AdriaanSadie/MVT_ADC_TECH/report/xm105.jpg

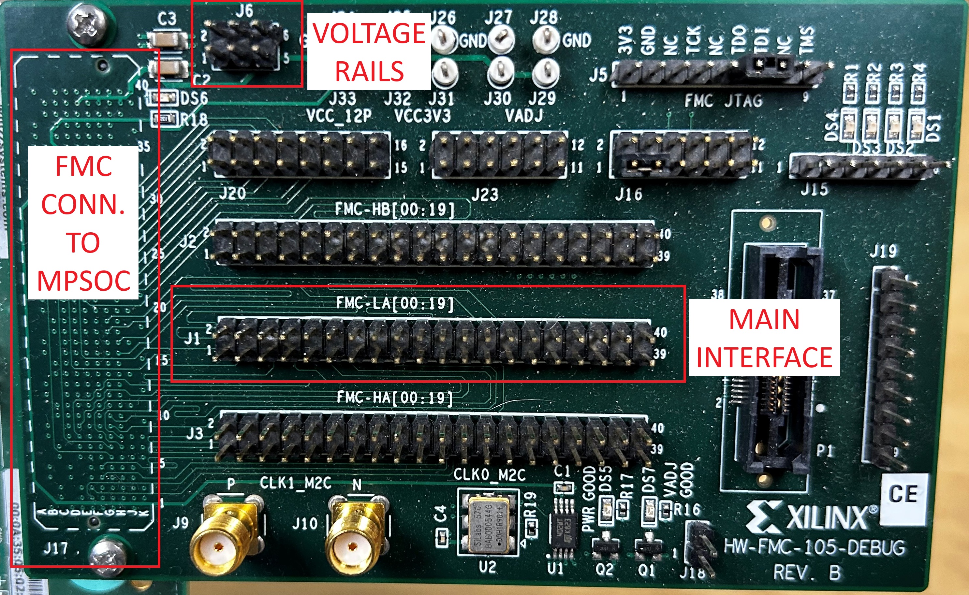
report/xm105.jpg
