AdriaanSadie/MVT_ADC_TECH/report/setup.jpg

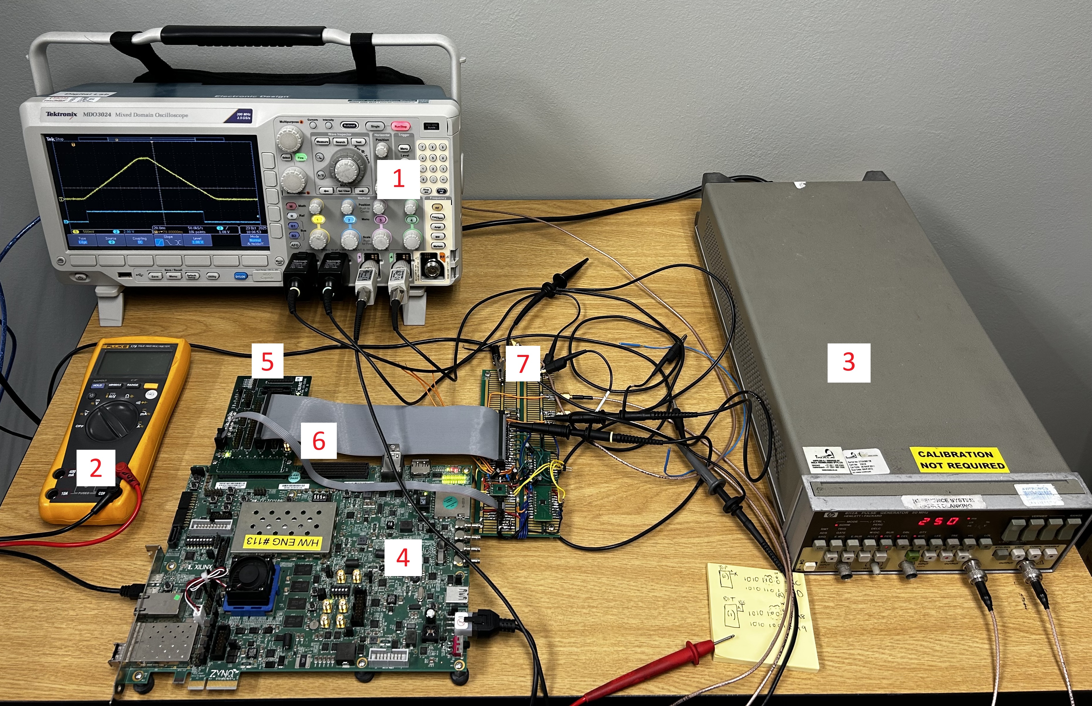
report/setup.jpg
