AdriaanSadie/MVT_ADC_TECH/README.md

# MVT_ADC_TECH
Multi-voltage thresholding ADC technology project 

> The project resides in **adc_tech** with its constraints defined in **constraints** folder.

> The project runs in Vivado 2020.2.
