AdriaanSadie/MVT_ADC_TECH/adc_tech/adc_tech.runs/impl_1/.init_design.begin.rst

<?xml version="1.0"?>
<ProcessHandle Version="1" Minor="0">
    <Process Command=".planAhead." Owner="u056903" Host="ZA-WASADIE1" Pid="96068">
    </Process>
</ProcessHandle>
