AdriaanSadie/MVT_ADC_TECH/adc_tech/adc_tech.runs/adc_tech_blk_mem_gen_0_2_synth_1/.vivado.begin.rst

<?xml version="1.0"?>
<ProcessHandle Version="1" Minor="0">
    <Process Command="vivado.bat" Owner="u056903" Host="ZA-WASADIE1" Pid="141132" HostCore="20" HostMemory="033775415296">
    </Process>
</ProcessHandle>
