AdriaanSadie/MVT_ADC_TECH/admin/Multi-voltage Thresholding on FPGA (ADC) Technology Project Update - 19 March 2025.pptx

- Sadie, Adriaan

- 2025 – MVT Signal Acquisition with FPGA

## Technology Project - 2025 Multi-voltage thresholding (mVT) Signal acquisition with FPGA

  1. Tasks completed
  2. Tasks left
  3. Budget
  4. Timeline
4. Motivation


## Technology Project: MVT with FPGA Tasks completed

Initial tasks complete Part of task 2.3 also completed

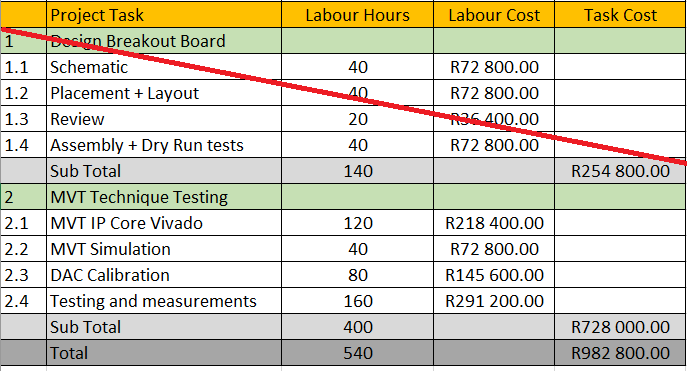
[picture p37: figure]

## Technology Project: MVT with FPGA Tasks completed

Tasks completed for phase 2: Hours used for phase 2: 69 Hours in initial budget for phase 2: 400 (~R728000) Hours initially approved for phase 2: ~194 (R350000) Total usage for phase 2 of initial budget: ~36%

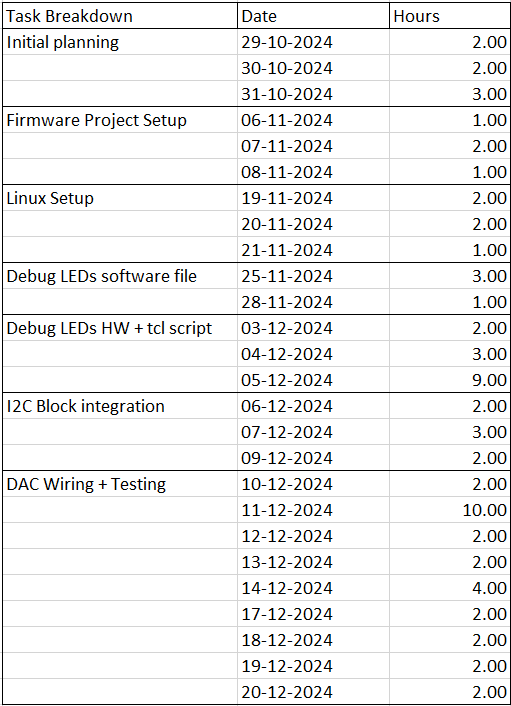
[picture p38: figure]

## Technology Project: MVT with FPGA Tasks left

| DACs need to be calibrated according to the LVDS inputs to the FPGA (will take longest time). MVT IP core needs to be connected to rest of firmware. Sample signals must be measured with MVT technique and confirmed to be correct.

## Technology Project: MVT with FPGA Budget

- Remaining hours from initial budget for phase 2:
- 400 – 69 = 331 hours for remaining tasks
- ~R629000 @ R1900/hour

## Technology Project: MVT with FPGA Timeline / Schedule

Timeline

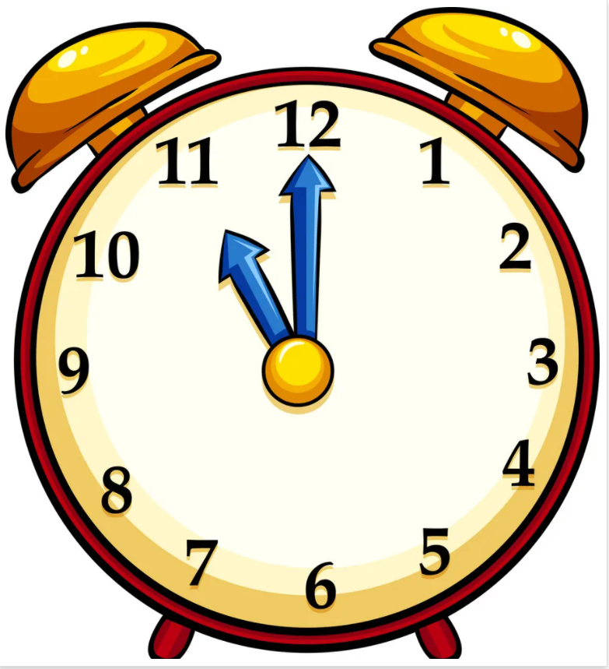
[picture p39: figure]

- Technology projects consistently hold a lower priority compared to customer assignments.
- Consequently, our intention is to utilize this as an interim task between ongoing work, with the goal of completion by 2025.
- ~50% time allocation for 2024/2025
- Resources only from HE Group

## Technology Plan: MVT with FPGA motivation

Pros:
1. Cheaper alternative for ADCs
2. Simpler interface
3. Avoid obsolescence issues with highly specialised ADCs
4. Can be implemented on cheaper MPSoC FPGA devices
  - Compared to expensive RFSoC with internal ADCs
5. Only external component is slow, cheap, and common DAC
6. Once-off calibration
7. Can be used for next iteration of MAW-400, if proven
Cons:
1. Each bit requires a differential input, therefore, 12-bit ADC uses 12 differential pairs.

## Technology Plan: MVT with FPGA References

1. Eliseev, D., et al. "An open-sorce IP-Core for Multi-Voltage Thresholding signal acquisition with FPGAs." Journal of Instrumentation 19.02 (2024): C02035.

## Slide 10


http://www.saabgroup.com
Thank You
