AdriaanSadie/MVT_ADC_TECH/report/input_signal.png

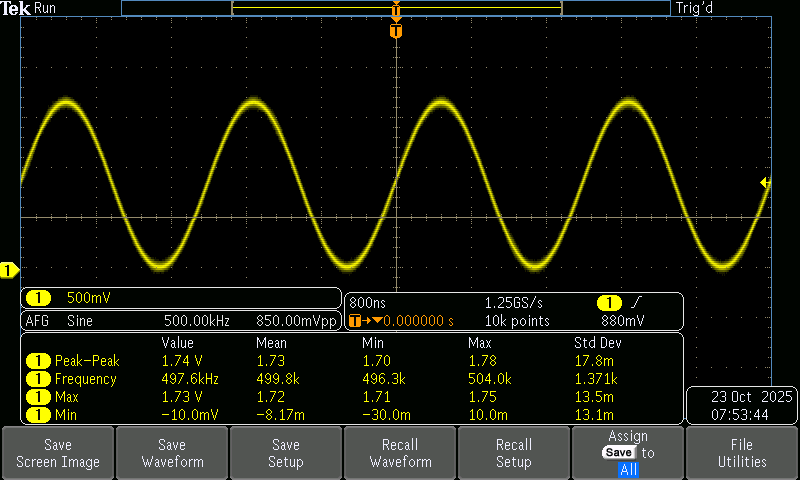
report/input_signal.png
