AdriaanSadie/MVT_ADC_TECH/ScopeScreenshots/threshold_0V5.bmp

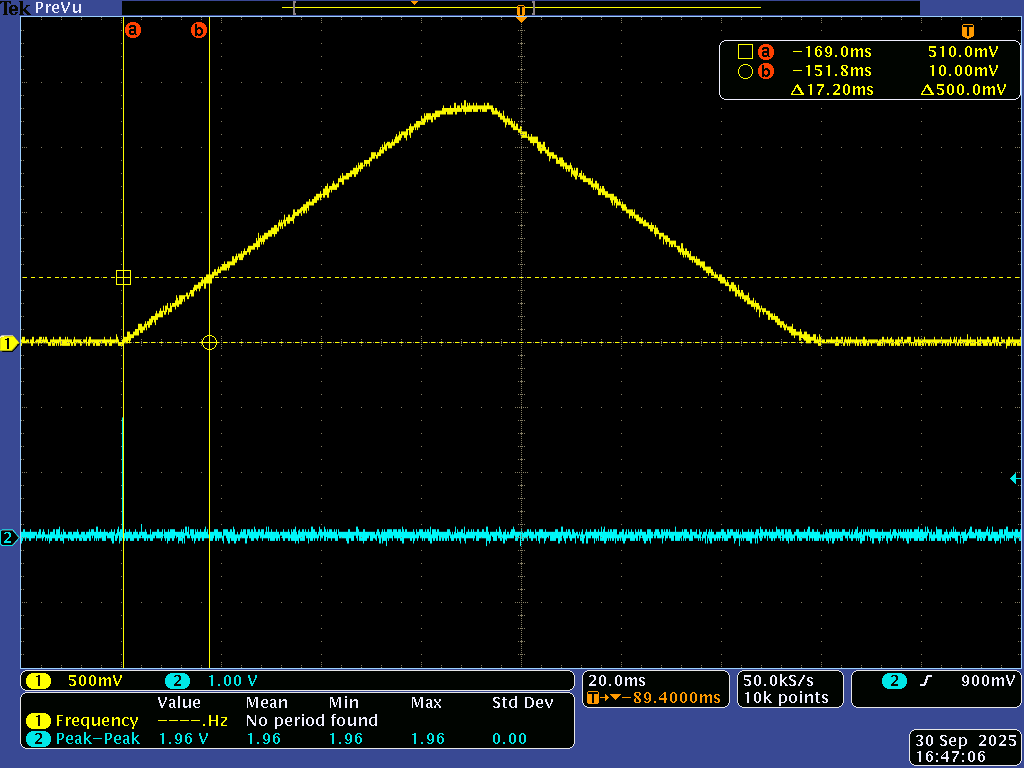
ScopeScreenshots/threshold_0V5.bmp
