AdriaanSadie/MVT_ADC_TECH/measurements/Pin_planning.xlsx

ZCU106 Development Kit |  |  | XM105 Expander Card
XCZU7EVF MPSOC | Net | FMC HPC J5 | FMC HPC J17 | Net | 40-pin header J1 | Firmware Function
F17 | FMC_HPC0_LA00_CC_P | G6 | G6 | FMC_LA00_CC_P | 1 | debug0
F16 | FMC_HPC0_LA00_CC_N | G7 | G7 | FMC_LA00_CC_N | 3 | debug1
H18 | FMC_HPC0_LA01_CC_P | D8 | D8 | FMC_LA01_CC_P | 5 | debug2
H17 | FMC_HPC0_LA01_CC_N | D9 | D9 | FMC_LA01_CC_N | 7 | counting_flag
L20 | FMC_HPC0_LA02_P | H7 | H7 | FMC_LA02_P | 9 | in_2p
K20 | FMC_HPC0_LA02_N | H8 | H8 | FMC_LA02_N | 11 | in_2n
K19 | FMC_HPC0_LA03_P | G9 | G9 | FMC_LA03_P | 13 | in_3p
K18 | FMC_HPC0_LA03_N | G10 | G10 | FMC_LA03_N | 15 | in_3n
L17 | FMC_HPC0_LA04_P | H10 | H10 | FMC_LA04_P | 17 | in_4p
L16 | FMC_HPC0_LA04_N | H11 | H11 | FMC_LA04_N | 19 | in_4n
K17 | FMC_HPC0_LA05_P | D11 | D11 | FMC_LA05_P | 21 | in_5p
J17 | FMC_HPC0_LA05_N | D12 | D12 | FMC_LA05_N | 23 | in_5n
H19 | FMC_HPC0_LA06_P | C10 | C10 | FMC_LA06_P | 25 | in_6p
G19 | FMC_HPC0_LA06_N | C11 | C11 | FMC_LA06_N | 27 | in_6n
J16 | FMC_HPC0_LA07_P | H13 | H13 | FMC_LA07_P | 29 | in_7p
J15 | FMC_HPC0_LA07_N | H14 | H14 | FMC_LA07_N | 31 | in_7n
E18 | FMC_HPC0_LA08_P | G12 | G12 | FMC_LA08_P | 33 | in_8p
E17 | FMC_HPC0_LA08_N | G13 | G13 | FMC_LA08_N | 35 | in_8n
H16 | FMC_HPC0_LA09_P | D14 | D14 | FMC_LA09_P | 37 | in_9p
G16 | FMC_HPC0_LA09_N | D15 | D15 | FMC_LA09_N | 39 | in_9n
L15 | FMC_HPC0_LA10_P | C14 | C14 | FMC_LA10_P | 2 | my_i2c_scl
K15 | FMC_HPC0_LA10_N | C15 | C15 | FMC_LA10_N | 4 | my_i2c_sda
A13 | FMC_HPC0_LA11_P | H16 | H16 | FMC_LA11_P | 6 | pl_led0
A12 | FMC_HPC0_LA11_N | H17 | H17 | FMC_LA11_N | 8 | sync_pin
G18 | FMC_HPC0_LA12_P | G15 | G15 | FMC_LA12_P | 10 | in_0p
F18 | FMC_HPC0_LA12_N | G16 | G16 | FMC_LA12_N | 12 | in_0n
G15 | FMC_HPC0_LA13_P | D17 | D17 | FMC_LA13_P | 14 | in_1p
F15 | FMC_HPC0_LA13_N | D18 | D18 | FMC_LA13_N | 16 | in_1n
C13 | FMC_HPC0_LA14_P | C18 | C18 | FMC_LA14_P | 18 | in_10p
C12 | FMC_HPC0_LA14_N | C19 | C19 | FMC_LA14_N | 20 | in_10n
D16 | FMC_HPC0_LA15_P | H19 | H19 | FMC_LA15_P | 22 | in_11p
C16 | FMC_HPC0_LA15_N | H20 | H20 | FMC_LA15_N | 24 | in_11n
D17 | FMC_HPC0_LA16_P | G18 | G18 | FMC_LA16_P | 26 | in_12p
C17 | FMC_HPC0_LA16_N | G19 | G19 | FMC_LA16_N | 28 | in_12n
F11 | FMC_HPC0_LA17_CC_P | D20 | D20 | FMC_LA17_CC_P | 30 | in_13p
E10 | FMC_HPC0_LA17_CC_N | D21 | D21 | FMC_LA17_CC_N | 32 | in_13n
D11 | FMC_HPC0_LA18_CC_P | C22 | C22 | FMC_LA18_CC_P | 34 | in_14p
D10 | FMC_HPC0_LA18_CC_N | C23 | C23 | FMC_LA18_CC_N | 36 | in_14n
D12 | FMC_HPC0_LA19_P | H22 | H22 | FMC_LA19_P | 38 | in_15p
C11 | FMC_HPC0_LA19_N | H23 | H23 | FMC_LA19_N | 40 | in_15n
C8 | FMC_HPC0_LA33_N | G37 | G37 | FMC_LA33_N | LED0 (DS1)
C9 | FMC_HPC0_LA33_P | G36 | G36 | FMC_LA33_P | LED1 (DS2)
E8 | FMC_HPC0_LA32_N | H38 | H38 | FMC_LA32_N | LED2 (DS3)
F8 | FMC_HPC0_LA32_P | H37 | H37 | FMC_LA32_P | LED3 (DS4)
