AdriaanSadie/MVT_ADC_TECH/adc_tech/adc_tech.sim/sim_1/behav/xsim/xsim.dir/i2c_tb_behav/webtalk/usage_statistics_ext_xsim.html

### XSIM Usage Report

software_version_and_target_device
beta | FALSE | build_version | 3064766
date_generated | Thu Oct 16 10:58:32 2025 | os_platform | WIN64
product_version | XSIM v2020.2 (64-bit) | project_id | a579572a191344d6b971e0746032eb8e
project_iteration | 36 | random_id | 788184fe-d1b3-4df4-bc78-6dcba078ee8f
registration_id | 788184fe-d1b3-4df4-bc78-6dcba078ee8f | route_design | FALSE
target_device | not_applicable | target_family | not_applicable
target_package | not_applicable | target_speed | not_applicable
tool_flow | xsim_vivado

user_environment
cpu_name | Intel(R) Core(TM) Ultra 7 265 | cpu_speed | 2381 MHz
os_name | Windows Server 2016 or Windows 10 | os_release | major release (build 9200)
system_ram | 33.000 GB | total_processors | 1

vivado_usage

xsim

command_line_options
command=xelab | debug=typical | dpi_used=false | file_counter=7
gendll=false | hwcosim=false | sdfmodeling=false | vhdl2008=false

usage
compiler_memory=67496_KB | compiler_time=0.48_sec | simulation_image_code=80 KB | simulation_image_data=4 KB
total_instances=6 | total_nets=0 | total_processes=21 | xilinx_hdl_libraries_used=secureip unimacro_ver unisims_ver
