AdriaanSadie/MVT_ADC_TECH/measurements/dac_calibration_measurements.xlsx

Sheet: RAW Data- RE
Bit 0 |  |  |  |  |  |  |  |  |  |  |  |  |  |  |  |  | Bit 1 |  |  | Bit 2 |  |  | Bit 3
0.1V | 0.2V | 0.3V | 0.4V | 0.5V | 0.6V | 0.7V | 0.8V | 0.9V | 1V | 1.1V | 1.2V | 1.3V | 1.4V | 1.5V | 1.6V | 1.7V | 0.5V | 1V | 1.5V | 0.5V | 1V | 1.5V | 0.5V | 1V | 1.5V
000732ce | 001259c7 | 001ce612 | 0027ed9f | 0033b138 | 003c7166 | 0049b66a | 00551528 | 005faf82 | 006915b1 | 00752688 | 008034e3 | 008a77e2 | 00931162 | 009e3a1d | 00a8d7f2 | 00b5574d
00092fc0 | 0013507e | 001e0f27 | 0028ce3b | 0033881a | 003ef4cd | 00492f97 | 005224b5 | 005d94e6 | 006a6598 | 00749be0 | 007e3b17 | 008970d4 | 0095030e | 009ff5fe | 00aa31c8 | 00b2d4d6
000866c4 | 0011f848 | 001dd510 | 0028b247 | 0032eb4f | 003d6c83 | 00487453 | 0052fd5e | 005e199a | 006907a9 | 00726061 | 007e6cd9 | 0088cae3 | 0093225e | 009df159 | 00a87a43 | 00b5d2bf
0006e10c | 00131437 | 001c6f4c | 0027fa4c | 0033ca4a | 003d7277 | 00496a4a | 0054c872 | 005e9d15 | 006a84bd | 00759021 | 007f75e8 | 0089ca5c | 0094a8b6 | 009dea0d | 00aa95f7 | 00b3fc68
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
