AdriaanSadie/MVT_ADC_TECH/measurements/dac_calibration_official.xlsx

Sheet: RAW DATA-RE
LVDS Port |  |  | LVDS Port |  |  | LVDS Port |  |  | LVDS Port | LVDS Port | LVDS Port
Bit 0 |  |  | Bit 5 |  |  | Bit 10 |  |  | Bit 0 Compensated | Bit 5 Compensated | Bit 10 Compensated
0.4V | 0.9V | 1.4V | 0.4V | 0.9V | 1.4V | 0.4V | 0.9V | 1.4V | 0.9V | 0.9V | 0.9V
002979bc | 005fd6c0 | 00957f3a | 002c4a97 | 006108a6 | 0096828c | 002c5391 | 0060977f | 0095c09b | 0062fe84 | 0062f67a | 0062d905
00296750 | 005fc3d1 | 0095444a | 002c3d9d | 0060cbfa | 00968772 | 002c622e | 0060c17a | 0095aeed | 0062de70 | 0063107d | 0062f53c
002984e2 | 005fca4d | 00955be3 | 002c4c3f | 0060efcd | 00967010 | 002c766d | 00608d95 | 00958be7 | 0062e3e8 | 0062fa47 | 0062c19a
0029820d | 005fec93 | 009544e1 | 002c435f | 0060ff05 | 00968b10 | 002c867a | 0060b05e | 0095bcc4 | 0062eaaf | 0063088b | 0062d5e6
00298782 | 005fd043 | 00957561 | 002c5963 | 006106da | 0096560a | 002c6406 | 0060af28 | 0095be96 | 00630e24 | 0062cfcf | 0062e625
00298f20 | 005fd36e | 00956869 | 002c5582 | 0060f673 | 00966e61 | 002c7002 | 006083e7 | 0095bd1e | 0062d66b | 0062f1ec | 0062d321
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
