AdriaanSadie/MVT_ADC_TECH/measurements/ADC Measurements/tek0002.csv

Model | MDO3024
Firmware Version | 1.20
Waveform Type | ANALOG
Point Format | Y
Horizontal Units | s
Horizontal Scale | 2e-07
Horizontal Delay | 0.0527
Sample Interval | 4e-10
Record Length | 10000
Gating | 0.0% to 100.0%
Probe Attenuation | 10
Vertical Units | V
Vertical Offset | 0
Vertical Scale | 0.5
Vertical Position | -1.04
Label
TIME | CH1
5.269800e-02 | 0.62
5.269800e-02 | 0.6
5.269800e-02 | 0.62
5.269800e-02 | 0.62
5.269800e-02 | 0.6
5.269800e-02 | 0.62
5.269800e-02 | 0.6
5.269800e-02 | 0.6
5.269800e-02 | 0.62
5.269800e-02 | 0.58
5.269800e-02 | 0.58
5.269800e-02 | 0.58
5.269800e-02 | 0.58
5.269801e-02 | 0.58
5.269801e-02 | 0.56
5.269801e-02 | 0.56
5.269801e-02 | 0.56
5.269801e-02 | 0.56
5.269801e-02 | 0.54
5.269801e-02 | 0.56
5.269801e-02 | 0.56
5.269801e-02 | 0.56
5.269801e-02 | 0.58
5.269801e-02 | 0.58
5.269801e-02 | 0.56
5.269801e-02 | 0.56
5.269801e-02 | 0.56
5.269801e-02 | 0.56
5.269801e-02 | 0.54
5.269801e-02 | 0.56
5.269801e-02 | 0.54
5.269801e-02 | 0.56
5.269801e-02 | 0.56
5.269801e-02 | 0.52
5.269801e-02 | 0.52
5.269801e-02 | 0.54
5.269801e-02 | 0.5
5.269801e-02 | 0.52
5.269802e-02 | 0.52
5.269802e-02 | 0.52
5.269802e-02 | 0.5
5.269802e-02 | 0.52
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
