AdriaanSadie/MVT_ADC_TECH/measurements/ADC Measurements/tek0001.csv

Model | MDO3024
Firmware Version | 1.20
Waveform Type | ANALOG
Point Format | Y
Horizontal Units | s
Horizontal Scale | 8e-07
Horizontal Delay | 0
Sample Interval | 8e-10
Record Length | 10000
Gating | 0.0% to 100.0%
Probe Attenuation | 10
Vertical Units | V
Vertical Offset | 0
Vertical Scale | 0.5
Vertical Position | -1.06
Label
TIME | CH1
-4.000000e-06 | 0.95
-3.999200e-06 | 0.91
-3.998400e-06 | 0.95
-3.997600e-06 | 0.95
-3.996800e-06 | 0.93
-3.996000e-06 | 0.95
-3.995200e-06 | 0.95
-3.994400e-06 | 0.97
-3.993600e-06 | 0.95
-3.992800e-06 | 0.95
-3.992000e-06 | 0.97
-3.991200e-06 | 0.97
-3.990400e-06 | 0.99
-3.989600e-06 | 0.99
-3.988800e-06 | 0.95
-3.988000e-06 | 0.97
-3.987200e-06 | 0.99
-3.986400e-06 | 0.97
-3.985600e-06 | 0.95
-3.984800e-06 | 0.95
-3.984000e-06 | 0.99
-3.983200e-06 | 0.97
-3.982400e-06 | 0.97
-3.981600e-06 | 0.97
-3.980800e-06 | 0.99
-3.980000e-06 | 1.01
-3.979200e-06 | 0.99
-3.978400e-06 | 0.99
-3.977600e-06 | 0.99
-3.976800e-06 | 0.99
-3.976000e-06 | 0.99
-3.975200e-06 | 0.99
-3.974400e-06 | 1.01
-3.973600e-06 | 1.03
-3.972800e-06 | 1.01
-3.972000e-06 | 1.01
-3.971200e-06 | 1.01
-3.970400e-06 | 1.03
-3.969600e-06 | 1.01
-3.968800e-06 | 1.01
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
