AdriaanSadie/MVT_ADC_TECH/measurements/ADC Measurements/waveform0.png

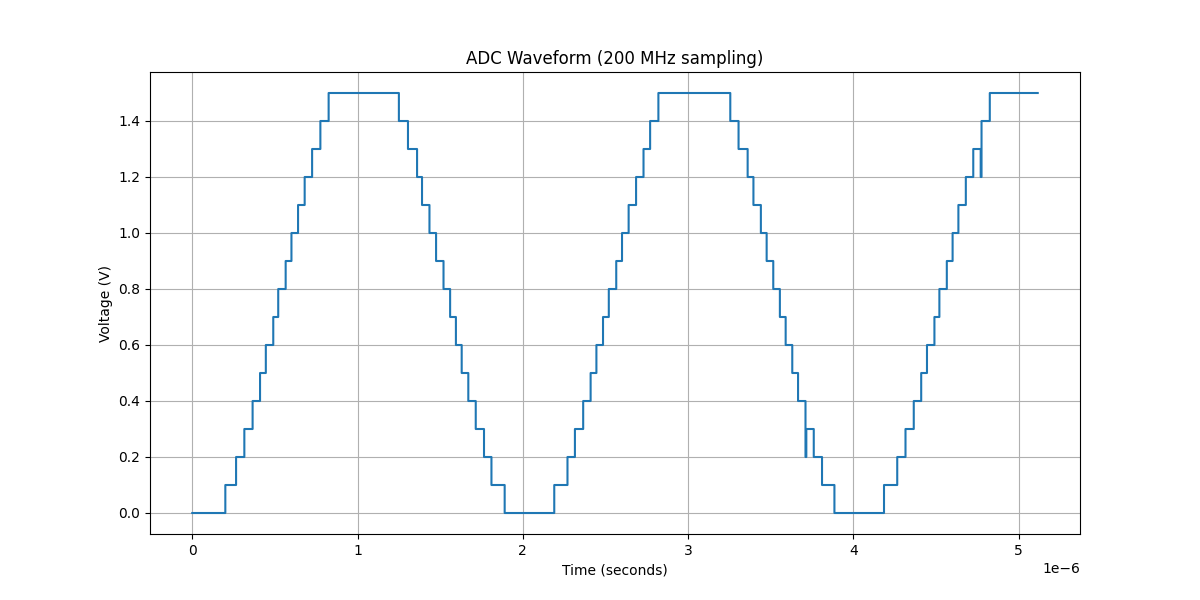
measurements/ADC Measurements/waveform0.png
