AdriaanSadie/MVT_ADC_TECH/measurements/ADC Measurements/waveform1.png

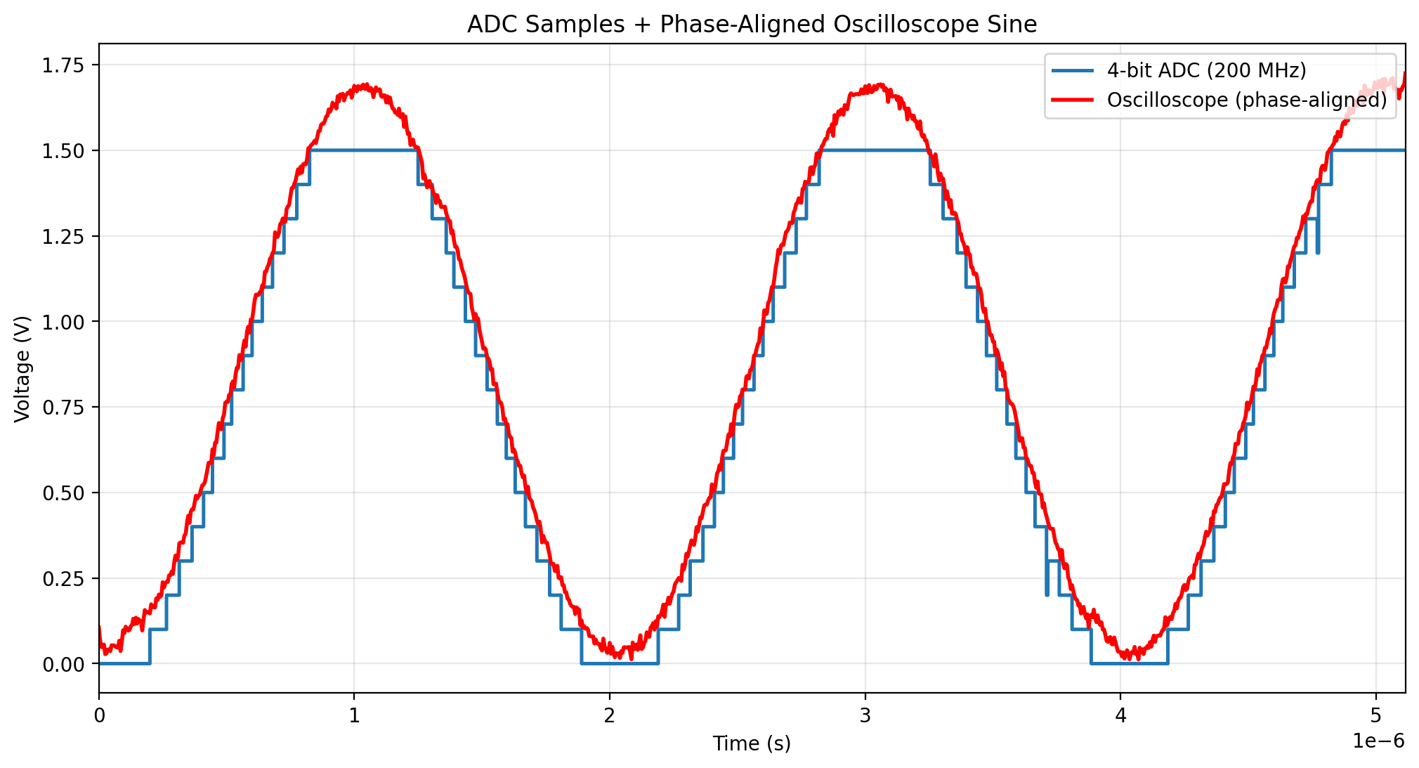
measurements/ADC Measurements/waveform1.png
