AdriaanSadie/MVT_ADC_TECH/measurements/ADC Measurements/waveform_adc.png

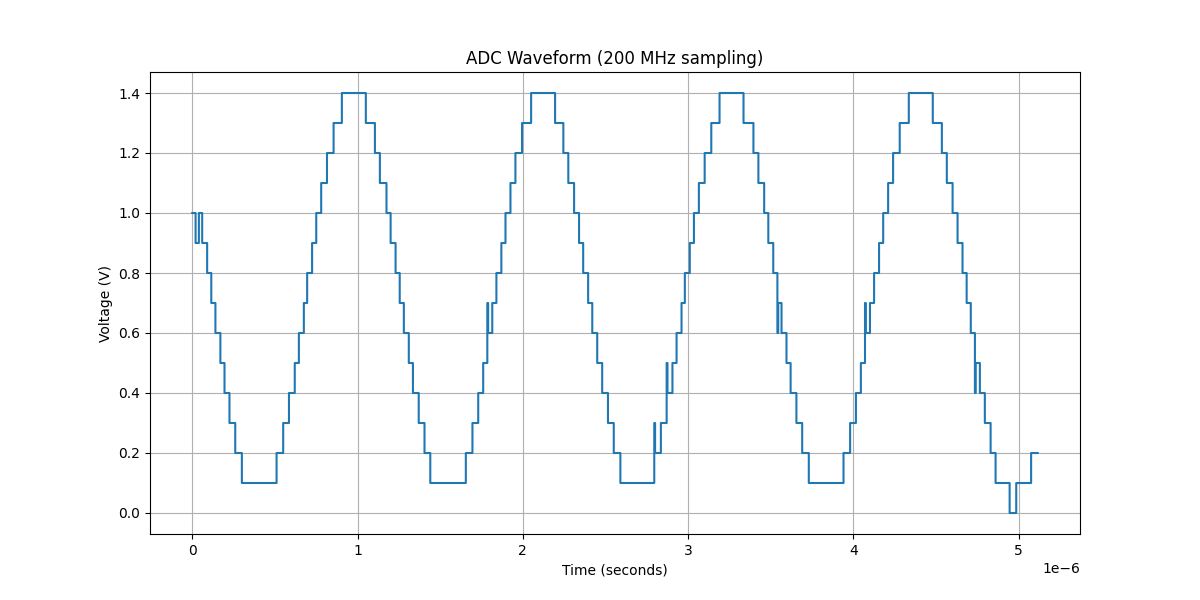
measurements/ADC Measurements/waveform_adc.png
