AdriaanSadie/MVT_ADC_TECH/ScopeScreenshots/python_script_test/Figure_1.png

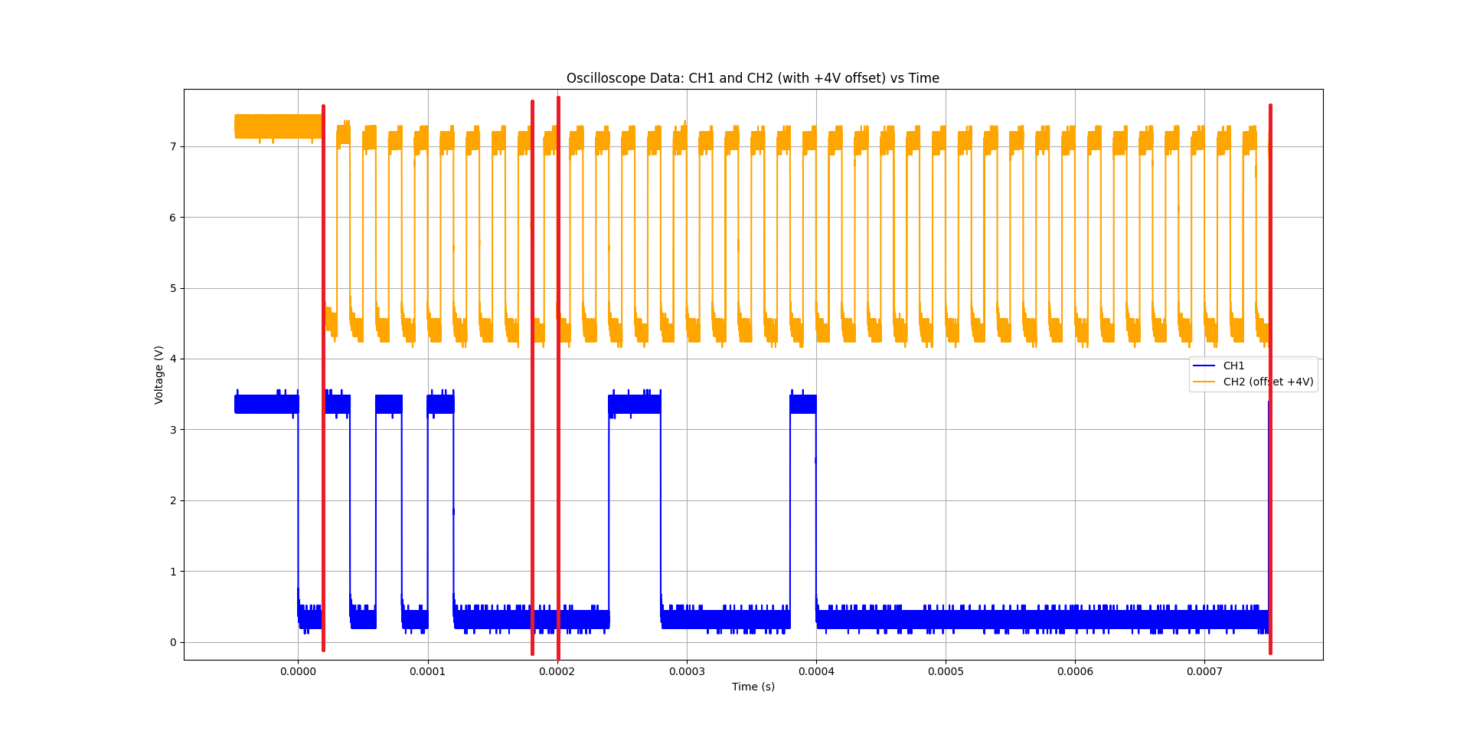
ScopeScreenshots/python_script_test/Figure_1.png
