AdriaanSadie/MVT_ADC_TECH/adc_tech/adc_tech.runs/synth_1/.Xil/adc_tech_wrapper_propImpl.xdc

set_property SRC_FILE_INFO {cfile:C:/work/Technology/Vivado/MVT_ADC_TECH/constraints/io_pins.xdc rfile:../../../../constraints/io_pins.xdc id:1} [current_design]
set_property src_info {type:XDC file:1 line:14 export:INPUT save:INPUT read:READ} [current_design]
set_property IOSTANDARD LVCMOS18 [get_ports pl_led1]
set_property src_info {type:XDC file:1 line:15 export:INPUT save:INPUT read:READ} [current_design]
set_property IOSTANDARD LVCMOS18 [get_ports pl_led2]
set_property src_info {type:XDC file:1 line:16 export:INPUT save:INPUT read:READ} [current_design]
set_property IOSTANDARD LVCMOS18 [get_ports pl_led3]
set_property src_info {type:XDC file:1 line:18 export:INPUT save:INPUT read:READ} [current_design]
set_property PACKAGE_PIN A13 [get_ports {pl_led0[0]}]
set_property src_info {type:XDC file:1 line:20 export:INPUT save:INPUT read:READ} [current_design]
set_property PACKAGE_PIN H9 [get_ports pl_clk_p]
set_property src_info {type:XDC file:1 line:24 export:INPUT save:INPUT read:READ} [current_design]
set_property PACKAGE_PIN A13 [get_ports i2c_scl]
set_property src_info {type:XDC file:1 line:25 export:INPUT save:INPUT read:READ} [current_design]
set_property PACKAGE_PIN A12 [get_ports i2c_sda]
set_property src_info {type:XDC file:1 line:26 export:INPUT save:INPUT read:READ} [current_design]
set_property IOSTANDARD LVCMOS18 [get_ports i2c_scl]
set_property src_info {type:XDC file:1 line:27 export:INPUT save:INPUT read:READ} [current_design]
set_property IOSTANDARD LVCMOS18 [get_ports i2c_sda]
set_property src_info {type:XDC file:1 line:37 export:INPUT save:INPUT read:READ} [current_design]
set_property PACKAGE_PIN K18 [get_ports pulse_in]
set_property src_info {type:XDC file:1 line:38 export:INPUT save:INPUT read:READ} [current_design]
set_property IOSTANDARD LVCMOS18 [get_ports pulse_in]
set_property src_info {type:XDC file:1 line:41 export:INPUT save:INPUT read:READ} [current_design]
set_property PACKAGE_PIN K19 [get_ports pulse_in_p]
set_property src_info {type:XDC file:1 line:42 export:INPUT save:INPUT read:READ} [current_design]
set_property IOSTANDARD LVDS [get_ports pulse_in_p]
set_property src_info {type:XDC file:1 line:43 export:INPUT save:INPUT read:READ} [current_design]
set_property IOSTANDARD LVDS [get_ports pulse_in_n]
set_property src_info {type:XDC file:1 line:44 export:INPUT save:INPUT read:READ} [current_design]
set_property DIFF_TERM_ADV TERM_NONE [get_ports pulse_in_p]
set_property src_info {type:XDC file:1 line:45 export:INPUT save:INPUT read:READ} [current_design]
set_property DIFF_TERM_ADV TERM_NONE [get_ports pulse_in_n]
set_property src_info {type:XDC file:1 line:46 export:INPUT save:INPUT read:READ} [current_design]
set_property PACKAGE_PIN A12 [get_ports sync_in]
set_property src_info {type:XDC file:1 line:52 export:INPUT save:INPUT read:READ} [current_design]
connect_debug_port u_ila_0/probe0 [get_nets [list {adc_tech_i/axi_bram_ctrl_0_BRAM_PORTA_DOUT[0]} {adc_tech_i/axi_bram_ctrl_0_BRAM_PORTA_DOUT[1]} {adc_tech_i/axi_bram_ctrl_0_BRAM_PORTA_DOUT[2]} {adc_tech_i/axi_bram_ctrl_0_BRAM_PORTA_DOUT[3]} {adc_tech_i/axi_bram_ctrl_0_BRAM_PORTA_DOUT[4]} {adc_tech_i/axi_bram_ctrl_0_BRAM_PORTA_DOUT[5]} {adc_tech_i/axi_bram_ctrl_0_BRAM_PORTA_DOUT[6]} {adc_tech_i/axi_bram_ctrl_0_BRAM_PORTA_DOUT[7]} {adc_tech_i/axi_bram_ctrl_0_BRAM_PORTA_DOUT[8]} {adc_tech_i/axi_bram_ctrl_0_BRAM_PORTA_DOUT[9]} {adc_tech_i/axi_bram_ctrl_0_BRAM_PORTA_DOUT[10]} {adc_tech_i/axi_bram_ctrl_0_BRAM_PORTA_DOUT[11]} {adc_tech_i/axi_bram_ctrl_0_BRAM_PORTA_DOUT[12]} {adc_tech_i/axi_bram_ctrl_0_BRAM_PORTA_DOUT[13]} {adc_tech_i/axi_bram_ctrl_0_BRAM_PORTA_DOUT[14]} {adc_tech_i/axi_bram_ctrl_0_BRAM_PORTA_DOUT[15]} {adc_tech_i/axi_bram_ctrl_0_BRAM_PORTA_DOUT[16]} {adc_tech_i/axi_bram_ctrl_0_BRAM_PORTA_DOUT[17]} {adc_tech_i/axi_bram_ctrl_0_BRAM_PORTA_DOUT[18]} {adc_tech_i/axi_bram_ctrl_0_BRAM_PORTA_DOUT[19]} {adc_tech_i/axi_bram_ctrl_0_BRAM_PORTA_DOUT[20]} {adc_tech_i/axi_bram_ctrl_0_BRAM_PORTA_DOUT[21]} {adc_tech_i/axi_bram_ctrl_0_BRAM_PORTA_DOUT[22]} {adc_tech_i/axi_bram_ctrl_0_BRAM_PORTA_DOUT[23]} {adc_tech_i/axi_bram_ctrl_0_BRAM_PORTA_DOUT[24]} {adc_tech_i/axi_bram_ctrl_0_BRAM_PORTA_DOUT[25]} {adc_tech_i/axi_bram_ctrl_0_BRAM_PORTA_DOUT[26]} {adc_tech_i/axi_bram_ctrl_0_BRAM_PORTA_DOUT[27]} {adc_tech_i/axi_bram_ctrl_0_BRAM_PORTA_DOUT[28]} {adc_tech_i/axi_bram_ctrl_0_BRAM_PORTA_DOUT[29]} {adc_tech_i/axi_bram_ctrl_0_BRAM_PORTA_DOUT[30]} {adc_tech_i/axi_bram_ctrl_0_BRAM_PORTA_DOUT[31]}]]
set_property src_info {type:XDC file:1 line:53 export:INPUT save:INPUT read:READ} [current_design]
connect_debug_port u_ila_0/probe1 [get_nets [list {adc_tech_i/bram_writer_0_addra[0]} {adc_tech_i/bram_writer_0_addra[1]} {adc_tech_i/bram_writer_0_addra[2]} {adc_tech_i/bram_writer_0_addra[3]} {adc_tech_i/bram_writer_0_addra[4]} {adc_tech_i/bram_writer_0_addra[5]} {adc_tech_i/bram_writer_0_addra[6]} {adc_tech_i/bram_writer_0_addra[7]} {adc_tech_i/bram_writer_0_addra[8]} {adc_tech_i/bram_writer_0_addra[9]} {adc_tech_i/bram_writer_0_addra[10]} {adc_tech_i/bram_writer_0_addra[11]} {adc_tech_i/bram_writer_0_addra[12]}]]
set_property src_info {type:XDC file:1 line:54 export:INPUT save:INPUT read:READ} [current_design]
connect_debug_port u_ila_0/probe2 [get_nets [list {adc_tech_i/axi_bram_ctrl_0_BRAM_PORTA_ADDR[0]} {adc_tech_i/axi_bram_ctrl_0_BRAM_PORTA_ADDR[1]} {adc_tech_i/axi_bram_ctrl_0_BRAM_PORTA_ADDR[2]} {adc_tech_i/axi_bram_ctrl_0_BRAM_PORTA_ADDR[3]} {adc_tech_i/axi_bram_ctrl_0_BRAM_PORTA_ADDR[4]} {adc_tech_i/axi_bram_ctrl_0_BRAM_PORTA_ADDR[5]} {adc_tech_i/axi_bram_ctrl_0_BRAM_PORTA_ADDR[6]} {adc_tech_i/axi_bram_ctrl_0_BRAM_PORTA_ADDR[7]} {adc_tech_i/axi_bram_ctrl_0_BRAM_PORTA_ADDR[8]} {adc_tech_i/axi_bram_ctrl_0_BRAM_PORTA_ADDR[9]} {adc_tech_i/axi_bram_ctrl_0_BRAM_PORTA_ADDR[10]} {adc_tech_i/axi_bram_ctrl_0_BRAM_PORTA_ADDR[11]} {adc_tech_i/axi_bram_ctrl_0_BRAM_PORTA_ADDR[12]}]]
set_property src_info {type:XDC file:1 line:55 export:INPUT save:INPUT read:READ} [current_design]
connect_debug_port u_ila_0/probe3 [get_nets [list {adc_tech_i/bram_writer_0_dia[0]} {adc_tech_i/bram_writer_0_dia[1]} {adc_tech_i/bram_writer_0_dia[2]} {adc_tech_i/bram_writer_0_dia[3]} {adc_tech_i/bram_writer_0_dia[4]} {adc_tech_i/bram_writer_0_dia[5]} {adc_tech_i/bram_writer_0_dia[6]} {adc_tech_i/bram_writer_0_dia[7]} {adc_tech_i/bram_writer_0_dia[8]} {adc_tech_i/bram_writer_0_dia[9]} {adc_tech_i/bram_writer_0_dia[10]} {adc_tech_i/bram_writer_0_dia[11]} {adc_tech_i/bram_writer_0_dia[12]} {adc_tech_i/bram_writer_0_dia[13]} {adc_tech_i/bram_writer_0_dia[14]} {adc_tech_i/bram_writer_0_dia[15]} {adc_tech_i/bram_writer_0_dia[16]} {adc_tech_i/bram_writer_0_dia[17]} {adc_tech_i/bram_writer_0_dia[18]} {adc_tech_i/bram_writer_0_dia[19]} {adc_tech_i/bram_writer_0_dia[20]} {adc_tech_i/bram_writer_0_dia[21]} {adc_tech_i/bram_writer_0_dia[22]} {adc_tech_i/bram_writer_0_dia[23]} {adc_tech_i/bram_writer_0_dia[24]} {adc_tech_i/bram_writer_0_dia[25]} {adc_tech_i/bram_writer_0_dia[26]} {adc_tech_i/bram_writer_0_dia[27]} {adc_tech_i/bram_writer_0_dia[28]} {adc_tech_i/bram_writer_0_dia[29]} {adc_tech_i/bram_writer_0_dia[30]} {adc_tech_i/bram_writer_0_dia[31]}]]
set_property src_info {type:XDC file:1 line:56 export:INPUT save:INPUT read:READ} [current_design]
connect_debug_port u_ila_0/probe4 [get_nets [list adc_tech_i/axi_bram_ctrl_0_BRAM_PORTA_CLK]]
set_property src_info {type:XDC file:1 line:57 export:INPUT save:INPUT read:READ} [current_design]
connect_debug_port u_ila_0/probe5 [get_nets [list adc_tech_i/bram_writer_0_wea]]
set_property src_info {type:XDC file:1 line:58 export:INPUT save:INPUT read:READ} [current_design]
connect_debug_port u_ila_0/probe6 [get_nets [list adc_tech_i/xlslice_4_Dout]]
set_property src_info {type:XDC file:1 line:64 export:INPUT save:INPUT read:READ} [current_design]
set_property PACKAGE_PIN L20 [get_ports pulse_in_p2]
set_property src_info {type:XDC file:1 line:67 export:INPUT save:INPUT read:READ} [current_design]
set_property PACKAGE_PIN K19 [get_ports pulse_in_p3]
set_property src_info {type:XDC file:1 line:72 export:INPUT save:INPUT read:READ} [current_design]
set_property PACKAGE_PIN L15 [get_ports my_i2c_scl]
set_property src_info {type:XDC file:1 line:73 export:INPUT save:INPUT read:READ} [current_design]
set_property PACKAGE_PIN K15 [get_ports my_i2c_sda]
set_property src_info {type:XDC file:1 line:74 export:INPUT save:INPUT read:READ} [current_design]
set_property PACKAGE_PIN F17 [get_ports {debug0[0]}]
set_property src_info {type:XDC file:1 line:75 export:INPUT save:INPUT read:READ} [current_design]
set_property PACKAGE_PIN F16 [get_ports {debug1[0]}]
set_property src_info {type:XDC file:1 line:76 export:INPUT save:INPUT read:READ} [current_design]
set_property PACKAGE_PIN H18 [get_ports {debug2[0]}]
set_property src_info {type:XDC file:1 line:77 export:INPUT save:INPUT read:READ} [current_design]
set_property PACKAGE_PIN L17 [get_ports pulse_in_p4]
set_property src_info {type:XDC file:1 line:78 export:INPUT save:INPUT read:READ} [current_design]
set_property PACKAGE_PIN K17 [get_ports pulse_in_p5]
set_property src_info {type:XDC file:1 line:79 export:INPUT save:INPUT read:READ} [current_design]
set_property PACKAGE_PIN H19 [get_ports pulse_in_p6]
set_property src_info {type:XDC file:1 line:84 export:INPUT save:INPUT read:READ} [current_design]
set_property PACKAGE_PIN J16 [get_ports pulse_in_p7]
set_property src_info {type:XDC file:1 line:89 export:INPUT save:INPUT read:READ} [current_design]
set_property PACKAGE_PIN E18 [get_ports pulse_in_p8]
set_property src_info {type:XDC file:1 line:92 export:INPUT save:INPUT read:READ} [current_design]
set_property PACKAGE_PIN H16 [get_ports pulse_in_p9]
set_property src_info {type:XDC file:1 line:95 export:INPUT save:INPUT read:READ} [current_design]
set_property PACKAGE_PIN C13 [get_ports pulse_in_p10]
set_property src_info {type:XDC file:1 line:98 export:INPUT save:INPUT read:READ} [current_design]
set_property PACKAGE_PIN D16 [get_ports pulse_in_p11]
set_property src_info {type:XDC file:1 line:101 export:INPUT save:INPUT read:READ} [current_design]
set_property PACKAGE_PIN D17 [get_ports pulse_in_p12]
set_property src_info {type:XDC file:1 line:104 export:INPUT save:INPUT read:READ} [current_design]
set_property PACKAGE_PIN F11 [get_ports pulse_in_p13]
set_property src_info {type:XDC file:1 line:107 export:INPUT save:INPUT read:READ} [current_design]
set_property PACKAGE_PIN D11 [get_ports pulse_in_p14]
set_property src_info {type:XDC file:1 line:110 export:INPUT save:INPUT read:READ} [current_design]
set_property PACKAGE_PIN D12 [get_ports pulse_in_p15]
set_property src_info {type:XDC file:1 line:113 export:INPUT save:INPUT read:READ} [current_design]
set_property PACKAGE_PIN H17 [get_ports counting_flag]
set_property src_info {type:XDC file:1 line:114 export:INPUT save:INPUT read:READ} [current_design]
set_property PACKAGE_PIN G15 [get_ports pulse_in_p1]
set_property src_info {type:XDC file:1 line:115 export:INPUT save:INPUT read:READ} [current_design]
set_property PACKAGE_PIN G18 [get_ports pulse_in_p0]
set_property src_info {type:XDC file:1 line:118 export:INPUT save:INPUT read:READ} [current_design]
connect_debug_port u_ila_0/probe0 [get_nets [list {adc_tech_i/internal_axi_gpio2[0]} {adc_tech_i/internal_axi_gpio2[1]} {adc_tech_i/internal_axi_gpio2[2]} {adc_tech_i/internal_axi_gpio2[3]} {adc_tech_i/internal_axi_gpio2[4]} {adc_tech_i/internal_axi_gpio2[5]} {adc_tech_i/internal_axi_gpio2[6]} {adc_tech_i/internal_axi_gpio2[7]} {adc_tech_i/internal_axi_gpio2[8]} {adc_tech_i/internal_axi_gpio2[9]} {adc_tech_i/internal_axi_gpio2[10]} {adc_tech_i/internal_axi_gpio2[11]} {adc_tech_i/internal_axi_gpio2[12]} {adc_tech_i/internal_axi_gpio2[13]} {adc_tech_i/internal_axi_gpio2[14]} {adc_tech_i/internal_axi_gpio2[15]} {adc_tech_i/internal_axi_gpio2[16]} {adc_tech_i/internal_axi_gpio2[17]} {adc_tech_i/internal_axi_gpio2[18]} {adc_tech_i/internal_axi_gpio2[19]} {adc_tech_i/internal_axi_gpio2[20]} {adc_tech_i/internal_axi_gpio2[21]} {adc_tech_i/internal_axi_gpio2[22]} {adc_tech_i/internal_axi_gpio2[23]} {adc_tech_i/internal_axi_gpio2[24]} {adc_tech_i/internal_axi_gpio2[25]} {adc_tech_i/internal_axi_gpio2[26]} {adc_tech_i/internal_axi_gpio2[27]} {adc_tech_i/internal_axi_gpio2[28]} {adc_tech_i/internal_axi_gpio2[29]} {adc_tech_i/internal_axi_gpio2[30]} {adc_tech_i/internal_axi_gpio2[31]}]]
set_property src_info {type:XDC file:1 line:119 export:INPUT save:INPUT read:READ} [current_design]
connect_debug_port u_ila_0/probe1 [get_nets [list {adc_tech_i/internal_axi_gpio1[0]} {adc_tech_i/internal_axi_gpio1[1]} {adc_tech_i/internal_axi_gpio1[2]} {adc_tech_i/internal_axi_gpio1[3]} {adc_tech_i/internal_axi_gpio1[4]} {adc_tech_i/internal_axi_gpio1[5]} {adc_tech_i/internal_axi_gpio1[6]} {adc_tech_i/internal_axi_gpio1[7]} {adc_tech_i/internal_axi_gpio1[8]} {adc_tech_i/internal_axi_gpio1[9]} {adc_tech_i/internal_axi_gpio1[10]} {adc_tech_i/internal_axi_gpio1[11]} {adc_tech_i/internal_axi_gpio1[12]} {adc_tech_i/internal_axi_gpio1[13]} {adc_tech_i/internal_axi_gpio1[14]} {adc_tech_i/internal_axi_gpio1[15]} {adc_tech_i/internal_axi_gpio1[16]} {adc_tech_i/internal_axi_gpio1[17]} {adc_tech_i/internal_axi_gpio1[18]} {adc_tech_i/internal_axi_gpio1[19]} {adc_tech_i/internal_axi_gpio1[20]} {adc_tech_i/internal_axi_gpio1[21]} {adc_tech_i/internal_axi_gpio1[22]} {adc_tech_i/internal_axi_gpio1[23]} {adc_tech_i/internal_axi_gpio1[24]} {adc_tech_i/internal_axi_gpio1[25]} {adc_tech_i/internal_axi_gpio1[26]} {adc_tech_i/internal_axi_gpio1[27]} {adc_tech_i/internal_axi_gpio1[28]} {adc_tech_i/internal_axi_gpio1[29]} {adc_tech_i/internal_axi_gpio1[30]} {adc_tech_i/internal_axi_gpio1[31]}]]
set_property src_info {type:XDC file:1 line:121 export:INPUT save:INPUT read:READ} [current_design]
set_property C_CLK_INPUT_FREQ_HZ 300000000 [get_debug_cores dbg_hub]
set_property src_info {type:XDC file:1 line:122 export:INPUT save:INPUT read:READ} [current_design]
set_property C_ENABLE_CLK_DIVIDER false [get_debug_cores dbg_hub]
set_property src_info {type:XDC file:1 line:123 export:INPUT save:INPUT read:READ} [current_design]
set_property C_USER_SCAN_CHAIN 1 [get_debug_cores dbg_hub]
set_property src_info {type:XDC file:1 line:124 export:INPUT save:INPUT read:READ} [current_design]
connect_debug_port dbg_hub/clk [get_nets clk]
