AdriaanSadie/MVT_ADC_TECH/adc_tech/adc_tech.cache/ip/2020.2/218f51cbd73a38f3/adc_tech_axi_bram_ctrl_0_2_stub.v

// Copyright 1986-2020 Xilinx, Inc. All Rights Reserved.
// --------------------------------------------------------------------------------
// Tool Version: Vivado v.2020.2 (win64) Build 3064766 Wed Nov 18 09:12:45 MST 2020
// Date        : Mon Oct 27 06:54:17 2025
// Host        : ZA-WASADIE1 running 64-bit major release  (build 9200)
// Command     : write_verilog -force -mode synth_stub -rename_top decalper_eb_ot_sdeen_pot_pi_dehcac_xnilix -prefix
//               decalper_eb_ot_sdeen_pot_pi_dehcac_xnilix_ adc_tech_axi_bram_ctrl_0_2_stub.v
// Design      : adc_tech_axi_bram_ctrl_0_2
// Purpose     : Stub declaration of top-level module interface
// Device      : xczu7ev-ffvc1156-2-e
// --------------------------------------------------------------------------------

// This empty module with port declaration file causes synthesis tools to infer a black box for IP.
// The synthesis directives are for Synopsys Synplify support to prevent IO buffer insertion.
// Please paste the declaration into a Verilog source file or add the file as an additional source.
(* x_core_info = "axi_bram_ctrl,Vivado 2020.2" *)
module decalper_eb_ot_sdeen_pot_pi_dehcac_xnilix(s_axi_aclk, s_axi_aresetn, s_axi_awaddr, 
  s_axi_awlen, s_axi_awsize, s_axi_awburst, s_axi_awlock, s_axi_awcache, s_axi_awprot, 
  s_axi_awvalid, s_axi_awready, s_axi_wdata, s_axi_wstrb, s_axi_wlast, s_axi_wvalid, 
  s_axi_wready, s_axi_bresp, s_axi_bvalid, s_axi_bready, s_axi_araddr, s_axi_arlen, 
  s_axi_arsize, s_axi_arburst, s_axi_arlock, s_axi_arcache, s_axi_arprot, s_axi_arvalid, 
  s_axi_arready, s_axi_rdata, s_axi_rresp, s_axi_rlast, s_axi_rvalid, s_axi_rready, bram_rst_a, 
  bram_clk_a, bram_en_a, bram_we_a, bram_addr_a, bram_wrdata_a, bram_rddata_a)
/* synthesis syn_black_box black_box_pad_pin="s_axi_aclk,s_axi_aresetn,s_axi_awaddr[17:0],s_axi_awlen[7:0],s_axi_awsize[2:0],s_axi_awburst[1:0],s_axi_awlock,s_axi_awcache[3:0],s_axi_awprot[2:0],s_axi_awvalid,s_axi_awready,s_axi_wdata[31:0],s_axi_wstrb[3:0],s_axi_wlast,s_axi_wvalid,s_axi_wready,s_axi_bresp[1:0],s_axi_bvalid,s_axi_bready,s_axi_araddr[17:0],s_axi_arlen[7:0],s_axi_arsize[2:0],s_axi_arburst[1:0],s_axi_arlock,s_axi_arcache[3:0],s_axi_arprot[2:0],s_axi_arvalid,s_axi_arready,s_axi_rdata[31:0],s_axi_rresp[1:0],s_axi_rlast,s_axi_rvalid,s_axi_rready,bram_rst_a,bram_clk_a,bram_en_a,bram_we_a[3:0],bram_addr_a[17:0],bram_wrdata_a[31:0],bram_rddata_a[31:0]" */;
  input s_axi_aclk;
  input s_axi_aresetn;
  input [17:0]s_axi_awaddr;
  input [7:0]s_axi_awlen;
  input [2:0]s_axi_awsize;
  input [1:0]s_axi_awburst;
  input s_axi_awlock;
  input [3:0]s_axi_awcache;
  input [2:0]s_axi_awprot;
  input s_axi_awvalid;
  output s_axi_awready;
  input [31:0]s_axi_wdata;
  input [3:0]s_axi_wstrb;
  input s_axi_wlast;
  input s_axi_wvalid;
  output s_axi_wready;
  output [1:0]s_axi_bresp;
  output s_axi_bvalid;
  input s_axi_bready;
  input [17:0]s_axi_araddr;
  input [7:0]s_axi_arlen;
  input [2:0]s_axi_arsize;
  input [1:0]s_axi_arburst;
  input s_axi_arlock;
  input [3:0]s_axi_arcache;
  input [2:0]s_axi_arprot;
  input s_axi_arvalid;
  output s_axi_arready;
  output [31:0]s_axi_rdata;
  output [1:0]s_axi_rresp;
  output s_axi_rlast;
  output s_axi_rvalid;
  input s_axi_rready;
  output bram_rst_a;
  output bram_clk_a;
  output bram_en_a;
  output [3:0]bram_we_a;
  output [17:0]bram_addr_a;
  output [31:0]bram_wrdata_a;
  input [31:0]bram_rddata_a;
endmodule
