AdriaanSadie/MVT_ADC_TECH/adc_tech/adc_tech.runs/adc_tech_jtag_axi_0_0_synth_1/.Xil/adc_tech_jtag_axi_0_0_propImpl.xdc

set_property SRC_FILE_INFO {cfile:C:/Xilinx/Vivado/2020.2/data/ip/xpm/xpm_cdc/tcl/xpm_cdc_gray.tcl rfile:../../../../../../../../Xilinx/Vivado/2020.2/data/ip/xpm/xpm_cdc/tcl/xpm_cdc_gray.tcl id:1 order:LATE scoped_inst:U0/jtag_axi_engine_u/rx_fifo_i/inst_fifo_gen/gconvfifo.rf/grf.rf/gntv_or_sync_fifo.gcx.clkx/rd_pntr_cdc_inst unmanaged:yes} [current_design]
set_property SRC_FILE_INFO {cfile:C:/Xilinx/Vivado/2020.2/data/ip/xpm/xpm_cdc/tcl/xpm_cdc_gray.tcl rfile:../../../../../../../../Xilinx/Vivado/2020.2/data/ip/xpm/xpm_cdc/tcl/xpm_cdc_gray.tcl id:2 order:LATE scoped_inst:U0/jtag_axi_engine_u/rx_fifo_i/inst_fifo_gen/gconvfifo.rf/grf.rf/gntv_or_sync_fifo.gcx.clkx/wr_pntr_cdc_inst unmanaged:yes} [current_design]
set_property SRC_FILE_INFO {cfile:C:/Xilinx/Vivado/2020.2/data/ip/xpm/xpm_cdc/tcl/xpm_cdc_gray.tcl rfile:../../../../../../../../Xilinx/Vivado/2020.2/data/ip/xpm/xpm_cdc/tcl/xpm_cdc_gray.tcl id:3 order:LATE scoped_inst:U0/jtag_axi_engine_u/tx_fifo_i/inst_fifo_gen/gconvfifo.rf/grf.rf/gntv_or_sync_fifo.gcx.clkx/rd_pntr_cdc_inst unmanaged:yes} [current_design]
set_property SRC_FILE_INFO {cfile:C:/Xilinx/Vivado/2020.2/data/ip/xpm/xpm_cdc/tcl/xpm_cdc_gray.tcl rfile:../../../../../../../../Xilinx/Vivado/2020.2/data/ip/xpm/xpm_cdc/tcl/xpm_cdc_gray.tcl id:4 order:LATE scoped_inst:U0/jtag_axi_engine_u/tx_fifo_i/inst_fifo_gen/gconvfifo.rf/grf.rf/gntv_or_sync_fifo.gcx.clkx/wr_pntr_cdc_inst unmanaged:yes} [current_design]
set_property SRC_FILE_INFO {cfile:C:/Xilinx/Vivado/2020.2/data/ip/xpm/xpm_cdc/tcl/xpm_cdc_gray.tcl rfile:../../../../../../../../Xilinx/Vivado/2020.2/data/ip/xpm/xpm_cdc/tcl/xpm_cdc_gray.tcl id:5 order:LATE scoped_inst:U0/jtag_axi_engine_u/rd_cmd_fifo_i/inst_fifo_gen/gconvfifo.rf/grf.rf/gntv_or_sync_fifo.gcx.clkx/rd_pntr_cdc_inst unmanaged:yes} [current_design]
set_property SRC_FILE_INFO {cfile:C:/Xilinx/Vivado/2020.2/data/ip/xpm/xpm_cdc/tcl/xpm_cdc_gray.tcl rfile:../../../../../../../../Xilinx/Vivado/2020.2/data/ip/xpm/xpm_cdc/tcl/xpm_cdc_gray.tcl id:6 order:LATE scoped_inst:U0/jtag_axi_engine_u/rd_cmd_fifo_i/inst_fifo_gen/gconvfifo.rf/grf.rf/gntv_or_sync_fifo.gcx.clkx/wr_pntr_cdc_inst unmanaged:yes} [current_design]
set_property SRC_FILE_INFO {cfile:C:/Xilinx/Vivado/2020.2/data/ip/xpm/xpm_cdc/tcl/xpm_cdc_gray.tcl rfile:../../../../../../../../Xilinx/Vivado/2020.2/data/ip/xpm/xpm_cdc/tcl/xpm_cdc_gray.tcl id:7 order:LATE scoped_inst:U0/jtag_axi_engine_u/wr_cmd_fifo_i/inst_fifo_gen/gconvfifo.rf/grf.rf/gntv_or_sync_fifo.gcx.clkx/rd_pntr_cdc_inst unmanaged:yes} [current_design]
set_property SRC_FILE_INFO {cfile:C:/Xilinx/Vivado/2020.2/data/ip/xpm/xpm_cdc/tcl/xpm_cdc_gray.tcl rfile:../../../../../../../../Xilinx/Vivado/2020.2/data/ip/xpm/xpm_cdc/tcl/xpm_cdc_gray.tcl id:8 order:LATE scoped_inst:U0/jtag_axi_engine_u/wr_cmd_fifo_i/inst_fifo_gen/gconvfifo.rf/grf.rf/gntv_or_sync_fifo.gcx.clkx/wr_pntr_cdc_inst unmanaged:yes} [current_design]
current_instance U0/jtag_axi_engine_u/rx_fifo_i/inst_fifo_gen/gconvfifo.rf/grf.rf/gntv_or_sync_fifo.gcx.clkx/rd_pntr_cdc_inst
set_property src_info {type:SCOPED_XDC file:1 line:23 export:INPUT save:NONE read:READ} [current_design]
create_waiver -internal -scoped -type CDC -id {CDC-6} -user "xpm_cdc" -tags "1009444" -desc "The CDC-6 warning is waived as it is safe in the context of XPM_CDC_GRAY." -from [get_pins -quiet {src_gray_ff_reg*/C}] -to [get_pins -quiet {dest_graysync_ff_reg*/D}]
current_instance
current_instance U0/jtag_axi_engine_u/rx_fifo_i/inst_fifo_gen/gconvfifo.rf/grf.rf/gntv_or_sync_fifo.gcx.clkx/wr_pntr_cdc_inst
set_property src_info {type:SCOPED_XDC file:2 line:23 export:INPUT save:NONE read:READ} [current_design]
create_waiver -internal -scoped -type CDC -id {CDC-6} -user "xpm_cdc" -tags "1009444" -desc "The CDC-6 warning is waived as it is safe in the context of XPM_CDC_GRAY." -from [get_pins -quiet {src_gray_ff_reg*/C}] -to [get_pins -quiet {dest_graysync_ff_reg*/D}]
current_instance
current_instance U0/jtag_axi_engine_u/tx_fifo_i/inst_fifo_gen/gconvfifo.rf/grf.rf/gntv_or_sync_fifo.gcx.clkx/rd_pntr_cdc_inst
set_property src_info {type:SCOPED_XDC file:3 line:23 export:INPUT save:NONE read:READ} [current_design]
create_waiver -internal -scoped -type CDC -id {CDC-6} -user "xpm_cdc" -tags "1009444" -desc "The CDC-6 warning is waived as it is safe in the context of XPM_CDC_GRAY." -from [get_pins -quiet {src_gray_ff_reg*/C}] -to [get_pins -quiet {dest_graysync_ff_reg*/D}]
current_instance
current_instance U0/jtag_axi_engine_u/tx_fifo_i/inst_fifo_gen/gconvfifo.rf/grf.rf/gntv_or_sync_fifo.gcx.clkx/wr_pntr_cdc_inst
set_property src_info {type:SCOPED_XDC file:4 line:23 export:INPUT save:NONE read:READ} [current_design]
create_waiver -internal -scoped -type CDC -id {CDC-6} -user "xpm_cdc" -tags "1009444" -desc "The CDC-6 warning is waived as it is safe in the context of XPM_CDC_GRAY." -from [get_pins -quiet {src_gray_ff_reg*/C}] -to [get_pins -quiet {dest_graysync_ff_reg*/D}]
current_instance
current_instance U0/jtag_axi_engine_u/rd_cmd_fifo_i/inst_fifo_gen/gconvfifo.rf/grf.rf/gntv_or_sync_fifo.gcx.clkx/rd_pntr_cdc_inst
set_property src_info {type:SCOPED_XDC file:5 line:23 export:INPUT save:NONE read:READ} [current_design]
create_waiver -internal -scoped -type CDC -id {CDC-6} -user "xpm_cdc" -tags "1009444" -desc "The CDC-6 warning is waived as it is safe in the context of XPM_CDC_GRAY." -from [get_pins -quiet {src_gray_ff_reg*/C}] -to [get_pins -quiet {dest_graysync_ff_reg*/D}]
current_instance
current_instance U0/jtag_axi_engine_u/rd_cmd_fifo_i/inst_fifo_gen/gconvfifo.rf/grf.rf/gntv_or_sync_fifo.gcx.clkx/wr_pntr_cdc_inst
set_property src_info {type:SCOPED_XDC file:6 line:23 export:INPUT save:NONE read:READ} [current_design]
create_waiver -internal -scoped -type CDC -id {CDC-6} -user "xpm_cdc" -tags "1009444" -desc "The CDC-6 warning is waived as it is safe in the context of XPM_CDC_GRAY." -from [get_pins -quiet {src_gray_ff_reg*/C}] -to [get_pins -quiet {dest_graysync_ff_reg*/D}]
current_instance
current_instance U0/jtag_axi_engine_u/wr_cmd_fifo_i/inst_fifo_gen/gconvfifo.rf/grf.rf/gntv_or_sync_fifo.gcx.clkx/rd_pntr_cdc_inst
set_property src_info {type:SCOPED_XDC file:7 line:23 export:INPUT save:NONE read:READ} [current_design]
create_waiver -internal -scoped -type CDC -id {CDC-6} -user "xpm_cdc" -tags "1009444" -desc "The CDC-6 warning is waived as it is safe in the context of XPM_CDC_GRAY." -from [get_pins -quiet {src_gray_ff_reg*/C}] -to [get_pins -quiet {dest_graysync_ff_reg*/D}]
current_instance
current_instance U0/jtag_axi_engine_u/wr_cmd_fifo_i/inst_fifo_gen/gconvfifo.rf/grf.rf/gntv_or_sync_fifo.gcx.clkx/wr_pntr_cdc_inst
set_property src_info {type:SCOPED_XDC file:8 line:23 export:INPUT save:NONE read:READ} [current_design]
create_waiver -internal -scoped -type CDC -id {CDC-6} -user "xpm_cdc" -tags "1009444" -desc "The CDC-6 warning is waived as it is safe in the context of XPM_CDC_GRAY." -from [get_pins -quiet {src_gray_ff_reg*/C}] -to [get_pins -quiet {dest_graysync_ff_reg*/D}]
