AdriaanSadie/MVT_ADC_TECH/adc_tech/adc_tech.cache/ip/2020.2/15ecd0954ee1790e/adc_tech_s01_mmu_0_stub.vhdl

-- Copyright 1986-2020 Xilinx, Inc. All Rights Reserved.
-- --------------------------------------------------------------------------------
-- Tool Version: Vivado v.2020.2 (win64) Build 3064766 Wed Nov 18 09:12:45 MST 2020
-- Date        : Mon Oct 27 06:22:57 2025
-- Host        : ZA-WASADIE1 running 64-bit major release  (build 9200)
-- Command     : write_vhdl -force -mode synth_stub -rename_top decalper_eb_ot_sdeen_pot_pi_dehcac_xnilix -prefix
--               decalper_eb_ot_sdeen_pot_pi_dehcac_xnilix_ adc_tech_s01_mmu_0_stub.vhdl
-- Design      : adc_tech_s01_mmu_0
-- Purpose     : Stub declaration of top-level module interface
-- Device      : xczu7ev-ffvc1156-2-e
-- --------------------------------------------------------------------------------
library IEEE;
use IEEE.STD_LOGIC_1164.ALL;

entity decalper_eb_ot_sdeen_pot_pi_dehcac_xnilix is
  Port ( 
    aclk : in STD_LOGIC;
    aresetn : in STD_LOGIC;
    s_axi_awid : in STD_LOGIC_VECTOR ( 0 to 0 );
    s_axi_awaddr : in STD_LOGIC_VECTOR ( 31 downto 0 );
    s_axi_awlen : in STD_LOGIC_VECTOR ( 7 downto 0 );
    s_axi_awsize : in STD_LOGIC_VECTOR ( 2 downto 0 );
    s_axi_awburst : in STD_LOGIC_VECTOR ( 1 downto 0 );
    s_axi_awlock : in STD_LOGIC_VECTOR ( 0 to 0 );
    s_axi_awcache : in STD_LOGIC_VECTOR ( 3 downto 0 );
    s_axi_awprot : in STD_LOGIC_VECTOR ( 2 downto 0 );
    s_axi_awqos : in STD_LOGIC_VECTOR ( 3 downto 0 );
    s_axi_awvalid : in STD_LOGIC;
    s_axi_awready : out STD_LOGIC;
    s_axi_wdata : in STD_LOGIC_VECTOR ( 31 downto 0 );
    s_axi_wstrb : in STD_LOGIC_VECTOR ( 3 downto 0 );
    s_axi_wlast : in STD_LOGIC;
    s_axi_wvalid : in STD_LOGIC;
    s_axi_wready : out STD_LOGIC;
    s_axi_bid : out STD_LOGIC_VECTOR ( 0 to 0 );
    s_axi_bresp : out STD_LOGIC_VECTOR ( 1 downto 0 );
    s_axi_bvalid : out STD_LOGIC;
    s_axi_bready : in STD_LOGIC;
    s_axi_arid : in STD_LOGIC_VECTOR ( 0 to 0 );
    s_axi_araddr : in STD_LOGIC_VECTOR ( 31 downto 0 );
    s_axi_arlen : in STD_LOGIC_VECTOR ( 7 downto 0 );
    s_axi_arsize : in STD_LOGIC_VECTOR ( 2 downto 0 );
    s_axi_arburst : in STD_LOGIC_VECTOR ( 1 downto 0 );
    s_axi_arlock : in STD_LOGIC_VECTOR ( 0 to 0 );
    s_axi_arcache : in STD_LOGIC_VECTOR ( 3 downto 0 );
    s_axi_arprot : in STD_LOGIC_VECTOR ( 2 downto 0 );
    s_axi_arqos : in STD_LOGIC_VECTOR ( 3 downto 0 );
    s_axi_arvalid : in STD_LOGIC;
    s_axi_arready : out STD_LOGIC;
    s_axi_rid : out STD_LOGIC_VECTOR ( 0 to 0 );
    s_axi_rdata : out STD_LOGIC_VECTOR ( 31 downto 0 );
    s_axi_rresp : out STD_LOGIC_VECTOR ( 1 downto 0 );
    s_axi_rlast : out STD_LOGIC;
    s_axi_rvalid : out STD_LOGIC;
    s_axi_rready : in STD_LOGIC;
    m_axi_awid : out STD_LOGIC_VECTOR ( 0 to 0 );
    m_axi_awaddr : out STD_LOGIC_VECTOR ( 31 downto 0 );
    m_axi_awlen : out STD_LOGIC_VECTOR ( 7 downto 0 );
    m_axi_awsize : out STD_LOGIC_VECTOR ( 2 downto 0 );
    m_axi_awburst : out STD_LOGIC_VECTOR ( 1 downto 0 );
    m_axi_awlock : out STD_LOGIC_VECTOR ( 0 to 0 );
    m_axi_awcache : out STD_LOGIC_VECTOR ( 3 downto 0 );
    m_axi_awprot : out STD_LOGIC_VECTOR ( 2 downto 0 );
    m_axi_awqos : out STD_LOGIC_VECTOR ( 3 downto 0 );
    m_axi_awvalid : out STD_LOGIC;
    m_axi_awready : in STD_LOGIC;
    m_axi_wdata : out STD_LOGIC_VECTOR ( 31 downto 0 );
    m_axi_wstrb : out STD_LOGIC_VECTOR ( 3 downto 0 );
    m_axi_wlast : out STD_LOGIC;
    m_axi_wvalid : out STD_LOGIC;
    m_axi_wready : in STD_LOGIC;
    m_axi_bid : in STD_LOGIC_VECTOR ( 0 to 0 );
    m_axi_bresp : in STD_LOGIC_VECTOR ( 1 downto 0 );
    m_axi_bvalid : in STD_LOGIC;
    m_axi_bready : out STD_LOGIC;
    m_axi_arid : out STD_LOGIC_VECTOR ( 0 to 0 );
    m_axi_araddr : out STD_LOGIC_VECTOR ( 31 downto 0 );
    m_axi_arlen : out STD_LOGIC_VECTOR ( 7 downto 0 );
    m_axi_arsize : out STD_LOGIC_VECTOR ( 2 downto 0 );
    m_axi_arburst : out STD_LOGIC_VECTOR ( 1 downto 0 );
    m_axi_arlock : out STD_LOGIC_VECTOR ( 0 to 0 );
    m_axi_arcache : out STD_LOGIC_VECTOR ( 3 downto 0 );
    m_axi_arprot : out STD_LOGIC_VECTOR ( 2 downto 0 );
    m_axi_arqos : out STD_LOGIC_VECTOR ( 3 downto 0 );
    m_axi_arvalid : out STD_LOGIC;
    m_axi_arready : in STD_LOGIC;
    m_axi_rid : in STD_LOGIC_VECTOR ( 0 to 0 );
    m_axi_rdata : in STD_LOGIC_VECTOR ( 31 downto 0 );
    m_axi_rresp : in STD_LOGIC_VECTOR ( 1 downto 0 );
    m_axi_rlast : in STD_LOGIC;
    m_axi_rvalid : in STD_LOGIC;
    m_axi_rready : out STD_LOGIC
  );

end decalper_eb_ot_sdeen_pot_pi_dehcac_xnilix;

architecture stub of decalper_eb_ot_sdeen_pot_pi_dehcac_xnilix is
attribute syn_black_box : boolean;
attribute black_box_pad_pin : string;
attribute syn_black_box of stub : architecture is true;
attribute black_box_pad_pin of stub : architecture is "aclk,aresetn,s_axi_awid[0:0],s_axi_awaddr[31:0],s_axi_awlen[7:0],s_axi_awsize[2:0],s_axi_awburst[1:0],s_axi_awlock[0:0],s_axi_awcache[3:0],s_axi_awprot[2:0],s_axi_awqos[3:0],s_axi_awvalid,s_axi_awready,s_axi_wdata[31:0],s_axi_wstrb[3:0],s_axi_wlast,s_axi_wvalid,s_axi_wready,s_axi_bid[0:0],s_axi_bresp[1:0],s_axi_bvalid,s_axi_bready,s_axi_arid[0:0],s_axi_araddr[31:0],s_axi_arlen[7:0],s_axi_arsize[2:0],s_axi_arburst[1:0],s_axi_arlock[0:0],s_axi_arcache[3:0],s_axi_arprot[2:0],s_axi_arqos[3:0],s_axi_arvalid,s_axi_arready,s_axi_rid[0:0],s_axi_rdata[31:0],s_axi_rresp[1:0],s_axi_rlast,s_axi_rvalid,s_axi_rready,m_axi_awid[0:0],m_axi_awaddr[31:0],m_axi_awlen[7:0],m_axi_awsize[2:0],m_axi_awburst[1:0],m_axi_awlock[0:0],m_axi_awcache[3:0],m_axi_awprot[2:0],m_axi_awqos[3:0],m_axi_awvalid,m_axi_awready,m_axi_wdata[31:0],m_axi_wstrb[3:0],m_axi_wlast,m_axi_wvalid,m_axi_wready,m_axi_bid[0:0],m_axi_bresp[1:0],m_axi_bvalid,m_axi_bready,m_axi_arid[0:0],m_axi_araddr[31:0],m_axi_arlen[7:0],m_axi_arsize[2:0],m_axi_arburst[1:0],m_axi_arlock[0:0],m_axi_arcache[3:0],m_axi_arprot[2:0],m_axi_arqos[3:0],m_axi_arvalid,m_axi_arready,m_axi_rid[0:0],m_axi_rdata[31:0],m_axi_rresp[1:0],m_axi_rlast,m_axi_rvalid,m_axi_rready";
attribute X_CORE_INFO : string;
attribute X_CORE_INFO of stub : architecture is "axi_mmu_v2_1_20_top,Vivado 2020.2";
begin
end;
