AdriaanSadie/MVT_ADC_TECH/adc_tech/adc_tech.cache/ip/2020.2/9d403659cdec811b/adc_tech_s00_mmu_0_stub.v

// Copyright 1986-2020 Xilinx, Inc. All Rights Reserved.
// --------------------------------------------------------------------------------
// Tool Version: Vivado v.2020.2 (win64) Build 3064766 Wed Nov 18 09:12:45 MST 2020
// Date        : Mon Oct 27 06:22:52 2025
// Host        : ZA-WASADIE1 running 64-bit major release  (build 9200)
// Command     : write_verilog -force -mode synth_stub -rename_top decalper_eb_ot_sdeen_pot_pi_dehcac_xnilix -prefix
//               decalper_eb_ot_sdeen_pot_pi_dehcac_xnilix_ adc_tech_s00_mmu_0_stub.v
// Design      : adc_tech_s00_mmu_0
// Purpose     : Stub declaration of top-level module interface
// Device      : xczu7ev-ffvc1156-2-e
// --------------------------------------------------------------------------------

// This empty module with port declaration file causes synthesis tools to infer a black box for IP.
// The synthesis directives are for Synopsys Synplify support to prevent IO buffer insertion.
// Please paste the declaration into a Verilog source file or add the file as an additional source.
(* X_CORE_INFO = "axi_mmu_v2_1_20_top,Vivado 2020.2" *)
module decalper_eb_ot_sdeen_pot_pi_dehcac_xnilix(aclk, aresetn, s_axi_awid, s_axi_awaddr, 
  s_axi_awlen, s_axi_awsize, s_axi_awburst, s_axi_awlock, s_axi_awcache, s_axi_awprot, 
  s_axi_awqos, s_axi_awuser, s_axi_awvalid, s_axi_awready, s_axi_wdata, s_axi_wstrb, 
  s_axi_wlast, s_axi_wvalid, s_axi_wready, s_axi_bid, s_axi_bresp, s_axi_bvalid, s_axi_bready, 
  s_axi_arid, s_axi_araddr, s_axi_arlen, s_axi_arsize, s_axi_arburst, s_axi_arlock, 
  s_axi_arcache, s_axi_arprot, s_axi_arqos, s_axi_aruser, s_axi_arvalid, s_axi_arready, 
  s_axi_rid, s_axi_rdata, s_axi_rresp, s_axi_rlast, s_axi_rvalid, s_axi_rready, m_axi_awid, 
  m_axi_awaddr, m_axi_awlen, m_axi_awsize, m_axi_awburst, m_axi_awlock, m_axi_awcache, 
  m_axi_awprot, m_axi_awqos, m_axi_awuser, m_axi_awvalid, m_axi_awready, m_axi_wdata, 
  m_axi_wstrb, m_axi_wlast, m_axi_wvalid, m_axi_wready, m_axi_bid, m_axi_bresp, m_axi_bvalid, 
  m_axi_bready, m_axi_arid, m_axi_araddr, m_axi_arlen, m_axi_arsize, m_axi_arburst, 
  m_axi_arlock, m_axi_arcache, m_axi_arprot, m_axi_arqos, m_axi_aruser, m_axi_arvalid, 
  m_axi_arready, m_axi_rid, m_axi_rdata, m_axi_rresp, m_axi_rlast, m_axi_rvalid, m_axi_rready)
/* synthesis syn_black_box black_box_pad_pin="aclk,aresetn,s_axi_awid[15:0],s_axi_awaddr[39:0],s_axi_awlen[7:0],s_axi_awsize[2:0],s_axi_awburst[1:0],s_axi_awlock[0:0],s_axi_awcache[3:0],s_axi_awprot[2:0],s_axi_awqos[3:0],s_axi_awuser[15:0],s_axi_awvalid,s_axi_awready,s_axi_wdata[31:0],s_axi_wstrb[3:0],s_axi_wlast,s_axi_wvalid,s_axi_wready,s_axi_bid[15:0],s_axi_bresp[1:0],s_axi_bvalid,s_axi_bready,s_axi_arid[15:0],s_axi_araddr[39:0],s_axi_arlen[7:0],s_axi_arsize[2:0],s_axi_arburst[1:0],s_axi_arlock[0:0],s_axi_arcache[3:0],s_axi_arprot[2:0],s_axi_arqos[3:0],s_axi_aruser[15:0],s_axi_arvalid,s_axi_arready,s_axi_rid[15:0],s_axi_rdata[31:0],s_axi_rresp[1:0],s_axi_rlast,s_axi_rvalid,s_axi_rready,m_axi_awid[15:0],m_axi_awaddr[39:0],m_axi_awlen[7:0],m_axi_awsize[2:0],m_axi_awburst[1:0],m_axi_awlock[0:0],m_axi_awcache[3:0],m_axi_awprot[2:0],m_axi_awqos[3:0],m_axi_awuser[15:0],m_axi_awvalid,m_axi_awready,m_axi_wdata[31:0],m_axi_wstrb[3:0],m_axi_wlast,m_axi_wvalid,m_axi_wready,m_axi_bid[15:0],m_axi_bresp[1:0],m_axi_bvalid,m_axi_bready,m_axi_arid[15:0],m_axi_araddr[39:0],m_axi_arlen[7:0],m_axi_arsize[2:0],m_axi_arburst[1:0],m_axi_arlock[0:0],m_axi_arcache[3:0],m_axi_arprot[2:0],m_axi_arqos[3:0],m_axi_aruser[15:0],m_axi_arvalid,m_axi_arready,m_axi_rid[15:0],m_axi_rdata[31:0],m_axi_rresp[1:0],m_axi_rlast,m_axi_rvalid,m_axi_rready" */;
  input aclk;
  input aresetn;
  input [15:0]s_axi_awid;
  input [39:0]s_axi_awaddr;
  input [7:0]s_axi_awlen;
  input [2:0]s_axi_awsize;
  input [1:0]s_axi_awburst;
  input [0:0]s_axi_awlock;
  input [3:0]s_axi_awcache;
  input [2:0]s_axi_awprot;
  input [3:0]s_axi_awqos;
  input [15:0]s_axi_awuser;
  input s_axi_awvalid;
  output s_axi_awready;
  input [31:0]s_axi_wdata;
  input [3:0]s_axi_wstrb;
  input s_axi_wlast;
  input s_axi_wvalid;
  output s_axi_wready;
  output [15:0]s_axi_bid;
  output [1:0]s_axi_bresp;
  output s_axi_bvalid;
  input s_axi_bready;
  input [15:0]s_axi_arid;
  input [39:0]s_axi_araddr;
  input [7:0]s_axi_arlen;
  input [2:0]s_axi_arsize;
  input [1:0]s_axi_arburst;
  input [0:0]s_axi_arlock;
  input [3:0]s_axi_arcache;
  input [2:0]s_axi_arprot;
  input [3:0]s_axi_arqos;
  input [15:0]s_axi_aruser;
  input s_axi_arvalid;
  output s_axi_arready;
  output [15:0]s_axi_rid;
  output [31:0]s_axi_rdata;
  output [1:0]s_axi_rresp;
  output s_axi_rlast;
  output s_axi_rvalid;
  input s_axi_rready;
  output [15:0]m_axi_awid;
  output [39:0]m_axi_awaddr;
  output [7:0]m_axi_awlen;
  output [2:0]m_axi_awsize;
  output [1:0]m_axi_awburst;
  output [0:0]m_axi_awlock;
  output [3:0]m_axi_awcache;
  output [2:0]m_axi_awprot;
  output [3:0]m_axi_awqos;
  output [15:0]m_axi_awuser;
  output m_axi_awvalid;
  input m_axi_awready;
  output [31:0]m_axi_wdata;
  output [3:0]m_axi_wstrb;
  output m_axi_wlast;
  output m_axi_wvalid;
  input m_axi_wready;
  input [15:0]m_axi_bid;
  input [1:0]m_axi_bresp;
  input m_axi_bvalid;
  output m_axi_bready;
  output [15:0]m_axi_arid;
  output [39:0]m_axi_araddr;
  output [7:0]m_axi_arlen;
  output [2:0]m_axi_arsize;
  output [1:0]m_axi_arburst;
  output [0:0]m_axi_arlock;
  output [3:0]m_axi_arcache;
  output [2:0]m_axi_arprot;
  output [3:0]m_axi_arqos;
  output [15:0]m_axi_aruser;
  output m_axi_arvalid;
  input m_axi_arready;
  input [15:0]m_axi_rid;
  input [31:0]m_axi_rdata;
  input [1:0]m_axi_rresp;
  input m_axi_rlast;
  input m_axi_rvalid;
  output m_axi_rready;
endmodule
