AdriaanSadie/MVT_ADC_TECH/adc_tech/adc_tech.cache/ip/2020.2/1b7976b1675749fc/adc_tech_blk_mem_gen_0_0_stub.vhdl

-- Copyright 1986-2020 Xilinx, Inc. All Rights Reserved.
-- --------------------------------------------------------------------------------
-- Tool Version: Vivado v.2020.2 (win64) Build 3064766 Wed Nov 18 09:12:45 MST 2020
-- Date        : Mon Sep 29 14:50:42 2025
-- Host        : ZA-WASADIE1 running 64-bit major release  (build 9200)
-- Command     : write_vhdl -force -mode synth_stub -rename_top decalper_eb_ot_sdeen_pot_pi_dehcac_xnilix -prefix
--               decalper_eb_ot_sdeen_pot_pi_dehcac_xnilix_ adc_tech_blk_mem_gen_0_0_stub.vhdl
-- Design      : adc_tech_blk_mem_gen_0_0
-- Purpose     : Stub declaration of top-level module interface
-- Device      : xczu7ev-ffvc1156-2-e
-- --------------------------------------------------------------------------------
library IEEE;
use IEEE.STD_LOGIC_1164.ALL;

entity decalper_eb_ot_sdeen_pot_pi_dehcac_xnilix is
  Port ( 
    clka : in STD_LOGIC;
    rsta : in STD_LOGIC;
    ena : in STD_LOGIC;
    wea : in STD_LOGIC_VECTOR ( 3 downto 0 );
    addra : in STD_LOGIC_VECTOR ( 31 downto 0 );
    dina : in STD_LOGIC_VECTOR ( 31 downto 0 );
    douta : out STD_LOGIC_VECTOR ( 31 downto 0 );
    clkb : in STD_LOGIC;
    rstb : in STD_LOGIC;
    enb : in STD_LOGIC;
    web : in STD_LOGIC_VECTOR ( 3 downto 0 );
    addrb : in STD_LOGIC_VECTOR ( 31 downto 0 );
    dinb : in STD_LOGIC_VECTOR ( 31 downto 0 );
    doutb : out STD_LOGIC_VECTOR ( 31 downto 0 );
    rsta_busy : out STD_LOGIC;
    rstb_busy : out STD_LOGIC
  );

end decalper_eb_ot_sdeen_pot_pi_dehcac_xnilix;

architecture stub of decalper_eb_ot_sdeen_pot_pi_dehcac_xnilix is
attribute syn_black_box : boolean;
attribute black_box_pad_pin : string;
attribute syn_black_box of stub : architecture is true;
attribute black_box_pad_pin of stub : architecture is "clka,rsta,ena,wea[3:0],addra[31:0],dina[31:0],douta[31:0],clkb,rstb,enb,web[3:0],addrb[31:0],dinb[31:0],doutb[31:0],rsta_busy,rstb_busy";
attribute x_core_info : string;
attribute x_core_info of stub : architecture is "blk_mem_gen_v8_4_4,Vivado 2020.2";
begin
end;
