AdriaanSadie/MVT_ADC_TECH/adc_tech/adc_tech.cache/ip/2020.2/218f51cbd73a38f3/adc_tech_axi_bram_ctrl_0_2_sim_netlist.v

// Copyright 1986-2020 Xilinx, Inc. All Rights Reserved.
// --------------------------------------------------------------------------------
// Tool Version: Vivado v.2020.2 (win64) Build 3064766 Wed Nov 18 09:12:45 MST 2020
// Date        : Mon Oct 27 06:54:17 2025
// Host        : ZA-WASADIE1 running 64-bit major release  (build 9200)
// Command     : write_verilog -force -mode funcsim -rename_top decalper_eb_ot_sdeen_pot_pi_dehcac_xnilix -prefix
//               decalper_eb_ot_sdeen_pot_pi_dehcac_xnilix_ adc_tech_axi_bram_ctrl_0_2_sim_netlist.v
// Design      : adc_tech_axi_bram_ctrl_0_2
// Purpose     : This verilog netlist is a functional simulation representation of the design and should not be modified
//               or synthesized. This netlist cannot be used for SDF annotated simulation.
// Device      : xczu7ev-ffvc1156-2-e
// --------------------------------------------------------------------------------
`timescale 1 ps / 1 ps

(* CHECK_LICENSE_TYPE = "adc_tech_axi_bram_ctrl_0_2,axi_bram_ctrl,{}" *) (* downgradeipidentifiedwarnings = "yes" *) (* x_core_info = "axi_bram_ctrl,Vivado 2020.2" *) 
(* NotValidForBitStream *)
module decalper_eb_ot_sdeen_pot_pi_dehcac_xnilix
   (s_axi_aclk,
    s_axi_aresetn,
    s_axi_awaddr,
    s_axi_awlen,
    s_axi_awsize,
    s_axi_awburst,
    s_axi_awlock,
    s_axi_awcache,
    s_axi_awprot,
    s_axi_awvalid,
    s_axi_awready,
    s_axi_wdata,
    s_axi_wstrb,
    s_axi_wlast,
    s_axi_wvalid,
    s_axi_wready,
    s_axi_bresp,
    s_axi_bvalid,
    s_axi_bready,
    s_axi_araddr,
    s_axi_arlen,
    s_axi_arsize,
    s_axi_arburst,
    s_axi_arlock,
    s_axi_arcache,
    s_axi_arprot,
    s_axi_arvalid,
    s_axi_arready,
    s_axi_rdata,
    s_axi_rresp,
    s_axi_rlast,
    s_axi_rvalid,
    s_axi_rready,
    bram_rst_a,
    bram_clk_a,
    bram_en_a,
    bram_we_a,
    bram_addr_a,
    bram_wrdata_a,
    bram_rddata_a);
  (* x_interface_info = "xilinx.com:signal:clock:1.0 CLKIF CLK" *) (* x_interface_parameter = "XIL_INTERFACENAME CLKIF, ASSOCIATED_BUSIF S_AXI:S_AXI_CTRL, ASSOCIATED_RESET s_axi_aresetn, FREQ_HZ 400000000, FREQ_TOLERANCE_HZ 0, PHASE 0.0, CLK_DOMAIN adc_tech_clk_wiz_0_0_clk_out1, INSERT_VIP 0" *) input s_axi_aclk;
  (* x_interface_info = "xilinx.com:signal:reset:1.0 RSTIF RST" *) (* x_interface_parameter = "XIL_INTERFACENAME RSTIF, POLARITY ACTIVE_LOW, INSERT_VIP 0" *) input s_axi_aresetn;
  (* x_interface_info = "xilinx.com:interface:aximm:1.0 S_AXI AWADDR" *) (* x_interface_parameter = "XIL_INTERFACENAME S_AXI, DATA_WIDTH 32, PROTOCOL AXI4, FREQ_HZ 400000000, ID_WIDTH 0, ADDR_WIDTH 18, AWUSER_WIDTH 0, ARUSER_WIDTH 0, WUSER_WIDTH 0, RUSER_WIDTH 0, BUSER_WIDTH 0, READ_WRITE_MODE READ_WRITE, HAS_BURST 1, HAS_LOCK 1, HAS_PROT 1, HAS_CACHE 1, HAS_QOS 0, HAS_REGION 0, HAS_WSTRB 1, HAS_BRESP 1, HAS_RRESP 1, SUPPORTS_NARROW_BURST 1, NUM_READ_OUTSTANDING 8, NUM_WRITE_OUTSTANDING 8, MAX_BURST_LENGTH 256, PHASE 0.0, CLK_DOMAIN adc_tech_clk_wiz_0_0_clk_out1, NUM_READ_THREADS 1, NUM_WRITE_THREADS 1, RUSER_BITS_PER_BYTE 0, WUSER_BITS_PER_BYTE 0, INSERT_VIP 0" *) input [17:0]s_axi_awaddr;
  (* x_interface_info = "xilinx.com:interface:aximm:1.0 S_AXI AWLEN" *) input [7:0]s_axi_awlen;
  (* x_interface_info = "xilinx.com:interface:aximm:1.0 S_AXI AWSIZE" *) input [2:0]s_axi_awsize;
  (* x_interface_info = "xilinx.com:interface:aximm:1.0 S_AXI AWBURST" *) input [1:0]s_axi_awburst;
  (* x_interface_info = "xilinx.com:interface:aximm:1.0 S_AXI AWLOCK" *) input s_axi_awlock;
  (* x_interface_info = "xilinx.com:interface:aximm:1.0 S_AXI AWCACHE" *) input [3:0]s_axi_awcache;
  (* x_interface_info = "xilinx.com:interface:aximm:1.0 S_AXI AWPROT" *) input [2:0]s_axi_awprot;
  (* x_interface_info = "xilinx.com:interface:aximm:1.0 S_AXI AWVALID" *) input s_axi_awvalid;
  (* x_interface_info = "xilinx.com:interface:aximm:1.0 S_AXI AWREADY" *) output s_axi_awready;
  (* x_interface_info = "xilinx.com:interface:aximm:1.0 S_AXI WDATA" *) input [31:0]s_axi_wdata;
  (* x_interface_info = "xilinx.com:interface:aximm:1.0 S_AXI WSTRB" *) input [3:0]s_axi_wstrb;
  (* x_interface_info = "xilinx.com:interface:aximm:1.0 S_AXI WLAST" *) input s_axi_wlast;
  (* x_interface_info = "xilinx.com:interface:aximm:1.0 S_AXI WVALID" *) input s_axi_wvalid;
  (* x_interface_info = "xilinx.com:interface:aximm:1.0 S_AXI WREADY" *) output s_axi_wready;
  (* x_interface_info = "xilinx.com:interface:aximm:1.0 S_AXI BRESP" *) output [1:0]s_axi_bresp;
  (* x_interface_info = "xilinx.com:interface:aximm:1.0 S_AXI BVALID" *) output s_axi_bvalid;
  (* x_interface_info = "xilinx.com:interface:aximm:1.0 S_AXI BREADY" *) input s_axi_bready;
  (* x_interface_info = "xilinx.com:interface:aximm:1.0 S_AXI ARADDR" *) input [17:0]s_axi_araddr;
  (* x_interface_info = "xilinx.com:interface:aximm:1.0 S_AXI ARLEN" *) input [7:0]s_axi_arlen;
  (* x_interface_info = "xilinx.com:interface:aximm:1.0 S_AXI ARSIZE" *) input [2:0]s_axi_arsize;
  (* x_interface_info = "xilinx.com:interface:aximm:1.0 S_AXI ARBURST" *) input [1:0]s_axi_arburst;
  (* x_interface_info = "xilinx.com:interface:aximm:1.0 S_AXI ARLOCK" *) input s_axi_arlock;
  (* x_interface_info = "xilinx.com:interface:aximm:1.0 S_AXI ARCACHE" *) input [3:0]s_axi_arcache;
  (* x_interface_info = "xilinx.com:interface:aximm:1.0 S_AXI ARPROT" *) input [2:0]s_axi_arprot;
  (* x_interface_info = "xilinx.com:interface:aximm:1.0 S_AXI ARVALID" *) input s_axi_arvalid;
  (* x_interface_info = "xilinx.com:interface:aximm:1.0 S_AXI ARREADY" *) output s_axi_arready;
  (* x_interface_info = "xilinx.com:interface:aximm:1.0 S_AXI RDATA" *) output [31:0]s_axi_rdata;
  (* x_interface_info = "xilinx.com:interface:aximm:1.0 S_AXI RRESP" *) output [1:0]s_axi_rresp;
  (* x_interface_info = "xilinx.com:interface:aximm:1.0 S_AXI RLAST" *) output s_axi_rlast;
  (* x_interface_info = "xilinx.com:interface:aximm:1.0 S_AXI RVALID" *) output s_axi_rvalid;
  (* x_interface_info = "xilinx.com:interface:aximm:1.0 S_AXI RREADY" *) input s_axi_rready;
  (* x_interface_info = "xilinx.com:interface:bram:1.0 BRAM_PORTA RST" *) (* x_interface_parameter = "XIL_INTERFACENAME BRAM_PORTA, MASTER_TYPE BRAM_CTRL, MEM_SIZE 262144, MEM_WIDTH 32, MEM_ECC NONE, READ_WRITE_MODE READ_WRITE, READ_LATENCY 1" *) output bram_rst_a;
  (* x_interface_info = "xilinx.com:interface:bram:1.0 BRAM_PORTA CLK" *) output bram_clk_a;
  (* x_interface_info = "xilinx.com:interface:bram:1.0 BRAM_PORTA EN" *) output bram_en_a;
  (* x_interface_info = "xilinx.com:interface:bram:1.0 BRAM_PORTA WE" *) output [3:0]bram_we_a;
  (* x_interface_info = "xilinx.com:interface:bram:1.0 BRAM_PORTA ADDR" *) output [17:0]bram_addr_a;
  (* x_interface_info = "xilinx.com:interface:bram:1.0 BRAM_PORTA DIN" *) output [31:0]bram_wrdata_a;
  (* x_interface_info = "xilinx.com:interface:bram:1.0 BRAM_PORTA DOUT" *) input [31:0]bram_rddata_a;

  wire \<const0> ;
  wire [17:2]\^bram_addr_a ;
  wire bram_clk_a;
  wire bram_en_a;
  wire [31:0]bram_rddata_a;
  wire bram_rst_a;
  wire [3:0]bram_we_a;
  wire [31:0]bram_wrdata_a;
  wire s_axi_aclk;
  wire [17:0]s_axi_araddr;
  wire [1:0]s_axi_arburst;
  wire s_axi_aresetn;
  wire [7:0]s_axi_arlen;
  wire s_axi_arready;
  wire [2:0]s_axi_arsize;
  wire s_axi_arvalid;
  wire [17:0]s_axi_awaddr;
  wire [1:0]s_axi_awburst;
  wire [7:0]s_axi_awlen;
  wire s_axi_awready;
  wire [2:0]s_axi_awsize;
  wire s_axi_awvalid;
  wire s_axi_bready;
  wire s_axi_bvalid;
  wire [31:0]s_axi_rdata;
  wire s_axi_rlast;
  wire s_axi_rready;
  wire s_axi_rvalid;
  wire [31:0]s_axi_wdata;
  wire s_axi_wlast;
  wire s_axi_wready;
  wire [3:0]s_axi_wstrb;
  wire s_axi_wvalid;
  wire NLW_U0_bram_clk_b_UNCONNECTED;
  wire NLW_U0_bram_en_b_UNCONNECTED;
  wire NLW_U0_bram_rst_b_UNCONNECTED;
  wire NLW_U0_ecc_interrupt_UNCONNECTED;
  wire NLW_U0_ecc_ue_UNCONNECTED;
  wire NLW_U0_s_axi_ctrl_arready_UNCONNECTED;
  wire NLW_U0_s_axi_ctrl_awready_UNCONNECTED;
  wire NLW_U0_s_axi_ctrl_bvalid_UNCONNECTED;
  wire NLW_U0_s_axi_ctrl_rvalid_UNCONNECTED;
  wire NLW_U0_s_axi_ctrl_wready_UNCONNECTED;
  wire [1:0]NLW_U0_bram_addr_a_UNCONNECTED;
  wire [17:0]NLW_U0_bram_addr_b_UNCONNECTED;
  wire [3:0]NLW_U0_bram_we_b_UNCONNECTED;
  wire [31:0]NLW_U0_bram_wrdata_b_UNCONNECTED;
  wire [0:0]NLW_U0_s_axi_bid_UNCONNECTED;
  wire [1:0]NLW_U0_s_axi_bresp_UNCONNECTED;
  wire [1:0]NLW_U0_s_axi_ctrl_bresp_UNCONNECTED;
  wire [31:0]NLW_U0_s_axi_ctrl_rdata_UNCONNECTED;
  wire [1:0]NLW_U0_s_axi_ctrl_rresp_UNCONNECTED;
  wire [0:0]NLW_U0_s_axi_rid_UNCONNECTED;
  wire [1:0]NLW_U0_s_axi_rresp_UNCONNECTED;

  assign bram_addr_a[17:2] = \^bram_addr_a [17:2];
  assign bram_addr_a[1] = \<const0> ;
  assign bram_addr_a[0] = \<const0> ;
  assign s_axi_bresp[1] = \<const0> ;
  assign s_axi_bresp[0] = \<const0> ;
  assign s_axi_rresp[1] = \<const0> ;
  assign s_axi_rresp[0] = \<const0> ;
  GND GND
       (.G(\<const0> ));
  (* C_BRAM_ADDR_WIDTH = "16" *) 
  (* C_BRAM_INST_MODE = "EXTERNAL" *) 
  (* C_ECC = "0" *) 
  (* C_ECC_ONOFF_RESET_VALUE = "0" *) 
  (* C_ECC_TYPE = "0" *) 
  (* C_FAMILY = "zynquplus" *) 
  (* C_FAULT_INJECT = "0" *) 
  (* C_MEMORY_DEPTH = "65536" *) 
  (* C_RD_CMD_OPTIMIZATION = "0" *) 
  (* C_READ_LATENCY = "1" *) 
  (* C_SINGLE_PORT_BRAM = "1" *) 
  (* C_S_AXI_ADDR_WIDTH = "18" *) 
  (* C_S_AXI_CTRL_ADDR_WIDTH = "32" *) 
  (* C_S_AXI_CTRL_DATA_WIDTH = "32" *) 
  (* C_S_AXI_DATA_WIDTH = "32" *) 
  (* C_S_AXI_ID_WIDTH = "1" *) 
  (* C_S_AXI_PROTOCOL = "AXI4" *) 
  (* C_S_AXI_SUPPORTS_NARROW_BURST = "1" *) 
  (* downgradeipidentifiedwarnings = "yes" *) 
  decalper_eb_ot_sdeen_pot_pi_dehcac_xnilix_axi_bram_ctrl U0
       (.bram_addr_a({\^bram_addr_a ,NLW_U0_bram_addr_a_UNCONNECTED[1:0]}),
        .bram_addr_b(NLW_U0_bram_addr_b_UNCONNECTED[17:0]),
        .bram_clk_a(bram_clk_a),
        .bram_clk_b(NLW_U0_bram_clk_b_UNCONNECTED),
        .bram_en_a(bram_en_a),
        .bram_en_b(NLW_U0_bram_en_b_UNCONNECTED),
        .bram_rddata_a(bram_rddata_a),
        .bram_rddata_b({1'b0,1'b0,1'b0,1'b0,1'b0,1'b0,1'b0,1'b0,1'b0,1'b0,1'b0,1'b0,1'b0,1'b0,1'b0,1'b0,1'b0,1'b0,1'b0,1'b0,1'b0,1'b0,1'b0,1'b0,1'b0,1'b0,1'b0,1'b0,1'b0,1'b0,1'b0,1'b0}),
        .bram_rst_a(bram_rst_a),
        .bram_rst_b(NLW_U0_bram_rst_b_UNCONNECTED),
        .bram_we_a(bram_we_a),
        .bram_we_b(NLW_U0_bram_we_b_UNCONNECTED[3:0]),
        .bram_wrdata_a(bram_wrdata_a),
        .bram_wrdata_b(NLW_U0_bram_wrdata_b_UNCONNECTED[31:0]),
        .ecc_interrupt(NLW_U0_ecc_interrupt_UNCONNECTED),
        .ecc_ue(NLW_U0_ecc_ue_UNCONNECTED),
        .s_axi_aclk(s_axi_aclk),
        .s_axi_araddr(s_axi_araddr),
        .s_axi_arburst(s_axi_arburst),
        .s_axi_arcache({1'b0,1'b0,1'b0,1'b0}),
        .s_axi_aresetn(s_axi_aresetn),
        .s_axi_arid(1'b0),
        .s_axi_arlen(s_axi_arlen),
        .s_axi_arlock(1'b0),
        .s_axi_arprot({1'b0,1'b0,1'b0}),
        .s_axi_arready(s_axi_arready),
        .s_axi_arsize(s_axi_arsize),
        .s_axi_arvalid(s_axi_arvalid),
        .s_axi_awaddr(s_axi_awaddr),
        .s_axi_awburst(s_axi_awburst),
        .s_axi_awcache({1'b0,1'b0,1'b0,1'b0}),
        .s_axi_awid(1'b0),
        .s_axi_awlen(s_axi_awlen),
        .s_axi_awlock(1'b0),
        .s_axi_awprot({1'b0,1'b0,1'b0}),
        .s_axi_awready(s_axi_awready),
        .s_axi_awsize(s_axi_awsize),
        .s_axi_awvalid(s_axi_awvalid),
        .s_axi_bid(NLW_U0_s_axi_bid_UNCONNECTED[0]),
        .s_axi_bready(s_axi_bready),
        .s_axi_bresp(NLW_U0_s_axi_bresp_UNCONNECTED[1:0]),
        .s_axi_bvalid(s_axi_bvalid),
        .s_axi_ctrl_araddr({1'b0,1'b0,1'b0,1'b0,1'b0,1'b0,1'b0,1'b0,1'b0,1'b0,1'b0,1'b0,1'b0,1'b0,1'b0,1'b0,1'b0,1'b0,1'b0,1'b0,1'b0,1'b0,1'b0,1'b0,1'b0,1'b0,1'b0,1'b0,1'b0,1'b0,1'b0,1'b0}),
        .s_axi_ctrl_arready(NLW_U0_s_axi_ctrl_arready_UNCONNECTED),
        .s_axi_ctrl_arvalid(1'b0),
        .s_axi_ctrl_awaddr({1'b0,1'b0,1'b0,1'b0,1'b0,1'b0,1'b0,1'b0,1'b0,1'b0,1'b0,1'b0,1'b0,1'b0,1'b0,1'b0,1'b0,1'b0,1'b0,1'b0,1'b0,1'b0,1'b0,1'b0,1'b0,1'b0,1'b0,1'b0,1'b0,1'b0,1'b0,1'b0}),
        .s_axi_ctrl_awready(NLW_U0_s_axi_ctrl_awready_UNCONNECTED),
        .s_axi_ctrl_awvalid(1'b0),
        .s_axi_ctrl_bready(1'b0),
        .s_axi_ctrl_bresp(NLW_U0_s_axi_ctrl_bresp_UNCONNECTED[1:0]),
        .s_axi_ctrl_bvalid(NLW_U0_s_axi_ctrl_bvalid_UNCONNECTED),
        .s_axi_ctrl_rdata(NLW_U0_s_axi_ctrl_rdata_UNCONNECTED[31:0]),
        .s_axi_ctrl_rready(1'b0),
        .s_axi_ctrl_rresp(NLW_U0_s_axi_ctrl_rresp_UNCONNECTED[1:0]),
        .s_axi_ctrl_rvalid(NLW_U0_s_axi_ctrl_rvalid_UNCONNECTED),
        .s_axi_ctrl_wdata({1'b0,1'b0,1'b0,1'b0,1'b0,1'b0,1'b0,1'b0,1'b0,1'b0,1'b0,1'b0,1'b0,1'b0,1'b0,1'b0,1'b0,1'b0,1'b0,1'b0,1'b0,1'b0,1'b0,1'b0,1'b0,1'b0,1'b0,1'b0,1'b0,1'b0,1'b0,1'b0}),
        .s_axi_ctrl_wready(NLW_U0_s_axi_ctrl_wready_UNCONNECTED),
        .s_axi_ctrl_wvalid(1'b0),
        .s_axi_rdata(s_axi_rdata),
        .s_axi_rid(NLW_U0_s_axi_rid_UNCONNECTED[0]),
        .s_axi_rlast(s_axi_rlast),
        .s_axi_rready(s_axi_rready),
        .s_axi_rresp(NLW_U0_s_axi_rresp_UNCONNECTED[1:0]),
        .s_axi_rvalid(s_axi_rvalid),
        .s_axi_wdata(s_axi_wdata),
        .s_axi_wlast(s_axi_wlast),
        .s_axi_wready(s_axi_wready),
        .s_axi_wstrb(s_axi_wstrb),
        .s_axi_wvalid(s_axi_wvalid));
endmodule

(* C_BRAM_ADDR_WIDTH = "16" *) (* C_BRAM_INST_MODE = "EXTERNAL" *) (* C_ECC = "0" *) 
(* C_ECC_ONOFF_RESET_VALUE = "0" *) (* C_ECC_TYPE = "0" *) (* C_FAMILY = "zynquplus" *) 
(* C_FAULT_INJECT = "0" *) (* C_MEMORY_DEPTH = "65536" *) (* C_RD_CMD_OPTIMIZATION = "0" *) 
(* C_READ_LATENCY = "1" *) (* C_SINGLE_PORT_BRAM = "1" *) (* C_S_AXI_ADDR_WIDTH = "18" *) 
(* C_S_AXI_CTRL_ADDR_WIDTH = "32" *) (* C_S_AXI_CTRL_DATA_WIDTH = "32" *) (* C_S_AXI_DATA_WIDTH = "32" *) 
(* C_S_AXI_ID_WIDTH = "1" *) (* C_S_AXI_PROTOCOL = "AXI4" *) (* C_S_AXI_SUPPORTS_NARROW_BURST = "1" *) 
(* downgradeipidentifiedwarnings = "yes" *) 
module decalper_eb_ot_sdeen_pot_pi_dehcac_xnilix_axi_bram_ctrl
   (s_axi_aclk,
    s_axi_aresetn,
    ecc_interrupt,
    ecc_ue,
    s_axi_awid,
    s_axi_awaddr,
    s_axi_awlen,
    s_axi_awsize,
    s_axi_awburst,
    s_axi_awlock,
    s_axi_awcache,
    s_axi_awprot,
    s_axi_awvalid,
    s_axi_awready,
    s_axi_wdata,
    s_axi_wstrb,
    s_axi_wlast,
    s_axi_wvalid,
    s_axi_wready,
    s_axi_bid,
    s_axi_bresp,
    s_axi_bvalid,
    s_axi_bready,
    s_axi_arid,
    s_axi_araddr,
    s_axi_arlen,
    s_axi_arsize,
    s_axi_arburst,
    s_axi_arlock,
    s_axi_arcache,
    s_axi_arprot,
    s_axi_arvalid,
    s_axi_arready,
    s_axi_rid,
    s_axi_rdata,
    s_axi_rresp,
    s_axi_rlast,
    s_axi_rvalid,
    s_axi_rready,
    s_axi_ctrl_awvalid,
    s_axi_ctrl_awready,
    s_axi_ctrl_awaddr,
    s_axi_ctrl_wdata,
    s_axi_ctrl_wvalid,
    s_axi_ctrl_wready,
    s_axi_ctrl_bresp,
    s_axi_ctrl_bvalid,
    s_axi_ctrl_bready,
    s_axi_ctrl_araddr,
    s_axi_ctrl_arvalid,
    s_axi_ctrl_arready,
    s_axi_ctrl_rdata,
    s_axi_ctrl_rresp,
    s_axi_ctrl_rvalid,
    s_axi_ctrl_rready,
    bram_rst_a,
    bram_clk_a,
    bram_en_a,
    bram_we_a,
    bram_addr_a,
    bram_wrdata_a,
    bram_rddata_a,
    bram_rst_b,
    bram_clk_b,
    bram_en_b,
    bram_we_b,
    bram_addr_b,
    bram_wrdata_b,
    bram_rddata_b);
  input s_axi_aclk;
  input s_axi_aresetn;
  output ecc_interrupt;
  output ecc_ue;
  input [0:0]s_axi_awid;
  input [17:0]s_axi_awaddr;
  input [7:0]s_axi_awlen;
  input [2:0]s_axi_awsize;
  input [1:0]s_axi_awburst;
  input s_axi_awlock;
  input [3:0]s_axi_awcache;
  input [2:0]s_axi_awprot;
  input s_axi_awvalid;
  output s_axi_awready;
  input [31:0]s_axi_wdata;
  input [3:0]s_axi_wstrb;
  input s_axi_wlast;
  input s_axi_wvalid;
  output s_axi_wready;
  output [0:0]s_axi_bid;
  output [1:0]s_axi_bresp;
  output s_axi_bvalid;
  input s_axi_bready;
  input [0:0]s_axi_arid;
  input [17:0]s_axi_araddr;
  input [7:0]s_axi_arlen;
  input [2:0]s_axi_arsize;
  input [1:0]s_axi_arburst;
  input s_axi_arlock;
  input [3:0]s_axi_arcache;
  input [2:0]s_axi_arprot;
  input s_axi_arvalid;
  output s_axi_arready;
  output [0:0]s_axi_rid;
  output [31:0]s_axi_rdata;
  output [1:0]s_axi_rresp;
  output s_axi_rlast;
  output s_axi_rvalid;
  input s_axi_rready;
  input s_axi_ctrl_awvalid;
  output s_axi_ctrl_awready;
  input [31:0]s_axi_ctrl_awaddr;
  input [31:0]s_axi_ctrl_wdata;
  input s_axi_ctrl_wvalid;
  output s_axi_ctrl_wready;
  output [1:0]s_axi_ctrl_bresp;
  output s_axi_ctrl_bvalid;
  input s_axi_ctrl_bready;
  input [31:0]s_axi_ctrl_araddr;
  input s_axi_ctrl_arvalid;
  output s_axi_ctrl_arready;
  output [31:0]s_axi_ctrl_rdata;
  output [1:0]s_axi_ctrl_rresp;
  output s_axi_ctrl_rvalid;
  input s_axi_ctrl_rready;
  output bram_rst_a;
  output bram_clk_a;
  output bram_en_a;
  output [3:0]bram_we_a;
  output [17:0]bram_addr_a;
  output [31:0]bram_wrdata_a;
  input [31:0]bram_rddata_a;
  output bram_rst_b;
  output bram_clk_b;
  output bram_en_b;
  output [3:0]bram_we_b;
  output [17:0]bram_addr_b;
  output [31:0]bram_wrdata_b;
  input [31:0]bram_rddata_b;

  wire \<const0> ;
  wire [17:2]\^bram_addr_a ;
  wire bram_en_a;
  wire [31:0]bram_rddata_a;
  wire bram_rst_a;
  wire [3:0]bram_we_a;
  wire [31:0]bram_wrdata_a;
  wire s_axi_aclk;
  wire [17:0]s_axi_araddr;
  wire [1:0]s_axi_arburst;
  wire s_axi_aresetn;
  wire [7:0]s_axi_arlen;
  wire s_axi_arready;
  wire [2:0]s_axi_arsize;
  wire s_axi_arvalid;
  wire [17:0]s_axi_awaddr;
  wire [1:0]s_axi_awburst;
  wire [7:0]s_axi_awlen;
  wire s_axi_awready;
  wire [2:0]s_axi_awsize;
  wire s_axi_awvalid;
  wire s_axi_bready;
  wire s_axi_bvalid;
  wire [31:0]s_axi_rdata;
  wire s_axi_rlast;
  wire s_axi_rready;
  wire s_axi_rvalid;
  wire [31:0]s_axi_wdata;
  wire s_axi_wlast;
  wire s_axi_wready;
  wire [3:0]s_axi_wstrb;
  wire s_axi_wvalid;

  assign bram_addr_a[17:2] = \^bram_addr_a [17:2];
  assign bram_addr_a[1] = \<const0> ;
  assign bram_addr_a[0] = \<const0> ;
  assign bram_addr_b[17] = \<const0> ;
  assign bram_addr_b[16] = \<const0> ;
  assign bram_addr_b[15] = \<const0> ;
  assign bram_addr_b[14] = \<const0> ;
  assign bram_addr_b[13] = \<const0> ;
  assign bram_addr_b[12] = \<const0> ;
  assign bram_addr_b[11] = \<const0> ;
  assign bram_addr_b[10] = \<const0> ;
  assign bram_addr_b[9] = \<const0> ;
  assign bram_addr_b[8] = \<const0> ;
  assign bram_addr_b[7] = \<const0> ;
  assign bram_addr_b[6] = \<const0> ;
  assign bram_addr_b[5] = \<const0> ;
  assign bram_addr_b[4] = \<const0> ;
  assign bram_addr_b[3] = \<const0> ;
  assign bram_addr_b[2] = \<const0> ;
  assign bram_addr_b[1] = \<const0> ;
  assign bram_addr_b[0] = \<const0> ;
  assign bram_clk_a = s_axi_aclk;
  assign bram_clk_b = \<const0> ;
  assign bram_en_b = \<const0> ;
  assign bram_rst_b = \<const0> ;
  assign bram_we_b[3] = \<const0> ;
  assign bram_we_b[2] = \<const0> ;
  assign bram_we_b[1] = \<const0> ;
  assign bram_we_b[0] = \<const0> ;
  assign bram_wrdata_b[31] = \<const0> ;
  assign bram_wrdata_b[30] = \<const0> ;
  assign bram_wrdata_b[29] = \<const0> ;
  assign bram_wrdata_b[28] = \<const0> ;
  assign bram_wrdata_b[27] = \<const0> ;
  assign bram_wrdata_b[26] = \<const0> ;
  assign bram_wrdata_b[25] = \<const0> ;
  assign bram_wrdata_b[24] = \<const0> ;
  assign bram_wrdata_b[23] = \<const0> ;
  assign bram_wrdata_b[22] = \<const0> ;
  assign bram_wrdata_b[21] = \<const0> ;
  assign bram_wrdata_b[20] = \<const0> ;
  assign bram_wrdata_b[19] = \<const0> ;
  assign bram_wrdata_b[18] = \<const0> ;
  assign bram_wrdata_b[17] = \<const0> ;
  assign bram_wrdata_b[16] = \<const0> ;
  assign bram_wrdata_b[15] = \<const0> ;
  assign bram_wrdata_b[14] = \<const0> ;
  assign bram_wrdata_b[13] = \<const0> ;
  assign bram_wrdata_b[12] = \<const0> ;
  assign bram_wrdata_b[11] = \<const0> ;
  assign bram_wrdata_b[10] = \<const0> ;
  assign bram_wrdata_b[9] = \<const0> ;
  assign bram_wrdata_b[8] = \<const0> ;
  assign bram_wrdata_b[7] = \<const0> ;
  assign bram_wrdata_b[6] = \<const0> ;
  assign bram_wrdata_b[5] = \<const0> ;
  assign bram_wrdata_b[4] = \<const0> ;
  assign bram_wrdata_b[3] = \<const0> ;
  assign bram_wrdata_b[2] = \<const0> ;
  assign bram_wrdata_b[1] = \<const0> ;
  assign bram_wrdata_b[0] = \<const0> ;
  assign ecc_interrupt = \<const0> ;
  assign ecc_ue = \<const0> ;
  assign s_axi_bid[0] = \<const0> ;
  assign s_axi_bresp[1] = \<const0> ;
  assign s_axi_bresp[0] = \<const0> ;
  assign s_axi_ctrl_arready = \<const0> ;
  assign s_axi_ctrl_awready = \<const0> ;
  assign s_axi_ctrl_bresp[1] = \<const0> ;
  assign s_axi_ctrl_bresp[0] = \<const0> ;
  assign s_axi_ctrl_bvalid = \<const0> ;
  assign s_axi_ctrl_rdata[31] = \<const0> ;
  assign s_axi_ctrl_rdata[30] = \<const0> ;
  assign s_axi_ctrl_rdata[29] = \<const0> ;
  assign s_axi_ctrl_rdata[28] = \<const0> ;
  assign s_axi_ctrl_rdata[27] = \<const0> ;
  assign s_axi_ctrl_rdata[26] = \<const0> ;
  assign s_axi_ctrl_rdata[25] = \<const0> ;
  assign s_axi_ctrl_rdata[24] = \<const0> ;
  assign s_axi_ctrl_rdata[23] = \<const0> ;
  assign s_axi_ctrl_rdata[22] = \<const0> ;
  assign s_axi_ctrl_rdata[21] = \<const0> ;
  assign s_axi_ctrl_rdata[20] = \<const0> ;
  assign s_axi_ctrl_rdata[19] = \<const0> ;
  assign s_axi_ctrl_rdata[18] = \<const0> ;
  assign s_axi_ctrl_rdata[17] = \<const0> ;
  assign s_axi_ctrl_rdata[16] = \<const0> ;
  assign s_axi_ctrl_rdata[15] = \<const0> ;
  assign s_axi_ctrl_rdata[14] = \<const0> ;
  assign s_axi_ctrl_rdata[13] = \<const0> ;
  assign s_axi_ctrl_rdata[12] = \<const0> ;
  assign s_axi_ctrl_rdata[11] = \<const0> ;
  assign s_axi_ctrl_rdata[10] = \<const0> ;
  assign s_axi_ctrl_rdata[9] = \<const0> ;
  assign s_axi_ctrl_rdata[8] = \<const0> ;
  assign s_axi_ctrl_rdata[7] = \<const0> ;
  assign s_axi_ctrl_rdata[6] = \<const0> ;
  assign s_axi_ctrl_rdata[5] = \<const0> ;
  assign s_axi_ctrl_rdata[4] = \<const0> ;
  assign s_axi_ctrl_rdata[3] = \<const0> ;
  assign s_axi_ctrl_rdata[2] = \<const0> ;
  assign s_axi_ctrl_rdata[1] = \<const0> ;
  assign s_axi_ctrl_rdata[0] = \<const0> ;
  assign s_axi_ctrl_rresp[1] = \<const0> ;
  assign s_axi_ctrl_rresp[0] = \<const0> ;
  assign s_axi_ctrl_rvalid = \<const0> ;
  assign s_axi_ctrl_wready = \<const0> ;
  assign s_axi_rid[0] = \<const0> ;
  assign s_axi_rresp[1] = \<const0> ;
  assign s_axi_rresp[0] = \<const0> ;
  GND GND
       (.G(\<const0> ));
  decalper_eb_ot_sdeen_pot_pi_dehcac_xnilix_axi_bram_ctrl_top \gext_inst.abcv4_0_ext_inst 
       (.\GEN_NO_RD_CMD_OPT.axi_rlast_int_reg (s_axi_rlast),
        .\GEN_NO_RD_CMD_OPT.axi_rvalid_int_reg (s_axi_rvalid),
        .Q(\^bram_addr_a ),
        .axi_bvalid_int_reg(s_axi_bvalid),
        .bram_en_a(bram_en_a),
        .bram_rddata_a(bram_rddata_a),
        .bram_rst_a(bram_rst_a),
        .bram_we_a(bram_we_a),
        .bram_wrdata_a(bram_wrdata_a),
        .s_axi_aclk(s_axi_aclk),
        .s_axi_araddr(s_axi_araddr),
        .s_axi_arburst(s_axi_arburst),
        .s_axi_aresetn(s_axi_aresetn),
        .s_axi_arlen(s_axi_arlen),
        .s_axi_arready(s_axi_arready),
        .s_axi_arsize(s_axi_arsize),
        .s_axi_arvalid(s_axi_arvalid),
        .s_axi_awaddr(s_axi_awaddr),
        .s_axi_awburst(s_axi_awburst),
        .s_axi_awlen(s_axi_awlen),
        .s_axi_awready(s_axi_awready),
        .s_axi_awsize(s_axi_awsize),
        .s_axi_awvalid(s_axi_awvalid),
        .s_axi_bready(s_axi_bready),
        .s_axi_rdata(s_axi_rdata),
        .s_axi_rready(s_axi_rready),
        .s_axi_wdata(s_axi_wdata),
        .s_axi_wlast(s_axi_wlast),
        .s_axi_wready(s_axi_wready),
        .s_axi_wstrb(s_axi_wstrb),
        .s_axi_wvalid(s_axi_wvalid));
endmodule

module decalper_eb_ot_sdeen_pot_pi_dehcac_xnilix_axi_bram_ctrl_top
   (\GEN_NO_RD_CMD_OPT.axi_rlast_int_reg ,
    Q,
    bram_rst_a,
    s_axi_awready,
    s_axi_arready,
    bram_wrdata_a,
    s_axi_rdata,
    axi_bvalid_int_reg,
    s_axi_wready,
    \GEN_NO_RD_CMD_OPT.axi_rvalid_int_reg ,
    bram_we_a,
    bram_en_a,
    s_axi_wvalid,
    s_axi_aresetn,
    s_axi_awsize,
    s_axi_awaddr,
    s_axi_awlen,
    s_axi_awvalid,
    s_axi_arsize,
    s_axi_rready,
    s_axi_aclk,
    s_axi_arvalid,
    s_axi_wstrb,
    s_axi_wdata,
    bram_rddata_a,
    s_axi_arburst,
    s_axi_wlast,
    s_axi_bready,
    s_axi_araddr,
    s_axi_awburst,
    s_axi_arlen);
  output \GEN_NO_RD_CMD_OPT.axi_rlast_int_reg ;
  output [15:0]Q;
  output bram_rst_a;
  output s_axi_awready;
  output s_axi_arready;
  output [31:0]bram_wrdata_a;
  output [31:0]s_axi_rdata;
  output axi_bvalid_int_reg;
  output s_axi_wready;
  output \GEN_NO_RD_CMD_OPT.axi_rvalid_int_reg ;
  output [3:0]bram_we_a;
  output bram_en_a;
  input s_axi_wvalid;
  input s_axi_aresetn;
  input [2:0]s_axi_awsize;
  input [17:0]s_axi_awaddr;
  input [7:0]s_axi_awlen;
  input s_axi_awvalid;
  input [2:0]s_axi_arsize;
  input s_axi_rready;
  input s_axi_aclk;
  input s_axi_arvalid;
  input [3:0]s_axi_wstrb;
  input [31:0]s_axi_wdata;
  input [31:0]bram_rddata_a;
  input [1:0]s_axi_arburst;
  input s_axi_wlast;
  input s_axi_bready;
  input [17:0]s_axi_araddr;
  input [1:0]s_axi_awburst;
  input [7:0]s_axi_arlen;

  wire \GEN_NO_RD_CMD_OPT.axi_rlast_int_reg ;
  wire \GEN_NO_RD_CMD_OPT.axi_rvalid_int_reg ;
  wire [15:0]Q;
  wire axi_bvalid_int_reg;
  wire bram_en_a;
  wire [31:0]bram_rddata_a;
  wire bram_rst_a;
  wire [3:0]bram_we_a;
  wire [31:0]bram_wrdata_a;
  wire s_axi_aclk;
  wire [17:0]s_axi_araddr;
  wire [1:0]s_axi_arburst;
  wire s_axi_aresetn;
  wire [7:0]s_axi_arlen;
  wire s_axi_arready;
  wire [2:0]s_axi_arsize;
  wire s_axi_arvalid;
  wire [17:0]s_axi_awaddr;
  wire [1:0]s_axi_awburst;
  wire [7:0]s_axi_awlen;
  wire s_axi_awready;
  wire [2:0]s_axi_awsize;
  wire s_axi_awvalid;
  wire s_axi_bready;
  wire [31:0]s_axi_rdata;
  wire s_axi_rready;
  wire [31:0]s_axi_wdata;
  wire s_axi_wlast;
  wire s_axi_wready;
  wire [3:0]s_axi_wstrb;
  wire s_axi_wvalid;

  decalper_eb_ot_sdeen_pot_pi_dehcac_xnilix_full_axi \GEN_AXI4.I_FULL_AXI 
       (.BRAM_Addr_A(Q),
        .\GEN_NO_RD_CMD_OPT.axi_rlast_int_reg (\GEN_NO_RD_CMD_OPT.axi_rlast_int_reg ),
        .\GEN_NO_RD_CMD_OPT.axi_rvalid_int_reg (\GEN_NO_RD_CMD_OPT.axi_rvalid_int_reg ),
        .SR(bram_rst_a),
        .axi_bvalid_int_reg(axi_bvalid_int_reg),
        .bram_en_a(bram_en_a),
        .bram_rddata_a(bram_rddata_a),
        .bram_we_a(bram_we_a),
        .bram_wrdata_a(bram_wrdata_a),
        .s_axi_aclk(s_axi_aclk),
        .s_axi_araddr(s_axi_araddr),
        .s_axi_arburst(s_axi_arburst),
        .s_axi_aresetn(s_axi_aresetn),
        .s_axi_arlen(s_axi_arlen),
        .s_axi_arready(s_axi_arready),
        .s_axi_arsize(s_axi_arsize),
        .s_axi_arvalid(s_axi_arvalid),
        .s_axi_awaddr(s_axi_awaddr),
        .s_axi_awburst(s_axi_awburst),
        .s_axi_awlen(s_axi_awlen),
        .s_axi_awready(s_axi_awready),
        .s_axi_awsize(s_axi_awsize),
        .s_axi_awvalid(s_axi_awvalid),
        .s_axi_bready(s_axi_bready),
        .s_axi_rdata(s_axi_rdata),
        .s_axi_rready(s_axi_rready),
        .s_axi_wdata(s_axi_wdata),
        .s_axi_wlast(s_axi_wlast),
        .s_axi_wready(s_axi_wready),
        .s_axi_wstrb(s_axi_wstrb),
        .s_axi_wvalid(s_axi_wvalid));
endmodule

module decalper_eb_ot_sdeen_pot_pi_dehcac_xnilix_full_axi
   (\GEN_NO_RD_CMD_OPT.axi_rlast_int_reg ,
    BRAM_Addr_A,
    SR,
    s_axi_awready,
    s_axi_arready,
    bram_wrdata_a,
    s_axi_rdata,
    axi_bvalid_int_reg,
    s_axi_wready,
    \GEN_NO_RD_CMD_OPT.axi_rvalid_int_reg ,
    bram_we_a,
    bram_en_a,
    s_axi_wvalid,
    s_axi_aresetn,
    s_axi_awsize,
    s_axi_awaddr,
    s_axi_awlen,
    s_axi_awvalid,
    s_axi_arsize,
    s_axi_rready,
    s_axi_aclk,
    s_axi_arvalid,
    s_axi_wstrb,
    s_axi_wdata,
    bram_rddata_a,
    s_axi_arburst,
    s_axi_wlast,
    s_axi_bready,
    s_axi_araddr,
    s_axi_awburst,
    s_axi_arlen);
  output \GEN_NO_RD_CMD_OPT.axi_rlast_int_reg ;
  output [15:0]BRAM_Addr_A;
  output [0:0]SR;
  output s_axi_awready;
  output s_axi_arready;
  output [31:0]bram_wrdata_a;
  output [31:0]s_axi_rdata;
  output axi_bvalid_int_reg;
  output s_axi_wready;
  output \GEN_NO_RD_CMD_OPT.axi_rvalid_int_reg ;
  output [3:0]bram_we_a;
  output bram_en_a;
  input s_axi_wvalid;
  input s_axi_aresetn;
  input [2:0]s_axi_awsize;
  input [17:0]s_axi_awaddr;
  input [7:0]s_axi_awlen;
  input s_axi_awvalid;
  input [2:0]s_axi_arsize;
  input s_axi_rready;
  input s_axi_aclk;
  input s_axi_arvalid;
  input [3:0]s_axi_wstrb;
  input [31:0]s_axi_wdata;
  input [31:0]bram_rddata_a;
  input [1:0]s_axi_arburst;
  input s_axi_wlast;
  input s_axi_bready;
  input [17:0]s_axi_araddr;
  input [1:0]s_axi_awburst;
  input [7:0]s_axi_arlen;

  wire \ADDR_SNG_PORT.bram_addr_int[10]_i_2_n_0 ;
  wire \ADDR_SNG_PORT.bram_addr_int[11]_i_5_n_0 ;
  wire \ADDR_SNG_PORT.bram_addr_int[4]_i_2_n_0 ;
  wire \ADDR_SNG_PORT.bram_addr_int[5]_i_2_n_0 ;
  wire \ADDR_SNG_PORT.bram_addr_int[7]_i_2_n_0 ;
  wire \ADDR_SNG_PORT.bram_addr_int[8]_i_2_n_0 ;
  wire \ADDR_SNG_PORT.bram_addr_int[9]_i_2_n_0 ;
  wire AW2Arb_Active_Clr;
  wire Arb2AR_Active;
  wire Arb2AW_Active;
  wire [15:0]BRAM_Addr_A;
  wire BRAM_En_B_i;
  wire [3:0]BRAM_WE_A_i;
  wire \GEN_ARB.I_SNG_PORT_n_11 ;
  wire \GEN_ARB.I_SNG_PORT_n_12 ;
  wire \GEN_ARB.I_SNG_PORT_n_13 ;
  wire \GEN_ARB.I_SNG_PORT_n_14 ;
  wire \GEN_ARB.I_SNG_PORT_n_17 ;
  wire \GEN_ARB.I_SNG_PORT_n_9 ;
  wire \GEN_NO_RD_CMD_OPT.axi_rlast_int_reg ;
  wire \GEN_NO_RD_CMD_OPT.axi_rvalid_int_reg ;
  wire I_RD_CHNL_n_37;
  wire I_RD_CHNL_n_38;
  wire I_RD_CHNL_n_40;
  wire I_RD_CHNL_n_51;
  wire I_RD_CHNL_n_58;
  wire I_RD_CHNL_n_59;
  wire I_RD_CHNL_n_60;
  wire I_RD_CHNL_n_61;
  wire I_WR_CHNL_n_1;
  wire I_WR_CHNL_n_36;
  wire I_WR_CHNL_n_38;
  wire I_WR_CHNL_n_45;
  wire I_WR_CHNL_n_46;
  wire I_WR_CHNL_n_47;
  wire I_WR_CHNL_n_48;
  wire I_WR_CHNL_n_55;
  wire I_WR_CHNL_n_56;
  wire I_WR_CHNL_n_57;
  wire I_WR_CHNL_n_58;
  wire [17:12]RdChnl_BRAM_Addr_Ld;
  wire [0:0]SR;
  wire [11:6]WrChnl_BRAM_Addr_Ld;
  wire ar_active_d1;
  wire ar_active_i_1_n_0;
  wire ar_active_re;
  wire [1:0]arb_sm_cs;
  wire aw_active_d1;
  wire aw_active_i_1_n_0;
  wire aw_active_re;
  wire axi_arready_cmb;
  wire axi_awready_cmb;
  wire axi_bvalid_int_reg;
  wire bram_en_a;
  wire [31:0]bram_rddata_a;
  wire [3:0]bram_we_a;
  wire [31:0]bram_wrdata_a;
  wire curr_narrow_burst_en;
  wire last_arb_won;
  wire last_arb_won_cmb;
  wire last_arb_won_i_1_n_0;
  wire [15:0]p_1_in;
  wire s_axi_aclk;
  wire [17:0]s_axi_araddr;
  wire [1:0]s_axi_arburst;
  wire s_axi_aresetn;
  wire [7:0]s_axi_arlen;
  wire s_axi_arready;
  wire [2:0]s_axi_arsize;
  wire s_axi_arvalid;
  wire [17:0]s_axi_awaddr;
  wire [1:0]s_axi_awburst;
  wire [7:0]s_axi_awlen;
  wire s_axi_awready;
  wire [2:0]s_axi_awsize;
  wire s_axi_awvalid;
  wire s_axi_bready;
  wire [31:0]s_axi_rdata;
  wire s_axi_rready;
  wire [31:0]s_axi_wdata;
  wire s_axi_wlast;
  wire s_axi_wready;
  wire [3:0]s_axi_wstrb;
  wire s_axi_wvalid;
  wire sng_bram_addr_ld_en;

  (* SOFT_HLUTNM = "soft_lutpair47" *) 
  LUT5 #(
    .INIT(32'h08000000)) 
    \ADDR_SNG_PORT.bram_addr_int[10]_i_2 
       (.I0(BRAM_Addr_A[7]),
        .I1(BRAM_Addr_A[5]),
        .I2(I_RD_CHNL_n_51),
        .I3(BRAM_Addr_A[4]),
        .I4(BRAM_Addr_A[6]),
        .O(\ADDR_SNG_PORT.bram_addr_int[10]_i_2_n_0 ));
  LUT6 #(
    .INIT(64'h0080000000000000)) 
    \ADDR_SNG_PORT.bram_addr_int[11]_i_5 
       (.I0(BRAM_Addr_A[8]),
        .I1(BRAM_Addr_A[6]),
        .I2(BRAM_Addr_A[4]),
        .I3(I_RD_CHNL_n_51),
        .I4(BRAM_Addr_A[5]),
        .I5(BRAM_Addr_A[7]),
        .O(\ADDR_SNG_PORT.bram_addr_int[11]_i_5_n_0 ));
  LUT2 #(
    .INIT(4'h8)) 
    \ADDR_SNG_PORT.bram_addr_int[4]_i_2 
       (.I0(BRAM_Addr_A[0]),
        .I1(BRAM_Addr_A[1]),
        .O(\ADDR_SNG_PORT.bram_addr_int[4]_i_2_n_0 ));
  (* SOFT_HLUTNM = "soft_lutpair48" *) 
  LUT3 #(
    .INIT(8'h7F)) 
    \ADDR_SNG_PORT.bram_addr_int[5]_i_2 
       (.I0(BRAM_Addr_A[2]),
        .I1(BRAM_Addr_A[1]),
        .I2(BRAM_Addr_A[0]),
        .O(\ADDR_SNG_PORT.bram_addr_int[5]_i_2_n_0 ));
  (* SOFT_HLUTNM = "soft_lutpair48" *) 
  LUT5 #(
    .INIT(32'h80000000)) 
    \ADDR_SNG_PORT.bram_addr_int[7]_i_2 
       (.I0(BRAM_Addr_A[4]),
        .I1(BRAM_Addr_A[3]),
        .I2(BRAM_Addr_A[2]),
        .I3(BRAM_Addr_A[1]),
        .I4(BRAM_Addr_A[0]),
        .O(\ADDR_SNG_PORT.bram_addr_int[7]_i_2_n_0 ));
  LUT6 #(
    .INIT(64'h8000000000000000)) 
    \ADDR_SNG_PORT.bram_addr_int[8]_i_2 
       (.I0(BRAM_Addr_A[5]),
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
        .\GEN_NARROW_EN.curr_narrow_burst_reg_0 (I_WR_CHNL_n_56),
        .\GEN_NO_RD_CMD_OPT.GEN_AR_SNG.ar_active_d1_reg (\GEN_NO_RD_CMD_OPT.axi_rlast_int_reg ),
        .\GEN_NO_RD_CMD_OPT.GEN_NARROW_CNT.narrow_addr_int[1]_i_4_0 (I_RD_CHNL_n_37),
        .\GEN_NO_RD_CMD_OPT.GEN_NARROW_CNT.narrow_addr_int_reg[1] (I_RD_CHNL_n_38),
        .\GEN_NO_RD_CMD_OPT.GEN_NARROW_CNT.narrow_addr_int_reg[1]_0 (I_RD_CHNL_n_60),
        .\GEN_NO_RD_CMD_OPT.GEN_NARROW_CNT.narrow_addr_int_reg[1]_1 (I_RD_CHNL_n_61),
        .\GEN_NO_RD_CMD_OPT.act_rd_burst_two_reg (I_RD_CHNL_n_58),
        .\GEN_NO_RD_CMD_OPT.axi_rlast_int_reg (\GEN_ARB.I_SNG_PORT_n_13 ),
        .Q(arb_sm_cs),
        .SR(SR),
        .ar_active_d1(ar_active_d1),
        .ar_active_re(ar_active_re),
        .ar_active_reg_0(\GEN_ARB.I_SNG_PORT_n_12 ),
        .ar_active_reg_1(ar_active_i_1_n_0),
        .aw_active_d1(aw_active_d1),
        .aw_active_reg_0(aw_active_i_1_n_0),
        .axi_arready_cmb(axi_arready_cmb),
        .axi_awready_cmb(axi_awready_cmb),
        .axi_awready_int_reg_0(I_RD_CHNL_n_59),
        .axi_awready_int_reg_1(I_WR_CHNL_n_58),
        .bram_we_a(bram_we_a),
        .\bram_we_a[3] (BRAM_WE_A_i),
        .curr_narrow_burst_en(curr_narrow_burst_en),
        .last_arb_won(last_arb_won),
        .last_arb_won_reg_0(\GEN_ARB.I_SNG_PORT_n_17 ),
        .last_arb_won_reg_1(last_arb_won_i_1_n_0),
        .s_axi_aclk(s_axi_aclk),
        .s_axi_araddr(s_axi_araddr[1:0]),
        .s_axi_arburst(s_axi_arburst),
        .s_axi_arburst_0_sp_1(\GEN_ARB.I_SNG_PORT_n_9 ),
        .s_axi_aresetn(s_axi_aresetn),
        .s_axi_arlen(s_axi_arlen[7:4]),
        .\s_axi_arlen[6] (\GEN_ARB.I_SNG_PORT_n_11 ),
        .s_axi_arready(s_axi_arready),
        .s_axi_arvalid(s_axi_arvalid),
        .s_axi_awburst(s_axi_awburst),
        .s_axi_awready(s_axi_awready),
        .s_axi_awvalid(s_axi_awvalid),
        .s_axi_rready(s_axi_rready));
  decalper_eb_ot_sdeen_pot_pi_dehcac_xnilix_rd_chnl I_RD_CHNL
       (.\ADDR_SNG_PORT.bram_addr_int_reg[10] (\ADDR_SNG_PORT.bram_addr_int[10]_i_2_n_0 ),
        .\ADDR_SNG_PORT.bram_addr_int_reg[11] (WrChnl_BRAM_Addr_Ld),
        .\ADDR_SNG_PORT.bram_addr_int_reg[11]_0 (\ADDR_SNG_PORT.bram_addr_int[11]_i_5_n_0 ),
        .\ADDR_SNG_PORT.bram_addr_int_reg[11]_1 (I_WR_CHNL_n_38),
        .\ADDR_SNG_PORT.bram_addr_int_reg[2] (I_RD_CHNL_n_51),
        .\ADDR_SNG_PORT.bram_addr_int_reg[2]_0 (I_WR_CHNL_n_36),
        .\ADDR_SNG_PORT.bram_addr_int_reg[2]_1 (I_WR_CHNL_n_45),
        .\ADDR_SNG_PORT.bram_addr_int_reg[3] (I_WR_CHNL_n_46),
        .\ADDR_SNG_PORT.bram_addr_int_reg[4] (\ADDR_SNG_PORT.bram_addr_int[4]_i_2_n_0 ),
        .\ADDR_SNG_PORT.bram_addr_int_reg[4]_0 (I_WR_CHNL_n_47),
        .\ADDR_SNG_PORT.bram_addr_int_reg[5] (\ADDR_SNG_PORT.bram_addr_int[5]_i_2_n_0 ),
        .\ADDR_SNG_PORT.bram_addr_int_reg[5]_0 (I_WR_CHNL_n_48),
        .\ADDR_SNG_PORT.bram_addr_int_reg[7] (\ADDR_SNG_PORT.bram_addr_int[7]_i_2_n_0 ),
        .\ADDR_SNG_PORT.bram_addr_int_reg[8] (\ADDR_SNG_PORT.bram_addr_int[8]_i_2_n_0 ),
        .\ADDR_SNG_PORT.bram_addr_int_reg[9] (\ADDR_SNG_PORT.bram_addr_int[9]_i_2_n_0 ),
        .Arb2AR_Active(Arb2AR_Active),
        .BRAM_En_B_i(BRAM_En_B_i),
        .D(p_1_in[9:0]),
        .E({sng_bram_addr_ld_en,I_RD_CHNL_n_40}),
        .\GEN_NO_RD_CMD_OPT.GEN_AR_SNG.ar_active_d1_reg_0 (\GEN_ARB.I_SNG_PORT_n_12 ),
        .\GEN_NO_RD_CMD_OPT.GEN_NARROW_CNT.narrow_addr_int_reg[1]_0 (\GEN_ARB.I_SNG_PORT_n_9 ),
        .\GEN_NO_RD_CMD_OPT.act_rd_burst_two_reg_0 (\GEN_ARB.I_SNG_PORT_n_11 ),
        .\GEN_NO_RD_CMD_OPT.axi_rlast_int_reg_0 (\GEN_NO_RD_CMD_OPT.axi_rlast_int_reg ),
        .\GEN_NO_RD_CMD_OPT.axi_rvalid_int_reg_0 (\GEN_NO_RD_CMD_OPT.axi_rvalid_int_reg ),
        .Q(BRAM_Addr_A[9:0]),
        .SR(SR),
        .ar_active_d1(ar_active_d1),
        .ar_active_re(ar_active_re),
        .bram_rddata_a(bram_rddata_a),
        .s_axi_aclk(s_axi_aclk),
        .s_axi_araddr(s_axi_araddr),
        .s_axi_arburst(s_axi_arburst),
        .s_axi_aresetn(s_axi_aresetn),
        .s_axi_arlen(s_axi_arlen),
        .s_axi_arlen_2_sp_1(I_RD_CHNL_n_58),
        .s_axi_arsize(s_axi_arsize),
        .\s_axi_arsize[1]_0 (I_RD_CHNL_n_61),
        .\s_axi_arsize[2]_0 (I_RD_CHNL_n_60),
        .s_axi_arsize_1_sp_1(I_RD_CHNL_n_38),
        .s_axi_arsize_2_sp_1(I_RD_CHNL_n_37),
        .s_axi_awaddr(s_axi_awaddr[2]),
        .s_axi_rdata(s_axi_rdata),
        .s_axi_rready(s_axi_rready),
        .s_axi_rready_0(I_RD_CHNL_n_59),
        .\save_init_bram_addr_ld_reg[17] (RdChnl_BRAM_Addr_Ld));
  decalper_eb_ot_sdeen_pot_pi_dehcac_xnilix_wr_chnl I_WR_CHNL
       (.\ADDR_SNG_PORT.bram_addr_int_reg[17] (RdChnl_BRAM_Addr_Ld),
        .Arb2AR_Active(Arb2AR_Active),
        .Arb2AW_Active(Arb2AW_Active),
        .BRAM_En_B_i(BRAM_En_B_i),
        .D(WrChnl_BRAM_Addr_Ld),
        .E(aw_active_re),
        .\FSM_onehot_GEN_WDATA_SM_NO_ECC_SNG_REG_WREADY.wr_data_sng_sm_cs_reg[2]_0 (I_WR_CHNL_n_1),
        .\GEN_NARROW_CNT.narrow_bram_addr_inc_d1_reg_0 (I_WR_CHNL_n_38),
        .\GEN_WR_NO_ECC.bram_we_int_reg[3]_0 (BRAM_WE_A_i),
        .Q(AW2Arb_Active_Clr),
        .SR(SR),
        .ar_active_reg(p_1_in[15:10]),
        .aw_active_d1(aw_active_d1),
        .aw_active_d1_reg_0(I_WR_CHNL_n_45),
        .axi_bvalid_int_reg_0(axi_bvalid_int_reg),
        .bram_en_a(bram_en_a),
        .bram_wrdata_a(bram_wrdata_a),
        .\bvalid_cnt_reg[1]_0 (I_WR_CHNL_n_57),
        .curr_narrow_burst_en(curr_narrow_burst_en),
        .last_arb_won_reg(arb_sm_cs),
        .s_axi_aclk(s_axi_aclk),
        .s_axi_aresetn(s_axi_aresetn),
        .s_axi_awaddr({s_axi_awaddr[17:3],s_axi_awaddr[1:0]}),
        .s_axi_awaddr_3_sp_1(I_WR_CHNL_n_46),
        .s_axi_awaddr_4_sp_1(I_WR_CHNL_n_47),
        .s_axi_awaddr_5_sp_1(I_WR_CHNL_n_48),
        .s_axi_awburst(s_axi_awburst),
        .s_axi_awlen(s_axi_awlen),
        .s_axi_awlen_0_sp_1(I_WR_CHNL_n_56),
        .s_axi_awlen_3_sp_1(I_WR_CHNL_n_55),
        .s_axi_awsize(s_axi_awsize),
        .s_axi_awvalid(s_axi_awvalid),
        .s_axi_awvalid_0(I_WR_CHNL_n_58),
        .s_axi_bready(s_axi_bready),
        .s_axi_wdata(s_axi_wdata),
        .s_axi_wlast(s_axi_wlast),
        .s_axi_wready(s_axi_wready),
        .s_axi_wstrb(s_axi_wstrb),
        .s_axi_wvalid(s_axi_wvalid),
        .s_axi_wvalid_0(I_WR_CHNL_n_36),
        .\save_init_bram_addr_ld[17]_i_3 (BRAM_Addr_A[2:0]),
        .\save_init_bram_addr_ld_reg[6] (I_RD_CHNL_n_51));
  LUT5 #(
    .INIT(32'hABBBA888)) 
    ar_active_i_1
       (.I0(last_arb_won_cmb),
        .I1(\GEN_ARB.I_SNG_PORT_n_17 ),
        .I2(\GEN_ARB.I_SNG_PORT_n_14 ),
        .I3(s_axi_arvalid),
        .I4(Arb2AR_Active),
        .O(ar_active_i_1_n_0));
  LUT6 #(
    .INIT(64'h0A0ACFFF0A0A0000)) 
    aw_active_i_1
       (.I0(I_WR_CHNL_n_58),
        .I1(arb_sm_cs[1]),
        .I2(arb_sm_cs[0]),
        .I3(AW2Arb_Active_Clr),
        .I4(axi_awready_cmb),
        .I5(Arb2AW_Active),
        .O(aw_active_i_1_n_0));
  LUT6 #(
    .INIT(64'hAAAAABBBAAAAA888)) 
    last_arb_won_i_1
       (.I0(last_arb_won_cmb),
        .I1(axi_arready_cmb),
        .I2(I_WR_CHNL_n_58),
        .I3(\GEN_ARB.I_SNG_PORT_n_13 ),
        .I4(I_WR_CHNL_n_57),
        .I5(last_arb_won),
        .O(last_arb_won_i_1_n_0));
endmodule

module decalper_eb_ot_sdeen_pot_pi_dehcac_xnilix_rd_chnl
   (SR,
    s_axi_rdata,
    ar_active_d1,
    \GEN_NO_RD_CMD_OPT.axi_rvalid_int_reg_0 ,
    \GEN_NO_RD_CMD_OPT.axi_rlast_int_reg_0 ,
    BRAM_En_B_i,
    s_axi_arsize_2_sp_1,
    s_axi_arsize_1_sp_1,
    E,
    D,
    \ADDR_SNG_PORT.bram_addr_int_reg[2] ,
    \save_init_bram_addr_ld_reg[17] ,
    s_axi_arlen_2_sp_1,
    s_axi_rready_0,
    \s_axi_arsize[2]_0 ,
    \s_axi_arsize[1]_0 ,
    s_axi_aclk,
    ar_active_re,
    \GEN_NO_RD_CMD_OPT.GEN_AR_SNG.ar_active_d1_reg_0 ,
    Arb2AR_Active,
    s_axi_aresetn,
    s_axi_arsize,
    s_axi_rready,
    \ADDR_SNG_PORT.bram_addr_int_reg[2]_0 ,
    Q,
    s_axi_arburst,
    \GEN_NO_RD_CMD_OPT.act_rd_burst_two_reg_0 ,
    \ADDR_SNG_PORT.bram_addr_int_reg[11] ,
    \ADDR_SNG_PORT.bram_addr_int_reg[7] ,
    \ADDR_SNG_PORT.bram_addr_int_reg[8] ,
    \ADDR_SNG_PORT.bram_addr_int_reg[9] ,
    \ADDR_SNG_PORT.bram_addr_int_reg[10] ,
    \ADDR_SNG_PORT.bram_addr_int_reg[3] ,
    \ADDR_SNG_PORT.bram_addr_int_reg[4] ,
    \ADDR_SNG_PORT.bram_addr_int_reg[4]_0 ,
    \ADDR_SNG_PORT.bram_addr_int_reg[5] ,
    \ADDR_SNG_PORT.bram_addr_int_reg[5]_0 ,
    \ADDR_SNG_PORT.bram_addr_int_reg[11]_0 ,
    \ADDR_SNG_PORT.bram_addr_int_reg[11]_1 ,
    s_axi_araddr,
    s_axi_awaddr,
    \ADDR_SNG_PORT.bram_addr_int_reg[2]_1 ,
    \GEN_NO_RD_CMD_OPT.GEN_NARROW_CNT.narrow_addr_int_reg[1]_0 ,
    s_axi_arlen,
    bram_rddata_a);
  output [0:0]SR;
  output [31:0]s_axi_rdata;
  output ar_active_d1;
  output \GEN_NO_RD_CMD_OPT.axi_rvalid_int_reg_0 ;
  output \GEN_NO_RD_CMD_OPT.axi_rlast_int_reg_0 ;
  output BRAM_En_B_i;
  output s_axi_arsize_2_sp_1;
  output s_axi_arsize_1_sp_1;
  output [1:0]E;
  output [9:0]D;
  output \ADDR_SNG_PORT.bram_addr_int_reg[2] ;
  output [5:0]\save_init_bram_addr_ld_reg[17] ;
  output s_axi_arlen_2_sp_1;
  output s_axi_rready_0;
  output \s_axi_arsize[2]_0 ;
  output \s_axi_arsize[1]_0 ;
  input s_axi_aclk;
  input ar_active_re;
  input \GEN_NO_RD_CMD_OPT.GEN_AR_SNG.ar_active_d1_reg_0 ;
  input Arb2AR_Active;
  input s_axi_aresetn;
  input [2:0]s_axi_arsize;
  input s_axi_rready;
  input \ADDR_SNG_PORT.bram_addr_int_reg[2]_0 ;
  input [9:0]Q;
  input [1:0]s_axi_arburst;
  input \GEN_NO_RD_CMD_OPT.act_rd_burst_two_reg_0 ;
  input [5:0]\ADDR_SNG_PORT.bram_addr_int_reg[11] ;
  input \ADDR_SNG_PORT.bram_addr_int_reg[7] ;
  input \ADDR_SNG_PORT.bram_addr_int_reg[8] ;
  input \ADDR_SNG_PORT.bram_addr_int_reg[9] ;
  input \ADDR_SNG_PORT.bram_addr_int_reg[10] ;
  input \ADDR_SNG_PORT.bram_addr_int_reg[3] ;
  input \ADDR_SNG_PORT.bram_addr_int_reg[4] ;
  input \ADDR_SNG_PORT.bram_addr_int_reg[4]_0 ;
  input \ADDR_SNG_PORT.bram_addr_int_reg[5] ;
  input \ADDR_SNG_PORT.bram_addr_int_reg[5]_0 ;
  input \ADDR_SNG_PORT.bram_addr_int_reg[11]_0 ;
  input \ADDR_SNG_PORT.bram_addr_int_reg[11]_1 ;
  input [17:0]s_axi_araddr;
  input [0:0]s_axi_awaddr;
  input \ADDR_SNG_PORT.bram_addr_int_reg[2]_1 ;
  input \GEN_NO_RD_CMD_OPT.GEN_NARROW_CNT.narrow_addr_int_reg[1]_0 ;
  input [7:0]s_axi_arlen;
  input [31:0]bram_rddata_a;

  wire \ADDR_SNG_PORT.bram_addr_int[11]_i_4_n_0 ;
  wire \ADDR_SNG_PORT.bram_addr_int_reg[10] ;
  wire [5:0]\ADDR_SNG_PORT.bram_addr_int_reg[11] ;
  wire \ADDR_SNG_PORT.bram_addr_int_reg[11]_0 ;
  wire \ADDR_SNG_PORT.bram_addr_int_reg[11]_1 ;
  wire \ADDR_SNG_PORT.bram_addr_int_reg[2] ;
  wire \ADDR_SNG_PORT.bram_addr_int_reg[2]_0 ;
  wire \ADDR_SNG_PORT.bram_addr_int_reg[2]_1 ;
  wire \ADDR_SNG_PORT.bram_addr_int_reg[3] ;
  wire \ADDR_SNG_PORT.bram_addr_int_reg[4] ;
  wire \ADDR_SNG_PORT.bram_addr_int_reg[4]_0 ;
  wire \ADDR_SNG_PORT.bram_addr_int_reg[5] ;
  wire \ADDR_SNG_PORT.bram_addr_int_reg[5]_0 ;
  wire \ADDR_SNG_PORT.bram_addr_int_reg[7] ;
  wire \ADDR_SNG_PORT.bram_addr_int_reg[8] ;
  wire \ADDR_SNG_PORT.bram_addr_int_reg[9] ;
  wire Arb2AR_Active;
  wire BRAM_En_B_i;
  wire [9:0]D;
  wire [1:0]E;
  wire \FSM_sequential_GEN_NO_RD_CMD_OPT.rd_data_sm_cs[0]_i_2_n_0 ;
  wire \FSM_sequential_GEN_NO_RD_CMD_OPT.rd_data_sm_cs[0]_i_3_n_0 ;
  wire \FSM_sequential_GEN_NO_RD_CMD_OPT.rd_data_sm_cs[0]_i_4_n_0 ;
  wire \FSM_sequential_GEN_NO_RD_CMD_OPT.rd_data_sm_cs[1]_i_1_n_0 ;
  wire \FSM_sequential_GEN_NO_RD_CMD_OPT.rd_data_sm_cs[1]_i_2_n_0 ;
  wire \FSM_sequential_GEN_NO_RD_CMD_OPT.rd_data_sm_cs[2]_i_1_n_0 ;
  wire \FSM_sequential_GEN_NO_RD_CMD_OPT.rd_data_sm_cs[2]_i_2_n_0 ;
  wire \FSM_sequential_GEN_NO_RD_CMD_OPT.rd_data_sm_cs[3]_i_1_n_0 ;
  wire \FSM_sequential_GEN_NO_RD_CMD_OPT.rd_data_sm_cs[3]_i_3_n_0 ;
  wire \FSM_sequential_GEN_NO_RD_CMD_OPT.rd_data_sm_cs[3]_i_4_n_0 ;
  wire \FSM_sequential_GEN_NO_RD_CMD_OPT.rd_data_sm_cs[3]_i_5_n_0 ;
  wire \FSM_sequential_GEN_NO_RD_CMD_OPT.rlast_sm_cs[1]_i_2_n_0 ;
  wire \FSM_sequential_GEN_NO_RD_CMD_OPT.rlast_sm_cs[2]_i_1_n_0 ;
  wire \GEN_NO_RD_CMD_OPT.GEN_AR_SNG.ar_active_d1_reg_0 ;
  wire \GEN_NO_RD_CMD_OPT.GEN_BRST_MAX_W_NARROW.brst_cnt_max_i_1_n_0 ;
  wire \GEN_NO_RD_CMD_OPT.GEN_BRST_MAX_W_NARROW.brst_cnt_max_i_2_n_0 ;
  wire \GEN_NO_RD_CMD_OPT.GEN_BRST_MAX_W_NARROW.brst_cnt_max_reg_n_0 ;
  wire \GEN_NO_RD_CMD_OPT.GEN_NARROW_CNT.narrow_addr_int[1]_i_11_n_0 ;
  wire \GEN_NO_RD_CMD_OPT.GEN_NARROW_CNT.narrow_addr_int[1]_i_12_n_0 ;
  wire \GEN_NO_RD_CMD_OPT.GEN_NARROW_CNT.narrow_addr_int[1]_i_13_n_0 ;
  wire \GEN_NO_RD_CMD_OPT.GEN_NARROW_CNT.narrow_addr_int[1]_i_14_n_0 ;
  wire \GEN_NO_RD_CMD_OPT.GEN_NARROW_CNT.narrow_addr_int[1]_i_15_n_0 ;
  wire \GEN_NO_RD_CMD_OPT.GEN_NARROW_CNT.narrow_addr_int[1]_i_16_n_0 ;
  wire \GEN_NO_RD_CMD_OPT.GEN_NARROW_CNT.narrow_addr_int[1]_i_17_n_0 ;
  wire \GEN_NO_RD_CMD_OPT.GEN_NARROW_CNT.narrow_addr_int[1]_i_18_n_0 ;
  wire \GEN_NO_RD_CMD_OPT.GEN_NARROW_CNT.narrow_addr_int[1]_i_1_n_0 ;
  wire \GEN_NO_RD_CMD_OPT.GEN_NARROW_CNT.narrow_addr_int[1]_i_3_n_0 ;
  wire \GEN_NO_RD_CMD_OPT.GEN_NARROW_CNT.narrow_addr_int[1]_i_6_n_0 ;
  wire \GEN_NO_RD_CMD_OPT.GEN_NARROW_CNT.narrow_addr_int_reg[1]_0 ;
  wire \GEN_NO_RD_CMD_OPT.GEN_NARROW_CNT_LD.narrow_burst_cnt_ld_reg_reg_n_0_[0] ;
  wire \GEN_NO_RD_CMD_OPT.GEN_NARROW_CNT_LD.narrow_burst_cnt_ld_reg_reg_n_0_[1] ;
  wire \GEN_NO_RD_CMD_OPT.GEN_NARROW_EN.curr_narrow_burst_i_1_n_0 ;
  wire \GEN_NO_RD_CMD_OPT.GEN_NARROW_EN.curr_narrow_burst_i_2_n_0 ;
  wire \GEN_NO_RD_CMD_OPT.GEN_RDATA_NO_ECC.GEN_RDATA_NO_RL_NO_ECC.GEN_RDATA[0].axi_rdata_int[0]_i_1_n_0 ;
  wire \GEN_NO_RD_CMD_OPT.GEN_RDATA_NO_ECC.GEN_RDATA_NO_RL_NO_ECC.GEN_RDATA[10].axi_rdata_int[10]_i_1_n_0 ;
  wire \GEN_NO_RD_CMD_OPT.GEN_RDATA_NO_ECC.GEN_RDATA_NO_RL_NO_ECC.GEN_RDATA[11].axi_rdata_int[11]_i_1_n_0 ;
  wire \GEN_NO_RD_CMD_OPT.GEN_RDATA_NO_ECC.GEN_RDATA_NO_RL_NO_ECC.GEN_RDATA[12].axi_rdata_int[12]_i_1_n_0 ;
  wire \GEN_NO_RD_CMD_OPT.GEN_RDATA_NO_ECC.GEN_RDATA_NO_RL_NO_ECC.GEN_RDATA[13].axi_rdata_int[13]_i_1_n_0 ;
  wire \GEN_NO_RD_CMD_OPT.GEN_RDATA_NO_ECC.GEN_RDATA_NO_RL_NO_ECC.GEN_RDATA[14].axi_rdata_int[14]_i_1_n_0 ;
  wire \GEN_NO_RD_CMD_OPT.GEN_RDATA_NO_ECC.GEN_RDATA_NO_RL_NO_ECC.GEN_RDATA[15].axi_rdata_int[15]_i_1_n_0 ;
  wire \GEN_NO_RD_CMD_OPT.GEN_RDATA_NO_ECC.GEN_RDATA_NO_RL_NO_ECC.GEN_RDATA[16].axi_rdata_int[16]_i_1_n_0 ;
  wire \GEN_NO_RD_CMD_OPT.GEN_RDATA_NO_ECC.GEN_RDATA_NO_RL_NO_ECC.GEN_RDATA[17].axi_rdata_int[17]_i_1_n_0 ;
  wire \GEN_NO_RD_CMD_OPT.GEN_RDATA_NO_ECC.GEN_RDATA_NO_RL_NO_ECC.GEN_RDATA[18].axi_rdata_int[18]_i_1_n_0 ;
  wire \GEN_NO_RD_CMD_OPT.GEN_RDATA_NO_ECC.GEN_RDATA_NO_RL_NO_ECC.GEN_RDATA[19].axi_rdata_int[19]_i_1_n_0 ;
  wire \GEN_NO_RD_CMD_OPT.GEN_RDATA_NO_ECC.GEN_RDATA_NO_RL_NO_ECC.GEN_RDATA[20].axi_rdata_int[20]_i_1_n_0 ;
  wire \GEN_NO_RD_CMD_OPT.GEN_RDATA_NO_ECC.GEN_RDATA_NO_RL_NO_ECC.GEN_RDATA[21].axi_rdata_int[21]_i_1_n_0 ;
  wire \GEN_NO_RD_CMD_OPT.GEN_RDATA_NO_ECC.GEN_RDATA_NO_RL_NO_ECC.GEN_RDATA[22].axi_rdata_int[22]_i_1_n_0 ;
  wire \GEN_NO_RD_CMD_OPT.GEN_RDATA_NO_ECC.GEN_RDATA_NO_RL_NO_ECC.GEN_RDATA[23].axi_rdata_int[23]_i_1_n_0 ;
  wire \GEN_NO_RD_CMD_OPT.GEN_RDATA_NO_ECC.GEN_RDATA_NO_RL_NO_ECC.GEN_RDATA[24].axi_rdata_int[24]_i_1_n_0 ;
  wire \GEN_NO_RD_CMD_OPT.GEN_RDATA_NO_ECC.GEN_RDATA_NO_RL_NO_ECC.GEN_RDATA[25].axi_rdata_int[25]_i_1_n_0 ;
  wire \GEN_NO_RD_CMD_OPT.GEN_RDATA_NO_ECC.GEN_RDATA_NO_RL_NO_ECC.GEN_RDATA[26].axi_rdata_int[26]_i_1_n_0 ;
  wire \GEN_NO_RD_CMD_OPT.GEN_RDATA_NO_ECC.GEN_RDATA_NO_RL_NO_ECC.GEN_RDATA[27].axi_rdata_int[27]_i_1_n_0 ;
  wire \GEN_NO_RD_CMD_OPT.GEN_RDATA_NO_ECC.GEN_RDATA_NO_RL_NO_ECC.GEN_RDATA[28].axi_rdata_int[28]_i_1_n_0 ;
  wire \GEN_NO_RD_CMD_OPT.GEN_RDATA_NO_ECC.GEN_RDATA_NO_RL_NO_ECC.GEN_RDATA[29].axi_rdata_int[29]_i_1_n_0 ;
  wire \GEN_NO_RD_CMD_OPT.GEN_RDATA_NO_ECC.GEN_RDATA_NO_RL_NO_ECC.GEN_RDATA[2].axi_rdata_int[2]_i_1_n_0 ;
  wire \GEN_NO_RD_CMD_OPT.GEN_RDATA_NO_ECC.GEN_RDATA_NO_RL_NO_ECC.GEN_RDATA[30].axi_rdata_int[30]_i_1_n_0 ;
  wire \GEN_NO_RD_CMD_OPT.GEN_RDATA_NO_ECC.GEN_RDATA_NO_RL_NO_ECC.GEN_RDATA[31].axi_rdata_int[31]_i_1_n_0 ;
  wire \GEN_NO_RD_CMD_OPT.GEN_RDATA_NO_ECC.GEN_RDATA_NO_RL_NO_ECC.GEN_RDATA[31].axi_rdata_int[31]_i_3_n_0 ;
  wire \GEN_NO_RD_CMD_OPT.GEN_RDATA_NO_ECC.GEN_RDATA_NO_RL_NO_ECC.GEN_RDATA[31].axi_rdata_int[31]_i_4_n_0 ;
  wire \GEN_NO_RD_CMD_OPT.GEN_RDATA_NO_ECC.GEN_RDATA_NO_RL_NO_ECC.GEN_RDATA[31].axi_rdata_int[31]_i_5_n_0 ;
  wire \GEN_NO_RD_CMD_OPT.GEN_RDATA_NO_ECC.GEN_RDATA_NO_RL_NO_ECC.GEN_RDATA[3].axi_rdata_int[3]_i_1_n_0 ;
  wire \GEN_NO_RD_CMD_OPT.GEN_RDATA_NO_ECC.GEN_RDATA_NO_RL_NO_ECC.GEN_RDATA[4].axi_rdata_int[4]_i_1_n_0 ;
  wire \GEN_NO_RD_CMD_OPT.GEN_RDATA_NO_ECC.GEN_RDATA_NO_RL_NO_ECC.GEN_RDATA[5].axi_rdata_int[5]_i_1_n_0 ;
  wire \GEN_NO_RD_CMD_OPT.GEN_RDATA_NO_ECC.GEN_RDATA_NO_RL_NO_ECC.GEN_RDATA[6].axi_rdata_int[6]_i_1_n_0 ;
  wire \GEN_NO_RD_CMD_OPT.GEN_RDATA_NO_ECC.GEN_RDATA_NO_RL_NO_ECC.GEN_RDATA[7].axi_rdata_int[7]_i_1_n_0 ;
  wire \GEN_NO_RD_CMD_OPT.GEN_RDATA_NO_ECC.GEN_RDATA_NO_RL_NO_ECC.GEN_RDATA[8].axi_rdata_int[8]_i_1_n_0 ;
  wire \GEN_NO_RD_CMD_OPT.GEN_RDATA_NO_ECC.GEN_RDATA_NO_RL_NO_ECC.GEN_RDATA[9].axi_rdata_int[9]_i_1_n_0 ;
  wire \GEN_NO_RD_CMD_OPT.GEN_RD_BURST_NORL.axi_rd_burst_i_1_n_0 ;
  wire \GEN_NO_RD_CMD_OPT.GEN_RD_BURST_NORL.axi_rd_burst_i_3_n_0 ;
  wire \GEN_NO_RD_CMD_OPT.GEN_RD_BURST_NORL.axi_rd_burst_two_i_2_n_0 ;
  wire \GEN_NO_RD_CMD_OPT.GEN_RD_BURST_NORL.axi_rd_burst_two_reg_n_0 ;
  wire \GEN_NO_RD_CMD_OPT.GEN_UA_NARROW.I_UA_NARROW_n_0 ;
  wire \GEN_NO_RD_CMD_OPT.GEN_UA_NARROW.I_UA_NARROW_n_1 ;
  wire \GEN_NO_RD_CMD_OPT.I_WRAP_BRST_n_20 ;
  wire \GEN_NO_RD_CMD_OPT.I_WRAP_BRST_n_21 ;
  wire \GEN_NO_RD_CMD_OPT.act_rd_burst_i_1_n_0 ;
  wire \GEN_NO_RD_CMD_OPT.act_rd_burst_i_3_n_0 ;
  wire \GEN_NO_RD_CMD_OPT.act_rd_burst_i_4_n_0 ;
  wire \GEN_NO_RD_CMD_OPT.act_rd_burst_two_i_1_n_0 ;
  wire \GEN_NO_RD_CMD_OPT.act_rd_burst_two_reg_0 ;
  wire \GEN_NO_RD_CMD_OPT.axi_rlast_int_i_1_n_0 ;
  wire \GEN_NO_RD_CMD_OPT.axi_rlast_int_i_2_n_0 ;
  wire \GEN_NO_RD_CMD_OPT.axi_rlast_int_i_3_n_0 ;
  wire \GEN_NO_RD_CMD_OPT.axi_rlast_int_reg_0 ;
  wire \GEN_NO_RD_CMD_OPT.axi_rvalid_clr_ok_i_1_n_0 ;
  wire \GEN_NO_RD_CMD_OPT.axi_rvalid_clr_ok_i_2_n_0 ;
  wire \GEN_NO_RD_CMD_OPT.axi_rvalid_int_i_1_n_0 ;
  wire \GEN_NO_RD_CMD_OPT.axi_rvalid_int_reg_0 ;
  wire \GEN_NO_RD_CMD_OPT.bram_en_int_i_1_n_0 ;
  wire \GEN_NO_RD_CMD_OPT.bram_en_int_i_2_n_0 ;
  wire \GEN_NO_RD_CMD_OPT.bram_en_int_i_3_n_0 ;
  wire \GEN_NO_RD_CMD_OPT.bram_en_int_i_4_n_0 ;
  wire \GEN_NO_RD_CMD_OPT.bram_en_int_i_5_n_0 ;
  wire \GEN_NO_RD_CMD_OPT.bram_en_int_i_6_n_0 ;
  wire \GEN_NO_RD_CMD_OPT.bram_en_int_i_7_n_0 ;
  wire \GEN_NO_RD_CMD_OPT.brst_cnt[5]_i_2_n_0 ;
  wire \GEN_NO_RD_CMD_OPT.brst_cnt[6]_i_2_n_0 ;
  wire \GEN_NO_RD_CMD_OPT.brst_cnt[6]_i_3_n_0 ;
  wire \GEN_NO_RD_CMD_OPT.brst_cnt[7]_i_1_n_0 ;
  wire \GEN_NO_RD_CMD_OPT.brst_cnt[7]_i_3_n_0 ;
  wire [7:0]\GEN_NO_RD_CMD_OPT.brst_cnt_reg ;
  wire \GEN_NO_RD_CMD_OPT.brst_one_i_1_n_0 ;
  wire \GEN_NO_RD_CMD_OPT.brst_one_i_2_n_0 ;
  wire \GEN_NO_RD_CMD_OPT.brst_zero_i_1_n_0 ;
  wire \GEN_NO_RD_CMD_OPT.disable_b2b_brst_i_2_n_0 ;
  wire \GEN_NO_RD_CMD_OPT.disable_b2b_brst_i_3_n_0 ;
  wire \GEN_NO_RD_CMD_OPT.end_brst_rd_clr_i_1_n_0 ;
  wire \GEN_NO_RD_CMD_OPT.end_brst_rd_i_1_n_0 ;
  wire \GEN_NO_RD_CMD_OPT.last_bram_addr_i_2_n_0 ;
  wire \GEN_NO_RD_CMD_OPT.last_bram_addr_i_3_n_0 ;
  wire \GEN_NO_RD_CMD_OPT.last_bram_addr_i_4_n_0 ;
  wire \GEN_NO_RD_CMD_OPT.last_bram_addr_i_5_n_0 ;
  wire \GEN_NO_RD_CMD_OPT.pend_rd_op_i_1_n_0 ;
  wire \GEN_NO_RD_CMD_OPT.pend_rd_op_i_2_n_0 ;
  wire \GEN_NO_RD_CMD_OPT.pend_rd_op_i_4_n_0 ;
  wire \GEN_NO_RD_CMD_OPT.pend_rd_op_i_5_n_0 ;
  wire \GEN_NO_RD_CMD_OPT.pend_rd_op_i_6_n_0 ;
  wire \GEN_NO_RD_CMD_OPT.pend_rd_op_reg_i_3_n_0 ;
  wire \GEN_NO_RD_CMD_OPT.rddata_mux_sel_i_1_n_0 ;
  wire \GEN_NO_RD_CMD_OPT.rddata_mux_sel_i_2_n_0 ;
  wire \GEN_NO_RD_CMD_OPT.rddata_mux_sel_i_3_n_0 ;
  wire [9:0]Q;
  wire [0:0]SR;
  wire act_rd_burst;
  wire act_rd_burst_set;
  wire act_rd_burst_two;
  wire ar_active_d1;
  wire ar_active_re;
  wire axi_rd_burst;
  wire axi_rd_burst0;
  wire axi_rd_burst_two;
  wire axi_rdata_en;
  wire axi_rvalid_clr_ok;
  wire axi_rvalid_set;
  wire axi_rvalid_set_cmb;
  wire [31:0]bram_rddata_a;
  wire brst_cnt_max_d1;
  wire brst_one;
  wire brst_zero;
  wire curr_fixed_burst;
  wire curr_fixed_burst_reg;
  wire curr_narrow_burst;
  wire curr_wrap_burst;
  wire curr_wrap_burst_reg;
  wire disable_b2b_brst;
  wire disable_b2b_brst_cmb;
  wire end_brst_rd;
  wire end_brst_rd_clr;
  wire last_bram_addr;
  wire last_bram_addr0;
  wire [1:0]narrow_addr_int;
  wire narrow_bram_addr_inc;
  wire narrow_bram_addr_inc_d1;
  wire [1:0]narrow_burst_cnt_ld_reg;
  wire [7:0]p_0_in;
  wire p_0_in__0;
  wire pend_rd_op;
  wire [3:0]rd_data_sm_cs;
  wire [3:0]rd_data_sm_ns;
  wire [31:0]rd_skid_buf;
  wire rd_skid_buf_ld;
  wire rd_skid_buf_ld_cmb;
  wire rd_skid_buf_ld_reg;
  wire rddata_mux_sel;
  wire [2:0]rlast_sm_cs;
  wire [2:0]rlast_sm_ns;
  wire s_axi_aclk;
  wire [17:0]s_axi_araddr;
  wire [1:0]s_axi_arburst;
  wire s_axi_aresetn;
  wire [7:0]s_axi_arlen;
  wire s_axi_arlen_2_sn_1;
  wire [2:0]s_axi_arsize;
  wire \s_axi_arsize[1]_0 ;
  wire \s_axi_arsize[2]_0 ;
  wire s_axi_arsize_1_sn_1;
  wire s_axi_arsize_2_sn_1;
  wire [0:0]s_axi_awaddr;
  wire [31:0]s_axi_rdata;
  wire s_axi_rready;
  wire s_axi_rready_0;
  wire [5:0]\save_init_bram_addr_ld_reg[17] ;

  assign s_axi_arlen_2_sp_1 = s_axi_arlen_2_sn_1;
  assign s_axi_arsize_1_sp_1 = s_axi_arsize_1_sn_1;
  assign s_axi_arsize_2_sp_1 = s_axi_arsize_2_sn_1;
  (* SOFT_HLUTNM = "soft_lutpair6" *) 
  LUT5 #(
    .INIT(32'h000100FF)) 
    \ADDR_SNG_PORT.bram_addr_int[11]_i_4 
       (.I0(narrow_addr_int[1]),
        .I1(narrow_addr_int[0]),
        .I2(narrow_bram_addr_inc_d1),
        .I3(\GEN_NO_RD_CMD_OPT.I_WRAP_BRST_n_20 ),
        .I4(curr_narrow_burst),
        .O(\ADDR_SNG_PORT.bram_addr_int[11]_i_4_n_0 ));
  LUT6 #(
    .INIT(64'h0000000E0F5F0F5F)) 
    \FSM_sequential_GEN_NO_RD_CMD_OPT.rd_data_sm_cs[0]_i_1 
       (.I0(rd_data_sm_cs[2]),
        .I1(\FSM_sequential_GEN_NO_RD_CMD_OPT.rd_data_sm_cs[0]_i_2_n_0 ),
        .I2(rd_data_sm_cs[3]),
        .I3(rd_data_sm_cs[1]),
        .I4(\FSM_sequential_GEN_NO_RD_CMD_OPT.rd_data_sm_cs[0]_i_3_n_0 ),
        .I5(\FSM_sequential_GEN_NO_RD_CMD_OPT.rd_data_sm_cs[0]_i_4_n_0 ),
        .O(rd_data_sm_ns[0]));
  LUT2 #(
    .INIT(4'h1)) 
    \FSM_sequential_GEN_NO_RD_CMD_OPT.rd_data_sm_cs[0]_i_2 
       (.I0(axi_rd_burst),
        .I1(\GEN_NO_RD_CMD_OPT.GEN_RD_BURST_NORL.axi_rd_burst_two_reg_n_0 ),
        .O(\FSM_sequential_GEN_NO_RD_CMD_OPT.rd_data_sm_cs[0]_i_2_n_0 ));
  LUT6 #(
    .INIT(64'hF700F700F7000000)) 
    \FSM_sequential_GEN_NO_RD_CMD_OPT.rd_data_sm_cs[0]_i_3 
       (.I0(\GEN_NO_RD_CMD_OPT.axi_rvalid_int_reg_0 ),
        .I1(s_axi_rready),
        .I2(ar_active_re),
        .I3(rd_data_sm_cs[2]),
        .I4(act_rd_burst_two),
        .I5(act_rd_burst),
        .O(\FSM_sequential_GEN_NO_RD_CMD_OPT.rd_data_sm_cs[0]_i_3_n_0 ));
  LUT6 #(
    .INIT(64'hBBBFBBBB00000000)) 
    \FSM_sequential_GEN_NO_RD_CMD_OPT.rd_data_sm_cs[0]_i_4 
       (.I0(\GEN_NO_RD_CMD_OPT.GEN_RDATA_NO_ECC.GEN_RDATA_NO_RL_NO_ECC.GEN_RDATA[31].axi_rdata_int[31]_i_5_n_0 ),
        .I1(rd_data_sm_cs[1]),
        .I2(pend_rd_op),
        .I3(ar_active_re),
        .I4(rd_data_sm_cs[2]),
        .I5(rd_data_sm_cs[0]),
        .O(\FSM_sequential_GEN_NO_RD_CMD_OPT.rd_data_sm_cs[0]_i_4_n_0 ));
  LUT6 #(
    .INIT(64'h4445444444444444)) 
    \FSM_sequential_GEN_NO_RD_CMD_OPT.rd_data_sm_cs[1]_i_1 
       (.I0(rd_data_sm_cs[3]),
        .I1(\FSM_sequential_GEN_NO_RD_CMD_OPT.rd_data_sm_cs[1]_i_2_n_0 ),
        .I2(\FSM_sequential_GEN_NO_RD_CMD_OPT.rd_data_sm_cs[3]_i_4_n_0 ),
        .I3(rd_data_sm_cs[1]),
        .I4(rd_data_sm_cs[0]),
        .I5(rd_data_sm_cs[2]),
        .O(\FSM_sequential_GEN_NO_RD_CMD_OPT.rd_data_sm_cs[1]_i_1_n_0 ));
  LUT6 #(
    .INIT(64'h30300C3C33330838)) 
    \FSM_sequential_GEN_NO_RD_CMD_OPT.rd_data_sm_cs[1]_i_2 
       (.I0(axi_rd_burst),
        .I1(rd_data_sm_cs[0]),
        .I2(rd_data_sm_cs[2]),
        .I3(\FSM_sequential_GEN_NO_RD_CMD_OPT.rd_data_sm_cs[3]_i_5_n_0 ),
        .I4(rd_data_sm_cs[1]),
        .I5(\GEN_NO_RD_CMD_OPT.GEN_RD_BURST_NORL.axi_rd_burst_two_reg_n_0 ),
        .O(\FSM_sequential_GEN_NO_RD_CMD_OPT.rd_data_sm_cs[1]_i_2_n_0 ));
  LUT6 #(
    .INIT(64'h4445444444444444)) 
    \FSM_sequential_GEN_NO_RD_CMD_OPT.rd_data_sm_cs[2]_i_1 
       (.I0(rd_data_sm_cs[3]),
        .I1(\FSM_sequential_GEN_NO_RD_CMD_OPT.rd_data_sm_cs[2]_i_2_n_0 ),
        .I2(\FSM_sequential_GEN_NO_RD_CMD_OPT.rd_data_sm_cs[3]_i_4_n_0 ),
        .I3(rd_data_sm_cs[1]),
        .I4(rd_data_sm_cs[0]),
        .I5(rd_data_sm_cs[2]),
        .O(\FSM_sequential_GEN_NO_RD_CMD_OPT.rd_data_sm_cs[2]_i_1_n_0 ));
  LUT6 #(
    .INIT(64'h3F303C343F003C04)) 
    \FSM_sequential_GEN_NO_RD_CMD_OPT.rd_data_sm_cs[2]_i_2 
       (.I0(axi_rd_burst),
        .I1(rd_data_sm_cs[0]),
        .I2(rd_data_sm_cs[2]),
        .I3(rd_data_sm_cs[1]),
        .I4(\GEN_NO_RD_CMD_OPT.GEN_RD_BURST_NORL.axi_rd_burst_two_reg_n_0 ),
        .I5(\FSM_sequential_GEN_NO_RD_CMD_OPT.rd_data_sm_cs[3]_i_5_n_0 ),
        .O(\FSM_sequential_GEN_NO_RD_CMD_OPT.rd_data_sm_cs[2]_i_2_n_0 ));
  LUT6 #(
    .INIT(64'h0000000355FF5555)) 
    \FSM_sequential_GEN_NO_RD_CMD_OPT.rd_data_sm_cs[3]_i_1 
       (.I0(\FSM_sequential_GEN_NO_RD_CMD_OPT.rd_data_sm_cs[3]_i_3_n_0 ),
        .I1(rd_data_sm_cs[1]),
        .I2(rd_data_sm_cs[0]),
        .I3(\GEN_NO_RD_CMD_OPT.GEN_RDATA_NO_ECC.GEN_RDATA_NO_RL_NO_ECC.GEN_RDATA[31].axi_rdata_int[31]_i_5_n_0 ),
        .I4(rd_data_sm_cs[2]),
        .I5(rd_data_sm_cs[3]),
        .O(\FSM_sequential_GEN_NO_RD_CMD_OPT.rd_data_sm_cs[3]_i_1_n_0 ));
  LUT6 #(
    .INIT(64'h0C08000000080000)) 
    \FSM_sequential_GEN_NO_RD_CMD_OPT.rd_data_sm_cs[3]_i_2 
       (.I0(\FSM_sequential_GEN_NO_RD_CMD_OPT.rd_data_sm_cs[3]_i_4_n_0 ),
        .I1(rd_data_sm_cs[2]),
        .I2(rd_data_sm_cs[3]),
        .I3(rd_data_sm_cs[1]),
        .I4(rd_data_sm_cs[0]),
        .I5(\GEN_NO_RD_CMD_OPT.GEN_RDATA_NO_ECC.GEN_RDATA_NO_RL_NO_ECC.GEN_RDATA[31].axi_rdata_int[31]_i_5_n_0 ),
        .O(rd_data_sm_ns[3]));
  LUT6 #(
    .INIT(64'h0FFF110000FF000F)) 
    \FSM_sequential_GEN_NO_RD_CMD_OPT.rd_data_sm_cs[3]_i_3 
       (.I0(\FSM_sequential_GEN_NO_RD_CMD_OPT.rd_data_sm_cs[3]_i_5_n_0 ),
        .I1(\GEN_NO_RD_CMD_OPT.GEN_RDATA_NO_ECC.GEN_RDATA_NO_RL_NO_ECC.GEN_RDATA[31].axi_rdata_int[31]_i_5_n_0 ),
        .I2(ar_active_re),
        .I3(rd_data_sm_cs[0]),
        .I4(rd_data_sm_cs[2]),
        .I5(rd_data_sm_cs[1]),
        .O(\FSM_sequential_GEN_NO_RD_CMD_OPT.rd_data_sm_cs[3]_i_3_n_0 ));
  LUT6 #(
    .INIT(64'h4440000000000000)) 
    \FSM_sequential_GEN_NO_RD_CMD_OPT.rd_data_sm_cs[3]_i_4 
       (.I0(ar_active_d1),
        .I1(Arb2AR_Active),
        .I2(act_rd_burst_two),
        .I3(act_rd_burst),
        .I4(\GEN_NO_RD_CMD_OPT.axi_rvalid_int_reg_0 ),
        .I5(s_axi_rready),
        .O(\FSM_sequential_GEN_NO_RD_CMD_OPT.rd_data_sm_cs[3]_i_4_n_0 ));
  LUT2 #(
    .INIT(4'hE)) 
    \FSM_sequential_GEN_NO_RD_CMD_OPT.rd_data_sm_cs[3]_i_5 
       (.I0(brst_zero),
        .I1(end_brst_rd),
        .O(\FSM_sequential_GEN_NO_RD_CMD_OPT.rd_data_sm_cs[3]_i_5_n_0 ));
  (* FSM_ENCODED_STATES = "sec_addr:0010,sng_addr:0001,last_data_ar_pend:1000,idle:0000,last_addr:0101,last_data:0111,full_throttle:0100,last_throttle:0110,full_pipe:0011" *) 
  FDRE \FSM_sequential_GEN_NO_RD_CMD_OPT.rd_data_sm_cs_reg[0] 
       (.C(s_axi_aclk),
        .CE(\FSM_sequential_GEN_NO_RD_CMD_OPT.rd_data_sm_cs[3]_i_1_n_0 ),
        .D(rd_data_sm_ns[0]),
        .Q(rd_data_sm_cs[0]),
        .R(SR));
  (* FSM_ENCODED_STATES = "sec_addr:0010,sng_addr:0001,last_data_ar_pend:1000,idle:0000,last_addr:0101,last_data:0111,full_throttle:0100,last_throttle:0110,full_pipe:0011" *) 
  FDRE \FSM_sequential_GEN_NO_RD_CMD_OPT.rd_data_sm_cs_reg[1] 
       (.C(s_axi_aclk),
        .CE(\FSM_sequential_GEN_NO_RD_CMD_OPT.rd_data_sm_cs[3]_i_1_n_0 ),
        .D(\FSM_sequential_GEN_NO_RD_CMD_OPT.rd_data_sm_cs[1]_i_1_n_0 ),
        .Q(rd_data_sm_cs[1]),
        .R(SR));
  (* FSM_ENCODED_STATES = "sec_addr:0010,sng_addr:0001,last_data_ar_pend:1000,idle:0000,last_addr:0101,last_data:0111,full_throttle:0100,last_throttle:0110,full_pipe:0011" *) 
  FDRE \FSM_sequential_GEN_NO_RD_CMD_OPT.rd_data_sm_cs_reg[2] 
       (.C(s_axi_aclk),
        .CE(\FSM_sequential_GEN_NO_RD_CMD_OPT.rd_data_sm_cs[3]_i_1_n_0 ),
        .D(\FSM_sequential_GEN_NO_RD_CMD_OPT.rd_data_sm_cs[2]_i_1_n_0 ),
        .Q(rd_data_sm_cs[2]),
        .R(SR));
  (* FSM_ENCODED_STATES = "sec_addr:0010,sng_addr:0001,last_data_ar_pend:1000,idle:0000,last_addr:0101,last_data:0111,full_throttle:0100,last_throttle:0110,full_pipe:0011" *) 
  FDRE \FSM_sequential_GEN_NO_RD_CMD_OPT.rd_data_sm_cs_reg[3] 
       (.C(s_axi_aclk),
        .CE(\FSM_sequential_GEN_NO_RD_CMD_OPT.rd_data_sm_cs[3]_i_1_n_0 ),
        .D(rd_data_sm_ns[3]),
        .Q(rd_data_sm_cs[3]),
        .R(SR));
  LUT6 #(
    .INIT(64'hAAAAAAAAAA80AA88)) 
    \FSM_sequential_GEN_NO_RD_CMD_OPT.rlast_sm_cs[0]_i_1 
       (.I0(\FSM_sequential_GEN_NO_RD_CMD_OPT.rlast_sm_cs[1]_i_2_n_0 ),
        .I1(axi_rd_burst),
        .I2(act_rd_burst_two),
        .I3(\GEN_NO_RD_CMD_OPT.GEN_RD_BURST_NORL.axi_rd_burst_two_reg_n_0 ),
        .I4(\GEN_NO_RD_CMD_OPT.GEN_RDATA_NO_ECC.GEN_RDATA_NO_RL_NO_ECC.GEN_RDATA[31].axi_rdata_int[31]_i_5_n_0 ),
        .I5(rlast_sm_cs[1]),
        .O(rlast_sm_ns[0]));
  LUT6 #(
    .INIT(64'hAAAAAAAA0008AA88)) 
    \FSM_sequential_GEN_NO_RD_CMD_OPT.rlast_sm_cs[1]_i_1 
       (.I0(\FSM_sequential_GEN_NO_RD_CMD_OPT.rlast_sm_cs[1]_i_2_n_0 ),
        .I1(axi_rd_burst),
        .I2(act_rd_burst_two),
        .I3(\GEN_NO_RD_CMD_OPT.GEN_RD_BURST_NORL.axi_rd_burst_two_reg_n_0 ),
        .I4(\GEN_NO_RD_CMD_OPT.GEN_RDATA_NO_ECC.GEN_RDATA_NO_RL_NO_ECC.GEN_RDATA[31].axi_rdata_int[31]_i_5_n_0 ),
        .I5(rlast_sm_cs[1]),
        .O(rlast_sm_ns[1]));
  (* SOFT_HLUTNM = "soft_lutpair9" *) 
  LUT2 #(
    .INIT(4'h1)) 
    \FSM_sequential_GEN_NO_RD_CMD_OPT.rlast_sm_cs[1]_i_2 
       (.I0(rlast_sm_cs[2]),
        .I1(rlast_sm_cs[0]),
        .O(\FSM_sequential_GEN_NO_RD_CMD_OPT.rlast_sm_cs[1]_i_2_n_0 ));
  LUT6 #(
    .INIT(64'h0F3E000200020002)) 
    \FSM_sequential_GEN_NO_RD_CMD_OPT.rlast_sm_cs[2]_i_1 
       (.I0(last_bram_addr),
        .I1(rlast_sm_cs[0]),
        .I2(rlast_sm_cs[2]),
        .I3(rlast_sm_cs[1]),
        .I4(s_axi_rready),
        .I5(\GEN_NO_RD_CMD_OPT.axi_rvalid_int_reg_0 ),
        .O(\FSM_sequential_GEN_NO_RD_CMD_OPT.rlast_sm_cs[2]_i_1_n_0 ));
  (* SOFT_HLUTNM = "soft_lutpair9" *) 
  LUT5 #(
    .INIT(32'h0F000001)) 
    \FSM_sequential_GEN_NO_RD_CMD_OPT.rlast_sm_cs[2]_i_2 
       (.I0(axi_rd_burst),
        .I1(\GEN_NO_RD_CMD_OPT.GEN_RD_BURST_NORL.axi_rd_burst_two_reg_n_0 ),
        .I2(rlast_sm_cs[2]),
        .I3(rlast_sm_cs[0]),
        .I4(rlast_sm_cs[1]),
        .O(rlast_sm_ns[2]));
  (* FSM_ENCODED_STATES = "idle:000,w8_last_data:100,w8_2nd_last_data:011,w8_throttle:010,w8_throttle_b2:001" *) 
  FDRE \FSM_sequential_GEN_NO_RD_CMD_OPT.rlast_sm_cs_reg[0] 
       (.C(s_axi_aclk),
        .CE(\FSM_sequential_GEN_NO_RD_CMD_OPT.rlast_sm_cs[2]_i_1_n_0 ),
        .D(rlast_sm_ns[0]),
        .Q(rlast_sm_cs[0]),
        .R(SR));
  (* FSM_ENCODED_STATES = "idle:000,w8_last_data:100,w8_2nd_last_data:011,w8_throttle:010,w8_throttle_b2:001" *) 
  FDRE \FSM_sequential_GEN_NO_RD_CMD_OPT.rlast_sm_cs_reg[1] 
       (.C(s_axi_aclk),
        .CE(\FSM_sequential_GEN_NO_RD_CMD_OPT.rlast_sm_cs[2]_i_1_n_0 ),
        .D(rlast_sm_ns[1]),
        .Q(rlast_sm_cs[1]),
        .R(SR));
  (* FSM_ENCODED_STATES = "idle:000,w8_last_data:100,w8_2nd_last_data:011,w8_throttle:010,w8_throttle_b2:001" *) 
  FDRE \FSM_sequential_GEN_NO_RD_CMD_OPT.rlast_sm_cs_reg[2] 
       (.C(s_axi_aclk),
        .CE(\FSM_sequential_GEN_NO_RD_CMD_OPT.rlast_sm_cs[2]_i_1_n_0 ),
        .D(rlast_sm_ns[2]),
        .Q(rlast_sm_cs[2]),
        .R(SR));
  FDRE #(
    .INIT(1'b0)) 
    \GEN_NO_RD_CMD_OPT.GEN_AR_SNG.ar_active_d1_reg 
       (.C(s_axi_aclk),
        .CE(1'b1),
        .D(\GEN_NO_RD_CMD_OPT.GEN_AR_SNG.ar_active_d1_reg_0 ),
        .Q(ar_active_d1),
        .R(1'b0));
  LUT5 #(
    .INIT(32'h00B00000)) 
    \GEN_NO_RD_CMD_OPT.GEN_BRST_MAX_W_NARROW.brst_cnt_max_i_1 
       (.I0(ar_active_d1),
        .I1(Arb2AR_Active),
        .I2(s_axi_aresetn),
        .I3(end_brst_rd_clr),
        .I4(\GEN_NO_RD_CMD_OPT.GEN_BRST_MAX_W_NARROW.brst_cnt_max_i_2_n_0 ),
        .O(\GEN_NO_RD_CMD_OPT.GEN_BRST_MAX_W_NARROW.brst_cnt_max_i_1_n_0 ));
  LUT6 #(
    .INIT(64'hFFFFFFFF00404040)) 
    \GEN_NO_RD_CMD_OPT.GEN_BRST_MAX_W_NARROW.brst_cnt_max_i_2 
       (.I0(pend_rd_op),
        .I1(brst_zero),
        .I2(Arb2AR_Active),
        .I3(curr_narrow_burst),
        .I4(\GEN_NO_RD_CMD_OPT.GEN_NARROW_CNT.narrow_addr_int[1]_i_6_n_0 ),
        .I5(\GEN_NO_RD_CMD_OPT.GEN_BRST_MAX_W_NARROW.brst_cnt_max_reg_n_0 ),
        .O(\GEN_NO_RD_CMD_OPT.GEN_BRST_MAX_W_NARROW.brst_cnt_max_i_2_n_0 ));
  FDRE #(
    .INIT(1'b0)) 
    \GEN_NO_RD_CMD_OPT.GEN_BRST_MAX_W_NARROW.brst_cnt_max_reg 
       (.C(s_axi_aclk),
        .CE(1'b1),
        .D(\GEN_NO_RD_CMD_OPT.GEN_BRST_MAX_W_NARROW.brst_cnt_max_i_1_n_0 ),
        .Q(\GEN_NO_RD_CMD_OPT.GEN_BRST_MAX_W_NARROW.brst_cnt_max_reg_n_0 ),
        .R(1'b0));
  LUT5 #(
    .INIT(32'h0F002F22)) 
    \GEN_NO_RD_CMD_OPT.GEN_NARROW_CNT.narrow_addr_int[1]_i_1 
       (.I0(Arb2AR_Active),
        .I1(ar_active_d1),
        .I2(\GEN_NO_RD_CMD_OPT.I_WRAP_BRST_n_20 ),
        .I3(curr_narrow_burst),
        .I4(s_axi_arsize_2_sn_1),
        .O(\GEN_NO_RD_CMD_OPT.GEN_NARROW_CNT.narrow_addr_int[1]_i_1_n_0 ));
  LUT6 #(
    .INIT(64'hFAFAFCFCCACAFC0C)) 
    \GEN_NO_RD_CMD_OPT.GEN_NARROW_CNT.narrow_addr_int[1]_i_11 
       (.I0(s_axi_arlen[2]),
        .I1(s_axi_arlen[1]),
        .I2(s_axi_arsize[0]),
        .I3(s_axi_arlen[0]),
        .I4(s_axi_arsize[1]),
        .I5(s_axi_arlen[3]),
        .O(\GEN_NO_RD_CMD_OPT.GEN_NARROW_CNT.narrow_addr_int[1]_i_11_n_0 ));
  LUT6 #(
    .INIT(64'hFACF0ACFFAC00AC0)) 
    \GEN_NO_RD_CMD_OPT.GEN_NARROW_CNT.narrow_addr_int[1]_i_12 
       (.I0(s_axi_arlen[7]),
        .I1(s_axi_arlen[6]),
        .I2(s_axi_arsize[1]),
        .I3(s_axi_arsize[0]),
        .I4(s_axi_arlen[5]),
        .I5(s_axi_arlen[4]),
        .O(\GEN_NO_RD_CMD_OPT.GEN_NARROW_CNT.narrow_addr_int[1]_i_12_n_0 ));
  LUT6 #(
    .INIT(64'hFACF0ACFFAC00AC0)) 
    \GEN_NO_RD_CMD_OPT.GEN_NARROW_CNT.narrow_addr_int[1]_i_13 
       (.I0(s_axi_arlen[3]),
        .I1(s_axi_arlen[2]),
        .I2(s_axi_arsize[1]),
        .I3(s_axi_arsize[0]),
        .I4(s_axi_arlen[1]),
        .I5(s_axi_arlen[0]),
        .O(\GEN_NO_RD_CMD_OPT.GEN_NARROW_CNT.narrow_addr_int[1]_i_13_n_0 ));
  LUT6 #(
    .INIT(64'hFCFFFCAACCAACCAA)) 
    \GEN_NO_RD_CMD_OPT.GEN_NARROW_CNT.narrow_addr_int[1]_i_14 
       (.I0(s_axi_arlen[3]),
        .I1(s_axi_arlen[2]),
        .I2(s_axi_arlen[0]),
        .I3(s_axi_arsize[0]),
        .I4(s_axi_arlen[1]),
        .I5(s_axi_arsize[1]),
        .O(\GEN_NO_RD_CMD_OPT.GEN_NARROW_CNT.narrow_addr_int[1]_i_14_n_0 ));
  LUT5 #(
    .INIT(32'h00E2E2E2)) 
    \GEN_NO_RD_CMD_OPT.GEN_NARROW_CNT.narrow_addr_int[1]_i_15 
       (.I0(s_axi_arlen[5]),
        .I1(s_axi_arsize[0]),
        .I2(s_axi_arlen[4]),
        .I3(s_axi_arsize[1]),
        .I4(s_axi_arsize[2]),
        .O(\GEN_NO_RD_CMD_OPT.GEN_NARROW_CNT.narrow_addr_int[1]_i_15_n_0 ));
  LUT6 #(
    .INIT(64'h00000005303F00F5)) 
    \GEN_NO_RD_CMD_OPT.GEN_NARROW_CNT.narrow_addr_int[1]_i_16 
       (.I0(s_axi_arlen[4]),
        .I1(s_axi_arlen[5]),
        .I2(s_axi_arsize[1]),
        .I3(s_axi_arlen[7]),
        .I4(s_axi_arsize[0]),
        .I5(s_axi_arlen[6]),
        .O(\GEN_NO_RD_CMD_OPT.GEN_NARROW_CNT.narrow_addr_int[1]_i_16_n_0 ));
  (* SOFT_HLUTNM = "soft_lutpair10" *) 
  LUT5 #(
    .INIT(32'hFFFACCFA)) 
    \GEN_NO_RD_CMD_OPT.GEN_NARROW_CNT.narrow_addr_int[1]_i_17 
       (.I0(s_axi_arlen[6]),
        .I1(s_axi_arlen[7]),
        .I2(s_axi_arlen[2]),
        .I3(s_axi_arsize[0]),
        .I4(s_axi_arlen[3]),
        .O(\GEN_NO_RD_CMD_OPT.GEN_NARROW_CNT.narrow_addr_int[1]_i_17_n_0 ));
  LUT6 #(
    .INIT(64'h5A5A4A4A5A504A40)) 
    \GEN_NO_RD_CMD_OPT.GEN_NARROW_CNT.narrow_addr_int[1]_i_18 
       (.I0(s_axi_arsize[1]),
        .I1(s_axi_arlen[1]),
        .I2(s_axi_arsize[0]),
        .I3(s_axi_arlen[0]),
        .I4(s_axi_arlen[5]),
        .I5(s_axi_arlen[4]),
        .O(\GEN_NO_RD_CMD_OPT.GEN_NARROW_CNT.narrow_addr_int[1]_i_18_n_0 ));
  LUT6 #(
    .INIT(64'h5575557555750000)) 
    \GEN_NO_RD_CMD_OPT.GEN_NARROW_CNT.narrow_addr_int[1]_i_3 
       (.I0(ar_active_re),
        .I1(s_axi_arsize[2]),
        .I2(s_axi_arsize[1]),
        .I3(s_axi_arsize[0]),
        .I4(\GEN_NO_RD_CMD_OPT.GEN_NARROW_CNT.narrow_addr_int[1]_i_6_n_0 ),
        .I5(narrow_bram_addr_inc_d1),
        .O(\GEN_NO_RD_CMD_OPT.GEN_NARROW_CNT.narrow_addr_int[1]_i_3_n_0 ));
  (* SOFT_HLUTNM = "soft_lutpair6" *) 
  LUT4 #(
    .INIT(16'hFFFD)) 
    \GEN_NO_RD_CMD_OPT.GEN_NARROW_CNT.narrow_addr_int[1]_i_6 
       (.I0(curr_narrow_burst),
        .I1(\GEN_NO_RD_CMD_OPT.I_WRAP_BRST_n_20 ),
        .I2(narrow_addr_int[1]),
        .I3(narrow_addr_int[0]),
        .O(\GEN_NO_RD_CMD_OPT.GEN_NARROW_CNT.narrow_addr_int[1]_i_6_n_0 ));
  LUT5 #(
    .INIT(32'h5455FFFF)) 
    \GEN_NO_RD_CMD_OPT.GEN_NARROW_CNT.narrow_addr_int[1]_i_7 
       (.I0(\GEN_NO_RD_CMD_OPT.GEN_NARROW_CNT.narrow_addr_int[1]_i_11_n_0 ),
        .I1(s_axi_arsize[1]),
        .I2(s_axi_arsize[0]),
        .I3(\GEN_NO_RD_CMD_OPT.GEN_NARROW_CNT.narrow_addr_int[1]_i_12_n_0 ),
        .I4(s_axi_arsize[2]),
        .O(s_axi_arsize_1_sn_1));
  LUT6 #(
    .INIT(64'hFFFFFFFFFFFF5600)) 
    \GEN_NO_RD_CMD_OPT.GEN_NARROW_CNT.narrow_addr_int[1]_i_8 
       (.I0(s_axi_arsize[2]),
        .I1(s_axi_arsize[0]),
        .I2(s_axi_arsize[1]),
        .I3(\GEN_NO_RD_CMD_OPT.GEN_NARROW_CNT.narrow_addr_int[1]_i_13_n_0 ),
        .I4(\GEN_NO_RD_CMD_OPT.GEN_NARROW_CNT.narrow_addr_int[1]_i_14_n_0 ),
        .I5(\GEN_NO_RD_CMD_OPT.GEN_NARROW_CNT.narrow_addr_int[1]_i_15_n_0 ),
        .O(\s_axi_arsize[2]_0 ));
  LUT6 #(
    .INIT(64'hFFFFFFFF00D50C5D)) 
    \GEN_NO_RD_CMD_OPT.GEN_NARROW_CNT.narrow_addr_int[1]_i_9 
       (.I0(\GEN_NO_RD_CMD_OPT.GEN_NARROW_CNT.narrow_addr_int[1]_i_16_n_0 ),
        .I1(\GEN_NO_RD_CMD_OPT.GEN_NARROW_CNT.narrow_addr_int[1]_i_17_n_0 ),
        .I2(s_axi_arsize[1]),
        .I3(s_axi_arsize[2]),
        .I4(s_axi_arsize[0]),
        .I5(\GEN_NO_RD_CMD_OPT.GEN_NARROW_CNT.narrow_addr_int[1]_i_18_n_0 ),
        .O(\s_axi_arsize[1]_0 ));
  FDRE #(
    .INIT(1'b0)) 
    \GEN_NO_RD_CMD_OPT.GEN_NARROW_CNT.narrow_addr_int_reg[0] 
       (.C(s_axi_aclk),
        .CE(\GEN_NO_RD_CMD_OPT.GEN_NARROW_CNT.narrow_addr_int[1]_i_1_n_0 ),
        .D(\GEN_NO_RD_CMD_OPT.GEN_UA_NARROW.I_UA_NARROW_n_1 ),
        .Q(narrow_addr_int[0]),
        .R(SR));
  FDRE #(
    .INIT(1'b0)) 
    \GEN_NO_RD_CMD_OPT.GEN_NARROW_CNT.narrow_addr_int_reg[1] 
       (.C(s_axi_aclk),
        .CE(\GEN_NO_RD_CMD_OPT.GEN_NARROW_CNT.narrow_addr_int[1]_i_1_n_0 ),
        .D(\GEN_NO_RD_CMD_OPT.GEN_UA_NARROW.I_UA_NARROW_n_0 ),
        .Q(narrow_addr_int[1]),
        .R(SR));
  LUT4 #(
    .INIT(16'h0002)) 
    \GEN_NO_RD_CMD_OPT.GEN_NARROW_CNT.narrow_bram_addr_inc_d1_i_1 
       (.I0(curr_narrow_burst),
        .I1(\GEN_NO_RD_CMD_OPT.I_WRAP_BRST_n_20 ),
        .I2(narrow_addr_int[1]),
        .I3(narrow_addr_int[0]),
        .O(narrow_bram_addr_inc));
  FDRE #(
    .INIT(1'b0)) 
    \GEN_NO_RD_CMD_OPT.GEN_NARROW_CNT.narrow_bram_addr_inc_d1_reg 
       (.C(s_axi_aclk),
        .CE(1'b1),
        .D(narrow_bram_addr_inc),
        .Q(narrow_bram_addr_inc_d1),
        .R(SR));
  LUT5 #(
    .INIT(32'hFF1F0010)) 
    \GEN_NO_RD_CMD_OPT.GEN_NARROW_CNT_LD.narrow_burst_cnt_ld_reg[0]_i_1 
       (.I0(s_axi_arsize[1]),
        .I1(s_axi_arsize[2]),
        .I2(Arb2AR_Active),
        .I3(ar_active_d1),
        .I4(\GEN_NO_RD_CMD_OPT.GEN_NARROW_CNT_LD.narrow_burst_cnt_ld_reg_reg_n_0_[0] ),
        .O(narrow_burst_cnt_ld_reg[0]));
  LUT6 #(
    .INIT(64'hFFFF01FF00000100)) 
    \GEN_NO_RD_CMD_OPT.GEN_NARROW_CNT_LD.narrow_burst_cnt_ld_reg[1]_i_1 
       (.I0(s_axi_arsize[0]),
        .I1(s_axi_arsize[1]),
        .I2(s_axi_arsize[2]),
        .I3(Arb2AR_Active),
        .I4(ar_active_d1),
        .I5(\GEN_NO_RD_CMD_OPT.GEN_NARROW_CNT_LD.narrow_burst_cnt_ld_reg_reg_n_0_[1] ),
        .O(narrow_burst_cnt_ld_reg[1]));
  FDRE #(
    .INIT(1'b0)) 
    \GEN_NO_RD_CMD_OPT.GEN_NARROW_CNT_LD.narrow_burst_cnt_ld_reg_reg[0] 
       (.C(s_axi_aclk),
        .CE(1'b1),
        .D(narrow_burst_cnt_ld_reg[0]),
        .Q(\GEN_NO_RD_CMD_OPT.GEN_NARROW_CNT_LD.narrow_burst_cnt_ld_reg_reg_n_0_[0] ),
        .R(SR));
  FDRE #(
    .INIT(1'b0)) 
    \GEN_NO_RD_CMD_OPT.GEN_NARROW_CNT_LD.narrow_burst_cnt_ld_reg_reg[1] 
       (.C(s_axi_aclk),
        .CE(1'b1),
        .D(narrow_burst_cnt_ld_reg[1]),
        .Q(\GEN_NO_RD_CMD_OPT.GEN_NARROW_CNT_LD.narrow_burst_cnt_ld_reg_reg_n_0_[1] ),
        .R(SR));
  LUT5 #(
    .INIT(32'h0000FFBA)) 
    \GEN_NO_RD_CMD_OPT.GEN_NARROW_EN.curr_narrow_burst_i_1 
       (.I0(pend_rd_op),
        .I1(ar_active_d1),
        .I2(Arb2AR_Active),
        .I3(\GEN_NO_RD_CMD_OPT.axi_rlast_int_i_3_n_0 ),
        .I4(\GEN_NO_RD_CMD_OPT.GEN_NARROW_EN.curr_narrow_burst_i_2_n_0 ),
        .O(\GEN_NO_RD_CMD_OPT.GEN_NARROW_EN.curr_narrow_burst_i_1_n_0 ));
  LUT6 #(
    .INIT(64'hFFF7777755577777)) 
    \GEN_NO_RD_CMD_OPT.GEN_NARROW_EN.curr_narrow_burst_i_2 
       (.I0(s_axi_aresetn),
        .I1(curr_narrow_burst),
        .I2(s_axi_arburst[0]),
        .I3(s_axi_arburst[1]),
        .I4(\GEN_NO_RD_CMD_OPT.act_rd_burst_two_reg_0 ),
        .I5(s_axi_arsize_2_sn_1),
        .O(\GEN_NO_RD_CMD_OPT.GEN_NARROW_EN.curr_narrow_burst_i_2_n_0 ));
  FDRE #(
    .INIT(1'b0)) 
    \GEN_NO_RD_CMD_OPT.GEN_NARROW_EN.curr_narrow_burst_reg 
       (.C(s_axi_aclk),
        .CE(1'b1),
        .D(\GEN_NO_RD_CMD_OPT.GEN_NARROW_EN.curr_narrow_burst_i_1_n_0 ),
        .Q(curr_narrow_burst),
        .R(1'b0));
  (* SOFT_HLUTNM = "soft_lutpair16" *) 
  LUT3 #(
    .INIT(8'hAC)) 
    \GEN_NO_RD_CMD_OPT.GEN_RDATA_NO_ECC.GEN_RDATA_NO_RL_NO_ECC.GEN_RDATA[0].axi_rdata_int[0]_i_1 
       (.I0(rd_skid_buf[0]),
        .I1(bram_rddata_a[0]),
        .I2(rddata_mux_sel),
        .O(\GEN_NO_RD_CMD_OPT.GEN_RDATA_NO_ECC.GEN_RDATA_NO_RL_NO_ECC.GEN_RDATA[0].axi_rdata_int[0]_i_1_n_0 ));
  FDRE #(
    .INIT(1'b0)) 
    \GEN_NO_RD_CMD_OPT.GEN_RDATA_NO_ECC.GEN_RDATA_NO_RL_NO_ECC.GEN_RDATA[0].axi_rdata_int_reg[0] 
       (.C(s_axi_aclk),
        .CE(axi_rdata_en),
        .D(\GEN_NO_RD_CMD_OPT.GEN_RDATA_NO_ECC.GEN_RDATA_NO_RL_NO_ECC.GEN_RDATA[0].axi_rdata_int[0]_i_1_n_0 ),
        .Q(s_axi_rdata[0]),
        .R(\GEN_NO_RD_CMD_OPT.GEN_RDATA_NO_ECC.GEN_RDATA_NO_RL_NO_ECC.GEN_RDATA[31].axi_rdata_int[31]_i_1_n_0 ));
  (* SOFT_HLUTNM = "soft_lutpair21" *) 
  LUT3 #(
    .INIT(8'hAC)) 
    \GEN_NO_RD_CMD_OPT.GEN_RDATA_NO_ECC.GEN_RDATA_NO_RL_NO_ECC.GEN_RDATA[10].axi_rdata_int[10]_i_1 
       (.I0(rd_skid_buf[10]),
        .I1(bram_rddata_a[10]),
        .I2(rddata_mux_sel),
        .O(\GEN_NO_RD_CMD_OPT.GEN_RDATA_NO_ECC.GEN_RDATA_NO_RL_NO_ECC.GEN_RDATA[10].axi_rdata_int[10]_i_1_n_0 ));
  FDRE #(
    .INIT(1'b0)) 
    \GEN_NO_RD_CMD_OPT.GEN_RDATA_NO_ECC.GEN_RDATA_NO_RL_NO_ECC.GEN_RDATA[10].axi_rdata_int_reg[10] 
       (.C(s_axi_aclk),
        .CE(axi_rdata_en),
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
        .Q(s_axi_rdata[29]),
        .R(\GEN_NO_RD_CMD_OPT.GEN_RDATA_NO_ECC.GEN_RDATA_NO_RL_NO_ECC.GEN_RDATA[31].axi_rdata_int[31]_i_1_n_0 ));
  (* SOFT_HLUTNM = "soft_lutpair17" *) 
  LUT3 #(
    .INIT(8'hAC)) 
    \GEN_NO_RD_CMD_OPT.GEN_RDATA_NO_ECC.GEN_RDATA_NO_RL_NO_ECC.GEN_RDATA[2].axi_rdata_int[2]_i_1 
       (.I0(rd_skid_buf[2]),
        .I1(bram_rddata_a[2]),
        .I2(rddata_mux_sel),
        .O(\GEN_NO_RD_CMD_OPT.GEN_RDATA_NO_ECC.GEN_RDATA_NO_RL_NO_ECC.GEN_RDATA[2].axi_rdata_int[2]_i_1_n_0 ));
  FDRE #(
    .INIT(1'b0)) 
    \GEN_NO_RD_CMD_OPT.GEN_RDATA_NO_ECC.GEN_RDATA_NO_RL_NO_ECC.GEN_RDATA[2].axi_rdata_int_reg[2] 
       (.C(s_axi_aclk),
        .CE(axi_rdata_en),
        .D(\GEN_NO_RD_CMD_OPT.GEN_RDATA_NO_ECC.GEN_RDATA_NO_RL_NO_ECC.GEN_RDATA[2].axi_rdata_int[2]_i_1_n_0 ),
        .Q(s_axi_rdata[2]),
        .R(\GEN_NO_RD_CMD_OPT.GEN_RDATA_NO_ECC.GEN_RDATA_NO_RL_NO_ECC.GEN_RDATA[31].axi_rdata_int[31]_i_1_n_0 ));
  (* SOFT_HLUTNM = "soft_lutpair31" *) 
  LUT3 #(
    .INIT(8'hAC)) 
    \GEN_NO_RD_CMD_OPT.GEN_RDATA_NO_ECC.GEN_RDATA_NO_RL_NO_ECC.GEN_RDATA[30].axi_rdata_int[30]_i_1 
       (.I0(rd_skid_buf[30]),
        .I1(bram_rddata_a[30]),
        .I2(rddata_mux_sel),
        .O(\GEN_NO_RD_CMD_OPT.GEN_RDATA_NO_ECC.GEN_RDATA_NO_RL_NO_ECC.GEN_RDATA[30].axi_rdata_int[30]_i_1_n_0 ));
  FDRE #(
    .INIT(1'b0)) 
    \GEN_NO_RD_CMD_OPT.GEN_RDATA_NO_ECC.GEN_RDATA_NO_RL_NO_ECC.GEN_RDATA[30].axi_rdata_int_reg[30] 
       (.C(s_axi_aclk),
        .CE(axi_rdata_en),
        .D(\GEN_NO_RD_CMD_OPT.GEN_RDATA_NO_ECC.GEN_RDATA_NO_RL_NO_ECC.GEN_RDATA[30].axi_rdata_int[30]_i_1_n_0 ),
        .Q(s_axi_rdata[30]),
        .R(\GEN_NO_RD_CMD_OPT.GEN_RDATA_NO_ECC.GEN_RDATA_NO_RL_NO_ECC.GEN_RDATA[31].axi_rdata_int[31]_i_1_n_0 ));
  LUT3 #(
    .INIT(8'h8F)) 
    \GEN_NO_RD_CMD_OPT.GEN_RDATA_NO_ECC.GEN_RDATA_NO_RL_NO_ECC.GEN_RDATA[31].axi_rdata_int[31]_i_1 
       (.I0(\GEN_NO_RD_CMD_OPT.axi_rlast_int_reg_0 ),
        .I1(s_axi_rready),
        .I2(s_axi_aresetn),
        .O(\GEN_NO_RD_CMD_OPT.GEN_RDATA_NO_ECC.GEN_RDATA_NO_RL_NO_ECC.GEN_RDATA[31].axi_rdata_int[31]_i_1_n_0 ));
  LUT6 #(
    .INIT(64'h00030B00030F0300)) 
    \GEN_NO_RD_CMD_OPT.GEN_RDATA_NO_ECC.GEN_RDATA_NO_RL_NO_ECC.GEN_RDATA[31].axi_rdata_int[31]_i_2 
       (.I0(\GEN_NO_RD_CMD_OPT.GEN_RDATA_NO_ECC.GEN_RDATA_NO_RL_NO_ECC.GEN_RDATA[31].axi_rdata_int[31]_i_4_n_0 ),
        .I1(\GEN_NO_RD_CMD_OPT.GEN_RDATA_NO_ECC.GEN_RDATA_NO_RL_NO_ECC.GEN_RDATA[31].axi_rdata_int[31]_i_5_n_0 ),
        .I2(rd_data_sm_cs[3]),
        .I3(rd_data_sm_cs[2]),
        .I4(rd_data_sm_cs[1]),
        .I5(rd_data_sm_cs[0]),
        .O(axi_rdata_en));
  (* SOFT_HLUTNM = "soft_lutpair31" *) 
  LUT3 #(
    .INIT(8'hAC)) 
    \GEN_NO_RD_CMD_OPT.GEN_RDATA_NO_ECC.GEN_RDATA_NO_RL_NO_ECC.GEN_RDATA[31].axi_rdata_int[31]_i_3 
       (.I0(rd_skid_buf[31]),
        .I1(bram_rddata_a[31]),
        .I2(rddata_mux_sel),
        .O(\GEN_NO_RD_CMD_OPT.GEN_RDATA_NO_ECC.GEN_RDATA_NO_RL_NO_ECC.GEN_RDATA[31].axi_rdata_int[31]_i_3_n_0 ));
  (* SOFT_HLUTNM = "soft_lutpair11" *) 
  LUT2 #(
    .INIT(4'h1)) 
    \GEN_NO_RD_CMD_OPT.GEN_RDATA_NO_ECC.GEN_RDATA_NO_RL_NO_ECC.GEN_RDATA[31].axi_rdata_int[31]_i_4 
       (.I0(act_rd_burst_two),
        .I1(act_rd_burst),
        .O(\GEN_NO_RD_CMD_OPT.GEN_RDATA_NO_ECC.GEN_RDATA_NO_RL_NO_ECC.GEN_RDATA[31].axi_rdata_int[31]_i_4_n_0 ));
  LUT2 #(
    .INIT(4'h7)) 
    \GEN_NO_RD_CMD_OPT.GEN_RDATA_NO_ECC.GEN_RDATA_NO_RL_NO_ECC.GEN_RDATA[31].axi_rdata_int[31]_i_5 
       (.I0(\GEN_NO_RD_CMD_OPT.axi_rvalid_int_reg_0 ),
        .I1(s_axi_rready),
        .O(\GEN_NO_RD_CMD_OPT.GEN_RDATA_NO_ECC.GEN_RDATA_NO_RL_NO_ECC.GEN_RDATA[31].axi_rdata_int[31]_i_5_n_0 ));
  FDRE #(
    .INIT(1'b0)) 
    \GEN_NO_RD_CMD_OPT.GEN_RDATA_NO_ECC.GEN_RDATA_NO_RL_NO_ECC.GEN_RDATA[31].axi_rdata_int_reg[31] 
       (.C(s_axi_aclk),
        .CE(axi_rdata_en),
        .D(\GEN_NO_RD_CMD_OPT.GEN_RDATA_NO_ECC.GEN_RDATA_NO_RL_NO_ECC.GEN_RDATA[31].axi_rdata_int[31]_i_3_n_0 ),
        .Q(s_axi_rdata[31]),
        .R(\GEN_NO_RD_CMD_OPT.GEN_RDATA_NO_ECC.GEN_RDATA_NO_RL_NO_ECC.GEN_RDATA[31].axi_rdata_int[31]_i_1_n_0 ));
  (* SOFT_HLUTNM = "soft_lutpair17" *) 
  LUT3 #(
    .INIT(8'hAC)) 
    \GEN_NO_RD_CMD_OPT.GEN_RDATA_NO_ECC.GEN_RDATA_NO_RL_NO_ECC.GEN_RDATA[3].axi_rdata_int[3]_i_1 
       (.I0(rd_skid_buf[3]),
        .I1(bram_rddata_a[3]),
        .I2(rddata_mux_sel),
        .O(\GEN_NO_RD_CMD_OPT.GEN_RDATA_NO_ECC.GEN_RDATA_NO_RL_NO_ECC.GEN_RDATA[3].axi_rdata_int[3]_i_1_n_0 ));
  FDRE #(
    .INIT(1'b0)) 
    \GEN_NO_RD_CMD_OPT.GEN_RDATA_NO_ECC.GEN_RDATA_NO_RL_NO_ECC.GEN_RDATA[3].axi_rdata_int_reg[3] 
       (.C(s_axi_aclk),
        .CE(axi_rdata_en),
        .D(\GEN_NO_RD_CMD_OPT.GEN_RDATA_NO_ECC.GEN_RDATA_NO_RL_NO_ECC.GEN_RDATA[3].axi_rdata_int[3]_i_1_n_0 ),
        .Q(s_axi_rdata[3]),
        .R(\GEN_NO_RD_CMD_OPT.GEN_RDATA_NO_ECC.GEN_RDATA_NO_RL_NO_ECC.GEN_RDATA[31].axi_rdata_int[31]_i_1_n_0 ));
  (* SOFT_HLUTNM = "soft_lutpair18" *) 
  LUT3 #(
    .INIT(8'hAC)) 
    \GEN_NO_RD_CMD_OPT.GEN_RDATA_NO_ECC.GEN_RDATA_NO_RL_NO_ECC.GEN_RDATA[4].axi_rdata_int[4]_i_1 
       (.I0(rd_skid_buf[4]),
        .I1(bram_rddata_a[4]),
        .I2(rddata_mux_sel),
        .O(\GEN_NO_RD_CMD_OPT.GEN_RDATA_NO_ECC.GEN_RDATA_NO_RL_NO_ECC.GEN_RDATA[4].axi_rdata_int[4]_i_1_n_0 ));
  FDRE #(
    .INIT(1'b0)) 
    \GEN_NO_RD_CMD_OPT.GEN_RDATA_NO_ECC.GEN_RDATA_NO_RL_NO_ECC.GEN_RDATA[4].axi_rdata_int_reg[4] 
       (.C(s_axi_aclk),
        .CE(axi_rdata_en),
        .D(\GEN_NO_RD_CMD_OPT.GEN_RDATA_NO_ECC.GEN_RDATA_NO_RL_NO_ECC.GEN_RDATA[4].axi_rdata_int[4]_i_1_n_0 ),
        .Q(s_axi_rdata[4]),
        .R(\GEN_NO_RD_CMD_OPT.GEN_RDATA_NO_ECC.GEN_RDATA_NO_RL_NO_ECC.GEN_RDATA[31].axi_rdata_int[31]_i_1_n_0 ));
  (* SOFT_HLUTNM = "soft_lutpair18" *) 
  LUT3 #(
    .INIT(8'hAC)) 
    \GEN_NO_RD_CMD_OPT.GEN_RDATA_NO_ECC.GEN_RDATA_NO_RL_NO_ECC.GEN_RDATA[5].axi_rdata_int[5]_i_1 
       (.I0(rd_skid_buf[5]),
        .I1(bram_rddata_a[5]),
        .I2(rddata_mux_sel),
        .O(\GEN_NO_RD_CMD_OPT.GEN_RDATA_NO_ECC.GEN_RDATA_NO_RL_NO_ECC.GEN_RDATA[5].axi_rdata_int[5]_i_1_n_0 ));
  FDRE #(
    .INIT(1'b0)) 
    \GEN_NO_RD_CMD_OPT.GEN_RDATA_NO_ECC.GEN_RDATA_NO_RL_NO_ECC.GEN_RDATA[5].axi_rdata_int_reg[5] 
       (.C(s_axi_aclk),
        .CE(axi_rdata_en),
        .D(\GEN_NO_RD_CMD_OPT.GEN_RDATA_NO_ECC.GEN_RDATA_NO_RL_NO_ECC.GEN_RDATA[5].axi_rdata_int[5]_i_1_n_0 ),
        .Q(s_axi_rdata[5]),
        .R(\GEN_NO_RD_CMD_OPT.GEN_RDATA_NO_ECC.GEN_RDATA_NO_RL_NO_ECC.GEN_RDATA[31].axi_rdata_int[31]_i_1_n_0 ));
  (* SOFT_HLUTNM = "soft_lutpair19" *) 
  LUT3 #(
    .INIT(8'hAC)) 
    \GEN_NO_RD_CMD_OPT.GEN_RDATA_NO_ECC.GEN_RDATA_NO_RL_NO_ECC.GEN_RDATA[6].axi_rdata_int[6]_i_1 
       (.I0(rd_skid_buf[6]),
        .I1(bram_rddata_a[6]),
        .I2(rddata_mux_sel),
        .O(\GEN_NO_RD_CMD_OPT.GEN_RDATA_NO_ECC.GEN_RDATA_NO_RL_NO_ECC.GEN_RDATA[6].axi_rdata_int[6]_i_1_n_0 ));
  FDRE #(
    .INIT(1'b0)) 
    \GEN_NO_RD_CMD_OPT.GEN_RDATA_NO_ECC.GEN_RDATA_NO_RL_NO_ECC.GEN_RDATA[6].axi_rdata_int_reg[6] 
       (.C(s_axi_aclk),
        .CE(axi_rdata_en),
        .D(\GEN_NO_RD_CMD_OPT.GEN_RDATA_NO_ECC.GEN_RDATA_NO_RL_NO_ECC.GEN_RDATA[6].axi_rdata_int[6]_i_1_n_0 ),
        .Q(s_axi_rdata[6]),
        .R(\GEN_NO_RD_CMD_OPT.GEN_RDATA_NO_ECC.GEN_RDATA_NO_RL_NO_ECC.GEN_RDATA[31].axi_rdata_int[31]_i_1_n_0 ));
  (* SOFT_HLUTNM = "soft_lutpair19" *) 
  LUT3 #(
    .INIT(8'hAC)) 
    \GEN_NO_RD_CMD_OPT.GEN_RDATA_NO_ECC.GEN_RDATA_NO_RL_NO_ECC.GEN_RDATA[7].axi_rdata_int[7]_i_1 
       (.I0(rd_skid_buf[7]),
        .I1(bram_rddata_a[7]),
        .I2(rddata_mux_sel),
        .O(\GEN_NO_RD_CMD_OPT.GEN_RDATA_NO_ECC.GEN_RDATA_NO_RL_NO_ECC.GEN_RDATA[7].axi_rdata_int[7]_i_1_n_0 ));
  FDRE #(
    .INIT(1'b0)) 
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
       (.I0(s_axi_arlen[3]),
        .I1(s_axi_arlen[2]),
        .O(\GEN_NO_RD_CMD_OPT.GEN_RD_BURST_NORL.axi_rd_burst_i_3_n_0 ));
  FDRE #(
    .INIT(1'b0)) 
    \GEN_NO_RD_CMD_OPT.GEN_RD_BURST_NORL.axi_rd_burst_reg 
       (.C(s_axi_aclk),
        .CE(ar_active_re),
        .D(axi_rd_burst0),
        .Q(axi_rd_burst),
        .R(\GEN_NO_RD_CMD_OPT.GEN_RD_BURST_NORL.axi_rd_burst_i_1_n_0 ));
  (* SOFT_HLUTNM = "soft_lutpair15" *) 
  LUT4 #(
    .INIT(16'h0010)) 
    \GEN_NO_RD_CMD_OPT.GEN_RD_BURST_NORL.axi_rd_burst_two_i_1 
       (.I0(s_axi_arlen[3]),
        .I1(s_axi_arlen[2]),
        .I2(s_axi_arlen[0]),
        .I3(\GEN_NO_RD_CMD_OPT.GEN_RD_BURST_NORL.axi_rd_burst_two_i_2_n_0 ),
        .O(axi_rd_burst_two));
  LUT5 #(
    .INIT(32'hFFFFFFFE)) 
    \GEN_NO_RD_CMD_OPT.GEN_RD_BURST_NORL.axi_rd_burst_two_i_2 
       (.I0(s_axi_arlen[6]),
        .I1(s_axi_arlen[4]),
        .I2(s_axi_arlen[1]),
        .I3(s_axi_arlen[5]),
        .I4(s_axi_arlen[7]),
        .O(\GEN_NO_RD_CMD_OPT.GEN_RD_BURST_NORL.axi_rd_burst_two_i_2_n_0 ));
  FDRE #(
    .INIT(1'b0)) 
    \GEN_NO_RD_CMD_OPT.GEN_RD_BURST_NORL.axi_rd_burst_two_reg 
       (.C(s_axi_aclk),
        .CE(ar_active_re),
        .D(axi_rd_burst_two),
        .Q(\GEN_NO_RD_CMD_OPT.GEN_RD_BURST_NORL.axi_rd_burst_two_reg_n_0 ),
        .R(\GEN_NO_RD_CMD_OPT.GEN_RD_BURST_NORL.axi_rd_burst_i_1_n_0 ));
  decalper_eb_ot_sdeen_pot_pi_dehcac_xnilix_ua_narrow_0 \GEN_NO_RD_CMD_OPT.GEN_UA_NARROW.I_UA_NARROW 
       (.D({\GEN_NO_RD_CMD_OPT.GEN_UA_NARROW.I_UA_NARROW_n_0 ,\GEN_NO_RD_CMD_OPT.GEN_UA_NARROW.I_UA_NARROW_n_1 }),
        .\GEN_NO_RD_CMD_OPT.GEN_NARROW_CNT.narrow_addr_int_reg[0] (\GEN_NO_RD_CMD_OPT.GEN_NARROW_CNT.narrow_addr_int[1]_i_3_n_0 ),
        .\GEN_NO_RD_CMD_OPT.GEN_NARROW_CNT.narrow_addr_int_reg[1] (narrow_burst_cnt_ld_reg),
        .\GEN_NO_RD_CMD_OPT.GEN_NARROW_CNT.narrow_addr_int_reg[1]_0 (\GEN_NO_RD_CMD_OPT.GEN_NARROW_CNT.narrow_addr_int_reg[1]_0 ),
        .Q(narrow_addr_int),
        .s_axi_araddr(s_axi_araddr[1:0]),
        .s_axi_arsize(s_axi_arsize));
  decalper_eb_ot_sdeen_pot_pi_dehcac_xnilix_wrap_brst_1 \GEN_NO_RD_CMD_OPT.I_WRAP_BRST 
       (.\ADDR_SNG_PORT.bram_addr_int_reg[10] (\ADDR_SNG_PORT.bram_addr_int_reg[10] ),
        .\ADDR_SNG_PORT.bram_addr_int_reg[11] (Q),
        .\ADDR_SNG_PORT.bram_addr_int_reg[11]_0 (\ADDR_SNG_PORT.bram_addr_int_reg[11] ),
        .\ADDR_SNG_PORT.bram_addr_int_reg[11]_1 (\ADDR_SNG_PORT.bram_addr_int_reg[11]_0 ),
        .\ADDR_SNG_PORT.bram_addr_int_reg[11]_2 (\ADDR_SNG_PORT.bram_addr_int[11]_i_4_n_0 ),
        .\ADDR_SNG_PORT.bram_addr_int_reg[11]_3 (\ADDR_SNG_PORT.bram_addr_int_reg[11]_1 ),
        .\ADDR_SNG_PORT.bram_addr_int_reg[2] (\ADDR_SNG_PORT.bram_addr_int_reg[2] ),
        .\ADDR_SNG_PORT.bram_addr_int_reg[2]_0 (\ADDR_SNG_PORT.bram_addr_int_reg[2]_0 ),
        .\ADDR_SNG_PORT.bram_addr_int_reg[2]_1 (ar_active_d1),
        .\ADDR_SNG_PORT.bram_addr_int_reg[2]_2 (\ADDR_SNG_PORT.bram_addr_int_reg[2]_1 ),
        .\ADDR_SNG_PORT.bram_addr_int_reg[2]_3 (narrow_addr_int),
        .\ADDR_SNG_PORT.bram_addr_int_reg[3] (\ADDR_SNG_PORT.bram_addr_int_reg[3] ),
        .\ADDR_SNG_PORT.bram_addr_int_reg[4] (\ADDR_SNG_PORT.bram_addr_int_reg[4] ),
        .\ADDR_SNG_PORT.bram_addr_int_reg[4]_0 (\ADDR_SNG_PORT.bram_addr_int_reg[4]_0 ),
        .\ADDR_SNG_PORT.bram_addr_int_reg[5] (\ADDR_SNG_PORT.bram_addr_int_reg[5] ),
        .\ADDR_SNG_PORT.bram_addr_int_reg[5]_0 (\ADDR_SNG_PORT.bram_addr_int_reg[5]_0 ),
        .\ADDR_SNG_PORT.bram_addr_int_reg[7] (\ADDR_SNG_PORT.bram_addr_int_reg[7] ),
        .\ADDR_SNG_PORT.bram_addr_int_reg[8] (\ADDR_SNG_PORT.bram_addr_int_reg[8] ),
        .\ADDR_SNG_PORT.bram_addr_int_reg[9] (\ADDR_SNG_PORT.bram_addr_int_reg[9] ),
        .Arb2AR_Active(Arb2AR_Active),
        .D(D),
        .E(E),
        .\FSM_sequential_GEN_NO_RD_CMD_OPT.rd_data_sm_cs_reg[1] (\GEN_NO_RD_CMD_OPT.I_WRAP_BRST_n_20 ),
        .\GEN_NO_RD_CMD_OPT.GEN_NARROW_CNT.narrow_bram_addr_inc_d1_i_2_0 (\GEN_NO_RD_CMD_OPT.GEN_RD_BURST_NORL.axi_rd_burst_two_reg_n_0 ),
        .\GEN_NO_RD_CMD_OPT.bram_en_int_i_2 (\GEN_NO_RD_CMD_OPT.axi_rvalid_int_reg_0 ),
        .Q(rd_data_sm_cs),
        .SR(SR),
        .ar_active_re(ar_active_re),
        .axi_rd_burst(axi_rd_burst),
        .brst_zero(brst_zero),
        .curr_fixed_burst_reg(curr_fixed_burst_reg),
        .curr_narrow_burst(curr_narrow_burst),
        .curr_wrap_burst_reg(curr_wrap_burst_reg),
        .end_brst_rd(end_brst_rd),
        .narrow_bram_addr_inc_d1(narrow_bram_addr_inc_d1),
        .s_axi_aclk(s_axi_aclk),
        .s_axi_araddr(s_axi_araddr[17:2]),
        .s_axi_aresetn(s_axi_aresetn),
        .s_axi_arlen(s_axi_arlen[3:0]),
        .s_axi_arsize(s_axi_arsize),
        .s_axi_arsize_2_sp_1(s_axi_arsize_2_sn_1),
        .s_axi_awaddr(s_axi_awaddr),
        .s_axi_rready(s_axi_rready),
        .s_axi_rready_0(\GEN_NO_RD_CMD_OPT.I_WRAP_BRST_n_21 ),
        .\save_init_bram_addr_ld_reg[17]_0 (\save_init_bram_addr_ld_reg[17] ));
  LUT6 #(
    .INIT(64'h02000004FFFFFFFF)) 
    \GEN_NO_RD_CMD_OPT.act_rd_burst_i_1 
       (.I0(rd_data_sm_cs[2]),
        .I1(rd_data_sm_cs[3]),
        .I2(\GEN_NO_RD_CMD_OPT.act_rd_burst_i_4_n_0 ),
        .I3(rd_data_sm_cs[0]),
        .I4(rd_data_sm_cs[1]),
        .I5(s_axi_aresetn),
        .O(\GEN_NO_RD_CMD_OPT.act_rd_burst_i_1_n_0 ));
  LUT6 #(
    .INIT(64'h0000010001010100)) 
    \GEN_NO_RD_CMD_OPT.act_rd_burst_i_2 
       (.I0(rd_data_sm_cs[2]),
        .I1(rd_data_sm_cs[3]),
        .I2(rd_data_sm_cs[1]),
        .I3(\GEN_NO_RD_CMD_OPT.act_rd_burst_two_reg_0 ),
        .I4(rd_data_sm_cs[0]),
        .I5(\FSM_sequential_GEN_NO_RD_CMD_OPT.rd_data_sm_cs[0]_i_2_n_0 ),
        .O(act_rd_burst_set));
  (* SOFT_HLUTNM = "soft_lutpair14" *) 
  LUT4 #(
    .INIT(16'hAA3A)) 
    \GEN_NO_RD_CMD_OPT.act_rd_burst_i_3 
       (.I0(axi_rd_burst),
        .I1(axi_rd_burst_two),
        .I2(Arb2AR_Active),
        .I3(ar_active_d1),
        .O(\GEN_NO_RD_CMD_OPT.act_rd_burst_i_3_n_0 ));
  (* SOFT_HLUTNM = "soft_lutpair11" *) 
  LUT4 #(
    .INIT(16'h777F)) 
    \GEN_NO_RD_CMD_OPT.act_rd_burst_i_4 
       (.I0(s_axi_rready),
        .I1(\GEN_NO_RD_CMD_OPT.axi_rvalid_int_reg_0 ),
        .I2(act_rd_burst),
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
