AdriaanSadie/MVT_ADC_TECH/adc_tech/adc_tech.cache/ip/2020.2/218f51cbd73a38f3/adc_tech_axi_bram_ctrl_0_2_sim_netlist.vhdl

-- Copyright 1986-2020 Xilinx, Inc. All Rights Reserved.
-- --------------------------------------------------------------------------------
-- Tool Version: Vivado v.2020.2 (win64) Build 3064766 Wed Nov 18 09:12:45 MST 2020
-- Date        : Mon Oct 27 06:54:17 2025
-- Host        : ZA-WASADIE1 running 64-bit major release  (build 9200)
-- Command     : write_vhdl -force -mode funcsim -rename_top decalper_eb_ot_sdeen_pot_pi_dehcac_xnilix -prefix
--               decalper_eb_ot_sdeen_pot_pi_dehcac_xnilix_ adc_tech_axi_bram_ctrl_0_2_sim_netlist.vhdl
-- Design      : adc_tech_axi_bram_ctrl_0_2
-- Purpose     : This VHDL netlist is a functional simulation representation of the design and should not be modified or
--               synthesized. This netlist cannot be used for SDF annotated simulation.
-- Device      : xczu7ev-ffvc1156-2-e
-- --------------------------------------------------------------------------------
library IEEE;
use IEEE.STD_LOGIC_1164.ALL;
library UNISIM;
use UNISIM.VCOMPONENTS.ALL;
entity decalper_eb_ot_sdeen_pot_pi_dehcac_xnilix_sng_port_arb is
  port (
    s_axi_awready : out STD_LOGIC;
    axi_awready_cmb : out STD_LOGIC;
    s_axi_arready : out STD_LOGIC;
    axi_arready_cmb : out STD_LOGIC;
    last_arb_won : out STD_LOGIC;
    Arb2AW_Active : out STD_LOGIC;
    Arb2AR_Active : out STD_LOGIC;
    curr_narrow_burst_en : out STD_LOGIC;
    E : out STD_LOGIC_VECTOR ( 0 to 0 );
    s_axi_arburst_0_sp_1 : out STD_LOGIC;
    ar_active_re : out STD_LOGIC;
    \s_axi_arlen[6]\ : out STD_LOGIC;
    ar_active_reg_0 : out STD_LOGIC;
    \GEN_NO_RD_CMD_OPT.axi_rlast_int_reg\ : out STD_LOGIC;
    \FSM_onehot_GEN_WDATA_SM_NO_ECC_SNG_REG_WREADY.wr_data_sng_sm_cs_reg[2]\ : out STD_LOGIC;
    Q : out STD_LOGIC_VECTOR ( 1 downto 0 );
    last_arb_won_reg_0 : out STD_LOGIC;
    D : out STD_LOGIC_VECTOR ( 0 to 0 );
    bram_we_a : out STD_LOGIC_VECTOR ( 3 downto 0 );
    SR : in STD_LOGIC_VECTOR ( 0 to 0 );
    s_axi_aclk : in STD_LOGIC;
    last_arb_won_reg_1 : in STD_LOGIC;
    aw_active_reg_0 : in STD_LOGIC;
    ar_active_reg_1 : in STD_LOGIC;
    \GEN_NARROW_EN.curr_narrow_burst_reg\ : in STD_LOGIC;
    \GEN_NARROW_EN.curr_narrow_burst_reg_0\ : in STD_LOGIC;
    aw_active_d1 : in STD_LOGIC;
    s_axi_awburst : in STD_LOGIC_VECTOR ( 1 downto 0 );
    \GEN_NO_RD_CMD_OPT.GEN_NARROW_CNT.narrow_addr_int_reg[1]\ : in STD_LOGIC;
    \GEN_NO_RD_CMD_OPT.GEN_NARROW_CNT.narrow_addr_int_reg[1]_0\ : in STD_LOGIC;
    \GEN_NO_RD_CMD_OPT.GEN_NARROW_CNT.narrow_addr_int_reg[1]_1\ : in STD_LOGIC;
    s_axi_arburst : in STD_LOGIC_VECTOR ( 1 downto 0 );
    \GEN_NO_RD_CMD_OPT.GEN_NARROW_CNT.narrow_addr_int[1]_i_4_0\ : in STD_LOGIC;
    s_axi_araddr : in STD_LOGIC_VECTOR ( 1 downto 0 );
    \GEN_NO_RD_CMD_OPT.act_rd_burst_two_reg\ : in STD_LOGIC;
    s_axi_arlen : in STD_LOGIC_VECTOR ( 3 downto 0 );
    ar_active_d1 : in STD_LOGIC;
    s_axi_aresetn : in STD_LOGIC;
    s_axi_rready : in STD_LOGIC;
    \GEN_NO_RD_CMD_OPT.GEN_AR_SNG.ar_active_d1_reg\ : in STD_LOGIC;
    s_axi_awvalid : in STD_LOGIC;
    s_axi_arvalid : in STD_LOGIC;
    axi_awready_int_reg_0 : in STD_LOGIC;
    axi_awready_int_reg_1 : in STD_LOGIC;
    \FSM_sequential_arb_sm_cs_reg[0]_0\ : in STD_LOGIC_VECTOR ( 0 to 0 );
    \bram_we_a[3]\ : in STD_LOGIC_VECTOR ( 3 downto 0 )
  );
end decalper_eb_ot_sdeen_pot_pi_dehcac_xnilix_sng_port_arb;

architecture STRUCTURE of decalper_eb_ot_sdeen_pot_pi_dehcac_xnilix_sng_port_arb is
  signal \^arb2ar_active\ : STD_LOGIC;
  signal \^arb2aw_active\ : STD_LOGIC;
  signal \^d\ : STD_LOGIC_VECTOR ( 0 to 0 );
  signal \^fsm_onehot_gen_wdata_sm_no_ecc_sng_reg_wready.wr_data_sng_sm_cs_reg[2]\ : STD_LOGIC;
  signal \FSM_sequential_arb_sm_cs[1]_i_1_n_0\ : STD_LOGIC;
  signal \GEN_NO_RD_CMD_OPT.GEN_NARROW_CNT.narrow_addr_int[1]_i_10_n_0\ : STD_LOGIC;
  signal \^gen_no_rd_cmd_opt.axi_rlast_int_reg\ : STD_LOGIC;
  signal \^q\ : STD_LOGIC_VECTOR ( 1 downto 0 );
  signal \^ar_active_re\ : STD_LOGIC;
  signal arb_sm_ns : STD_LOGIC_VECTOR ( 0 to 0 );
  signal \^axi_arready_cmb\ : STD_LOGIC;
  signal axi_arready_int_i_4_n_0 : STD_LOGIC;
  signal \^axi_awready_cmb\ : STD_LOGIC;
  signal \^last_arb_won\ : STD_LOGIC;
  signal s_axi_arburst_0_sn_1 : STD_LOGIC;
  attribute SOFT_HLUTNM : string;
  attribute SOFT_HLUTNM of \FSM_sequential_arb_sm_cs[1]_i_2\ : label is "soft_lutpair0";
  attribute FSM_ENCODED_STATES : string;
  attribute FSM_ENCODED_STATES of \FSM_sequential_arb_sm_cs_reg[0]\ : label is "wr_data:01,idle:00,rd_data:10";
  attribute FSM_ENCODED_STATES of \FSM_sequential_arb_sm_cs_reg[1]\ : label is "wr_data:01,idle:00,rd_data:10";
  attribute SOFT_HLUTNM of axi_arready_int_i_2 : label is "soft_lutpair1";
  attribute SOFT_HLUTNM of axi_arready_int_i_3 : label is "soft_lutpair1";
  attribute SOFT_HLUTNM of axi_arready_int_i_4 : label is "soft_lutpair0";
  attribute SOFT_HLUTNM of \bram_we_a[1]_INST_0\ : label is "soft_lutpair3";
  attribute SOFT_HLUTNM of \bram_we_a[2]_INST_0\ : label is "soft_lutpair3";
  attribute SOFT_HLUTNM of \bram_we_a[3]_INST_0\ : label is "soft_lutpair2";
  attribute SOFT_HLUTNM of \save_init_bram_addr_ld[17]_i_1\ : label is "soft_lutpair2";
begin
  Arb2AR_Active <= \^arb2ar_active\;
  Arb2AW_Active <= \^arb2aw_active\;
  D(0) <= \^d\(0);
  \FSM_onehot_GEN_WDATA_SM_NO_ECC_SNG_REG_WREADY.wr_data_sng_sm_cs_reg[2]\ <= \^fsm_onehot_gen_wdata_sm_no_ecc_sng_reg_wready.wr_data_sng_sm_cs_reg[2]\;
  \GEN_NO_RD_CMD_OPT.axi_rlast_int_reg\ <= \^gen_no_rd_cmd_opt.axi_rlast_int_reg\;
  Q(1 downto 0) <= \^q\(1 downto 0);
  ar_active_re <= \^ar_active_re\;
  axi_arready_cmb <= \^axi_arready_cmb\;
  axi_awready_cmb <= \^axi_awready_cmb\;
  last_arb_won <= \^last_arb_won\;
  s_axi_arburst_0_sp_1 <= s_axi_arburst_0_sn_1;
\FSM_sequential_arb_sm_cs[0]_i_1\: unisim.vcomponents.LUT6
    generic map(
      INIT => X"00000000AAAAC0FF"
    )
        port map (
      I0 => axi_awready_int_reg_1,
      I1 => \^last_arb_won\,
      I2 => s_axi_awvalid,
      I3 => s_axi_arvalid,
      I4 => \^q\(1),
      I5 => \^q\(0),
      O => arb_sm_ns(0)
    );
\FSM_sequential_arb_sm_cs[1]_i_1\: unisim.vcomponents.LUT6
    generic map(
      INIT => X"CFFECCFECFCECCCE"
    )
        port map (
      I0 => axi_awready_int_reg_1,
      I1 => axi_arready_int_i_4_n_0,
      I2 => \^q\(0),
      I3 => \^q\(1),
      I4 => axi_awready_int_reg_0,
      I5 => \FSM_sequential_arb_sm_cs_reg[0]_0\(0),
      O => \FSM_sequential_arb_sm_cs[1]_i_1_n_0\
    );
\FSM_sequential_arb_sm_cs[1]_i_2\: unisim.vcomponents.LUT5
    generic map(
      INIT => X"00C40CCC"
    )
        port map (
      I0 => \^last_arb_won\,
      I1 => s_axi_arvalid,
      I2 => \^q\(0),
      I3 => \^q\(1),
      I4 => s_axi_awvalid,
      O => \^d\(0)
    );
\FSM_sequential_arb_sm_cs_reg[0]\: unisim.vcomponents.FDRE
     port map (
      C => s_axi_aclk,
      CE => \FSM_sequential_arb_sm_cs[1]_i_1_n_0\,
      D => arb_sm_ns(0),
      Q => \^q\(0),
      R => SR(0)
    );
\FSM_sequential_arb_sm_cs_reg[1]\: unisim.vcomponents.FDRE
     port map (
      C => s_axi_aclk,
      CE => \FSM_sequential_arb_sm_cs[1]_i_1_n_0\,
      D => \^d\(0),
      Q => \^q\(1),
      R => SR(0)
    );
\GEN_NARROW_EN.curr_narrow_burst_i_2\: unisim.vcomponents.LUT6
    generic map(
      INIT => X"00E000E000E00000"
    )
        port map (
      I0 => \GEN_NARROW_EN.curr_narrow_burst_reg\,
      I1 => \GEN_NARROW_EN.curr_narrow_burst_reg_0\,
      I2 => \^arb2aw_active\,
      I3 => aw_active_d1,
      I4 => s_axi_awburst(0),
      I5 => s_axi_awburst(1),
      O => curr_narrow_burst_en
    );
\GEN_NO_RD_CMD_OPT.GEN_AR_SNG.ar_active_d1_i_1\: unisim.vcomponents.LUT4
    generic map(
      INIT => X"0888"
    )
        port map (
      I0 => \^arb2ar_active\,
      I1 => s_axi_aresetn,
      I2 => s_axi_rready,
      I3 => \GEN_NO_RD_CMD_OPT.GEN_AR_SNG.ar_active_d1_reg\,
      O => ar_active_reg_0
    );
\GEN_NO_RD_CMD_OPT.GEN_NARROW_CNT.narrow_addr_int[1]_i_10\: unisim.vcomponents.LUT6
    generic map(
      INIT => X"DDDFDDDFDDDFFFFF"
    )
        port map (
      I0 => \^ar_active_re\,
      I1 => \GEN_NO_RD_CMD_OPT.GEN_NARROW_CNT.narrow_addr_int[1]_i_4_0\,
      I2 => s_axi_araddr(1),
      I3 => s_axi_araddr(0),
      I4 => s_axi_arburst(0),
      I5 => s_axi_arburst(1),
      O => \GEN_NO_RD_CMD_OPT.GEN_NARROW_CNT.narrow_addr_int[1]_i_10_n_0\
    );
\GEN_NO_RD_CMD_OPT.GEN_NARROW_CNT.narrow_addr_int[1]_i_4\: unisim.vcomponents.LUT6
    generic map(
      INIT => X"FFFFFFFFFF020000"
    )
        port map (
      I0 => \GEN_NO_RD_CMD_OPT.GEN_NARROW_CNT.narrow_addr_int_reg[1]\,
      I1 => \GEN_NO_RD_CMD_OPT.GEN_NARROW_CNT.narrow_addr_int_reg[1]_0\,
      I2 => \GEN_NO_RD_CMD_OPT.GEN_NARROW_CNT.narrow_addr_int_reg[1]_1\,
      I3 => s_axi_arburst(0),
      I4 => s_axi_arburst(1),
      I5 => \GEN_NO_RD_CMD_OPT.GEN_NARROW_CNT.narrow_addr_int[1]_i_10_n_0\,
      O => s_axi_arburst_0_sn_1
    );
\GEN_NO_RD_CMD_OPT.act_rd_burst_i_5\: unisim.vcomponents.LUT6
    generic map(
      INIT => X"AAAAAAAAAAAAAAA8"
    )
        port map (
      I0 => \^ar_active_re\,
      I1 => \GEN_NO_RD_CMD_OPT.act_rd_burst_two_reg\,
      I2 => s_axi_arlen(2),
      I3 => s_axi_arlen(0),
      I4 => s_axi_arlen(1),
      I5 => s_axi_arlen(3),
      O => \s_axi_arlen[6]\
    );
ar_active_i_2: unisim.vcomponents.LUT6
    generic map(
      INIT => X"00FF007000000070"
    )
        port map (
      I0 => \^last_arb_won\,
      I1 => s_axi_awvalid,
      I2 => s_axi_arvalid,
      I3 => \^q\(0),
      I4 => \^q\(1),
      I5 => axi_awready_int_reg_0,
      O => last_arb_won_reg_0
    );
ar_active_reg: unisim.vcomponents.FDRE
    generic map(
      INIT => '0'
    )
        port map (
      C => s_axi_aclk,
      CE => '1',
      D => ar_active_reg_1,
      Q => \^arb2ar_active\,
      R => SR(0)
    );
aw_active_reg: unisim.vcomponents.FDRE
    generic map(
      INIT => '0'
    )
        port map (
      C => s_axi_aclk,
      CE => '1',
      D => aw_active_reg_0,
      Q => \^arb2aw_active\,
      R => SR(0)
    );
axi_arready_int_i_1: unisim.vcomponents.LUT5
    generic map(
      INIT => X"FFFFF020"
    )
        port map (
      I0 => \^gen_no_rd_cmd_opt.axi_rlast_int_reg\,
      I1 => s_axi_awvalid,
      I2 => s_axi_arvalid,
      I3 => \^fsm_onehot_gen_wdata_sm_no_ecc_sng_reg_wready.wr_data_sng_sm_cs_reg[2]\,
      I4 => axi_arready_int_i_4_n_0,
      O => \^axi_arready_cmb\
    );
axi_arready_int_i_2: unisim.vcomponents.LUT4
    generic map(
      INIT => X"0080"
    )
        port map (
      I0 => \GEN_NO_RD_CMD_OPT.GEN_AR_SNG.ar_active_d1_reg\,
      I1 => s_axi_rready,
      I2 => \^q\(1),
      I3 => \^q\(0),
      O => \^gen_no_rd_cmd_opt.axi_rlast_int_reg\
    );
axi_arready_int_i_3: unisim.vcomponents.LUT3
    generic map(
      INIT => X"08"
    )
        port map (
      I0 => \FSM_sequential_arb_sm_cs_reg[0]_0\(0),
      I1 => \^q\(0),
      I2 => \^q\(1),
      O => \^fsm_onehot_gen_wdata_sm_no_ecc_sng_reg_wready.wr_data_sng_sm_cs_reg[2]\
    );
axi_arready_int_i_4: unisim.vcomponents.LUT5
    generic map(
      INIT => X"00101010"
    )
        port map (
      I0 => \^q\(0),
      I1 => \^q\(1),
      I2 => s_axi_arvalid,
      I3 => s_axi_awvalid,
      I4 => \^last_arb_won\,
      O => axi_arready_int_i_4_n_0
    );
axi_arready_int_reg: unisim.vcomponents.FDRE
    generic map(
      INIT => '0'
    )
        port map (
      C => s_axi_aclk,
      CE => '1',
      D => \^axi_arready_cmb\,
      Q => s_axi_arready,
      R => SR(0)
    );
axi_awready_int_i_1: unisim.vcomponents.LUT6
    generic map(
      INIT => X"0000AA000000F300"
    )
        port map (
      I0 => axi_awready_int_reg_0,
      I1 => s_axi_arvalid,
      I2 => \^last_arb_won\,
      I3 => axi_awready_int_reg_1,
      I4 => \^q\(0),
      I5 => \^q\(1),
      O => \^axi_awready_cmb\
    );
axi_awready_int_reg: unisim.vcomponents.FDRE
    generic map(
      INIT => '0'
    )
        port map (
      C => s_axi_aclk,
      CE => '1',
      D => \^axi_awready_cmb\,
      Q => s_axi_awready,
      R => SR(0)
    );
\bram_we_a[0]_INST_0\: unisim.vcomponents.LUT2
    generic map(
      INIT => X"8"
    )
        port map (
      I0 => \^arb2aw_active\,
      I1 => \bram_we_a[3]\(0),
      O => bram_we_a(0)
    );
\bram_we_a[1]_INST_0\: unisim.vcomponents.LUT2
    generic map(
      INIT => X"8"
    )
        port map (
      I0 => \^arb2aw_active\,
      I1 => \bram_we_a[3]\(1),
      O => bram_we_a(1)
    );
\bram_we_a[2]_INST_0\: unisim.vcomponents.LUT2
    generic map(
      INIT => X"8"
    )
        port map (
      I0 => \^arb2aw_active\,
      I1 => \bram_we_a[3]\(2),
      O => bram_we_a(2)
    );
\bram_we_a[3]_INST_0\: unisim.vcomponents.LUT2
    generic map(
      INIT => X"8"
    )
        port map (
      I0 => \^arb2aw_active\,
      I1 => \bram_we_a[3]\(3),
      O => bram_we_a(3)
    );
last_arb_won_reg: unisim.vcomponents.FDRE
    generic map(
      INIT => '0'
    )
        port map (
      C => s_axi_aclk,
      CE => '1',
      D => last_arb_won_reg_1,
      Q => \^last_arb_won\,
      R => SR(0)
    );
\save_init_bram_addr_ld[17]_i_1\: unisim.vcomponents.LUT2
    generic map(
      INIT => X"2"
    )
        port map (
      I0 => \^arb2aw_active\,
      I1 => aw_active_d1,
      O => E(0)
    );
\save_init_bram_addr_ld[17]_i_1__0\: unisim.vcomponents.LUT2
    generic map(
      INIT => X"2"
    )
        port map (
      I0 => \^arb2ar_active\,
      I1 => ar_active_d1,
      O => \^ar_active_re\
    );
end STRUCTURE;
library IEEE;
use IEEE.STD_LOGIC_1164.ALL;
library UNISIM;
use UNISIM.VCOMPONENTS.ALL;
entity decalper_eb_ot_sdeen_pot_pi_dehcac_xnilix_ua_narrow is
  port (
    D : out STD_LOGIC_VECTOR ( 1 downto 0 );
    s_axi_awsize : in STD_LOGIC_VECTOR ( 2 downto 0 );
    s_axi_awaddr : in STD_LOGIC_VECTOR ( 1 downto 0 );
    Q : in STD_LOGIC_VECTOR ( 1 downto 0 );
    \GEN_NARROW_CNT.narrow_addr_int_reg[0]\ : in STD_LOGIC;
    \GEN_NARROW_CNT.narrow_addr_int_reg[1]\ : in STD_LOGIC_VECTOR ( 1 downto 0 );
    \GEN_NARROW_CNT.narrow_addr_int_reg[0]_0\ : in STD_LOGIC;
    \GEN_NARROW_CNT.narrow_addr_int_reg[0]_1\ : in STD_LOGIC
  );
end decalper_eb_ot_sdeen_pot_pi_dehcac_xnilix_ua_narrow;

architecture STRUCTURE of decalper_eb_ot_sdeen_pot_pi_dehcac_xnilix_ua_narrow is
  signal \GEN_NARROW_CNT.narrow_addr_int[1]_i_5_n_0\ : STD_LOGIC;
  signal \ua_narrow_load1_carry_i_1__0_n_0\ : STD_LOGIC;
  signal ua_narrow_load1_carry_i_2_n_0 : STD_LOGIC;
  signal ua_narrow_load1_carry_i_3_n_0 : STD_LOGIC;
  signal ua_narrow_load1_carry_i_4_n_0 : STD_LOGIC;
  signal ua_narrow_load1_carry_n_6 : STD_LOGIC;
  signal ua_narrow_load1_carry_n_7 : STD_LOGIC;
  signal NLW_ua_narrow_load1_carry_CO_UNCONNECTED : STD_LOGIC_VECTOR ( 7 downto 2 );
  signal NLW_ua_narrow_load1_carry_O_UNCONNECTED : STD_LOGIC_VECTOR ( 7 downto 0 );
begin
\GEN_NARROW_CNT.narrow_addr_int[0]_i_1\: unisim.vcomponents.LUT6
    generic map(
      INIT => X"7444744474777444"
    )
        port map (
      I0 => Q(0),
      I1 => \GEN_NARROW_CNT.narrow_addr_int_reg[0]\,
      I2 => \GEN_NARROW_CNT.narrow_addr_int_reg[1]\(0),
      I3 => \GEN_NARROW_CNT.narrow_addr_int_reg[0]_0\,
      I4 => ua_narrow_load1_carry_n_6,
      I5 => \GEN_NARROW_CNT.narrow_addr_int_reg[0]_1\,
      O => D(0)
    );
\GEN_NARROW_CNT.narrow_addr_int[1]_i_2\: unisim.vcomponents.LUT6
    generic map(
      INIT => X"9F909F9F9F909090"
    )
        port map (
      I0 => Q(0),
      I1 => Q(1),
      I2 => \GEN_NARROW_CNT.narrow_addr_int_reg[0]\,
      I3 => \GEN_NARROW_CNT.narrow_addr_int_reg[1]\(1),
      I4 => \GEN_NARROW_CNT.narrow_addr_int_reg[0]_0\,
      I5 => \GEN_NARROW_CNT.narrow_addr_int[1]_i_5_n_0\,
      O => D(1)
    );
\GEN_NARROW_CNT.narrow_addr_int[1]_i_5\: unisim.vcomponents.LUT5
    generic map(
      INIT => X"AAAAA002"
    )
        port map (
      I0 => ua_narrow_load1_carry_n_6,
      I1 => s_axi_awaddr(1),
      I2 => s_axi_awsize(0),
      I3 => s_axi_awsize(1),
      I4 => s_axi_awsize(2),
      O => \GEN_NARROW_CNT.narrow_addr_int[1]_i_5_n_0\
    );
ua_narrow_load1_carry: unisim.vcomponents.CARRY8
     port map (
      CI => '1',
      CI_TOP => '0',
      CO(7 downto 2) => NLW_ua_narrow_load1_carry_CO_UNCONNECTED(7 downto 2),
      CO(1) => ua_narrow_load1_carry_n_6,
      CO(0) => ua_narrow_load1_carry_n_7,
      DI(7 downto 2) => B"000000",
      DI(1) => \ua_narrow_load1_carry_i_1__0_n_0\,
      DI(0) => ua_narrow_load1_carry_i_2_n_0,
      O(7 downto 0) => NLW_ua_narrow_load1_carry_O_UNCONNECTED(7 downto 0),
      S(7 downto 2) => B"000000",
      S(1) => ua_narrow_load1_carry_i_3_n_0,
      S(0) => ua_narrow_load1_carry_i_4_n_0
    );
\ua_narrow_load1_carry_i_1__0\: unisim.vcomponents.LUT5
    generic map(
      INIT => X"00010101"
    )
        port map (
      I0 => s_axi_awsize(1),
      I1 => s_axi_awsize(2),
      I2 => s_axi_awsize(0),
      I3 => s_axi_awaddr(0),
      I4 => s_axi_awaddr(1),
      O => \ua_narrow_load1_carry_i_1__0_n_0\
    );
ua_narrow_load1_carry_i_2: unisim.vcomponents.LUT4
    generic map(
      INIT => X"0002"
    )
        port map (
      I0 => s_axi_awsize(0),
      I1 => s_axi_awsize(1),
      I2 => s_axi_awsize(2),
      I3 => s_axi_awaddr(1),
      O => ua_narrow_load1_carry_i_2_n_0
    );
ua_narrow_load1_carry_i_3: unisim.vcomponents.LUT5
    generic map(
      INIT => X"FFFFFFF8"
    )
        port map (
      I0 => s_axi_awaddr(1),
      I1 => s_axi_awaddr(0),
      I2 => s_axi_awsize(0),
      I3 => s_axi_awsize(2),
      I4 => s_axi_awsize(1),
      O => ua_narrow_load1_carry_i_3_n_0
    );
ua_narrow_load1_carry_i_4: unisim.vcomponents.LUT5
    generic map(
      INIT => X"00000FC8"
    )
        port map (
      I0 => s_axi_awaddr(0),
      I1 => s_axi_awaddr(1),
      I2 => s_axi_awsize(0),
      I3 => s_axi_awsize(1),
      I4 => s_axi_awsize(2),
      O => ua_narrow_load1_carry_i_4_n_0
    );
end STRUCTURE;
library IEEE;
use IEEE.STD_LOGIC_1164.ALL;
library UNISIM;
use UNISIM.VCOMPONENTS.ALL;
entity decalper_eb_ot_sdeen_pot_pi_dehcac_xnilix_ua_narrow_0 is
  port (
    D : out STD_LOGIC_VECTOR ( 1 downto 0 );
    Q : in STD_LOGIC_VECTOR ( 1 downto 0 );
    \GEN_NO_RD_CMD_OPT.GEN_NARROW_CNT.narrow_addr_int_reg[0]\ : in STD_LOGIC;
    \GEN_NO_RD_CMD_OPT.GEN_NARROW_CNT.narrow_addr_int_reg[1]\ : in STD_LOGIC_VECTOR ( 1 downto 0 );
    \GEN_NO_RD_CMD_OPT.GEN_NARROW_CNT.narrow_addr_int_reg[1]_0\ : in STD_LOGIC;
    s_axi_arsize : in STD_LOGIC_VECTOR ( 2 downto 0 );
    s_axi_araddr : in STD_LOGIC_VECTOR ( 1 downto 0 )
  );
  attribute ORIG_REF_NAME : string;
  attribute ORIG_REF_NAME of decalper_eb_ot_sdeen_pot_pi_dehcac_xnilix_ua_narrow_0 : entity is "ua_narrow";
end decalper_eb_ot_sdeen_pot_pi_dehcac_xnilix_ua_narrow_0;

architecture STRUCTURE of decalper_eb_ot_sdeen_pot_pi_dehcac_xnilix_ua_narrow_0 is
  signal \GEN_NO_RD_CMD_OPT.GEN_NARROW_CNT.narrow_addr_int[0]_i_2_n_0\ : STD_LOGIC;
  signal \GEN_NO_RD_CMD_OPT.GEN_NARROW_CNT.narrow_addr_int[1]_i_5_n_0\ : STD_LOGIC;
  signal ua_narrow_load1_carry_i_1_n_0 : STD_LOGIC;
  signal \ua_narrow_load1_carry_i_2__0_n_0\ : STD_LOGIC;
  signal \ua_narrow_load1_carry_i_3__0_n_0\ : STD_LOGIC;
  signal \ua_narrow_load1_carry_i_4__0_n_0\ : STD_LOGIC;
  signal ua_narrow_load1_carry_n_6 : STD_LOGIC;
  signal ua_narrow_load1_carry_n_7 : STD_LOGIC;
  signal NLW_ua_narrow_load1_carry_CO_UNCONNECTED : STD_LOGIC_VECTOR ( 7 downto 2 );
  signal NLW_ua_narrow_load1_carry_O_UNCONNECTED : STD_LOGIC_VECTOR ( 7 downto 0 );
begin
\GEN_NO_RD_CMD_OPT.GEN_NARROW_CNT.narrow_addr_int[0]_i_1\: unisim.vcomponents.LUT5
    generic map(
      INIT => X"74777444"
    )
        port map (
      I0 => Q(0),
      I1 => \GEN_NO_RD_CMD_OPT.GEN_NARROW_CNT.narrow_addr_int_reg[0]\,
      I2 => \GEN_NO_RD_CMD_OPT.GEN_NARROW_CNT.narrow_addr_int_reg[1]\(0),
      I3 => \GEN_NO_RD_CMD_OPT.GEN_NARROW_CNT.narrow_addr_int_reg[1]_0\,
      I4 => \GEN_NO_RD_CMD_OPT.GEN_NARROW_CNT.narrow_addr_int[0]_i_2_n_0\,
      O => D(0)
    );
\GEN_NO_RD_CMD_OPT.GEN_NARROW_CNT.narrow_addr_int[0]_i_2\: unisim.vcomponents.LUT6
    generic map(
      INIT => X"AA88AA08AA88AA2A"
    )
        port map (
      I0 => ua_narrow_load1_carry_n_6,
      I1 => s_axi_arsize(0),
      I2 => s_axi_araddr(1),
      I3 => s_axi_arsize(2),
      I4 => s_axi_arsize(1),
      I5 => s_axi_araddr(0),
      O => \GEN_NO_RD_CMD_OPT.GEN_NARROW_CNT.narrow_addr_int[0]_i_2_n_0\
    );
\GEN_NO_RD_CMD_OPT.GEN_NARROW_CNT.narrow_addr_int[1]_i_2\: unisim.vcomponents.LUT6
    generic map(
      INIT => X"9F909F9F9F909090"
    )
        port map (
      I0 => Q(0),
      I1 => Q(1),
      I2 => \GEN_NO_RD_CMD_OPT.GEN_NARROW_CNT.narrow_addr_int_reg[0]\,
      I3 => \GEN_NO_RD_CMD_OPT.GEN_NARROW_CNT.narrow_addr_int_reg[1]\(1),
      I4 => \GEN_NO_RD_CMD_OPT.GEN_NARROW_CNT.narrow_addr_int_reg[1]_0\,
      I5 => \GEN_NO_RD_CMD_OPT.GEN_NARROW_CNT.narrow_addr_int[1]_i_5_n_0\,
      O => D(1)
    );
\GEN_NO_RD_CMD_OPT.GEN_NARROW_CNT.narrow_addr_int[1]_i_5\: unisim.vcomponents.LUT5
    generic map(
      INIT => X"AAAA8802"
    )
        port map (
      I0 => ua_narrow_load1_carry_n_6,
      I1 => s_axi_arsize(0),
      I2 => s_axi_araddr(1),
      I3 => s_axi_arsize(1),
      I4 => s_axi_arsize(2),
      O => \GEN_NO_RD_CMD_OPT.GEN_NARROW_CNT.narrow_addr_int[1]_i_5_n_0\
    );
ua_narrow_load1_carry: unisim.vcomponents.CARRY8
     port map (
      CI => '1',
      CI_TOP => '0',
      CO(7 downto 2) => NLW_ua_narrow_load1_carry_CO_UNCONNECTED(7 downto 2),
      CO(1) => ua_narrow_load1_carry_n_6,
      CO(0) => ua_narrow_load1_carry_n_7,
      DI(7 downto 2) => B"000000",
      DI(1) => ua_narrow_load1_carry_i_1_n_0,
      DI(0) => \ua_narrow_load1_carry_i_2__0_n_0\,
      O(7 downto 0) => NLW_ua_narrow_load1_carry_O_UNCONNECTED(7 downto 0),
      S(7 downto 2) => B"000000",
      S(1) => \ua_narrow_load1_carry_i_3__0_n_0\,
      S(0) => \ua_narrow_load1_carry_i_4__0_n_0\
    );
ua_narrow_load1_carry_i_1: unisim.vcomponents.LUT5
    generic map(
      INIT => X"00010011"
    )
        port map (
      I0 => s_axi_arsize(2),
      I1 => s_axi_arsize(1),
      I2 => s_axi_araddr(0),
      I3 => s_axi_arsize(0),
      I4 => s_axi_araddr(1),
      O => ua_narrow_load1_carry_i_1_n_0
    );
\ua_narrow_load1_carry_i_2__0\: unisim.vcomponents.LUT4
    generic map(
      INIT => X"0100"
    )
        port map (
      I0 => s_axi_arsize(2),
      I1 => s_axi_arsize(1),
      I2 => s_axi_araddr(1),
      I3 => s_axi_arsize(0),
      O => \ua_narrow_load1_carry_i_2__0_n_0\
    );
\ua_narrow_load1_carry_i_3__0\: unisim.vcomponents.LUT5
    generic map(
      INIT => X"FFFFFFEC"
    )
        port map (
      I0 => s_axi_araddr(1),
      I1 => s_axi_arsize(0),
      I2 => s_axi_araddr(0),
      I3 => s_axi_arsize(1),
      I4 => s_axi_arsize(2),
      O => \ua_narrow_load1_carry_i_3__0_n_0\
    );
\ua_narrow_load1_carry_i_4__0\: unisim.vcomponents.LUT5
    generic map(
      INIT => X"11540044"
    )
        port map (
      I0 => s_axi_arsize(2),
      I1 => s_axi_arsize(1),
      I2 => s_axi_araddr(0),
      I3 => s_axi_arsize(0),
      I4 => s_axi_araddr(1),
      O => \ua_narrow_load1_carry_i_4__0_n_0\
    );
end STRUCTURE;
library IEEE;
use IEEE.STD_LOGIC_1164.ALL;
library UNISIM;
use UNISIM.VCOMPONENTS.ALL;
entity decalper_eb_ot_sdeen_pot_pi_dehcac_xnilix_wrap_brst is
  port (
    \FSM_onehot_GEN_WDATA_SM_NO_ECC_SNG_REG_WREADY.wr_data_sng_sm_cs_reg[2]\ : out STD_LOGIC_VECTOR ( 0 to 0 );
    s_axi_wvalid_0 : out STD_LOGIC;
    D : out STD_LOGIC_VECTOR ( 5 downto 0 );
    aw_active_d1_reg : out STD_LOGIC;
    s_axi_awaddr_3_sp_1 : out STD_LOGIC;
    s_axi_awaddr_4_sp_1 : out STD_LOGIC;
    s_axi_awaddr_5_sp_1 : out STD_LOGIC;
    ar_active_reg : out STD_LOGIC_VECTOR ( 5 downto 0 );
    s_axi_awsize_2_sp_1 : out STD_LOGIC;
    Q : in STD_LOGIC_VECTOR ( 1 downto 0 );
    curr_fixed_burst_reg_reg : in STD_LOGIC;
    s_axi_aresetn : in STD_LOGIC;
    s_axi_wvalid : in STD_LOGIC;
    \save_init_bram_addr_ld_reg[6]_0\ : in STD_LOGIC;
    Arb2AW_Active : in STD_LOGIC;
    s_axi_awlen : in STD_LOGIC_VECTOR ( 3 downto 0 );
    s_axi_awvalid : in STD_LOGIC;
    s_axi_awaddr : in STD_LOGIC_VECTOR ( 14 downto 0 );
    \ADDR_SNG_PORT.bram_addr_int_reg[17]\ : in STD_LOGIC_VECTOR ( 5 downto 0 );
    Arb2AR_Active : in STD_LOGIC;
    \save_init_bram_addr_ld_reg[6]_1\ : in STD_LOGIC;
    curr_wrap_burst_reg : in STD_LOGIC;
    curr_narrow_burst : in STD_LOGIC;
    \save_init_bram_addr_ld[17]_i_3_0\ : in STD_LOGIC_VECTOR ( 1 downto 0 );
    narrow_bram_addr_inc_d1 : in STD_LOGIC;
    s_axi_awsize : in STD_LOGIC_VECTOR ( 2 downto 0 );
    \save_init_bram_addr_ld[17]_i_3_1\ : in STD_LOGIC_VECTOR ( 2 downto 0 );
    SR : in STD_LOGIC_VECTOR ( 0 to 0 );
    E : in STD_LOGIC_VECTOR ( 0 to 0 );
    s_axi_aclk : in STD_LOGIC
  );
end decalper_eb_ot_sdeen_pot_pi_dehcac_xnilix_wrap_brst;

architecture STRUCTURE of decalper_eb_ot_sdeen_pot_pi_dehcac_xnilix_wrap_brst is
  signal \^d\ : STD_LOGIC_VECTOR ( 5 downto 0 );
  signal WrChnl_BRAM_Addr_Ld : STD_LOGIC_VECTOR ( 17 downto 3 );
  signal \^aw_active_d1_reg\ : STD_LOGIC;
  signal data0 : STD_LOGIC_VECTOR ( 15 downto 1 );
  signal s_axi_awaddr_3_sn_1 : STD_LOGIC;
  signal s_axi_awaddr_4_sn_1 : STD_LOGIC;
  signal s_axi_awaddr_5_sn_1 : STD_LOGIC;
  signal s_axi_awsize_2_sn_1 : STD_LOGIC;
  signal \^s_axi_wvalid_0\ : STD_LOGIC;
  signal \save_init_bram_addr_ld[17]_i_3_n_0\ : STD_LOGIC;
  signal \save_init_bram_addr_ld[17]_i_4_n_0\ : STD_LOGIC;
  signal \save_init_bram_addr_ld[17]_i_5_n_0\ : STD_LOGIC;
  signal \save_init_bram_addr_ld[17]_i_6_n_0\ : STD_LOGIC;
  signal wrap_burst_total : STD_LOGIC_VECTOR ( 2 downto 0 );
  signal \wrap_burst_total[0]_i_1_n_0\ : STD_LOGIC;
  signal \wrap_burst_total[0]_i_2_n_0\ : STD_LOGIC;
  signal \wrap_burst_total[1]_i_1_n_0\ : STD_LOGIC;
  signal \wrap_burst_total[1]_i_2_n_0\ : STD_LOGIC;
  signal \wrap_burst_total[1]_i_3_n_0\ : STD_LOGIC;
  signal \wrap_burst_total[1]_i_4_n_0\ : STD_LOGIC;
  signal \wrap_burst_total[2]_i_1_n_0\ : STD_LOGIC;
  attribute SOFT_HLUTNM : string;
  attribute SOFT_HLUTNM of \ADDR_SNG_PORT.bram_addr_int[17]_i_7\ : label is "soft_lutpair33";
  attribute SOFT_HLUTNM of \save_init_bram_addr_ld[11]_i_1__0\ : label is "soft_lutpair33";
  attribute SOFT_HLUTNM of \wrap_burst_total[0]_i_2\ : label is "soft_lutpair34";
  attribute SOFT_HLUTNM of \wrap_burst_total[1]_i_3\ : label is "soft_lutpair35";
  attribute SOFT_HLUTNM of \wrap_burst_total[1]_i_4\ : label is "soft_lutpair35";
  attribute SOFT_HLUTNM of \wrap_burst_total[2]_i_2\ : label is "soft_lutpair34";
begin
  D(5 downto 0) <= \^d\(5 downto 0);
  aw_active_d1_reg <= \^aw_active_d1_reg\;
  s_axi_awaddr_3_sp_1 <= s_axi_awaddr_3_sn_1;
  s_axi_awaddr_4_sp_1 <= s_axi_awaddr_4_sn_1;
  s_axi_awaddr_5_sp_1 <= s_axi_awaddr_5_sn_1;
  s_axi_awsize_2_sp_1 <= s_axi_awsize_2_sn_1;
  s_axi_wvalid_0 <= \^s_axi_wvalid_0\;
\ADDR_SNG_PORT.bram_addr_int[12]_i_1\: unisim.vcomponents.LUT5
    generic map(
      INIT => X"B8BBB888"
    )
        port map (
      I0 => \ADDR_SNG_PORT.bram_addr_int_reg[17]\(0),
      I1 => Arb2AR_Active,
      I2 => s_axi_awaddr(9),
      I3 => \^aw_active_d1_reg\,
      I4 => data0(10),
      O => ar_active_reg(0)
    );
\ADDR_SNG_PORT.bram_addr_int[13]_i_1\: unisim.vcomponents.LUT5
    generic map(
      INIT => X"B8BBB888"
    )
        port map (
      I0 => \ADDR_SNG_PORT.bram_addr_int_reg[17]\(1),
      I1 => Arb2AR_Active,
      I2 => s_axi_awaddr(10),
      I3 => \^aw_active_d1_reg\,
      I4 => data0(11),
      O => ar_active_reg(1)
    );
\ADDR_SNG_PORT.bram_addr_int[14]_i_1\: unisim.vcomponents.LUT5
    generic map(
      INIT => X"B8BBB888"
    )
        port map (
      I0 => \ADDR_SNG_PORT.bram_addr_int_reg[17]\(2),
      I1 => Arb2AR_Active,
      I2 => s_axi_awaddr(11),
      I3 => \^aw_active_d1_reg\,
      I4 => data0(12),
      O => ar_active_reg(2)
    );
\ADDR_SNG_PORT.bram_addr_int[15]_i_1\: unisim.vcomponents.LUT5
    generic map(
      INIT => X"B8BBB888"
    )
        port map (
      I0 => \ADDR_SNG_PORT.bram_addr_int_reg[17]\(3),
      I1 => Arb2AR_Active,
      I2 => s_axi_awaddr(12),
      I3 => \^aw_active_d1_reg\,
      I4 => data0(13),
      O => ar_active_reg(3)
    );
\ADDR_SNG_PORT.bram_addr_int[16]_i_1\: unisim.vcomponents.LUT5
    generic map(
      INIT => X"B8BBB888"
    )
        port map (
      I0 => \ADDR_SNG_PORT.bram_addr_int_reg[17]\(4),
      I1 => Arb2AR_Active,
      I2 => s_axi_awaddr(13),
      I3 => \^aw_active_d1_reg\,
      I4 => data0(14),
      O => ar_active_reg(4)
    );
\ADDR_SNG_PORT.bram_addr_int[17]_i_1\: unisim.vcomponents.LUT4
    generic map(
      INIT => X"04FF"
    )
        port map (
      I0 => \^s_axi_wvalid_0\,
      I1 => Q(1),
      I2 => curr_fixed_burst_reg_reg,
      I3 => s_axi_aresetn,
      O => \FSM_onehot_GEN_WDATA_SM_NO_ECC_SNG_REG_WREADY.wr_data_sng_sm_cs_reg[2]\(0)
    );
\ADDR_SNG_PORT.bram_addr_int[17]_i_3\: unisim.vcomponents.LUT5
    generic map(
      INIT => X"B8BBB888"
    )
        port map (
      I0 => \ADDR_SNG_PORT.bram_addr_int_reg[17]\(5),
      I1 => Arb2AR_Active,
      I2 => s_axi_awaddr(14),
      I3 => \^aw_active_d1_reg\,
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
    generic map(
      INIT => X"FF0BF400"
    )
        port map (
      I0 => \save_init_bram_addr_ld_reg[6]_0\,
      I1 => Arb2AW_Active,
      I2 => \save_init_bram_addr_ld[17]_i_3_n_0\,
      I3 => s_axi_awaddr(14),
      I4 => data0(15),
      O => WrChnl_BRAM_Addr_Ld(17)
    );
\save_init_bram_addr_ld[17]_i_3\: unisim.vcomponents.LUT5
    generic map(
      INIT => X"FFFF54FF"
    )
        port map (
      I0 => \save_init_bram_addr_ld[17]_i_4_n_0\,
      I1 => \save_init_bram_addr_ld_reg[6]_1\,
      I2 => \save_init_bram_addr_ld[17]_i_5_n_0\,
      I3 => curr_wrap_burst_reg,
      I4 => \save_init_bram_addr_ld[17]_i_6_n_0\,
      O => \save_init_bram_addr_ld[17]_i_3_n_0\
    );
\save_init_bram_addr_ld[17]_i_4\: unisim.vcomponents.LUT6
    generic map(
      INIT => X"000000008F00C000"
    )
        port map (
      I0 => \save_init_bram_addr_ld[17]_i_3_1\(2),
      I1 => \save_init_bram_addr_ld[17]_i_3_1\(1),
      I2 => wrap_burst_total(1),
      I3 => \save_init_bram_addr_ld[17]_i_3_1\(0),
      I4 => wrap_burst_total(0),
      I5 => wrap_burst_total(2),
      O => \save_init_bram_addr_ld[17]_i_4_n_0\
    );
\save_init_bram_addr_ld[17]_i_5\: unisim.vcomponents.LUT3
    generic map(
      INIT => X"FB"
    )
        port map (
      I0 => wrap_burst_total(0),
      I1 => wrap_burst_total(2),
      I2 => wrap_burst_total(1),
      O => \save_init_bram_addr_ld[17]_i_5_n_0\
    );
\save_init_bram_addr_ld[17]_i_6\: unisim.vcomponents.LUT6
    generic map(
      INIT => X"AAAAAAAAAAAAAA2A"
    )
        port map (
      I0 => curr_narrow_burst,
      I1 => s_axi_wvalid,
      I2 => Q(0),
      I3 => \save_init_bram_addr_ld[17]_i_3_0\(1),
      I4 => \save_init_bram_addr_ld[17]_i_3_0\(0),
      I5 => narrow_bram_addr_inc_d1,
      O => \save_init_bram_addr_ld[17]_i_6_n_0\
    );
\save_init_bram_addr_ld[3]_i_1\: unisim.vcomponents.LUT6
    generic map(
      INIT => X"FFFFB0900000B090"
    )
        port map (
      I0 => wrap_burst_total(2),
      I1 => wrap_burst_total(1),
      I2 => data0(1),
      I3 => wrap_burst_total(0),
      I4 => \^aw_active_d1_reg\,
      I5 => s_axi_awaddr(0),
      O => WrChnl_BRAM_Addr_Ld(3)
    );
\save_init_bram_addr_ld[4]_i_1\: unisim.vcomponents.LUT6
    generic map(
      INIT => X"FFFFDB000000DB00"
    )
        port map (
      I0 => wrap_burst_total(1),
      I1 => wrap_burst_total(2),
      I2 => wrap_burst_total(0),
      I3 => data0(2),
      I4 => \^aw_active_d1_reg\,
      I5 => s_axi_awaddr(1),
      O => WrChnl_BRAM_Addr_Ld(4)
    );
\save_init_bram_addr_ld[5]_i_1\: unisim.vcomponents.LUT6
    generic map(
      INIT => X"FFFFFB000000FB00"
    )
        port map (
      I0 => wrap_burst_total(0),
      I1 => wrap_burst_total(2),
      I2 => wrap_burst_total(1),
      I3 => data0(3),
      I4 => \^aw_active_d1_reg\,
      I5 => s_axi_awaddr(2),
      O => WrChnl_BRAM_Addr_Ld(5)
    );
\save_init_bram_addr_ld[6]_i_1__0\: unisim.vcomponents.LUT5
    generic map(
      INIT => X"FF0BF400"
    )
        port map (
      I0 => \save_init_bram_addr_ld_reg[6]_0\,
      I1 => Arb2AW_Active,
      I2 => \save_init_bram_addr_ld[17]_i_3_n_0\,
      I3 => s_axi_awaddr(3),
      I4 => data0(4),
      O => \^d\(0)
    );
\save_init_bram_addr_ld[7]_i_1__0\: unisim.vcomponents.LUT5
    generic map(
      INIT => X"FF0BF400"
    )
        port map (
      I0 => \save_init_bram_addr_ld_reg[6]_0\,
      I1 => Arb2AW_Active,
      I2 => \save_init_bram_addr_ld[17]_i_3_n_0\,
      I3 => s_axi_awaddr(4),
      I4 => data0(5),
      O => \^d\(1)
    );
\save_init_bram_addr_ld[8]_i_1__0\: unisim.vcomponents.LUT5
    generic map(
      INIT => X"FF0BF400"
    )
        port map (
      I0 => \save_init_bram_addr_ld_reg[6]_0\,
      I1 => Arb2AW_Active,
      I2 => \save_init_bram_addr_ld[17]_i_3_n_0\,
      I3 => s_axi_awaddr(5),
      I4 => data0(6),
      O => \^d\(2)
    );
\save_init_bram_addr_ld[9]_i_1__0\: unisim.vcomponents.LUT5
    generic map(
      INIT => X"FF0BF400"
    )
        port map (
      I0 => \save_init_bram_addr_ld_reg[6]_0\,
      I1 => Arb2AW_Active,
      I2 => \save_init_bram_addr_ld[17]_i_3_n_0\,
      I3 => s_axi_awaddr(6),
      I4 => data0(7),
      O => \^d\(3)
    );
\save_init_bram_addr_ld_reg[10]\: unisim.vcomponents.FDRE
    generic map(
      INIT => '0'
    )
        port map (
      C => s_axi_aclk,
      CE => E(0),
      D => \^d\(4),
      Q => data0(8),
      R => SR(0)
    );
\save_init_bram_addr_ld_reg[11]\: unisim.vcomponents.FDRE
    generic map(
      INIT => '0'
    )
        port map (
      C => s_axi_aclk,
      CE => E(0),
      D => \^d\(5),
      Q => data0(9),
      R => SR(0)
    );
\save_init_bram_addr_ld_reg[12]\: unisim.vcomponents.FDRE
    generic map(
      INIT => '0'
    )
        port map (
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
    );
\wrap_burst_total[1]_i_3\: unisim.vcomponents.LUT4
    generic map(
      INIT => X"BFFF"
    )
        port map (
      I0 => s_axi_awlen(3),
      I1 => s_axi_awlen(1),
      I2 => s_axi_awvalid,
      I3 => s_axi_awlen(0),
      O => \wrap_burst_total[1]_i_3_n_0\
    );
\wrap_burst_total[1]_i_4\: unisim.vcomponents.LUT4
    generic map(
      INIT => X"7FFF"
    )
        port map (
      I0 => s_axi_awlen(1),
      I1 => s_axi_awvalid,
      I2 => s_axi_awlen(0),
      I3 => s_axi_awlen(2),
      O => \wrap_burst_total[1]_i_4_n_0\
    );
\wrap_burst_total[2]_i_1\: unisim.vcomponents.LUT6
    generic map(
      INIT => X"8000000000000000"
    )
        port map (
      I0 => s_axi_awsize_2_sn_1,
      I1 => s_axi_awvalid,
      I2 => s_axi_awlen(3),
      I3 => s_axi_awlen(1),
      I4 => s_axi_awlen(0),
      I5 => s_axi_awlen(2),
      O => \wrap_burst_total[2]_i_1_n_0\
    );
\wrap_burst_total[2]_i_2\: unisim.vcomponents.LUT3
    generic map(
      INIT => X"04"
    )
        port map (
      I0 => s_axi_awsize(2),
      I1 => s_axi_awsize(1),
      I2 => s_axi_awsize(0),
      O => s_axi_awsize_2_sn_1
    );
\wrap_burst_total_reg[0]\: unisim.vcomponents.FDRE
    generic map(
      INIT => '0'
    )
        port map (
      C => s_axi_aclk,
      CE => E(0),
      D => \wrap_burst_total[0]_i_1_n_0\,
      Q => wrap_burst_total(0),
      R => SR(0)
    );
\wrap_burst_total_reg[1]\: unisim.vcomponents.FDRE
    generic map(
      INIT => '0'
    )
        port map (
      C => s_axi_aclk,
      CE => E(0),
      D => \wrap_burst_total[1]_i_1_n_0\,
      Q => wrap_burst_total(1),
      R => SR(0)
    );
\wrap_burst_total_reg[2]\: unisim.vcomponents.FDRE
    generic map(
      INIT => '0'
    )
        port map (
      C => s_axi_aclk,
      CE => E(0),
      D => \wrap_burst_total[2]_i_1_n_0\,
      Q => wrap_burst_total(2),
      R => SR(0)
    );
end STRUCTURE;
library IEEE;
use IEEE.STD_LOGIC_1164.ALL;
library UNISIM;
use UNISIM.VCOMPONENTS.ALL;
entity decalper_eb_ot_sdeen_pot_pi_dehcac_xnilix_wrap_brst_1 is
  port (
    s_axi_arsize_2_sp_1 : out STD_LOGIC;
    E : out STD_LOGIC_VECTOR ( 1 downto 0 );
    D : out STD_LOGIC_VECTOR ( 9 downto 0 );
    \ADDR_SNG_PORT.bram_addr_int_reg[2]\ : out STD_LOGIC;
    \save_init_bram_addr_ld_reg[17]_0\ : out STD_LOGIC_VECTOR ( 5 downto 0 );
    \FSM_sequential_GEN_NO_RD_CMD_OPT.rd_data_sm_cs_reg[1]\ : out STD_LOGIC;
    s_axi_rready_0 : out STD_LOGIC;
    SR : out STD_LOGIC_VECTOR ( 0 to 0 );
    axi_rd_burst : in STD_LOGIC;
    \GEN_NO_RD_CMD_OPT.GEN_NARROW_CNT.narrow_bram_addr_inc_d1_i_2_0\ : in STD_LOGIC;
    Q : in STD_LOGIC_VECTOR ( 3 downto 0 );
    s_axi_arsize : in STD_LOGIC_VECTOR ( 2 downto 0 );
    \ADDR_SNG_PORT.bram_addr_int_reg[2]_0\ : in STD_LOGIC;
    Arb2AR_Active : in STD_LOGIC;
    \ADDR_SNG_PORT.bram_addr_int_reg[2]_1\ : in STD_LOGIC;
    \ADDR_SNG_PORT.bram_addr_int_reg[11]\ : in STD_LOGIC_VECTOR ( 9 downto 0 );
    \ADDR_SNG_PORT.bram_addr_int_reg[11]_0\ : in STD_LOGIC_VECTOR ( 5 downto 0 );
    \ADDR_SNG_PORT.bram_addr_int_reg[7]\ : in STD_LOGIC;
    \ADDR_SNG_PORT.bram_addr_int_reg[8]\ : in STD_LOGIC;
    \ADDR_SNG_PORT.bram_addr_int_reg[9]\ : in STD_LOGIC;
    \ADDR_SNG_PORT.bram_addr_int_reg[10]\ : in STD_LOGIC;
    \ADDR_SNG_PORT.bram_addr_int_reg[3]\ : in STD_LOGIC;
    \ADDR_SNG_PORT.bram_addr_int_reg[4]\ : in STD_LOGIC;
    \ADDR_SNG_PORT.bram_addr_int_reg[4]_0\ : in STD_LOGIC;
    \ADDR_SNG_PORT.bram_addr_int_reg[5]\ : in STD_LOGIC;
    \ADDR_SNG_PORT.bram_addr_int_reg[5]_0\ : in STD_LOGIC;
    \ADDR_SNG_PORT.bram_addr_int_reg[11]_1\ : in STD_LOGIC;
    \ADDR_SNG_PORT.bram_addr_int_reg[11]_2\ : in STD_LOGIC;
    curr_fixed_burst_reg : in STD_LOGIC;
    \ADDR_SNG_PORT.bram_addr_int_reg[11]_3\ : in STD_LOGIC;
    s_axi_araddr : in STD_LOGIC_VECTOR ( 15 downto 0 );
    s_axi_awaddr : in STD_LOGIC_VECTOR ( 0 to 0 );
    \ADDR_SNG_PORT.bram_addr_int_reg[2]_2\ : in STD_LOGIC;
    curr_narrow_burst : in STD_LOGIC;
    narrow_bram_addr_inc_d1 : in STD_LOGIC;
    \ADDR_SNG_PORT.bram_addr_int_reg[2]_3\ : in STD_LOGIC_VECTOR ( 1 downto 0 );
    s_axi_rready : in STD_LOGIC;
    \GEN_NO_RD_CMD_OPT.bram_en_int_i_2\ : in STD_LOGIC;
    end_brst_rd : in STD_LOGIC;
    brst_zero : in STD_LOGIC;
    s_axi_aresetn : in STD_LOGIC;
    s_axi_arlen : in STD_LOGIC_VECTOR ( 3 downto 0 );
    curr_wrap_burst_reg : in STD_LOGIC;
    ar_active_re : in STD_LOGIC;
    s_axi_aclk : in STD_LOGIC
  );
  attribute ORIG_REF_NAME : string;
  attribute ORIG_REF_NAME of decalper_eb_ot_sdeen_pot_pi_dehcac_xnilix_wrap_brst_1 : entity is "wrap_brst";
end decalper_eb_ot_sdeen_pot_pi_dehcac_xnilix_wrap_brst_1;

architecture STRUCTURE of decalper_eb_ot_sdeen_pot_pi_dehcac_xnilix_wrap_brst_1 is
  signal \ADDR_SNG_PORT.bram_addr_int[11]_i_3_n_0\ : STD_LOGIC;
  signal \ADDR_SNG_PORT.bram_addr_int[17]_i_10_n_0\ : STD_LOGIC;
  signal \ADDR_SNG_PORT.bram_addr_int[17]_i_6_n_0\ : STD_LOGIC;
  signal \ADDR_SNG_PORT.bram_addr_int[17]_i_9_n_0\ : STD_LOGIC;
  signal \ADDR_SNG_PORT.bram_addr_int[2]_i_2_n_0\ : STD_LOGIC;
  signal \^addr_sng_port.bram_addr_int_reg[2]\ : STD_LOGIC;
  signal \^fsm_sequential_gen_no_rd_cmd_opt.rd_data_sm_cs_reg[1]\ : STD_LOGIC;
  signal \GEN_NO_RD_CMD_OPT.GEN_NARROW_CNT.narrow_bram_addr_inc_d1_i_3_n_0\ : STD_LOGIC;
  signal \GEN_NO_RD_CMD_OPT.GEN_NARROW_CNT.narrow_bram_addr_inc_d1_i_4_n_0\ : STD_LOGIC;
  signal \GEN_NO_RD_CMD_OPT.GEN_NARROW_CNT.narrow_bram_addr_inc_d1_i_6_n_0\ : STD_LOGIC;
  signal RdChnl_BRAM_Addr_Ld : STD_LOGIC_VECTOR ( 11 downto 3 );
  signal \^sr\ : STD_LOGIC_VECTOR ( 0 to 0 );
  signal data0 : STD_LOGIC_VECTOR ( 15 downto 1 );
  signal s_axi_arsize_2_sn_1 : STD_LOGIC;
  signal \^s_axi_rready_0\ : STD_LOGIC;
  signal \^save_init_bram_addr_ld_reg[17]_0\ : STD_LOGIC_VECTOR ( 5 downto 0 );
  signal wrap_burst_total : STD_LOGIC_VECTOR ( 2 downto 0 );
  signal \wrap_burst_total[0]_i_1__0_n_0\ : STD_LOGIC;
  signal \wrap_burst_total[0]_i_2__0_n_0\ : STD_LOGIC;
  signal \wrap_burst_total[1]_i_1__0_n_0\ : STD_LOGIC;
  signal \wrap_burst_total[1]_i_2__0_n_0\ : STD_LOGIC;
  signal \wrap_burst_total[2]_i_1__0_n_0\ : STD_LOGIC;
  attribute SOFT_HLUTNM : string;
  attribute SOFT_HLUTNM of \wrap_burst_total[0]_i_2__0\ : label is "soft_lutpair5";
  attribute SOFT_HLUTNM of \wrap_burst_total[1]_i_2__0\ : label is "soft_lutpair4";
  attribute SOFT_HLUTNM of \wrap_burst_total[2]_i_1__0\ : label is "soft_lutpair4";
  attribute SOFT_HLUTNM of \wrap_burst_total[2]_i_2__0\ : label is "soft_lutpair5";
begin
  \ADDR_SNG_PORT.bram_addr_int_reg[2]\ <= \^addr_sng_port.bram_addr_int_reg[2]\;
  \FSM_sequential_GEN_NO_RD_CMD_OPT.rd_data_sm_cs_reg[1]\ <= \^fsm_sequential_gen_no_rd_cmd_opt.rd_data_sm_cs_reg[1]\;
  SR(0) <= \^sr\(0);
  s_axi_arsize_2_sp_1 <= s_axi_arsize_2_sn_1;
  s_axi_rready_0 <= \^s_axi_rready_0\;
  \save_init_bram_addr_ld_reg[17]_0\(5 downto 0) <= \^save_init_bram_addr_ld_reg[17]_0\(5 downto 0);
\ADDR_SNG_PORT.bram_addr_int[10]_i_1\: unisim.vcomponents.LUT6
    generic map(
      INIT => X"6F606F6F6F606060"
    )
        port map (
      I0 => \ADDR_SNG_PORT.bram_addr_int_reg[11]\(8),
      I1 => \ADDR_SNG_PORT.bram_addr_int_reg[10]\,
      I2 => \ADDR_SNG_PORT.bram_addr_int[11]_i_3_n_0\,
      I3 => RdChnl_BRAM_Addr_Ld(10),
      I4 => Arb2AR_Active,
      I5 => \ADDR_SNG_PORT.bram_addr_int_reg[11]_0\(4),
      O => D(8)
    );
\ADDR_SNG_PORT.bram_addr_int[11]_i_1\: unisim.vcomponents.LUT5
    generic map(
      INIT => X"5FDF55D5"
    )
        port map (
      I0 => \ADDR_SNG_PORT.bram_addr_int[11]_i_3_n_0\,
      I1 => \ADDR_SNG_PORT.bram_addr_int_reg[11]_2\,
      I2 => Arb2AR_Active,
      I3 => curr_fixed_burst_reg,
      I4 => \ADDR_SNG_PORT.bram_addr_int_reg[11]_3\,
      O => E(0)
    );
\ADDR_SNG_PORT.bram_addr_int[11]_i_2\: unisim.vcomponents.LUT6
    generic map(
      INIT => X"6F606F6F6F606060"
    )
        port map (
      I0 => \ADDR_SNG_PORT.bram_addr_int_reg[11]\(9),
      I1 => \ADDR_SNG_PORT.bram_addr_int_reg[11]_1\,
      I2 => \ADDR_SNG_PORT.bram_addr_int[11]_i_3_n_0\,
      I3 => RdChnl_BRAM_Addr_Ld(11),
      I4 => Arb2AR_Active,
      I5 => \ADDR_SNG_PORT.bram_addr_int_reg[11]_0\(5),
      O => D(9)
    );
\ADDR_SNG_PORT.bram_addr_int[11]_i_3\: unisim.vcomponents.LUT4
    generic map(
      INIT => X"1101"
    )
        port map (
      I0 => \ADDR_SNG_PORT.bram_addr_int[17]_i_6_n_0\,
      I1 => \ADDR_SNG_PORT.bram_addr_int_reg[2]_0\,
      I2 => Arb2AR_Active,
      I3 => \ADDR_SNG_PORT.bram_addr_int_reg[2]_1\,
      O => \ADDR_SNG_PORT.bram_addr_int[11]_i_3_n_0\
    );
\ADDR_SNG_PORT.bram_addr_int[17]_i_10\: unisim.vcomponents.LUT6
    generic map(
      INIT => X"080F00000A000000"
    )
        port map (
      I0 => \ADDR_SNG_PORT.bram_addr_int_reg[11]\(1),
      I1 => \ADDR_SNG_PORT.bram_addr_int_reg[11]\(2),
      I2 => wrap_burst_total(2),
      I3 => wrap_burst_total(1),
      I4 => \ADDR_SNG_PORT.bram_addr_int_reg[11]\(0),
      I5 => wrap_burst_total(0),
      O => \ADDR_SNG_PORT.bram_addr_int[17]_i_10_n_0\
    );
\ADDR_SNG_PORT.bram_addr_int[17]_i_2\: unisim.vcomponents.LUT4
    generic map(
      INIT => X"EEFE"
    )
        port map (
      I0 => \ADDR_SNG_PORT.bram_addr_int[17]_i_6_n_0\,
      I1 => \ADDR_SNG_PORT.bram_addr_int_reg[2]_0\,
      I2 => Arb2AR_Active,
      I3 => \ADDR_SNG_PORT.bram_addr_int_reg[2]_1\,
      O => E(1)
    );
\ADDR_SNG_PORT.bram_addr_int[17]_i_6\: unisim.vcomponents.LUT6
    generic map(
      INIT => X"0000000011111113"
    )
        port map (
      I0 => curr_narrow_burst,
      I1 => \^fsm_sequential_gen_no_rd_cmd_opt.rd_data_sm_cs_reg[1]\,
      I2 => narrow_bram_addr_inc_d1,
      I3 => \ADDR_SNG_PORT.bram_addr_int_reg[2]_3\(0),
      I4 => \ADDR_SNG_PORT.bram_addr_int_reg[2]_3\(1),
      I5 => \ADDR_SNG_PORT.bram_addr_int[17]_i_9_n_0\,
      O => \ADDR_SNG_PORT.bram_addr_int[17]_i_6_n_0\
    );
\ADDR_SNG_PORT.bram_addr_int[17]_i_9\: unisim.vcomponents.LUT6
    generic map(
      INIT => X"55555555FFFFFDFF"
    )
        port map (
      I0 => curr_wrap_burst_reg,
      I1 => \^addr_sng_port.bram_addr_int_reg[2]\,
      I2 => wrap_burst_total(1),
      I3 => wrap_burst_total(2),
      I4 => wrap_burst_total(0),
      I5 => \ADDR_SNG_PORT.bram_addr_int[17]_i_10_n_0\,
      O => \ADDR_SNG_PORT.bram_addr_int[17]_i_9_n_0\
    );
\ADDR_SNG_PORT.bram_addr_int[2]_i_1\: unisim.vcomponents.LUT6
    generic map(
      INIT => X"EEFE0000FFFF1101"
    )
        port map (
      I0 => \ADDR_SNG_PORT.bram_addr_int[17]_i_6_n_0\,
      I1 => \ADDR_SNG_PORT.bram_addr_int_reg[2]_0\,
      I2 => Arb2AR_Active,
      I3 => \ADDR_SNG_PORT.bram_addr_int_reg[2]_1\,
      I4 => \ADDR_SNG_PORT.bram_addr_int[2]_i_2_n_0\,
      I5 => \ADDR_SNG_PORT.bram_addr_int_reg[11]\(0),
      O => D(0)
    );
\ADDR_SNG_PORT.bram_addr_int[2]_i_2\: unisim.vcomponents.LUT5
    generic map(
      INIT => X"2F202020"
    )
        port map (
      I0 => s_axi_araddr(0),
      I1 => \ADDR_SNG_PORT.bram_addr_int[17]_i_6_n_0\,
      I2 => Arb2AR_Active,
      I3 => s_axi_awaddr(0),
      I4 => \ADDR_SNG_PORT.bram_addr_int_reg[2]_2\,
      O => \ADDR_SNG_PORT.bram_addr_int[2]_i_2_n_0\
    );
\ADDR_SNG_PORT.bram_addr_int[3]_i_1\: unisim.vcomponents.LUT6
    generic map(
      INIT => X"6F6F606F6060606F"
    )
        port map (
      I0 => \ADDR_SNG_PORT.bram_addr_int_reg[11]\(0),
      I1 => \ADDR_SNG_PORT.bram_addr_int_reg[11]\(1),
      I2 => \ADDR_SNG_PORT.bram_addr_int[11]_i_3_n_0\,
      I3 => \ADDR_SNG_PORT.bram_addr_int_reg[3]\,
      I4 => Arb2AR_Active,
      I5 => RdChnl_BRAM_Addr_Ld(3),
      O => D(1)
    );
\ADDR_SNG_PORT.bram_addr_int[4]_i_1\: unisim.vcomponents.LUT6
    generic map(
      INIT => X"6F6F606F6060606F"
    )
        port map (
      I0 => \ADDR_SNG_PORT.bram_addr_int_reg[11]\(2),
      I1 => \ADDR_SNG_PORT.bram_addr_int_reg[4]\,
      I2 => \ADDR_SNG_PORT.bram_addr_int[11]_i_3_n_0\,
      I3 => \ADDR_SNG_PORT.bram_addr_int_reg[4]_0\,
      I4 => Arb2AR_Active,
      I5 => RdChnl_BRAM_Addr_Ld(4),
      O => D(2)
    );
\ADDR_SNG_PORT.bram_addr_int[5]_i_1\: unisim.vcomponents.LUT6
    generic map(
      INIT => X"9F9F909F9090909F"
    )
        port map (
      I0 => \ADDR_SNG_PORT.bram_addr_int_reg[11]\(3),
      I1 => \ADDR_SNG_PORT.bram_addr_int_reg[5]\,
      I2 => \ADDR_SNG_PORT.bram_addr_int[11]_i_3_n_0\,
      I3 => \ADDR_SNG_PORT.bram_addr_int_reg[5]_0\,
      I4 => Arb2AR_Active,
      I5 => RdChnl_BRAM_Addr_Ld(5),
      O => D(3)
    );
\ADDR_SNG_PORT.bram_addr_int[6]_i_1\: unisim.vcomponents.LUT6
    generic map(
      INIT => X"9F909F9F9F909090"
    )
        port map (
      I0 => \^addr_sng_port.bram_addr_int_reg[2]\,
      I1 => \ADDR_SNG_PORT.bram_addr_int_reg[11]\(4),
      I2 => \ADDR_SNG_PORT.bram_addr_int[11]_i_3_n_0\,
      I3 => RdChnl_BRAM_Addr_Ld(6),
      I4 => Arb2AR_Active,
      I5 => \ADDR_SNG_PORT.bram_addr_int_reg[11]_0\(0),
      O => D(4)
    );
\ADDR_SNG_PORT.bram_addr_int[6]_i_2\: unisim.vcomponents.LUT4
    generic map(
      INIT => X"7FFF"
    )
        port map (
      I0 => \ADDR_SNG_PORT.bram_addr_int_reg[11]\(0),
      I1 => \ADDR_SNG_PORT.bram_addr_int_reg[11]\(1),
      I2 => \ADDR_SNG_PORT.bram_addr_int_reg[11]\(2),
      I3 => \ADDR_SNG_PORT.bram_addr_int_reg[11]\(3),
      O => \^addr_sng_port.bram_addr_int_reg[2]\
    );
\ADDR_SNG_PORT.bram_addr_int[7]_i_1\: unisim.vcomponents.LUT6
    generic map(
      INIT => X"6F606F6F6F606060"
    )
        port map (
      I0 => \ADDR_SNG_PORT.bram_addr_int_reg[11]\(5),
      I1 => \ADDR_SNG_PORT.bram_addr_int_reg[7]\,
      I2 => \ADDR_SNG_PORT.bram_addr_int[11]_i_3_n_0\,
      I3 => RdChnl_BRAM_Addr_Ld(7),
      I4 => Arb2AR_Active,
      I5 => \ADDR_SNG_PORT.bram_addr_int_reg[11]_0\(1),
      O => D(5)
    );
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
      C => s_axi_aclk,
      CE => ar_active_re,
      D => \wrap_burst_total[0]_i_1__0_n_0\,
      Q => wrap_burst_total(0),
      R => \^sr\(0)
    );
\wrap_burst_total_reg[1]\: unisim.vcomponents.FDRE
    generic map(
      INIT => '0'
    )
        port map (
      C => s_axi_aclk,
      CE => ar_active_re,
      D => \wrap_burst_total[1]_i_1__0_n_0\,
      Q => wrap_burst_total(1),
      R => \^sr\(0)
    );
\wrap_burst_total_reg[2]\: unisim.vcomponents.FDRE
    generic map(
      INIT => '0'
    )
        port map (
      C => s_axi_aclk,
      CE => ar_active_re,
      D => \wrap_burst_total[2]_i_1__0_n_0\,
      Q => wrap_burst_total(2),
      R => \^sr\(0)
    );
end STRUCTURE;
library IEEE;
use IEEE.STD_LOGIC_1164.ALL;
library UNISIM;
use UNISIM.VCOMPONENTS.ALL;
entity decalper_eb_ot_sdeen_pot_pi_dehcac_xnilix_rd_chnl is
  port (
    SR : out STD_LOGIC_VECTOR ( 0 to 0 );
    s_axi_rdata : out STD_LOGIC_VECTOR ( 31 downto 0 );
    ar_active_d1 : out STD_LOGIC;
    \GEN_NO_RD_CMD_OPT.axi_rvalid_int_reg_0\ : out STD_LOGIC;
    \GEN_NO_RD_CMD_OPT.axi_rlast_int_reg_0\ : out STD_LOGIC;
    BRAM_En_B_i : out STD_LOGIC;
    s_axi_arsize_2_sp_1 : out STD_LOGIC;
    s_axi_arsize_1_sp_1 : out STD_LOGIC;
    E : out STD_LOGIC_VECTOR ( 1 downto 0 );
    D : out STD_LOGIC_VECTOR ( 9 downto 0 );
    \ADDR_SNG_PORT.bram_addr_int_reg[2]\ : out STD_LOGIC;
    \save_init_bram_addr_ld_reg[17]\ : out STD_LOGIC_VECTOR ( 5 downto 0 );
    s_axi_arlen_2_sp_1 : out STD_LOGIC;
    s_axi_rready_0 : out STD_LOGIC;
    \s_axi_arsize[2]_0\ : out STD_LOGIC;
    \s_axi_arsize[1]_0\ : out STD_LOGIC;
    s_axi_aclk : in STD_LOGIC;
    ar_active_re : in STD_LOGIC;
    \GEN_NO_RD_CMD_OPT.GEN_AR_SNG.ar_active_d1_reg_0\ : in STD_LOGIC;
    Arb2AR_Active : in STD_LOGIC;
    s_axi_aresetn : in STD_LOGIC;
    s_axi_arsize : in STD_LOGIC_VECTOR ( 2 downto 0 );
    s_axi_rready : in STD_LOGIC;
    \ADDR_SNG_PORT.bram_addr_int_reg[2]_0\ : in STD_LOGIC;
    Q : in STD_LOGIC_VECTOR ( 9 downto 0 );
    s_axi_arburst : in STD_LOGIC_VECTOR ( 1 downto 0 );
    \GEN_NO_RD_CMD_OPT.act_rd_burst_two_reg_0\ : in STD_LOGIC;
    \ADDR_SNG_PORT.bram_addr_int_reg[11]\ : in STD_LOGIC_VECTOR ( 5 downto 0 );
    \ADDR_SNG_PORT.bram_addr_int_reg[7]\ : in STD_LOGIC;
    \ADDR_SNG_PORT.bram_addr_int_reg[8]\ : in STD_LOGIC;
    \ADDR_SNG_PORT.bram_addr_int_reg[9]\ : in STD_LOGIC;
    \ADDR_SNG_PORT.bram_addr_int_reg[10]\ : in STD_LOGIC;
    \ADDR_SNG_PORT.bram_addr_int_reg[3]\ : in STD_LOGIC;
    \ADDR_SNG_PORT.bram_addr_int_reg[4]\ : in STD_LOGIC;
    \ADDR_SNG_PORT.bram_addr_int_reg[4]_0\ : in STD_LOGIC;
    \ADDR_SNG_PORT.bram_addr_int_reg[5]\ : in STD_LOGIC;
    \ADDR_SNG_PORT.bram_addr_int_reg[5]_0\ : in STD_LOGIC;
    \ADDR_SNG_PORT.bram_addr_int_reg[11]_0\ : in STD_LOGIC;
    \ADDR_SNG_PORT.bram_addr_int_reg[11]_1\ : in STD_LOGIC;
    s_axi_araddr : in STD_LOGIC_VECTOR ( 17 downto 0 );
    s_axi_awaddr : in STD_LOGIC_VECTOR ( 0 to 0 );
    \ADDR_SNG_PORT.bram_addr_int_reg[2]_1\ : in STD_LOGIC;
    \GEN_NO_RD_CMD_OPT.GEN_NARROW_CNT.narrow_addr_int_reg[1]_0\ : in STD_LOGIC;
    s_axi_arlen : in STD_LOGIC_VECTOR ( 7 downto 0 );
    bram_rddata_a : in STD_LOGIC_VECTOR ( 31 downto 0 )
  );
end decalper_eb_ot_sdeen_pot_pi_dehcac_xnilix_rd_chnl;
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
