AdriaanSadie/MVT_ADC_TECH/adc_tech/adc_tech.ip_user_files/bd/adc_tech/adc_tech.gen/sources_1/bd/adc_tech/ip/adc_tech_dac_cal_control_0/adc_tech_dac_cal_control_0_sim_netlist.v

// Copyright 1986-2020 Xilinx, Inc. All Rights Reserved.
// --------------------------------------------------------------------------------
// Tool Version: Vivado v.2020.2 (win64) Build 3064766 Wed Nov 18 09:12:45 MST 2020
// Date        : Mon Sep 22 10:03:20 2025
// Host        : ZA-WASADIE1 running 64-bit major release  (build 9200)
// Command     : write_verilog -force -mode funcsim -rename_top adc_tech_dac_cal_control_0 -prefix
//               adc_tech_dac_cal_control_0_ adc_tech_axi_gpio_0_0_sim_netlist.v
// Design      : adc_tech_axi_gpio_0_0
// Purpose     : This verilog netlist is a functional simulation representation of the design and should not be modified
//               or synthesized. This netlist cannot be used for SDF annotated simulation.
// Device      : xczu7ev-ffvc1156-2-e
// --------------------------------------------------------------------------------
`timescale 1 ps / 1 ps

module adc_tech_dac_cal_control_0_GPIO_Core
   (gpio_io_o,
    ip2bus_wrack_i,
    ip2bus_rdack_i,
    D,
    s_axi_aclk,
    bus2ip_reset,
    bus2ip_cs,
    bus2ip_rnw,
    E,
    s_axi_wdata,
    \GEN_BKEND_CE_REGISTERS[2].ce_out_i_reg ,
    \GEN_BKEND_CE_REGISTERS[0].ce_out_i_reg ,
    \GEN_BKEND_CE_REGISTERS[1].ce_out_i_reg ,
    Bus_RNW_reg,
    \GEN_BKEND_CE_REGISTERS[3].ce_out_i_reg );
  output [31:0]gpio_io_o;
  output ip2bus_wrack_i;
  output ip2bus_rdack_i;
  output [31:0]D;
  input s_axi_aclk;
  input bus2ip_reset;
  input bus2ip_cs;
  input bus2ip_rnw;
  input [0:0]E;
  input [31:0]s_axi_wdata;
  input \GEN_BKEND_CE_REGISTERS[2].ce_out_i_reg ;
  input \GEN_BKEND_CE_REGISTERS[0].ce_out_i_reg ;
  input \GEN_BKEND_CE_REGISTERS[1].ce_out_i_reg ;
  input Bus_RNW_reg;
  input \GEN_BKEND_CE_REGISTERS[3].ce_out_i_reg ;

  wire Bus_RNW_reg;
  wire [31:0]D;
  wire [0:0]E;
  wire \GEN_BKEND_CE_REGISTERS[0].ce_out_i_reg ;
  wire \GEN_BKEND_CE_REGISTERS[1].ce_out_i_reg ;
  wire \GEN_BKEND_CE_REGISTERS[2].ce_out_i_reg ;
  wire \GEN_BKEND_CE_REGISTERS[3].ce_out_i_reg ;
  wire GPIO_xferAck_i;
  wire \Not_Dual.ALLOUT_ND.READ_REG_GEN[0].reg1_reg ;
  wire \Not_Dual.ALLOUT_ND.READ_REG_GEN[10].reg1_reg ;
  wire \Not_Dual.ALLOUT_ND.READ_REG_GEN[11].reg1_reg ;
  wire \Not_Dual.ALLOUT_ND.READ_REG_GEN[12].reg1_reg ;
  wire \Not_Dual.ALLOUT_ND.READ_REG_GEN[13].reg1_reg ;
  wire \Not_Dual.ALLOUT_ND.READ_REG_GEN[14].reg1_reg ;
  wire \Not_Dual.ALLOUT_ND.READ_REG_GEN[15].reg1_reg ;
  wire \Not_Dual.ALLOUT_ND.READ_REG_GEN[16].reg1_reg ;
  wire \Not_Dual.ALLOUT_ND.READ_REG_GEN[17].reg1_reg ;
  wire \Not_Dual.ALLOUT_ND.READ_REG_GEN[18].reg1_reg ;
  wire \Not_Dual.ALLOUT_ND.READ_REG_GEN[19].reg1_reg ;
  wire \Not_Dual.ALLOUT_ND.READ_REG_GEN[1].reg1_reg ;
  wire \Not_Dual.ALLOUT_ND.READ_REG_GEN[20].reg1_reg ;
  wire \Not_Dual.ALLOUT_ND.READ_REG_GEN[21].reg1_reg ;
  wire \Not_Dual.ALLOUT_ND.READ_REG_GEN[22].reg1_reg ;
  wire \Not_Dual.ALLOUT_ND.READ_REG_GEN[23].reg1_reg ;
  wire \Not_Dual.ALLOUT_ND.READ_REG_GEN[24].reg1_reg ;
  wire \Not_Dual.ALLOUT_ND.READ_REG_GEN[25].reg1_reg ;
  wire \Not_Dual.ALLOUT_ND.READ_REG_GEN[26].reg1_reg ;
  wire \Not_Dual.ALLOUT_ND.READ_REG_GEN[27].reg1_reg ;
  wire \Not_Dual.ALLOUT_ND.READ_REG_GEN[28].reg1_reg ;
  wire \Not_Dual.ALLOUT_ND.READ_REG_GEN[29].reg1_reg ;
  wire \Not_Dual.ALLOUT_ND.READ_REG_GEN[2].reg1_reg ;
  wire \Not_Dual.ALLOUT_ND.READ_REG_GEN[30].reg1_reg ;
  wire \Not_Dual.ALLOUT_ND.READ_REG_GEN[31].reg1_reg ;
  wire \Not_Dual.ALLOUT_ND.READ_REG_GEN[3].reg1_reg ;
  wire \Not_Dual.ALLOUT_ND.READ_REG_GEN[4].reg1_reg ;
  wire \Not_Dual.ALLOUT_ND.READ_REG_GEN[5].reg1_reg ;
  wire \Not_Dual.ALLOUT_ND.READ_REG_GEN[6].reg1_reg ;
  wire \Not_Dual.ALLOUT_ND.READ_REG_GEN[7].reg1_reg ;
  wire \Not_Dual.ALLOUT_ND.READ_REG_GEN[8].reg1_reg ;
  wire \Not_Dual.ALLOUT_ND.READ_REG_GEN[9].reg1_reg ;
  wire Read_Reg_Rst__0;
  wire bus2ip_cs;
  wire bus2ip_reset;
  wire bus2ip_rnw;
  wire [31:0]gpio_io_o;
  wire gpio_xferAck_Reg;
  wire iGPIO_xferAck__0;
  wire ip2bus_rdack_i;
  wire ip2bus_wrack_i;
  wire s_axi_aclk;
  wire [31:0]s_axi_wdata;

  FDRE \Not_Dual.ALLOUT_ND.READ_REG_GEN[0].reg1_reg[0] 
       (.C(s_axi_aclk),
        .CE(1'b1),
        .D(gpio_io_o[31]),
        .Q(\Not_Dual.ALLOUT_ND.READ_REG_GEN[0].reg1_reg ),
        .R(Read_Reg_Rst__0));
  FDRE \Not_Dual.ALLOUT_ND.READ_REG_GEN[10].reg1_reg[10] 
       (.C(s_axi_aclk),
        .CE(1'b1),
        .D(gpio_io_o[21]),
        .Q(\Not_Dual.ALLOUT_ND.READ_REG_GEN[10].reg1_reg ),
        .R(Read_Reg_Rst__0));
  FDRE \Not_Dual.ALLOUT_ND.READ_REG_GEN[11].reg1_reg[11] 
       (.C(s_axi_aclk),
        .CE(1'b1),
        .D(gpio_io_o[20]),
        .Q(\Not_Dual.ALLOUT_ND.READ_REG_GEN[11].reg1_reg ),
        .R(Read_Reg_Rst__0));
  FDRE \Not_Dual.ALLOUT_ND.READ_REG_GEN[12].reg1_reg[12] 
       (.C(s_axi_aclk),
        .CE(1'b1),
        .D(gpio_io_o[19]),
        .Q(\Not_Dual.ALLOUT_ND.READ_REG_GEN[12].reg1_reg ),
        .R(Read_Reg_Rst__0));
  FDRE \Not_Dual.ALLOUT_ND.READ_REG_GEN[13].reg1_reg[13] 
       (.C(s_axi_aclk),
        .CE(1'b1),
        .D(gpio_io_o[18]),
        .Q(\Not_Dual.ALLOUT_ND.READ_REG_GEN[13].reg1_reg ),
        .R(Read_Reg_Rst__0));
  FDRE \Not_Dual.ALLOUT_ND.READ_REG_GEN[14].reg1_reg[14] 
       (.C(s_axi_aclk),
        .CE(1'b1),
        .D(gpio_io_o[17]),
        .Q(\Not_Dual.ALLOUT_ND.READ_REG_GEN[14].reg1_reg ),
        .R(Read_Reg_Rst__0));
  FDRE \Not_Dual.ALLOUT_ND.READ_REG_GEN[15].reg1_reg[15] 
       (.C(s_axi_aclk),
        .CE(1'b1),
        .D(gpio_io_o[16]),
        .Q(\Not_Dual.ALLOUT_ND.READ_REG_GEN[15].reg1_reg ),
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
  FDRE #(
    .INIT(1'b0)) 
    \Not_Dual.gpio_Data_Out_reg[3] 
       (.C(s_axi_aclk),
        .CE(E),
        .D(s_axi_wdata[28]),
        .Q(gpio_io_o[28]),
        .R(bus2ip_reset));
  FDRE #(
    .INIT(1'b0)) 
    \Not_Dual.gpio_Data_Out_reg[4] 
       (.C(s_axi_aclk),
        .CE(E),
        .D(s_axi_wdata[27]),
        .Q(gpio_io_o[27]),
        .R(bus2ip_reset));
  FDRE #(
    .INIT(1'b0)) 
    \Not_Dual.gpio_Data_Out_reg[5] 
       (.C(s_axi_aclk),
        .CE(E),
        .D(s_axi_wdata[26]),
        .Q(gpio_io_o[26]),
        .R(bus2ip_reset));
  FDRE #(
    .INIT(1'b0)) 
    \Not_Dual.gpio_Data_Out_reg[6] 
       (.C(s_axi_aclk),
        .CE(E),
        .D(s_axi_wdata[25]),
        .Q(gpio_io_o[25]),
        .R(bus2ip_reset));
  FDRE #(
    .INIT(1'b0)) 
    \Not_Dual.gpio_Data_Out_reg[7] 
       (.C(s_axi_aclk),
        .CE(E),
        .D(s_axi_wdata[24]),
        .Q(gpio_io_o[24]),
        .R(bus2ip_reset));
  FDRE #(
    .INIT(1'b0)) 
    \Not_Dual.gpio_Data_Out_reg[8] 
       (.C(s_axi_aclk),
        .CE(E),
        .D(s_axi_wdata[23]),
        .Q(gpio_io_o[23]),
        .R(bus2ip_reset));
  FDRE #(
    .INIT(1'b0)) 
    \Not_Dual.gpio_Data_Out_reg[9] 
       (.C(s_axi_aclk),
        .CE(E),
        .D(s_axi_wdata[22]),
        .Q(gpio_io_o[22]),
        .R(bus2ip_reset));
  LUT4 #(
    .INIT(16'hFFDF)) 
    Read_Reg_Rst
       (.I0(bus2ip_rnw),
        .I1(GPIO_xferAck_i),
        .I2(bus2ip_cs),
        .I3(gpio_xferAck_Reg),
        .O(Read_Reg_Rst__0));
  FDRE gpio_xferAck_Reg_reg
       (.C(s_axi_aclk),
        .CE(1'b1),
        .D(GPIO_xferAck_i),
        .Q(gpio_xferAck_Reg),
        .R(bus2ip_reset));
  (* SOFT_HLUTNM = "soft_lutpair6" *) 
  LUT3 #(
    .INIT(8'h02)) 
    iGPIO_xferAck
       (.I0(bus2ip_cs),
        .I1(gpio_xferAck_Reg),
        .I2(GPIO_xferAck_i),
        .O(iGPIO_xferAck__0));
  FDRE iGPIO_xferAck_reg
       (.C(s_axi_aclk),
        .CE(1'b1),
        .D(iGPIO_xferAck__0),
        .Q(GPIO_xferAck_i),
        .R(bus2ip_reset));
  LUT6 #(
    .INIT(64'h0005000005400000)) 
    \ip2bus_data_i_D1[0]_i_1 
       (.I0(\GEN_BKEND_CE_REGISTERS[2].ce_out_i_reg ),
        .I1(\Not_Dual.ALLOUT_ND.READ_REG_GEN[0].reg1_reg ),
        .I2(\GEN_BKEND_CE_REGISTERS[0].ce_out_i_reg ),
        .I3(\GEN_BKEND_CE_REGISTERS[1].ce_out_i_reg ),
        .I4(Bus_RNW_reg),
        .I5(\GEN_BKEND_CE_REGISTERS[3].ce_out_i_reg ),
        .O(D[31]));
  LUT6 #(
    .INIT(64'h0005000005400000)) 
    \ip2bus_data_i_D1[10]_i_1 
       (.I0(\GEN_BKEND_CE_REGISTERS[2].ce_out_i_reg ),
        .I1(\Not_Dual.ALLOUT_ND.READ_REG_GEN[10].reg1_reg ),
        .I2(\GEN_BKEND_CE_REGISTERS[0].ce_out_i_reg ),
        .I3(\GEN_BKEND_CE_REGISTERS[1].ce_out_i_reg ),
        .I4(Bus_RNW_reg),
        .I5(\GEN_BKEND_CE_REGISTERS[3].ce_out_i_reg ),
        .O(D[21]));
  LUT6 #(
    .INIT(64'h0005000005400000)) 
    \ip2bus_data_i_D1[11]_i_1 
       (.I0(\GEN_BKEND_CE_REGISTERS[2].ce_out_i_reg ),
        .I1(\Not_Dual.ALLOUT_ND.READ_REG_GEN[11].reg1_reg ),
        .I2(\GEN_BKEND_CE_REGISTERS[0].ce_out_i_reg ),
        .I3(\GEN_BKEND_CE_REGISTERS[1].ce_out_i_reg ),
        .I4(Bus_RNW_reg),
        .I5(\GEN_BKEND_CE_REGISTERS[3].ce_out_i_reg ),
        .O(D[20]));
  LUT6 #(
    .INIT(64'h0005000005400000)) 
    \ip2bus_data_i_D1[12]_i_1 
       (.I0(\GEN_BKEND_CE_REGISTERS[2].ce_out_i_reg ),
        .I1(\Not_Dual.ALLOUT_ND.READ_REG_GEN[12].reg1_reg ),
        .I2(\GEN_BKEND_CE_REGISTERS[0].ce_out_i_reg ),
        .I3(\GEN_BKEND_CE_REGISTERS[1].ce_out_i_reg ),
        .I4(Bus_RNW_reg),
        .I5(\GEN_BKEND_CE_REGISTERS[3].ce_out_i_reg ),
        .O(D[19]));
  LUT6 #(
    .INIT(64'h0005000005400000)) 
    \ip2bus_data_i_D1[13]_i_1 
       (.I0(\GEN_BKEND_CE_REGISTERS[2].ce_out_i_reg ),
        .I1(\Not_Dual.ALLOUT_ND.READ_REG_GEN[13].reg1_reg ),
        .I2(\GEN_BKEND_CE_REGISTERS[0].ce_out_i_reg ),
        .I3(\GEN_BKEND_CE_REGISTERS[1].ce_out_i_reg ),
        .I4(Bus_RNW_reg),
        .I5(\GEN_BKEND_CE_REGISTERS[3].ce_out_i_reg ),
        .O(D[18]));
  LUT6 #(
    .INIT(64'h0005000005400000)) 
    \ip2bus_data_i_D1[14]_i_1 
       (.I0(\GEN_BKEND_CE_REGISTERS[2].ce_out_i_reg ),
        .I1(\Not_Dual.ALLOUT_ND.READ_REG_GEN[14].reg1_reg ),
        .I2(\GEN_BKEND_CE_REGISTERS[0].ce_out_i_reg ),
        .I3(\GEN_BKEND_CE_REGISTERS[1].ce_out_i_reg ),
        .I4(Bus_RNW_reg),
        .I5(\GEN_BKEND_CE_REGISTERS[3].ce_out_i_reg ),
        .O(D[17]));
  LUT6 #(
    .INIT(64'h0005000005400000)) 
    \ip2bus_data_i_D1[15]_i_1 
       (.I0(\GEN_BKEND_CE_REGISTERS[2].ce_out_i_reg ),
        .I1(\Not_Dual.ALLOUT_ND.READ_REG_GEN[15].reg1_reg ),
        .I2(\GEN_BKEND_CE_REGISTERS[0].ce_out_i_reg ),
        .I3(\GEN_BKEND_CE_REGISTERS[1].ce_out_i_reg ),
        .I4(Bus_RNW_reg),
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
    ip2bus_rdack_i_D1_i_1
       (.I0(GPIO_xferAck_i),
        .I1(bus2ip_rnw),
        .O(ip2bus_rdack_i));
  (* SOFT_HLUTNM = "soft_lutpair6" *) 
  LUT2 #(
    .INIT(4'h2)) 
    ip2bus_wrack_i_D1_i_1
       (.I0(GPIO_xferAck_i),
        .I1(bus2ip_rnw),
        .O(ip2bus_wrack_i));
endmodule

(* CHECK_LICENSE_TYPE = "adc_tech_axi_gpio_0_0,axi_gpio,{}" *) (* downgradeipidentifiedwarnings = "yes" *) (* x_core_info = "axi_gpio,Vivado 2020.2" *) 
(* NotValidForBitStream *)
module adc_tech_dac_cal_control_0
   (s_axi_aclk,
    s_axi_aresetn,
    s_axi_awaddr,
    s_axi_awvalid,
    s_axi_awready,
    s_axi_wdata,
    s_axi_wstrb,
    s_axi_wvalid,
    s_axi_wready,
    s_axi_bresp,
    s_axi_bvalid,
    s_axi_bready,
    s_axi_araddr,
    s_axi_arvalid,
    s_axi_arready,
    s_axi_rdata,
    s_axi_rresp,
    s_axi_rvalid,
    s_axi_rready,
    gpio_io_o);
  (* x_interface_info = "xilinx.com:signal:clock:1.0 S_AXI_ACLK CLK" *) (* x_interface_parameter = "XIL_INTERFACENAME S_AXI_ACLK, ASSOCIATED_BUSIF S_AXI, ASSOCIATED_RESET s_axi_aresetn, FREQ_HZ 200000000, FREQ_TOLERANCE_HZ 0, PHASE 0.0, CLK_DOMAIN adc_tech_clk_wiz_0_0_clk_out1, INSERT_VIP 0" *) input s_axi_aclk;
  (* x_interface_info = "xilinx.com:signal:reset:1.0 S_AXI_ARESETN RST" *) (* x_interface_parameter = "XIL_INTERFACENAME S_AXI_ARESETN, POLARITY ACTIVE_LOW, INSERT_VIP 0" *) input s_axi_aresetn;
  (* x_interface_info = "xilinx.com:interface:aximm:1.0 S_AXI AWADDR" *) (* x_interface_parameter = "XIL_INTERFACENAME S_AXI, DATA_WIDTH 32, PROTOCOL AXI4LITE, FREQ_HZ 200000000, ID_WIDTH 0, ADDR_WIDTH 9, AWUSER_WIDTH 0, ARUSER_WIDTH 0, WUSER_WIDTH 0, RUSER_WIDTH 0, BUSER_WIDTH 0, READ_WRITE_MODE READ_WRITE, HAS_BURST 0, HAS_LOCK 0, HAS_PROT 0, HAS_CACHE 0, HAS_QOS 0, HAS_REGION 0, HAS_WSTRB 1, HAS_BRESP 1, HAS_RRESP 1, SUPPORTS_NARROW_BURST 0, NUM_READ_OUTSTANDING 8, NUM_WRITE_OUTSTANDING 8, MAX_BURST_LENGTH 1, PHASE 0.0, CLK_DOMAIN adc_tech_clk_wiz_0_0_clk_out1, NUM_READ_THREADS 1, NUM_WRITE_THREADS 1, RUSER_BITS_PER_BYTE 0, WUSER_BITS_PER_BYTE 0, INSERT_VIP 0" *) input [8:0]s_axi_awaddr;
  (* x_interface_info = "xilinx.com:interface:aximm:1.0 S_AXI AWVALID" *) input s_axi_awvalid;
  (* x_interface_info = "xilinx.com:interface:aximm:1.0 S_AXI AWREADY" *) output s_axi_awready;
  (* x_interface_info = "xilinx.com:interface:aximm:1.0 S_AXI WDATA" *) input [31:0]s_axi_wdata;
  (* x_interface_info = "xilinx.com:interface:aximm:1.0 S_AXI WSTRB" *) input [3:0]s_axi_wstrb;
  (* x_interface_info = "xilinx.com:interface:aximm:1.0 S_AXI WVALID" *) input s_axi_wvalid;
  (* x_interface_info = "xilinx.com:interface:aximm:1.0 S_AXI WREADY" *) output s_axi_wready;
  (* x_interface_info = "xilinx.com:interface:aximm:1.0 S_AXI BRESP" *) output [1:0]s_axi_bresp;
  (* x_interface_info = "xilinx.com:interface:aximm:1.0 S_AXI BVALID" *) output s_axi_bvalid;
  (* x_interface_info = "xilinx.com:interface:aximm:1.0 S_AXI BREADY" *) input s_axi_bready;
  (* x_interface_info = "xilinx.com:interface:aximm:1.0 S_AXI ARADDR" *) input [8:0]s_axi_araddr;
  (* x_interface_info = "xilinx.com:interface:aximm:1.0 S_AXI ARVALID" *) input s_axi_arvalid;
  (* x_interface_info = "xilinx.com:interface:aximm:1.0 S_AXI ARREADY" *) output s_axi_arready;
  (* x_interface_info = "xilinx.com:interface:aximm:1.0 S_AXI RDATA" *) output [31:0]s_axi_rdata;
  (* x_interface_info = "xilinx.com:interface:aximm:1.0 S_AXI RRESP" *) output [1:0]s_axi_rresp;
  (* x_interface_info = "xilinx.com:interface:aximm:1.0 S_AXI RVALID" *) output s_axi_rvalid;
  (* x_interface_info = "xilinx.com:interface:aximm:1.0 S_AXI RREADY" *) input s_axi_rready;
  (* x_interface_info = "xilinx.com:interface:gpio:1.0 GPIO TRI_O" *) (* x_interface_parameter = "XIL_INTERFACENAME GPIO, BOARD.ASSOCIATED_PARAM GPIO_BOARD_INTERFACE" *) output [31:0]gpio_io_o;

  wire \<const0> ;
  wire [31:0]gpio_io_o;
  wire s_axi_aclk;
  wire [8:0]s_axi_araddr;
  wire s_axi_aresetn;
  wire s_axi_arready;
  wire s_axi_arvalid;
  wire [8:0]s_axi_awaddr;
  wire s_axi_awready;
  wire s_axi_awvalid;
  wire s_axi_bready;
  wire s_axi_bvalid;
  wire [31:0]s_axi_rdata;
  wire s_axi_rready;
  wire s_axi_rvalid;
  wire [31:0]s_axi_wdata;
  wire s_axi_wready;
  wire s_axi_wvalid;
  wire NLW_U0_ip2intc_irpt_UNCONNECTED;
  wire [31:0]NLW_U0_gpio2_io_o_UNCONNECTED;
  wire [31:0]NLW_U0_gpio2_io_t_UNCONNECTED;
  wire [31:0]NLW_U0_gpio_io_t_UNCONNECTED;
  wire [1:0]NLW_U0_s_axi_bresp_UNCONNECTED;
  wire [1:0]NLW_U0_s_axi_rresp_UNCONNECTED;

  assign s_axi_bresp[1] = \<const0> ;
  assign s_axi_bresp[0] = \<const0> ;
  assign s_axi_rresp[1] = \<const0> ;
  assign s_axi_rresp[0] = \<const0> ;
  GND GND
       (.G(\<const0> ));
  (* C_ALL_INPUTS = "0" *) 
  (* C_ALL_INPUTS_2 = "0" *) 
  (* C_ALL_OUTPUTS = "1" *) 
  (* C_ALL_OUTPUTS_2 = "0" *) 
  (* C_DOUT_DEFAULT = "0" *) 
  (* C_DOUT_DEFAULT_2 = "0" *) 
  (* C_FAMILY = "zynquplus" *) 
  (* C_GPIO2_WIDTH = "32" *) 
  (* C_GPIO_WIDTH = "32" *) 
  (* C_INTERRUPT_PRESENT = "0" *) 
  (* C_IS_DUAL = "0" *) 
  (* C_S_AXI_ADDR_WIDTH = "9" *) 
  (* C_S_AXI_DATA_WIDTH = "32" *) 
  (* C_TRI_DEFAULT = "-1" *) 
  (* C_TRI_DEFAULT_2 = "-1" *) 
  (* downgradeipidentifiedwarnings = "yes" *) 
  (* ip_group = "LOGICORE" *) 
  adc_tech_dac_cal_control_0_axi_gpio U0
       (.gpio2_io_i({1'b0,1'b0,1'b0,1'b0,1'b0,1'b0,1'b0,1'b0,1'b0,1'b0,1'b0,1'b0,1'b0,1'b0,1'b0,1'b0,1'b0,1'b0,1'b0,1'b0,1'b0,1'b0,1'b0,1'b0,1'b0,1'b0,1'b0,1'b0,1'b0,1'b0,1'b0,1'b0}),
        .gpio2_io_o(NLW_U0_gpio2_io_o_UNCONNECTED[31:0]),
        .gpio2_io_t(NLW_U0_gpio2_io_t_UNCONNECTED[31:0]),
        .gpio_io_i({1'b0,1'b0,1'b0,1'b0,1'b0,1'b0,1'b0,1'b0,1'b0,1'b0,1'b0,1'b0,1'b0,1'b0,1'b0,1'b0,1'b0,1'b0,1'b0,1'b0,1'b0,1'b0,1'b0,1'b0,1'b0,1'b0,1'b0,1'b0,1'b0,1'b0,1'b0,1'b0}),
        .gpio_io_o(gpio_io_o),
        .gpio_io_t(NLW_U0_gpio_io_t_UNCONNECTED[31:0]),
        .ip2intc_irpt(NLW_U0_ip2intc_irpt_UNCONNECTED),
        .s_axi_aclk(s_axi_aclk),
        .s_axi_araddr({s_axi_araddr[8],1'b0,1'b0,1'b0,1'b0,s_axi_araddr[3:2],1'b0,1'b0}),
        .s_axi_aresetn(s_axi_aresetn),
        .s_axi_arready(s_axi_arready),
        .s_axi_arvalid(s_axi_arvalid),
        .s_axi_awaddr({s_axi_awaddr[8],1'b0,1'b0,1'b0,1'b0,s_axi_awaddr[3:2],1'b0,1'b0}),
        .s_axi_awready(s_axi_awready),
        .s_axi_awvalid(s_axi_awvalid),
        .s_axi_bready(s_axi_bready),
        .s_axi_bresp(NLW_U0_s_axi_bresp_UNCONNECTED[1:0]),
        .s_axi_bvalid(s_axi_bvalid),
        .s_axi_rdata(s_axi_rdata),
        .s_axi_rready(s_axi_rready),
        .s_axi_rresp(NLW_U0_s_axi_rresp_UNCONNECTED[1:0]),
        .s_axi_rvalid(s_axi_rvalid),
        .s_axi_wdata(s_axi_wdata),
        .s_axi_wready(s_axi_wready),
        .s_axi_wstrb({1'b0,1'b0,1'b0,1'b0}),
        .s_axi_wvalid(s_axi_wvalid));
endmodule

module adc_tech_dac_cal_control_0_address_decoder
   (\GEN_BKEND_CE_REGISTERS[3].ce_out_i_reg ,
    \GEN_BKEND_CE_REGISTERS[2].ce_out_i_reg ,
    \GEN_BKEND_CE_REGISTERS[1].ce_out_i_reg ,
    \GEN_BKEND_CE_REGISTERS[0].ce_out_i_reg ,
    Bus_RNW_reg,
    bus2ip_cs,
    E,
    ip2bus_rdack_i_D1_reg,
    ip2bus_wrack_i_D1_reg,
    Q,
    s_axi_aclk,
    \Not_Dual.gpio_Data_Out_reg[0] ,
    bus2ip_rnw,
    s_axi_aresetn,
    ip2bus_rdack_i_D1,
    s_axi_arready,
    s_axi_arready_0,
    ip2bus_wrack_i_D1,
    s_axi_wready);
  output \GEN_BKEND_CE_REGISTERS[3].ce_out_i_reg ;
  output \GEN_BKEND_CE_REGISTERS[2].ce_out_i_reg ;
  output \GEN_BKEND_CE_REGISTERS[1].ce_out_i_reg ;
  output \GEN_BKEND_CE_REGISTERS[0].ce_out_i_reg ;
  output Bus_RNW_reg;
  output bus2ip_cs;
  output [0:0]E;
  output ip2bus_rdack_i_D1_reg;
  output ip2bus_wrack_i_D1_reg;
  input Q;
  input s_axi_aclk;
  input [2:0]\Not_Dual.gpio_Data_Out_reg[0] ;
  input bus2ip_rnw;
  input s_axi_aresetn;
  input ip2bus_rdack_i_D1;
  input s_axi_arready;
  input [3:0]s_axi_arready_0;
  input ip2bus_wrack_i_D1;
  input s_axi_wready;

  wire Bus_RNW_reg;
  wire Bus_RNW_reg_i_1_n_0;
  wire [0:0]E;
  wire \GEN_BKEND_CE_REGISTERS[0].ce_out_i_reg ;
  wire \GEN_BKEND_CE_REGISTERS[1].ce_out_i_reg ;
  wire \GEN_BKEND_CE_REGISTERS[2].ce_out_i_reg ;
  wire \GEN_BKEND_CE_REGISTERS[3].ce_out_i_reg ;
  wire \MEM_DECODE_GEN[0].cs_out_i[0]_i_1_n_0 ;
  wire [2:0]\Not_Dual.gpio_Data_Out_reg[0] ;
  wire Q;
  wire bus2ip_cs;
  wire bus2ip_rnw;
  wire ce_expnd_i_0;
  wire ce_expnd_i_1;
  wire ce_expnd_i_2;
  wire ce_expnd_i_3;
  wire cs_ce_clr;
  wire ip2bus_rdack_i_D1;
  wire ip2bus_rdack_i_D1_reg;
  wire ip2bus_wrack_i_D1;
  wire ip2bus_wrack_i_D1_reg;
  wire s_axi_aclk;
  wire s_axi_aresetn;
  wire s_axi_arready;
  wire [3:0]s_axi_arready_0;
  wire s_axi_wready;

  LUT3 #(
    .INIT(8'hB8)) 
    Bus_RNW_reg_i_1
       (.I0(bus2ip_rnw),
        .I1(Q),
        .I2(Bus_RNW_reg),
        .O(Bus_RNW_reg_i_1_n_0));
  FDRE Bus_RNW_reg_reg
       (.C(s_axi_aclk),
        .CE(1'b1),
        .D(Bus_RNW_reg_i_1_n_0),
        .Q(Bus_RNW_reg),
        .R(1'b0));
  FDRE \GEN_BKEND_CE_REGISTERS[0].ce_out_i_reg[0] 
       (.C(s_axi_aclk),
        .CE(Q),
        .D(ce_expnd_i_3),
        .Q(\GEN_BKEND_CE_REGISTERS[0].ce_out_i_reg ),
        .R(cs_ce_clr));
  LUT2 #(
    .INIT(4'h2)) 
    \GEN_BKEND_CE_REGISTERS[1].ce_out_i[1]_i_1 
       (.I0(\Not_Dual.gpio_Data_Out_reg[0] [0]),
        .I1(\Not_Dual.gpio_Data_Out_reg[0] [1]),
        .O(ce_expnd_i_2));
  FDRE \GEN_BKEND_CE_REGISTERS[1].ce_out_i_reg[1] 
       (.C(s_axi_aclk),
        .CE(Q),
        .D(ce_expnd_i_2),
        .Q(\GEN_BKEND_CE_REGISTERS[1].ce_out_i_reg ),
        .R(cs_ce_clr));
  FDRE \GEN_BKEND_CE_REGISTERS[2].ce_out_i_reg[2] 
       (.C(s_axi_aclk),
        .CE(Q),
        .D(ce_expnd_i_1),
        .Q(\GEN_BKEND_CE_REGISTERS[2].ce_out_i_reg ),
        .R(cs_ce_clr));
  LUT3 #(
    .INIT(8'hEF)) 
    \GEN_BKEND_CE_REGISTERS[3].ce_out_i[3]_i_1 
       (.I0(ip2bus_wrack_i_D1_reg),
        .I1(ip2bus_rdack_i_D1_reg),
        .I2(s_axi_aresetn),
        .O(cs_ce_clr));
  (* SOFT_HLUTNM = "soft_lutpair0" *) 
  LUT2 #(
    .INIT(4'h8)) 
    \GEN_BKEND_CE_REGISTERS[3].ce_out_i[3]_i_2 
       (.I0(\Not_Dual.gpio_Data_Out_reg[0] [1]),
        .I1(\Not_Dual.gpio_Data_Out_reg[0] [0]),
        .O(ce_expnd_i_0));
  FDRE \GEN_BKEND_CE_REGISTERS[3].ce_out_i_reg[3] 
       (.C(s_axi_aclk),
        .CE(Q),
        .D(ce_expnd_i_0),
        .Q(\GEN_BKEND_CE_REGISTERS[3].ce_out_i_reg ),
        .R(cs_ce_clr));
  adc_tech_dac_cal_control_0_pselect_f \MEM_DECODE_GEN[0].PER_CE_GEN[0].MULTIPLE_CES_THIS_CS_GEN.CE_I 
       (.\GEN_BKEND_CE_REGISTERS[0].ce_out_i_reg[0] (\Not_Dual.gpio_Data_Out_reg[0] [1:0]),
        .ce_expnd_i_3(ce_expnd_i_3));
  adc_tech_dac_cal_control_0_pselect_f__parameterized1 \MEM_DECODE_GEN[0].PER_CE_GEN[2].MULTIPLE_CES_THIS_CS_GEN.CE_I 
       (.\GEN_BKEND_CE_REGISTERS[2].ce_out_i_reg[2] (\Not_Dual.gpio_Data_Out_reg[0] [1:0]),
        .ce_expnd_i_1(ce_expnd_i_1));
  LUT5 #(
    .INIT(32'h000000E0)) 
    \MEM_DECODE_GEN[0].cs_out_i[0]_i_1 
       (.I0(bus2ip_cs),
        .I1(Q),
        .I2(s_axi_aresetn),
        .I3(ip2bus_rdack_i_D1_reg),
        .I4(ip2bus_wrack_i_D1_reg),
        .O(\MEM_DECODE_GEN[0].cs_out_i[0]_i_1_n_0 ));
  FDRE \MEM_DECODE_GEN[0].cs_out_i_reg[0] 
       (.C(s_axi_aclk),
        .CE(1'b1),
        .D(\MEM_DECODE_GEN[0].cs_out_i[0]_i_1_n_0 ),
        .Q(bus2ip_cs),
        .R(1'b0));
  (* SOFT_HLUTNM = "soft_lutpair0" *) 
  LUT5 #(
    .INIT(32'h00000004)) 
    \Not_Dual.gpio_Data_Out[0]_i_1 
       (.I0(\Not_Dual.gpio_Data_Out_reg[0] [2]),
        .I1(bus2ip_cs),
        .I2(\Not_Dual.gpio_Data_Out_reg[0] [0]),
        .I3(bus2ip_rnw),
        .I4(\Not_Dual.gpio_Data_Out_reg[0] [1]),
        .O(E));
  LUT6 #(
    .INIT(64'hAAAAAAAAAAAEAAAA)) 
    s_axi_arready_INST_0
       (.I0(ip2bus_rdack_i_D1),
        .I1(s_axi_arready),
        .I2(s_axi_arready_0[2]),
        .I3(s_axi_arready_0[1]),
        .I4(s_axi_arready_0[3]),
        .I5(s_axi_arready_0[0]),
        .O(ip2bus_rdack_i_D1_reg));
  LUT6 #(
    .INIT(64'hAAAAAAAAAAAEAAAA)) 
    s_axi_wready_INST_0
       (.I0(ip2bus_wrack_i_D1),
        .I1(s_axi_wready),
        .I2(s_axi_arready_0[2]),
        .I3(s_axi_arready_0[1]),
        .I4(s_axi_arready_0[3]),
        .I5(s_axi_arready_0[0]),
        .O(ip2bus_wrack_i_D1_reg));
endmodule

(* C_ALL_INPUTS = "0" *) (* C_ALL_INPUTS_2 = "0" *) (* C_ALL_OUTPUTS = "1" *) 
(* C_ALL_OUTPUTS_2 = "0" *) (* C_DOUT_DEFAULT = "0" *) (* C_DOUT_DEFAULT_2 = "0" *) 
(* C_FAMILY = "zynquplus" *) (* C_GPIO2_WIDTH = "32" *) (* C_GPIO_WIDTH = "32" *) 
(* C_INTERRUPT_PRESENT = "0" *) (* C_IS_DUAL = "0" *) (* C_S_AXI_ADDR_WIDTH = "9" *) 
(* C_S_AXI_DATA_WIDTH = "32" *) (* C_TRI_DEFAULT = "-1" *) (* C_TRI_DEFAULT_2 = "-1" *) 
(* downgradeipidentifiedwarnings = "yes" *) (* ip_group = "LOGICORE" *) 
module adc_tech_dac_cal_control_0_axi_gpio
   (s_axi_aclk,
    s_axi_aresetn,
    s_axi_awaddr,
    s_axi_awvalid,
    s_axi_awready,
    s_axi_wdata,
    s_axi_wstrb,
    s_axi_wvalid,
    s_axi_wready,
    s_axi_bresp,
    s_axi_bvalid,
    s_axi_bready,
    s_axi_araddr,
    s_axi_arvalid,
    s_axi_arready,
    s_axi_rdata,
    s_axi_rresp,
    s_axi_rvalid,
    s_axi_rready,
    ip2intc_irpt,
    gpio_io_i,
    gpio_io_o,
    gpio_io_t,
    gpio2_io_i,
    gpio2_io_o,
    gpio2_io_t);
  (* sigis = "Clk" *) input s_axi_aclk;
  (* sigis = "Rst" *) input s_axi_aresetn;
  input [8:0]s_axi_awaddr;
  input s_axi_awvalid;
  output s_axi_awready;
  input [31:0]s_axi_wdata;
  input [3:0]s_axi_wstrb;
  input s_axi_wvalid;
  output s_axi_wready;
  output [1:0]s_axi_bresp;
  output s_axi_bvalid;
  input s_axi_bready;
  input [8:0]s_axi_araddr;
  input s_axi_arvalid;
  output s_axi_arready;
  output [31:0]s_axi_rdata;
  output [1:0]s_axi_rresp;
  output s_axi_rvalid;
  input s_axi_rready;
  (* sigis = "INTR_LEVEL_HIGH" *) output ip2intc_irpt;
  input [31:0]gpio_io_i;
  output [31:0]gpio_io_o;
  output [31:0]gpio_io_t;
  input [31:0]gpio2_io_i;
  output [31:0]gpio2_io_o;
  output [31:0]gpio2_io_t;

  wire \<const0> ;
  wire AXI_LITE_IPIF_I_n_10;
  wire \I_SLAVE_ATTACHMENT/I_DECODER/Bus_RNW_reg ;
  wire \I_SLAVE_ATTACHMENT/I_DECODER/GEN_BKEND_CE_REGISTERS[0].ce_out_i_reg ;
  wire \I_SLAVE_ATTACHMENT/I_DECODER/GEN_BKEND_CE_REGISTERS[1].ce_out_i_reg ;
  wire \I_SLAVE_ATTACHMENT/I_DECODER/GEN_BKEND_CE_REGISTERS[2].ce_out_i_reg ;
  wire \I_SLAVE_ATTACHMENT/I_DECODER/GEN_BKEND_CE_REGISTERS[3].ce_out_i_reg ;
  wire bus2ip_cs;
  wire bus2ip_reset;
  wire bus2ip_rnw;
  wire [31:0]gpio_io_o;
  wire [0:31]ip2bus_data;
  wire [0:31]ip2bus_data_i_D1;
  wire ip2bus_rdack_i;
  wire ip2bus_rdack_i_D1;
  wire ip2bus_wrack_i;
  wire ip2bus_wrack_i_D1;
  wire s_axi_aclk;
  wire [8:0]s_axi_araddr;
  wire s_axi_aresetn;
  wire s_axi_arready;
  wire s_axi_arvalid;
  wire [8:0]s_axi_awaddr;
  wire s_axi_awvalid;
  wire s_axi_bready;
  wire s_axi_bvalid;
  wire [31:0]s_axi_rdata;
  wire s_axi_rready;
  wire s_axi_rvalid;
  wire [31:0]s_axi_wdata;
  wire s_axi_wready;
  wire s_axi_wvalid;

  assign gpio2_io_o[31] = \<const0> ;
  assign gpio2_io_o[30] = \<const0> ;
  assign gpio2_io_o[29] = \<const0> ;
  assign gpio2_io_o[28] = \<const0> ;
  assign gpio2_io_o[27] = \<const0> ;
  assign gpio2_io_o[26] = \<const0> ;
  assign gpio2_io_o[25] = \<const0> ;
  assign gpio2_io_o[24] = \<const0> ;
  assign gpio2_io_o[23] = \<const0> ;
  assign gpio2_io_o[22] = \<const0> ;
  assign gpio2_io_o[21] = \<const0> ;
  assign gpio2_io_o[20] = \<const0> ;
  assign gpio2_io_o[19] = \<const0> ;
  assign gpio2_io_o[18] = \<const0> ;
  assign gpio2_io_o[17] = \<const0> ;
  assign gpio2_io_o[16] = \<const0> ;
  assign gpio2_io_o[15] = \<const0> ;
  assign gpio2_io_o[14] = \<const0> ;
  assign gpio2_io_o[13] = \<const0> ;
  assign gpio2_io_o[12] = \<const0> ;
  assign gpio2_io_o[11] = \<const0> ;
  assign gpio2_io_o[10] = \<const0> ;
  assign gpio2_io_o[9] = \<const0> ;
  assign gpio2_io_o[8] = \<const0> ;
  assign gpio2_io_o[7] = \<const0> ;
  assign gpio2_io_o[6] = \<const0> ;
  assign gpio2_io_o[5] = \<const0> ;
  assign gpio2_io_o[4] = \<const0> ;
  assign gpio2_io_o[3] = \<const0> ;
  assign gpio2_io_o[2] = \<const0> ;
  assign gpio2_io_o[1] = \<const0> ;
  assign gpio2_io_o[0] = \<const0> ;
  assign gpio2_io_t[31] = \<const0> ;
  assign gpio2_io_t[30] = \<const0> ;
  assign gpio2_io_t[29] = \<const0> ;
  assign gpio2_io_t[28] = \<const0> ;
  assign gpio2_io_t[27] = \<const0> ;
  assign gpio2_io_t[26] = \<const0> ;
  assign gpio2_io_t[25] = \<const0> ;
  assign gpio2_io_t[24] = \<const0> ;
  assign gpio2_io_t[23] = \<const0> ;
  assign gpio2_io_t[22] = \<const0> ;
  assign gpio2_io_t[21] = \<const0> ;
  assign gpio2_io_t[20] = \<const0> ;
  assign gpio2_io_t[19] = \<const0> ;
  assign gpio2_io_t[18] = \<const0> ;
  assign gpio2_io_t[17] = \<const0> ;
  assign gpio2_io_t[16] = \<const0> ;
  assign gpio2_io_t[15] = \<const0> ;
  assign gpio2_io_t[14] = \<const0> ;
  assign gpio2_io_t[13] = \<const0> ;
  assign gpio2_io_t[12] = \<const0> ;
  assign gpio2_io_t[11] = \<const0> ;
  assign gpio2_io_t[10] = \<const0> ;
  assign gpio2_io_t[9] = \<const0> ;
  assign gpio2_io_t[8] = \<const0> ;
  assign gpio2_io_t[7] = \<const0> ;
  assign gpio2_io_t[6] = \<const0> ;
  assign gpio2_io_t[5] = \<const0> ;
  assign gpio2_io_t[4] = \<const0> ;
  assign gpio2_io_t[3] = \<const0> ;
  assign gpio2_io_t[2] = \<const0> ;
  assign gpio2_io_t[1] = \<const0> ;
  assign gpio2_io_t[0] = \<const0> ;
  assign gpio_io_t[31] = \<const0> ;
  assign gpio_io_t[30] = \<const0> ;
  assign gpio_io_t[29] = \<const0> ;
  assign gpio_io_t[28] = \<const0> ;
  assign gpio_io_t[27] = \<const0> ;
  assign gpio_io_t[26] = \<const0> ;
  assign gpio_io_t[25] = \<const0> ;
  assign gpio_io_t[24] = \<const0> ;
  assign gpio_io_t[23] = \<const0> ;
  assign gpio_io_t[22] = \<const0> ;
  assign gpio_io_t[21] = \<const0> ;
  assign gpio_io_t[20] = \<const0> ;
  assign gpio_io_t[19] = \<const0> ;
  assign gpio_io_t[18] = \<const0> ;
  assign gpio_io_t[17] = \<const0> ;
  assign gpio_io_t[16] = \<const0> ;
  assign gpio_io_t[15] = \<const0> ;
  assign gpio_io_t[14] = \<const0> ;
  assign gpio_io_t[13] = \<const0> ;
  assign gpio_io_t[12] = \<const0> ;
  assign gpio_io_t[11] = \<const0> ;
  assign gpio_io_t[10] = \<const0> ;
  assign gpio_io_t[9] = \<const0> ;
  assign gpio_io_t[8] = \<const0> ;
  assign gpio_io_t[7] = \<const0> ;
  assign gpio_io_t[6] = \<const0> ;
  assign gpio_io_t[5] = \<const0> ;
  assign gpio_io_t[4] = \<const0> ;
  assign gpio_io_t[3] = \<const0> ;
  assign gpio_io_t[2] = \<const0> ;
  assign gpio_io_t[1] = \<const0> ;
  assign gpio_io_t[0] = \<const0> ;
  assign ip2intc_irpt = \<const0> ;
  assign s_axi_awready = s_axi_wready;
  assign s_axi_bresp[1] = \<const0> ;
  assign s_axi_bresp[0] = \<const0> ;
  assign s_axi_rresp[1] = \<const0> ;
  assign s_axi_rresp[0] = \<const0> ;
  adc_tech_dac_cal_control_0_axi_lite_ipif AXI_LITE_IPIF_I
       (.Bus_RNW_reg(\I_SLAVE_ATTACHMENT/I_DECODER/Bus_RNW_reg ),
        .E(AXI_LITE_IPIF_I_n_10),
        .\GEN_BKEND_CE_REGISTERS[0].ce_out_i_reg (\I_SLAVE_ATTACHMENT/I_DECODER/GEN_BKEND_CE_REGISTERS[0].ce_out_i_reg ),
        .\GEN_BKEND_CE_REGISTERS[1].ce_out_i_reg (\I_SLAVE_ATTACHMENT/I_DECODER/GEN_BKEND_CE_REGISTERS[1].ce_out_i_reg ),
        .\GEN_BKEND_CE_REGISTERS[2].ce_out_i_reg (\I_SLAVE_ATTACHMENT/I_DECODER/GEN_BKEND_CE_REGISTERS[2].ce_out_i_reg ),
        .\GEN_BKEND_CE_REGISTERS[3].ce_out_i_reg (\I_SLAVE_ATTACHMENT/I_DECODER/GEN_BKEND_CE_REGISTERS[3].ce_out_i_reg ),
        .Q({ip2bus_data_i_D1[0],ip2bus_data_i_D1[1],ip2bus_data_i_D1[2],ip2bus_data_i_D1[3],ip2bus_data_i_D1[4],ip2bus_data_i_D1[5],ip2bus_data_i_D1[6],ip2bus_data_i_D1[7],ip2bus_data_i_D1[8],ip2bus_data_i_D1[9],ip2bus_data_i_D1[10],ip2bus_data_i_D1[11],ip2bus_data_i_D1[12],ip2bus_data_i_D1[13],ip2bus_data_i_D1[14],ip2bus_data_i_D1[15],ip2bus_data_i_D1[16],ip2bus_data_i_D1[17],ip2bus_data_i_D1[18],ip2bus_data_i_D1[19],ip2bus_data_i_D1[20],ip2bus_data_i_D1[21],ip2bus_data_i_D1[22],ip2bus_data_i_D1[23],ip2bus_data_i_D1[24],ip2bus_data_i_D1[25],ip2bus_data_i_D1[26],ip2bus_data_i_D1[27],ip2bus_data_i_D1[28],ip2bus_data_i_D1[29],ip2bus_data_i_D1[30],ip2bus_data_i_D1[31]}),
        .bus2ip_cs(bus2ip_cs),
        .bus2ip_reset(bus2ip_reset),
        .bus2ip_rnw(bus2ip_rnw),
        .ip2bus_rdack_i_D1(ip2bus_rdack_i_D1),
        .ip2bus_rdack_i_D1_reg(s_axi_arready),
        .ip2bus_wrack_i_D1(ip2bus_wrack_i_D1),
        .ip2bus_wrack_i_D1_reg(s_axi_wready),
        .s_axi_aclk(s_axi_aclk),
        .s_axi_araddr({s_axi_araddr[8],s_axi_araddr[3:2]}),
        .s_axi_aresetn(s_axi_aresetn),
        .s_axi_arvalid(s_axi_arvalid),
        .s_axi_awaddr({s_axi_awaddr[8],s_axi_awaddr[3:2]}),
        .s_axi_awvalid(s_axi_awvalid),
        .s_axi_bready(s_axi_bready),
        .s_axi_bvalid_i_reg(s_axi_bvalid),
        .s_axi_rdata(s_axi_rdata),
        .s_axi_rready(s_axi_rready),
        .s_axi_rvalid_i_reg(s_axi_rvalid),
        .s_axi_wvalid(s_axi_wvalid));
  GND GND
       (.G(\<const0> ));
  adc_tech_dac_cal_control_0_GPIO_Core gpio_core_1
       (.Bus_RNW_reg(\I_SLAVE_ATTACHMENT/I_DECODER/Bus_RNW_reg ),
        .D({ip2bus_data[0],ip2bus_data[1],ip2bus_data[2],ip2bus_data[3],ip2bus_data[4],ip2bus_data[5],ip2bus_data[6],ip2bus_data[7],ip2bus_data[8],ip2bus_data[9],ip2bus_data[10],ip2bus_data[11],ip2bus_data[12],ip2bus_data[13],ip2bus_data[14],ip2bus_data[15],ip2bus_data[16],ip2bus_data[17],ip2bus_data[18],ip2bus_data[19],ip2bus_data[20],ip2bus_data[21],ip2bus_data[22],ip2bus_data[23],ip2bus_data[24],ip2bus_data[25],ip2bus_data[26],ip2bus_data[27],ip2bus_data[28],ip2bus_data[29],ip2bus_data[30],ip2bus_data[31]}),
        .E(AXI_LITE_IPIF_I_n_10),
        .\GEN_BKEND_CE_REGISTERS[0].ce_out_i_reg (\I_SLAVE_ATTACHMENT/I_DECODER/GEN_BKEND_CE_REGISTERS[0].ce_out_i_reg ),
        .\GEN_BKEND_CE_REGISTERS[1].ce_out_i_reg (\I_SLAVE_ATTACHMENT/I_DECODER/GEN_BKEND_CE_REGISTERS[1].ce_out_i_reg ),
        .\GEN_BKEND_CE_REGISTERS[2].ce_out_i_reg (\I_SLAVE_ATTACHMENT/I_DECODER/GEN_BKEND_CE_REGISTERS[2].ce_out_i_reg ),
        .\GEN_BKEND_CE_REGISTERS[3].ce_out_i_reg (\I_SLAVE_ATTACHMENT/I_DECODER/GEN_BKEND_CE_REGISTERS[3].ce_out_i_reg ),
        .bus2ip_cs(bus2ip_cs),
        .bus2ip_reset(bus2ip_reset),
        .bus2ip_rnw(bus2ip_rnw),
        .gpio_io_o(gpio_io_o),
        .ip2bus_rdack_i(ip2bus_rdack_i),
        .ip2bus_wrack_i(ip2bus_wrack_i),
        .s_axi_aclk(s_axi_aclk),
        .s_axi_wdata(s_axi_wdata));
  FDRE \ip2bus_data_i_D1_reg[0] 
       (.C(s_axi_aclk),
        .CE(1'b1),
        .D(ip2bus_data[0]),
        .Q(ip2bus_data_i_D1[0]),
        .R(bus2ip_reset));
  FDRE \ip2bus_data_i_D1_reg[10] 
       (.C(s_axi_aclk),
        .CE(1'b1),
        .D(ip2bus_data[10]),
        .Q(ip2bus_data_i_D1[10]),
        .R(bus2ip_reset));
  FDRE \ip2bus_data_i_D1_reg[11] 
       (.C(s_axi_aclk),
        .CE(1'b1),
        .D(ip2bus_data[11]),
        .Q(ip2bus_data_i_D1[11]),
        .R(bus2ip_reset));
  FDRE \ip2bus_data_i_D1_reg[12] 
       (.C(s_axi_aclk),
        .CE(1'b1),
        .D(ip2bus_data[12]),
        .Q(ip2bus_data_i_D1[12]),
        .R(bus2ip_reset));
  FDRE \ip2bus_data_i_D1_reg[13] 
       (.C(s_axi_aclk),
        .CE(1'b1),
        .D(ip2bus_data[13]),
        .Q(ip2bus_data_i_D1[13]),
        .R(bus2ip_reset));
  FDRE \ip2bus_data_i_D1_reg[14] 
       (.C(s_axi_aclk),
        .CE(1'b1),
        .D(ip2bus_data[14]),
        .Q(ip2bus_data_i_D1[14]),
        .R(bus2ip_reset));
  FDRE \ip2bus_data_i_D1_reg[15] 
       (.C(s_axi_aclk),
        .CE(1'b1),
        .D(ip2bus_data[15]),
        .Q(ip2bus_data_i_D1[15]),
        .R(bus2ip_reset));
  FDRE \ip2bus_data_i_D1_reg[16] 
       (.C(s_axi_aclk),
        .CE(1'b1),
        .D(ip2bus_data[16]),
        .Q(ip2bus_data_i_D1[16]),
        .R(bus2ip_reset));
  FDRE \ip2bus_data_i_D1_reg[17] 
       (.C(s_axi_aclk),
        .CE(1'b1),
        .D(ip2bus_data[17]),
        .Q(ip2bus_data_i_D1[17]),
        .R(bus2ip_reset));
  FDRE \ip2bus_data_i_D1_reg[18] 
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
       (.C(s_axi_aclk),
        .CE(1'b1),
        .D(ip2bus_rdack_i),
        .Q(ip2bus_rdack_i_D1),
        .R(bus2ip_reset));
  FDRE ip2bus_wrack_i_D1_reg
       (.C(s_axi_aclk),
        .CE(1'b1),
        .D(ip2bus_wrack_i),
        .Q(ip2bus_wrack_i_D1),
        .R(bus2ip_reset));
endmodule

module adc_tech_dac_cal_control_0_axi_lite_ipif
   (bus2ip_reset,
    \GEN_BKEND_CE_REGISTERS[3].ce_out_i_reg ,
    \GEN_BKEND_CE_REGISTERS[2].ce_out_i_reg ,
    \GEN_BKEND_CE_REGISTERS[1].ce_out_i_reg ,
    \GEN_BKEND_CE_REGISTERS[0].ce_out_i_reg ,
    bus2ip_rnw,
    Bus_RNW_reg,
    s_axi_rvalid_i_reg,
    s_axi_bvalid_i_reg,
    bus2ip_cs,
    E,
    ip2bus_rdack_i_D1_reg,
    ip2bus_wrack_i_D1_reg,
    s_axi_rdata,
    s_axi_aclk,
    s_axi_arvalid,
    s_axi_rready,
    s_axi_bready,
    s_axi_aresetn,
    s_axi_awvalid,
    s_axi_wvalid,
    Q,
    ip2bus_rdack_i_D1,
    ip2bus_wrack_i_D1,
    s_axi_araddr,
    s_axi_awaddr);
  output bus2ip_reset;
  output \GEN_BKEND_CE_REGISTERS[3].ce_out_i_reg ;
  output \GEN_BKEND_CE_REGISTERS[2].ce_out_i_reg ;
  output \GEN_BKEND_CE_REGISTERS[1].ce_out_i_reg ;
  output \GEN_BKEND_CE_REGISTERS[0].ce_out_i_reg ;
  output bus2ip_rnw;
  output Bus_RNW_reg;
  output s_axi_rvalid_i_reg;
  output s_axi_bvalid_i_reg;
  output bus2ip_cs;
  output [0:0]E;
  output ip2bus_rdack_i_D1_reg;
  output ip2bus_wrack_i_D1_reg;
  output [31:0]s_axi_rdata;
  input s_axi_aclk;
  input s_axi_arvalid;
  input s_axi_rready;
  input s_axi_bready;
  input s_axi_aresetn;
  input s_axi_awvalid;
  input s_axi_wvalid;
  input [31:0]Q;
  input ip2bus_rdack_i_D1;
  input ip2bus_wrack_i_D1;
  input [2:0]s_axi_araddr;
  input [2:0]s_axi_awaddr;

  wire Bus_RNW_reg;
  wire [0:0]E;
  wire \GEN_BKEND_CE_REGISTERS[0].ce_out_i_reg ;
  wire \GEN_BKEND_CE_REGISTERS[1].ce_out_i_reg ;
  wire \GEN_BKEND_CE_REGISTERS[2].ce_out_i_reg ;
  wire \GEN_BKEND_CE_REGISTERS[3].ce_out_i_reg ;
  wire [31:0]Q;
  wire bus2ip_cs;
  wire bus2ip_reset;
  wire bus2ip_rnw;
  wire ip2bus_rdack_i_D1;
  wire ip2bus_rdack_i_D1_reg;
  wire ip2bus_wrack_i_D1;
  wire ip2bus_wrack_i_D1_reg;
  wire s_axi_aclk;
  wire [2:0]s_axi_araddr;
  wire s_axi_aresetn;
  wire s_axi_arvalid;
  wire [2:0]s_axi_awaddr;
  wire s_axi_awvalid;
  wire s_axi_bready;
  wire s_axi_bvalid_i_reg;
  wire [31:0]s_axi_rdata;
  wire s_axi_rready;
  wire s_axi_rvalid_i_reg;
  wire s_axi_wvalid;

  adc_tech_dac_cal_control_0_slave_attachment I_SLAVE_ATTACHMENT
       (.Bus_RNW_reg(Bus_RNW_reg),
        .E(E),
        .\GEN_BKEND_CE_REGISTERS[0].ce_out_i_reg (\GEN_BKEND_CE_REGISTERS[0].ce_out_i_reg ),
        .\GEN_BKEND_CE_REGISTERS[1].ce_out_i_reg (\GEN_BKEND_CE_REGISTERS[1].ce_out_i_reg ),
        .\GEN_BKEND_CE_REGISTERS[2].ce_out_i_reg (\GEN_BKEND_CE_REGISTERS[2].ce_out_i_reg ),
        .\GEN_BKEND_CE_REGISTERS[3].ce_out_i_reg (\GEN_BKEND_CE_REGISTERS[3].ce_out_i_reg ),
        .Q(Q),
        .SR(bus2ip_reset),
        .bus2ip_cs(bus2ip_cs),
        .bus2ip_rnw(bus2ip_rnw),
        .ip2bus_rdack_i_D1(ip2bus_rdack_i_D1),
        .ip2bus_rdack_i_D1_reg(ip2bus_rdack_i_D1_reg),
        .ip2bus_wrack_i_D1(ip2bus_wrack_i_D1),
        .ip2bus_wrack_i_D1_reg(ip2bus_wrack_i_D1_reg),
        .s_axi_aclk(s_axi_aclk),
        .s_axi_araddr(s_axi_araddr),
        .s_axi_aresetn(s_axi_aresetn),
        .s_axi_arvalid(s_axi_arvalid),
        .s_axi_awaddr(s_axi_awaddr),
        .s_axi_awvalid(s_axi_awvalid),
        .s_axi_bready(s_axi_bready),
        .s_axi_bvalid_i_reg_0(s_axi_bvalid_i_reg),
        .s_axi_rdata(s_axi_rdata),
        .s_axi_rready(s_axi_rready),
        .s_axi_rvalid_i_reg_0(s_axi_rvalid_i_reg),
        .s_axi_wvalid(s_axi_wvalid));
endmodule

module adc_tech_dac_cal_control_0_pselect_f
   (ce_expnd_i_3,
    \GEN_BKEND_CE_REGISTERS[0].ce_out_i_reg[0] );
  output ce_expnd_i_3;
  input [1:0]\GEN_BKEND_CE_REGISTERS[0].ce_out_i_reg[0] ;

  wire [1:0]\GEN_BKEND_CE_REGISTERS[0].ce_out_i_reg[0] ;
  wire ce_expnd_i_3;

  LUT2 #(
    .INIT(4'h1)) 
    CS
       (.I0(\GEN_BKEND_CE_REGISTERS[0].ce_out_i_reg[0] [0]),
        .I1(\GEN_BKEND_CE_REGISTERS[0].ce_out_i_reg[0] [1]),
        .O(ce_expnd_i_3));
endmodule

(* ORIG_REF_NAME = "pselect_f" *) 
module adc_tech_dac_cal_control_0_pselect_f__parameterized1
   (ce_expnd_i_1,
    \GEN_BKEND_CE_REGISTERS[2].ce_out_i_reg[2] );
  output ce_expnd_i_1;
  input [1:0]\GEN_BKEND_CE_REGISTERS[2].ce_out_i_reg[2] ;

  wire [1:0]\GEN_BKEND_CE_REGISTERS[2].ce_out_i_reg[2] ;
  wire ce_expnd_i_1;

  LUT2 #(
    .INIT(4'h2)) 
    CS
       (.I0(\GEN_BKEND_CE_REGISTERS[2].ce_out_i_reg[2] [1]),
        .I1(\GEN_BKEND_CE_REGISTERS[2].ce_out_i_reg[2] [0]),
        .O(ce_expnd_i_1));
endmodule

module adc_tech_dac_cal_control_0_slave_attachment
   (SR,
    \GEN_BKEND_CE_REGISTERS[3].ce_out_i_reg ,
    \GEN_BKEND_CE_REGISTERS[2].ce_out_i_reg ,
    \GEN_BKEND_CE_REGISTERS[1].ce_out_i_reg ,
    \GEN_BKEND_CE_REGISTERS[0].ce_out_i_reg ,
    bus2ip_rnw,
    Bus_RNW_reg,
    s_axi_rvalid_i_reg_0,
    s_axi_bvalid_i_reg_0,
    bus2ip_cs,
    E,
    ip2bus_rdack_i_D1_reg,
    ip2bus_wrack_i_D1_reg,
    s_axi_rdata,
    s_axi_aclk,
    s_axi_arvalid,
    s_axi_rready,
    s_axi_bready,
    s_axi_aresetn,
    s_axi_awvalid,
    s_axi_wvalid,
    Q,
    ip2bus_rdack_i_D1,
    ip2bus_wrack_i_D1,
    s_axi_araddr,
    s_axi_awaddr);
  output [0:0]SR;
  output \GEN_BKEND_CE_REGISTERS[3].ce_out_i_reg ;
  output \GEN_BKEND_CE_REGISTERS[2].ce_out_i_reg ;
  output \GEN_BKEND_CE_REGISTERS[1].ce_out_i_reg ;
  output \GEN_BKEND_CE_REGISTERS[0].ce_out_i_reg ;
  output bus2ip_rnw;
  output Bus_RNW_reg;
  output s_axi_rvalid_i_reg_0;
  output s_axi_bvalid_i_reg_0;
  output bus2ip_cs;
  output [0:0]E;
  output ip2bus_rdack_i_D1_reg;
  output ip2bus_wrack_i_D1_reg;
  output [31:0]s_axi_rdata;
  input s_axi_aclk;
  input s_axi_arvalid;
  input s_axi_rready;
  input s_axi_bready;
  input s_axi_aresetn;
  input s_axi_awvalid;
  input s_axi_wvalid;
  input [31:0]Q;
  input ip2bus_rdack_i_D1;
  input ip2bus_wrack_i_D1;
  input [2:0]s_axi_araddr;
  input [2:0]s_axi_awaddr;

  wire Bus_RNW_reg;
  wire [0:0]E;
  wire \FSM_onehot_state[0]_i_1_n_0 ;
  wire \FSM_onehot_state[1]_i_1_n_0 ;
  wire \FSM_onehot_state[2]_i_1_n_0 ;
  wire \FSM_onehot_state[3]_i_1_n_0 ;
  wire \FSM_onehot_state_reg_n_0_[0] ;
  wire \FSM_onehot_state_reg_n_0_[3] ;
  wire \GEN_BKEND_CE_REGISTERS[0].ce_out_i_reg ;
  wire \GEN_BKEND_CE_REGISTERS[1].ce_out_i_reg ;
  wire \GEN_BKEND_CE_REGISTERS[2].ce_out_i_reg ;
  wire \GEN_BKEND_CE_REGISTERS[3].ce_out_i_reg ;
  wire [3:0]\INCLUDE_DPHASE_TIMER.dpto_cnt_reg ;
  wire [31:0]Q;
  wire [0:0]SR;
  wire [0:6]bus2ip_addr;
  wire \bus2ip_addr_i[8]_i_1_n_0 ;
  wire bus2ip_cs;
  wire bus2ip_rnw;
  wire clear;
  wire ip2bus_rdack_i_D1;
  wire ip2bus_rdack_i_D1_reg;
  wire ip2bus_wrack_i_D1;
  wire ip2bus_wrack_i_D1_reg;
  wire is_read;
  wire is_read_i_1_n_0;
  wire is_read_reg_n_0;
  wire is_write;
  wire is_write_reg_n_0;
  wire p_0_in;
  wire [1:0]p_0_out;
  wire [8:2]p_1_in;
  wire p_5_in;
  wire [3:0]plusOp;
  wire s_axi_aclk;
  wire [2:0]s_axi_araddr;
  wire s_axi_aresetn;
  wire s_axi_arvalid;
  wire [2:0]s_axi_awaddr;
  wire s_axi_awvalid;
  wire s_axi_bready;
  wire s_axi_bresp_i;
  wire s_axi_bvalid_i_i_1_n_0;
  wire s_axi_bvalid_i_reg_0;
  wire [31:0]s_axi_rdata;
  wire s_axi_rready;
  wire s_axi_rresp_i;
  wire s_axi_rvalid_i_i_1_n_0;
  wire s_axi_rvalid_i_reg_0;
  wire s_axi_wvalid;
  wire start2;
  wire start2_i_1_n_0;
  wire [1:0]state;
  wire state1__2;

  LUT6 #(
    .INIT(64'hFFFF150015001500)) 
    \FSM_onehot_state[0]_i_1 
       (.I0(s_axi_arvalid),
        .I1(s_axi_wvalid),
        .I2(s_axi_awvalid),
        .I3(\FSM_onehot_state_reg_n_0_[0] ),
        .I4(state1__2),
        .I5(\FSM_onehot_state_reg_n_0_[3] ),
        .O(\FSM_onehot_state[0]_i_1_n_0 ));
  LUT4 #(
    .INIT(16'h8F88)) 
    \FSM_onehot_state[1]_i_1 
       (.I0(s_axi_arvalid),
        .I1(\FSM_onehot_state_reg_n_0_[0] ),
        .I2(ip2bus_rdack_i_D1_reg),
        .I3(s_axi_rresp_i),
        .O(\FSM_onehot_state[1]_i_1_n_0 ));
  LUT6 #(
    .INIT(64'h0800FFFF08000800)) 
    \FSM_onehot_state[2]_i_1 
       (.I0(s_axi_wvalid),
        .I1(s_axi_awvalid),
        .I2(s_axi_arvalid),
        .I3(\FSM_onehot_state_reg_n_0_[0] ),
        .I4(ip2bus_wrack_i_D1_reg),
        .I5(s_axi_bresp_i),
        .O(\FSM_onehot_state[2]_i_1_n_0 ));
  LUT6 #(
    .INIT(64'hF888F888FFFFF888)) 
    \FSM_onehot_state[3]_i_1 
       (.I0(ip2bus_wrack_i_D1_reg),
        .I1(s_axi_bresp_i),
        .I2(s_axi_rresp_i),
        .I3(ip2bus_rdack_i_D1_reg),
        .I4(\FSM_onehot_state_reg_n_0_[3] ),
        .I5(state1__2),
        .O(\FSM_onehot_state[3]_i_1_n_0 ));
  LUT4 #(
    .INIT(16'hF888)) 
    \FSM_onehot_state[3]_i_2 
       (.I0(s_axi_bready),
        .I1(s_axi_bvalid_i_reg_0),
        .I2(s_axi_rready),
        .I3(s_axi_rvalid_i_reg_0),
        .O(state1__2));
  (* FSM_ENCODED_STATES = "iSTATE:0010,iSTATE0:0100,iSTATE1:1000,iSTATE2:0001" *) 
  FDSE #(
    .INIT(1'b1)) 
    \FSM_onehot_state_reg[0] 
       (.C(s_axi_aclk),
        .CE(1'b1),
        .D(\FSM_onehot_state[0]_i_1_n_0 ),
        .Q(\FSM_onehot_state_reg_n_0_[0] ),
        .S(SR));
  (* FSM_ENCODED_STATES = "iSTATE:0010,iSTATE0:0100,iSTATE1:1000,iSTATE2:0001" *) 
  FDRE #(
    .INIT(1'b0)) 
    \FSM_onehot_state_reg[1] 
       (.C(s_axi_aclk),
        .CE(1'b1),
        .D(\FSM_onehot_state[1]_i_1_n_0 ),
        .Q(s_axi_rresp_i),
        .R(SR));
  (* FSM_ENCODED_STATES = "iSTATE:0010,iSTATE0:0100,iSTATE1:1000,iSTATE2:0001" *) 
  FDRE #(
    .INIT(1'b0)) 
    \FSM_onehot_state_reg[2] 
       (.C(s_axi_aclk),
        .CE(1'b1),
        .D(\FSM_onehot_state[2]_i_1_n_0 ),
        .Q(s_axi_bresp_i),
        .R(SR));
  (* FSM_ENCODED_STATES = "iSTATE:0010,iSTATE0:0100,iSTATE1:1000,iSTATE2:0001" *) 
  FDRE #(
    .INIT(1'b0)) 
    \FSM_onehot_state_reg[3] 
       (.C(s_axi_aclk),
        .CE(1'b1),
        .D(\FSM_onehot_state[3]_i_1_n_0 ),
        .Q(\FSM_onehot_state_reg_n_0_[3] ),
        .R(SR));
  (* SOFT_HLUTNM = "soft_lutpair5" *) 
  LUT1 #(
    .INIT(2'h1)) 
    \INCLUDE_DPHASE_TIMER.dpto_cnt[0]_i_1 
       (.I0(\INCLUDE_DPHASE_TIMER.dpto_cnt_reg [0]),
        .O(plusOp[0]));
  (* SOFT_HLUTNM = "soft_lutpair5" *) 
  LUT2 #(
    .INIT(4'h6)) 
    \INCLUDE_DPHASE_TIMER.dpto_cnt[1]_i_1 
       (.I0(\INCLUDE_DPHASE_TIMER.dpto_cnt_reg [0]),
        .I1(\INCLUDE_DPHASE_TIMER.dpto_cnt_reg [1]),
        .O(plusOp[1]));
  (* SOFT_HLUTNM = "soft_lutpair3" *) 
  LUT3 #(
    .INIT(8'h78)) 
    \INCLUDE_DPHASE_TIMER.dpto_cnt[2]_i_1 
       (.I0(\INCLUDE_DPHASE_TIMER.dpto_cnt_reg [0]),
        .I1(\INCLUDE_DPHASE_TIMER.dpto_cnt_reg [1]),
        .I2(\INCLUDE_DPHASE_TIMER.dpto_cnt_reg [2]),
        .O(plusOp[2]));
  LUT2 #(
    .INIT(4'h9)) 
    \INCLUDE_DPHASE_TIMER.dpto_cnt[3]_i_1 
       (.I0(state[0]),
        .I1(state[1]),
        .O(clear));
  (* SOFT_HLUTNM = "soft_lutpair3" *) 
  LUT4 #(
    .INIT(16'h7F80)) 
    \INCLUDE_DPHASE_TIMER.dpto_cnt[3]_i_2 
       (.I0(\INCLUDE_DPHASE_TIMER.dpto_cnt_reg [1]),
        .I1(\INCLUDE_DPHASE_TIMER.dpto_cnt_reg [0]),
        .I2(\INCLUDE_DPHASE_TIMER.dpto_cnt_reg [2]),
        .I3(\INCLUDE_DPHASE_TIMER.dpto_cnt_reg [3]),
        .O(plusOp[3]));
  FDRE \INCLUDE_DPHASE_TIMER.dpto_cnt_reg[0] 
       (.C(s_axi_aclk),
        .CE(1'b1),
        .D(plusOp[0]),
        .Q(\INCLUDE_DPHASE_TIMER.dpto_cnt_reg [0]),
        .R(clear));
  FDRE \INCLUDE_DPHASE_TIMER.dpto_cnt_reg[1] 
       (.C(s_axi_aclk),
        .CE(1'b1),
        .D(plusOp[1]),
        .Q(\INCLUDE_DPHASE_TIMER.dpto_cnt_reg [1]),
        .R(clear));
  FDRE \INCLUDE_DPHASE_TIMER.dpto_cnt_reg[2] 
       (.C(s_axi_aclk),
        .CE(1'b1),
        .D(plusOp[2]),
        .Q(\INCLUDE_DPHASE_TIMER.dpto_cnt_reg [2]),
        .R(clear));
  FDRE \INCLUDE_DPHASE_TIMER.dpto_cnt_reg[3] 
       (.C(s_axi_aclk),
        .CE(1'b1),
        .D(plusOp[3]),
        .Q(\INCLUDE_DPHASE_TIMER.dpto_cnt_reg [3]),
        .R(clear));
  adc_tech_dac_cal_control_0_address_decoder I_DECODER
       (.Bus_RNW_reg(Bus_RNW_reg),
        .E(E),
        .\GEN_BKEND_CE_REGISTERS[0].ce_out_i_reg (\GEN_BKEND_CE_REGISTERS[0].ce_out_i_reg ),
        .\GEN_BKEND_CE_REGISTERS[1].ce_out_i_reg (\GEN_BKEND_CE_REGISTERS[1].ce_out_i_reg ),
        .\GEN_BKEND_CE_REGISTERS[2].ce_out_i_reg (\GEN_BKEND_CE_REGISTERS[2].ce_out_i_reg ),
        .\GEN_BKEND_CE_REGISTERS[3].ce_out_i_reg (\GEN_BKEND_CE_REGISTERS[3].ce_out_i_reg ),
        .\Not_Dual.gpio_Data_Out_reg[0] ({bus2ip_addr[0],bus2ip_addr[5],bus2ip_addr[6]}),
        .Q(start2),
        .bus2ip_cs(bus2ip_cs),
        .bus2ip_rnw(bus2ip_rnw),
        .ip2bus_rdack_i_D1(ip2bus_rdack_i_D1),
        .ip2bus_rdack_i_D1_reg(ip2bus_rdack_i_D1_reg),
        .ip2bus_wrack_i_D1(ip2bus_wrack_i_D1),
        .ip2bus_wrack_i_D1_reg(ip2bus_wrack_i_D1_reg),
        .s_axi_aclk(s_axi_aclk),
        .s_axi_aresetn(s_axi_aresetn),
        .s_axi_arready(is_read_reg_n_0),
        .s_axi_arready_0(\INCLUDE_DPHASE_TIMER.dpto_cnt_reg ),
        .s_axi_wready(is_write_reg_n_0));
  LUT3 #(
    .INIT(8'hAC)) 
    \bus2ip_addr_i[2]_i_1 
       (.I0(s_axi_araddr[0]),
        .I1(s_axi_awaddr[0]),
        .I2(s_axi_arvalid),
        .O(p_1_in[2]));
  (* SOFT_HLUTNM = "soft_lutpair4" *) 
  LUT3 #(
    .INIT(8'hAC)) 
    \bus2ip_addr_i[3]_i_1 
       (.I0(s_axi_araddr[1]),
        .I1(s_axi_awaddr[1]),
        .I2(s_axi_arvalid),
        .O(p_1_in[3]));
  LUT5 #(
    .INIT(32'h000000EA)) 
    \bus2ip_addr_i[8]_i_1 
       (.I0(s_axi_arvalid),
        .I1(s_axi_awvalid),
        .I2(s_axi_wvalid),
        .I3(state[1]),
        .I4(state[0]),
        .O(\bus2ip_addr_i[8]_i_1_n_0 ));
  (* SOFT_HLUTNM = "soft_lutpair4" *) 
  LUT3 #(
    .INIT(8'hAC)) 
    \bus2ip_addr_i[8]_i_2 
       (.I0(s_axi_araddr[2]),
        .I1(s_axi_awaddr[2]),
        .I2(s_axi_arvalid),
        .O(p_1_in[8]));
  FDRE \bus2ip_addr_i_reg[2] 
       (.C(s_axi_aclk),
        .CE(\bus2ip_addr_i[8]_i_1_n_0 ),
        .D(p_1_in[2]),
        .Q(bus2ip_addr[6]),
        .R(SR));
  FDRE \bus2ip_addr_i_reg[3] 
       (.C(s_axi_aclk),
        .CE(\bus2ip_addr_i[8]_i_1_n_0 ),
        .D(p_1_in[3]),
        .Q(bus2ip_addr[5]),
        .R(SR));
  FDRE \bus2ip_addr_i_reg[8] 
       (.C(s_axi_aclk),
        .CE(\bus2ip_addr_i[8]_i_1_n_0 ),
        .D(p_1_in[8]),
        .Q(bus2ip_addr[0]),
        .R(SR));
  FDRE bus2ip_rnw_i_reg
       (.C(s_axi_aclk),
        .CE(\bus2ip_addr_i[8]_i_1_n_0 ),
        .D(s_axi_arvalid),
        .Q(bus2ip_rnw),
        .R(SR));
  LUT6 #(
    .INIT(64'hFFEAEAEAAAAAAAAA)) 
    is_read_i_1
       (.I0(\FSM_onehot_state_reg_n_0_[0] ),
        .I1(s_axi_bready),
        .I2(s_axi_bvalid_i_reg_0),
        .I3(s_axi_rready),
        .I4(s_axi_rvalid_i_reg_0),
        .I5(\FSM_onehot_state_reg_n_0_[3] ),
        .O(is_read_i_1_n_0));
  (* SOFT_HLUTNM = "soft_lutpair2" *) 
  LUT2 #(
    .INIT(4'h8)) 
    is_read_i_2
       (.I0(\FSM_onehot_state_reg_n_0_[0] ),
        .I1(s_axi_arvalid),
        .O(is_read));
  FDRE is_read_reg
       (.C(s_axi_aclk),
        .CE(is_read_i_1_n_0),
        .D(is_read),
        .Q(is_read_reg_n_0),
        .R(SR));
  (* SOFT_HLUTNM = "soft_lutpair2" *) 
  LUT4 #(
    .INIT(16'h2000)) 
    is_write_i_1
       (.I0(\FSM_onehot_state_reg_n_0_[0] ),
        .I1(s_axi_arvalid),
        .I2(s_axi_awvalid),
        .I3(s_axi_wvalid),
        .O(is_write));
  FDRE is_write_reg
       (.C(s_axi_aclk),
        .CE(is_read_i_1_n_0),
        .D(is_write),
        .Q(is_write_reg_n_0),
        .R(SR));
  LUT1 #(
    .INIT(2'h1)) 
    rst_i_1
       (.I0(s_axi_aresetn),
        .O(p_0_in));
  FDRE rst_reg
       (.C(s_axi_aclk),
        .CE(1'b1),
        .D(p_0_in),
        .Q(SR),
        .R(1'b0));
  LUT5 #(
    .INIT(32'h08FF0808)) 
    s_axi_bvalid_i_i_1
       (.I0(ip2bus_wrack_i_D1_reg),
        .I1(state[1]),
        .I2(state[0]),
        .I3(s_axi_bready),
        .I4(s_axi_bvalid_i_reg_0),
        .O(s_axi_bvalid_i_i_1_n_0));
  FDRE #(
    .INIT(1'b0)) 
    s_axi_bvalid_i_reg
       (.C(s_axi_aclk),
        .CE(1'b1),
        .D(s_axi_bvalid_i_i_1_n_0),
        .Q(s_axi_bvalid_i_reg_0),
        .R(SR));
  FDRE #(
    .INIT(1'b0)) 
    \s_axi_rdata_i_reg[0] 
       (.C(s_axi_aclk),
        .CE(s_axi_rresp_i),
        .D(Q[0]),
        .Q(s_axi_rdata[0]),
        .R(SR));
  FDRE #(
    .INIT(1'b0)) 
    \s_axi_rdata_i_reg[10] 
       (.C(s_axi_aclk),
        .CE(s_axi_rresp_i),
        .D(Q[10]),
        .Q(s_axi_rdata[10]),
        .R(SR));
  FDRE #(
    .INIT(1'b0)) 
    \s_axi_rdata_i_reg[11] 
       (.C(s_axi_aclk),
        .CE(s_axi_rresp_i),
        .D(Q[11]),
        .Q(s_axi_rdata[11]),
        .R(SR));
  FDRE #(
    .INIT(1'b0)) 
    \s_axi_rdata_i_reg[12] 
       (.C(s_axi_aclk),
        .CE(s_axi_rresp_i),
        .D(Q[12]),
        .Q(s_axi_rdata[12]),
        .R(SR));
  FDRE #(
    .INIT(1'b0)) 
    \s_axi_rdata_i_reg[13] 
       (.C(s_axi_aclk),
        .CE(s_axi_rresp_i),
        .D(Q[13]),
        .Q(s_axi_rdata[13]),
        .R(SR));
  FDRE #(
    .INIT(1'b0)) 
    \s_axi_rdata_i_reg[14] 
       (.C(s_axi_aclk),
        .CE(s_axi_rresp_i),
        .D(Q[14]),
        .Q(s_axi_rdata[14]),
        .R(SR));
  FDRE #(
    .INIT(1'b0)) 
    \s_axi_rdata_i_reg[15] 
       (.C(s_axi_aclk),
        .CE(s_axi_rresp_i),
        .D(Q[15]),
        .Q(s_axi_rdata[15]),
        .R(SR));
  FDRE #(
    .INIT(1'b0)) 
    \s_axi_rdata_i_reg[16] 
       (.C(s_axi_aclk),
        .CE(s_axi_rresp_i),
        .D(Q[16]),
        .Q(s_axi_rdata[16]),
        .R(SR));
  FDRE #(
    .INIT(1'b0)) 
    \s_axi_rdata_i_reg[17] 
       (.C(s_axi_aclk),
        .CE(s_axi_rresp_i),
        .D(Q[17]),
        .Q(s_axi_rdata[17]),
        .R(SR));
  FDRE #(
    .INIT(1'b0)) 
    \s_axi_rdata_i_reg[18] 
       (.C(s_axi_aclk),
        .CE(s_axi_rresp_i),
        .D(Q[18]),
        .Q(s_axi_rdata[18]),
        .R(SR));
  FDRE #(
    .INIT(1'b0)) 
    \s_axi_rdata_i_reg[19] 
       (.C(s_axi_aclk),
        .CE(s_axi_rresp_i),
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
        .I1(s_axi_wvalid),
        .I2(s_axi_arvalid),
        .I3(state[1]),
        .I4(state[0]),
        .O(start2_i_1_n_0));
  FDRE start2_reg
       (.C(s_axi_aclk),
        .CE(1'b1),
        .D(start2_i_1_n_0),
        .Q(start2),
        .R(SR));
  LUT5 #(
    .INIT(32'h77FC44FC)) 
    \state[0]_i_1 
       (.I0(state1__2),
        .I1(state[0]),
        .I2(s_axi_arvalid),
        .I3(state[1]),
        .I4(ip2bus_wrack_i_D1_reg),
        .O(p_0_out[0]));
  LUT6 #(
    .INIT(64'h55FFFF0C5500FF0C)) 
    \state[1]_i_1 
       (.I0(state1__2),
        .I1(p_5_in),
        .I2(s_axi_arvalid),
        .I3(state[1]),
        .I4(state[0]),
        .I5(ip2bus_rdack_i_D1_reg),
        .O(p_0_out[1]));
  (* SOFT_HLUTNM = "soft_lutpair1" *) 
  LUT2 #(
    .INIT(4'h8)) 
    \state[1]_i_2 
       (.I0(s_axi_awvalid),
        .I1(s_axi_wvalid),
        .O(p_5_in));
  FDRE \state_reg[0] 
       (.C(s_axi_aclk),
        .CE(1'b1),
        .D(p_0_out[0]),
        .Q(state[0]),
        .R(SR));
  FDRE \state_reg[1] 
       (.C(s_axi_aclk),
        .CE(1'b1),
        .D(p_0_out[1]),
        .Q(state[1]),
        .R(SR));
endmodule
`ifndef GLBL
`define GLBL
`timescale  1 ps / 1 ps

module glbl ();

    parameter ROC_WIDTH = 100000;
    parameter TOC_WIDTH = 0;
    parameter GRES_WIDTH = 10000;
    parameter GRES_START = 10000;

//--------   STARTUP Globals --------------
    wire GSR;
    wire GTS;
    wire GWE;
    wire PRLD;
    wire GRESTORE;
    tri1 p_up_tmp;
    tri (weak1, strong0) PLL_LOCKG = p_up_tmp;

    wire PROGB_GLBL;
    wire CCLKO_GLBL;
    wire FCSBO_GLBL;
    wire [3:0] DO_GLBL;
    wire [3:0] DI_GLBL;
   
    reg GSR_int;
    reg GTS_int;
    reg PRLD_int;
    reg GRESTORE_int;

//--------   JTAG Globals --------------
    wire JTAG_TDO_GLBL;
    wire JTAG_TCK_GLBL;
    wire JTAG_TDI_GLBL;
    wire JTAG_TMS_GLBL;
    wire JTAG_TRST_GLBL;

    reg JTAG_CAPTURE_GLBL;
    reg JTAG_RESET_GLBL;
    reg JTAG_SHIFT_GLBL;
    reg JTAG_UPDATE_GLBL;
    reg JTAG_RUNTEST_GLBL;

    reg JTAG_SEL1_GLBL = 0;
    reg JTAG_SEL2_GLBL = 0 ;
    reg JTAG_SEL3_GLBL = 0;
    reg JTAG_SEL4_GLBL = 0;

    reg JTAG_USER_TDO1_GLBL = 1'bz;
    reg JTAG_USER_TDO2_GLBL = 1'bz;
    reg JTAG_USER_TDO3_GLBL = 1'bz;
    reg JTAG_USER_TDO4_GLBL = 1'bz;

    assign (strong1, weak0) GSR = GSR_int;
    assign (strong1, weak0) GTS = GTS_int;
    assign (weak1, weak0) PRLD = PRLD_int;
    assign (strong1, weak0) GRESTORE = GRESTORE_int;

    initial begin
	GSR_int = 1'b1;
	PRLD_int = 1'b1;
	#(ROC_WIDTH)
	GSR_int = 1'b0;
	PRLD_int = 1'b0;
    end

    initial begin
	GTS_int = 1'b1;
	#(TOC_WIDTH)
	GTS_int = 1'b0;
    end

    initial begin 
	GRESTORE_int = 1'b0;
	#(GRES_START);
	GRESTORE_int = 1'b1;
	#(GRES_WIDTH);
	GRESTORE_int = 1'b0;
    end

endmodule
`endif
