AdriaanSadie/MVT_ADC_TECH/adc_tech/adc_tech.ip_user_files/bd/adc_tech/adc_tech.gen/sources_1/bd/adc_tech/ip/adc_tech_dac_cal_control_0/adc_tech_dac_cal_control_0_sim_netlist.vhdl

-- Copyright 1986-2020 Xilinx, Inc. All Rights Reserved.
-- --------------------------------------------------------------------------------
-- Tool Version: Vivado v.2020.2 (win64) Build 3064766 Wed Nov 18 09:12:45 MST 2020
-- Date        : Mon Sep 22 10:03:20 2025
-- Host        : ZA-WASADIE1 running 64-bit major release  (build 9200)
-- Command     : write_vhdl -force -mode funcsim -rename_top adc_tech_dac_cal_control_0 -prefix
--               adc_tech_dac_cal_control_0_ adc_tech_axi_gpio_0_0_sim_netlist.vhdl
-- Design      : adc_tech_axi_gpio_0_0
-- Purpose     : This VHDL netlist is a functional simulation representation of the design and should not be modified or
--               synthesized. This netlist cannot be used for SDF annotated simulation.
-- Device      : xczu7ev-ffvc1156-2-e
-- --------------------------------------------------------------------------------
library IEEE;
use IEEE.STD_LOGIC_1164.ALL;
library UNISIM;
use UNISIM.VCOMPONENTS.ALL;
entity adc_tech_dac_cal_control_0_GPIO_Core is
  port (
    gpio_io_o : out STD_LOGIC_VECTOR ( 31 downto 0 );
    ip2bus_wrack_i : out STD_LOGIC;
    ip2bus_rdack_i : out STD_LOGIC;
    D : out STD_LOGIC_VECTOR ( 31 downto 0 );
    s_axi_aclk : in STD_LOGIC;
    bus2ip_reset : in STD_LOGIC;
    bus2ip_cs : in STD_LOGIC;
    bus2ip_rnw : in STD_LOGIC;
    E : in STD_LOGIC_VECTOR ( 0 to 0 );
    s_axi_wdata : in STD_LOGIC_VECTOR ( 31 downto 0 );
    \GEN_BKEND_CE_REGISTERS[2].ce_out_i_reg\ : in STD_LOGIC;
    \GEN_BKEND_CE_REGISTERS[0].ce_out_i_reg\ : in STD_LOGIC;
    \GEN_BKEND_CE_REGISTERS[1].ce_out_i_reg\ : in STD_LOGIC;
    Bus_RNW_reg : in STD_LOGIC;
    \GEN_BKEND_CE_REGISTERS[3].ce_out_i_reg\ : in STD_LOGIC
  );
end adc_tech_dac_cal_control_0_GPIO_Core;

architecture STRUCTURE of adc_tech_dac_cal_control_0_GPIO_Core is
  signal GPIO_xferAck_i : STD_LOGIC;
  signal \Not_Dual.ALLOUT_ND.READ_REG_GEN[0].reg1_reg\ : STD_LOGIC;
  signal \Not_Dual.ALLOUT_ND.READ_REG_GEN[10].reg1_reg\ : STD_LOGIC;
  signal \Not_Dual.ALLOUT_ND.READ_REG_GEN[11].reg1_reg\ : STD_LOGIC;
  signal \Not_Dual.ALLOUT_ND.READ_REG_GEN[12].reg1_reg\ : STD_LOGIC;
  signal \Not_Dual.ALLOUT_ND.READ_REG_GEN[13].reg1_reg\ : STD_LOGIC;
  signal \Not_Dual.ALLOUT_ND.READ_REG_GEN[14].reg1_reg\ : STD_LOGIC;
  signal \Not_Dual.ALLOUT_ND.READ_REG_GEN[15].reg1_reg\ : STD_LOGIC;
  signal \Not_Dual.ALLOUT_ND.READ_REG_GEN[16].reg1_reg\ : STD_LOGIC;
  signal \Not_Dual.ALLOUT_ND.READ_REG_GEN[17].reg1_reg\ : STD_LOGIC;
  signal \Not_Dual.ALLOUT_ND.READ_REG_GEN[18].reg1_reg\ : STD_LOGIC;
  signal \Not_Dual.ALLOUT_ND.READ_REG_GEN[19].reg1_reg\ : STD_LOGIC;
  signal \Not_Dual.ALLOUT_ND.READ_REG_GEN[1].reg1_reg\ : STD_LOGIC;
  signal \Not_Dual.ALLOUT_ND.READ_REG_GEN[20].reg1_reg\ : STD_LOGIC;
  signal \Not_Dual.ALLOUT_ND.READ_REG_GEN[21].reg1_reg\ : STD_LOGIC;
  signal \Not_Dual.ALLOUT_ND.READ_REG_GEN[22].reg1_reg\ : STD_LOGIC;
  signal \Not_Dual.ALLOUT_ND.READ_REG_GEN[23].reg1_reg\ : STD_LOGIC;
  signal \Not_Dual.ALLOUT_ND.READ_REG_GEN[24].reg1_reg\ : STD_LOGIC;
  signal \Not_Dual.ALLOUT_ND.READ_REG_GEN[25].reg1_reg\ : STD_LOGIC;
  signal \Not_Dual.ALLOUT_ND.READ_REG_GEN[26].reg1_reg\ : STD_LOGIC;
  signal \Not_Dual.ALLOUT_ND.READ_REG_GEN[27].reg1_reg\ : STD_LOGIC;
  signal \Not_Dual.ALLOUT_ND.READ_REG_GEN[28].reg1_reg\ : STD_LOGIC;
  signal \Not_Dual.ALLOUT_ND.READ_REG_GEN[29].reg1_reg\ : STD_LOGIC;
  signal \Not_Dual.ALLOUT_ND.READ_REG_GEN[2].reg1_reg\ : STD_LOGIC;
  signal \Not_Dual.ALLOUT_ND.READ_REG_GEN[30].reg1_reg\ : STD_LOGIC;
  signal \Not_Dual.ALLOUT_ND.READ_REG_GEN[31].reg1_reg\ : STD_LOGIC;
  signal \Not_Dual.ALLOUT_ND.READ_REG_GEN[3].reg1_reg\ : STD_LOGIC;
  signal \Not_Dual.ALLOUT_ND.READ_REG_GEN[4].reg1_reg\ : STD_LOGIC;
  signal \Not_Dual.ALLOUT_ND.READ_REG_GEN[5].reg1_reg\ : STD_LOGIC;
  signal \Not_Dual.ALLOUT_ND.READ_REG_GEN[6].reg1_reg\ : STD_LOGIC;
  signal \Not_Dual.ALLOUT_ND.READ_REG_GEN[7].reg1_reg\ : STD_LOGIC;
  signal \Not_Dual.ALLOUT_ND.READ_REG_GEN[8].reg1_reg\ : STD_LOGIC;
  signal \Not_Dual.ALLOUT_ND.READ_REG_GEN[9].reg1_reg\ : STD_LOGIC;
  signal \Read_Reg_Rst__0\ : STD_LOGIC;
  signal \^gpio_io_o\ : STD_LOGIC_VECTOR ( 31 downto 0 );
  signal gpio_xferAck_Reg : STD_LOGIC;
  signal \iGPIO_xferAck__0\ : STD_LOGIC;
  attribute SOFT_HLUTNM : string;
  attribute SOFT_HLUTNM of iGPIO_xferAck : label is "soft_lutpair6";
  attribute SOFT_HLUTNM of ip2bus_wrack_i_D1_i_1 : label is "soft_lutpair6";
begin
  gpio_io_o(31 downto 0) <= \^gpio_io_o\(31 downto 0);
\Not_Dual.ALLOUT_ND.READ_REG_GEN[0].reg1_reg[0]\: unisim.vcomponents.FDRE
     port map (
      C => s_axi_aclk,
      CE => '1',
      D => \^gpio_io_o\(31),
      Q => \Not_Dual.ALLOUT_ND.READ_REG_GEN[0].reg1_reg\,
      R => \Read_Reg_Rst__0\
    );
\Not_Dual.ALLOUT_ND.READ_REG_GEN[10].reg1_reg[10]\: unisim.vcomponents.FDRE
     port map (
      C => s_axi_aclk,
      CE => '1',
      D => \^gpio_io_o\(21),
      Q => \Not_Dual.ALLOUT_ND.READ_REG_GEN[10].reg1_reg\,
      R => \Read_Reg_Rst__0\
    );
\Not_Dual.ALLOUT_ND.READ_REG_GEN[11].reg1_reg[11]\: unisim.vcomponents.FDRE
     port map (
      C => s_axi_aclk,
      CE => '1',
      D => \^gpio_io_o\(20),
      Q => \Not_Dual.ALLOUT_ND.READ_REG_GEN[11].reg1_reg\,
      R => \Read_Reg_Rst__0\
    );
\Not_Dual.ALLOUT_ND.READ_REG_GEN[12].reg1_reg[12]\: unisim.vcomponents.FDRE
     port map (
      C => s_axi_aclk,
      CE => '1',
      D => \^gpio_io_o\(19),
      Q => \Not_Dual.ALLOUT_ND.READ_REG_GEN[12].reg1_reg\,
      R => \Read_Reg_Rst__0\
    );
\Not_Dual.ALLOUT_ND.READ_REG_GEN[13].reg1_reg[13]\: unisim.vcomponents.FDRE
     port map (
      C => s_axi_aclk,
      CE => '1',
      D => \^gpio_io_o\(18),
      Q => \Not_Dual.ALLOUT_ND.READ_REG_GEN[13].reg1_reg\,
      R => \Read_Reg_Rst__0\
    );
\Not_Dual.ALLOUT_ND.READ_REG_GEN[14].reg1_reg[14]\: unisim.vcomponents.FDRE
     port map (
      C => s_axi_aclk,
      CE => '1',
      D => \^gpio_io_o\(17),
      Q => \Not_Dual.ALLOUT_ND.READ_REG_GEN[14].reg1_reg\,
      R => \Read_Reg_Rst__0\
    );
\Not_Dual.ALLOUT_ND.READ_REG_GEN[15].reg1_reg[15]\: unisim.vcomponents.FDRE
     port map (
      C => s_axi_aclk,
      CE => '1',
      D => \^gpio_io_o\(16),
      Q => \Not_Dual.ALLOUT_ND.READ_REG_GEN[15].reg1_reg\,
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
      I2 => \GEN_BKEND_CE_REGISTERS[0].ce_out_i_reg\,
      I3 => \GEN_BKEND_CE_REGISTERS[1].ce_out_i_reg\,
      I4 => Bus_RNW_reg,
      I5 => \GEN_BKEND_CE_REGISTERS[3].ce_out_i_reg\,
      O => D(25)
    );
\ip2bus_data_i_D1[7]_i_1\: unisim.vcomponents.LUT6
    generic map(
      INIT => X"0005000005400000"
    )
        port map (
      I0 => \GEN_BKEND_CE_REGISTERS[2].ce_out_i_reg\,
      I1 => \Not_Dual.ALLOUT_ND.READ_REG_GEN[7].reg1_reg\,
      I2 => \GEN_BKEND_CE_REGISTERS[0].ce_out_i_reg\,
      I3 => \GEN_BKEND_CE_REGISTERS[1].ce_out_i_reg\,
      I4 => Bus_RNW_reg,
      I5 => \GEN_BKEND_CE_REGISTERS[3].ce_out_i_reg\,
      O => D(24)
    );
\ip2bus_data_i_D1[8]_i_1\: unisim.vcomponents.LUT6
    generic map(
      INIT => X"0005000005400000"
    )
        port map (
      I0 => \GEN_BKEND_CE_REGISTERS[2].ce_out_i_reg\,
      I1 => \Not_Dual.ALLOUT_ND.READ_REG_GEN[8].reg1_reg\,
      I2 => \GEN_BKEND_CE_REGISTERS[0].ce_out_i_reg\,
      I3 => \GEN_BKEND_CE_REGISTERS[1].ce_out_i_reg\,
      I4 => Bus_RNW_reg,
      I5 => \GEN_BKEND_CE_REGISTERS[3].ce_out_i_reg\,
      O => D(23)
    );
\ip2bus_data_i_D1[9]_i_1\: unisim.vcomponents.LUT6
    generic map(
      INIT => X"0005000005400000"
    )
        port map (
      I0 => \GEN_BKEND_CE_REGISTERS[2].ce_out_i_reg\,
      I1 => \Not_Dual.ALLOUT_ND.READ_REG_GEN[9].reg1_reg\,
      I2 => \GEN_BKEND_CE_REGISTERS[0].ce_out_i_reg\,
      I3 => \GEN_BKEND_CE_REGISTERS[1].ce_out_i_reg\,
      I4 => Bus_RNW_reg,
      I5 => \GEN_BKEND_CE_REGISTERS[3].ce_out_i_reg\,
      O => D(22)
    );
ip2bus_rdack_i_D1_i_1: unisim.vcomponents.LUT2
    generic map(
      INIT => X"8"
    )
        port map (
      I0 => GPIO_xferAck_i,
      I1 => bus2ip_rnw,
      O => ip2bus_rdack_i
    );
ip2bus_wrack_i_D1_i_1: unisim.vcomponents.LUT2
    generic map(
      INIT => X"2"
    )
        port map (
      I0 => GPIO_xferAck_i,
      I1 => bus2ip_rnw,
      O => ip2bus_wrack_i
    );
end STRUCTURE;
library IEEE;
use IEEE.STD_LOGIC_1164.ALL;
library UNISIM;
use UNISIM.VCOMPONENTS.ALL;
entity adc_tech_dac_cal_control_0_pselect_f is
  port (
    ce_expnd_i_3 : out STD_LOGIC;
    \GEN_BKEND_CE_REGISTERS[0].ce_out_i_reg[0]\ : in STD_LOGIC_VECTOR ( 1 downto 0 )
  );
end adc_tech_dac_cal_control_0_pselect_f;

architecture STRUCTURE of adc_tech_dac_cal_control_0_pselect_f is
begin
CS: unisim.vcomponents.LUT2
    generic map(
      INIT => X"1"
    )
        port map (
      I0 => \GEN_BKEND_CE_REGISTERS[0].ce_out_i_reg[0]\(0),
      I1 => \GEN_BKEND_CE_REGISTERS[0].ce_out_i_reg[0]\(1),
      O => ce_expnd_i_3
    );
end STRUCTURE;
library IEEE;
use IEEE.STD_LOGIC_1164.ALL;
library UNISIM;
use UNISIM.VCOMPONENTS.ALL;
entity \adc_tech_dac_cal_control_0_pselect_f__parameterized1\ is
  port (
    ce_expnd_i_1 : out STD_LOGIC;
    \GEN_BKEND_CE_REGISTERS[2].ce_out_i_reg[2]\ : in STD_LOGIC_VECTOR ( 1 downto 0 )
  );
  attribute ORIG_REF_NAME : string;
  attribute ORIG_REF_NAME of \adc_tech_dac_cal_control_0_pselect_f__parameterized1\ : entity is "pselect_f";
end \adc_tech_dac_cal_control_0_pselect_f__parameterized1\;

architecture STRUCTURE of \adc_tech_dac_cal_control_0_pselect_f__parameterized1\ is
begin
CS: unisim.vcomponents.LUT2
    generic map(
      INIT => X"2"
    )
        port map (
      I0 => \GEN_BKEND_CE_REGISTERS[2].ce_out_i_reg[2]\(1),
      I1 => \GEN_BKEND_CE_REGISTERS[2].ce_out_i_reg[2]\(0),
      O => ce_expnd_i_1
    );
end STRUCTURE;
library IEEE;
use IEEE.STD_LOGIC_1164.ALL;
library UNISIM;
use UNISIM.VCOMPONENTS.ALL;
entity adc_tech_dac_cal_control_0_address_decoder is
  port (
    \GEN_BKEND_CE_REGISTERS[3].ce_out_i_reg\ : out STD_LOGIC;
    \GEN_BKEND_CE_REGISTERS[2].ce_out_i_reg\ : out STD_LOGIC;
    \GEN_BKEND_CE_REGISTERS[1].ce_out_i_reg\ : out STD_LOGIC;
    \GEN_BKEND_CE_REGISTERS[0].ce_out_i_reg\ : out STD_LOGIC;
    Bus_RNW_reg : out STD_LOGIC;
    bus2ip_cs : out STD_LOGIC;
    E : out STD_LOGIC_VECTOR ( 0 to 0 );
    ip2bus_rdack_i_D1_reg : out STD_LOGIC;
    ip2bus_wrack_i_D1_reg : out STD_LOGIC;
    Q : in STD_LOGIC;
    s_axi_aclk : in STD_LOGIC;
    \Not_Dual.gpio_Data_Out_reg[0]\ : in STD_LOGIC_VECTOR ( 2 downto 0 );
    bus2ip_rnw : in STD_LOGIC;
    s_axi_aresetn : in STD_LOGIC;
    ip2bus_rdack_i_D1 : in STD_LOGIC;
    s_axi_arready : in STD_LOGIC;
    s_axi_arready_0 : in STD_LOGIC_VECTOR ( 3 downto 0 );
    ip2bus_wrack_i_D1 : in STD_LOGIC;
    s_axi_wready : in STD_LOGIC
  );
end adc_tech_dac_cal_control_0_address_decoder;

architecture STRUCTURE of adc_tech_dac_cal_control_0_address_decoder is
  signal \^bus_rnw_reg\ : STD_LOGIC;
  signal Bus_RNW_reg_i_1_n_0 : STD_LOGIC;
  signal \MEM_DECODE_GEN[0].cs_out_i[0]_i_1_n_0\ : STD_LOGIC;
  signal \^bus2ip_cs\ : STD_LOGIC;
  signal ce_expnd_i_0 : STD_LOGIC;
  signal ce_expnd_i_1 : STD_LOGIC;
  signal ce_expnd_i_2 : STD_LOGIC;
  signal ce_expnd_i_3 : STD_LOGIC;
  signal cs_ce_clr : STD_LOGIC;
  signal \^ip2bus_rdack_i_d1_reg\ : STD_LOGIC;
  signal \^ip2bus_wrack_i_d1_reg\ : STD_LOGIC;
  attribute SOFT_HLUTNM : string;
  attribute SOFT_HLUTNM of \GEN_BKEND_CE_REGISTERS[3].ce_out_i[3]_i_2\ : label is "soft_lutpair0";
  attribute SOFT_HLUTNM of \Not_Dual.gpio_Data_Out[0]_i_1\ : label is "soft_lutpair0";
begin
  Bus_RNW_reg <= \^bus_rnw_reg\;
  bus2ip_cs <= \^bus2ip_cs\;
  ip2bus_rdack_i_D1_reg <= \^ip2bus_rdack_i_d1_reg\;
  ip2bus_wrack_i_D1_reg <= \^ip2bus_wrack_i_d1_reg\;
Bus_RNW_reg_i_1: unisim.vcomponents.LUT3
    generic map(
      INIT => X"B8"
    )
        port map (
      I0 => bus2ip_rnw,
      I1 => Q,
      I2 => \^bus_rnw_reg\,
      O => Bus_RNW_reg_i_1_n_0
    );
Bus_RNW_reg_reg: unisim.vcomponents.FDRE
     port map (
      C => s_axi_aclk,
      CE => '1',
      D => Bus_RNW_reg_i_1_n_0,
      Q => \^bus_rnw_reg\,
      R => '0'
    );
\GEN_BKEND_CE_REGISTERS[0].ce_out_i_reg[0]\: unisim.vcomponents.FDRE
     port map (
      C => s_axi_aclk,
      CE => Q,
      D => ce_expnd_i_3,
      Q => \GEN_BKEND_CE_REGISTERS[0].ce_out_i_reg\,
      R => cs_ce_clr
    );
\GEN_BKEND_CE_REGISTERS[1].ce_out_i[1]_i_1\: unisim.vcomponents.LUT2
    generic map(
      INIT => X"2"
    )
        port map (
      I0 => \Not_Dual.gpio_Data_Out_reg[0]\(0),
      I1 => \Not_Dual.gpio_Data_Out_reg[0]\(1),
      O => ce_expnd_i_2
    );
\GEN_BKEND_CE_REGISTERS[1].ce_out_i_reg[1]\: unisim.vcomponents.FDRE
     port map (
      C => s_axi_aclk,
      CE => Q,
      D => ce_expnd_i_2,
      Q => \GEN_BKEND_CE_REGISTERS[1].ce_out_i_reg\,
      R => cs_ce_clr
    );
\GEN_BKEND_CE_REGISTERS[2].ce_out_i_reg[2]\: unisim.vcomponents.FDRE
     port map (
      C => s_axi_aclk,
      CE => Q,
      D => ce_expnd_i_1,
      Q => \GEN_BKEND_CE_REGISTERS[2].ce_out_i_reg\,
      R => cs_ce_clr
    );
\GEN_BKEND_CE_REGISTERS[3].ce_out_i[3]_i_1\: unisim.vcomponents.LUT3
    generic map(
      INIT => X"EF"
    )
        port map (
      I0 => \^ip2bus_wrack_i_d1_reg\,
      I1 => \^ip2bus_rdack_i_d1_reg\,
      I2 => s_axi_aresetn,
      O => cs_ce_clr
    );
\GEN_BKEND_CE_REGISTERS[3].ce_out_i[3]_i_2\: unisim.vcomponents.LUT2
    generic map(
      INIT => X"8"
    )
        port map (
      I0 => \Not_Dual.gpio_Data_Out_reg[0]\(1),
      I1 => \Not_Dual.gpio_Data_Out_reg[0]\(0),
      O => ce_expnd_i_0
    );
\GEN_BKEND_CE_REGISTERS[3].ce_out_i_reg[3]\: unisim.vcomponents.FDRE
     port map (
      C => s_axi_aclk,
      CE => Q,
      D => ce_expnd_i_0,
      Q => \GEN_BKEND_CE_REGISTERS[3].ce_out_i_reg\,
      R => cs_ce_clr
    );
\MEM_DECODE_GEN[0].PER_CE_GEN[0].MULTIPLE_CES_THIS_CS_GEN.CE_I\: entity work.adc_tech_dac_cal_control_0_pselect_f
     port map (
      \GEN_BKEND_CE_REGISTERS[0].ce_out_i_reg[0]\(1 downto 0) => \Not_Dual.gpio_Data_Out_reg[0]\(1 downto 0),
      ce_expnd_i_3 => ce_expnd_i_3
    );
\MEM_DECODE_GEN[0].PER_CE_GEN[2].MULTIPLE_CES_THIS_CS_GEN.CE_I\: entity work.\adc_tech_dac_cal_control_0_pselect_f__parameterized1\
     port map (
      \GEN_BKEND_CE_REGISTERS[2].ce_out_i_reg[2]\(1 downto 0) => \Not_Dual.gpio_Data_Out_reg[0]\(1 downto 0),
      ce_expnd_i_1 => ce_expnd_i_1
    );
\MEM_DECODE_GEN[0].cs_out_i[0]_i_1\: unisim.vcomponents.LUT5
    generic map(
      INIT => X"000000E0"
    )
        port map (
      I0 => \^bus2ip_cs\,
      I1 => Q,
      I2 => s_axi_aresetn,
      I3 => \^ip2bus_rdack_i_d1_reg\,
      I4 => \^ip2bus_wrack_i_d1_reg\,
      O => \MEM_DECODE_GEN[0].cs_out_i[0]_i_1_n_0\
    );
\MEM_DECODE_GEN[0].cs_out_i_reg[0]\: unisim.vcomponents.FDRE
     port map (
      C => s_axi_aclk,
      CE => '1',
      D => \MEM_DECODE_GEN[0].cs_out_i[0]_i_1_n_0\,
      Q => \^bus2ip_cs\,
      R => '0'
    );
\Not_Dual.gpio_Data_Out[0]_i_1\: unisim.vcomponents.LUT5
    generic map(
      INIT => X"00000004"
    )
        port map (
      I0 => \Not_Dual.gpio_Data_Out_reg[0]\(2),
      I1 => \^bus2ip_cs\,
      I2 => \Not_Dual.gpio_Data_Out_reg[0]\(0),
      I3 => bus2ip_rnw,
      I4 => \Not_Dual.gpio_Data_Out_reg[0]\(1),
      O => E(0)
    );
s_axi_arready_INST_0: unisim.vcomponents.LUT6
    generic map(
      INIT => X"AAAAAAAAAAAEAAAA"
    )
        port map (
      I0 => ip2bus_rdack_i_D1,
      I1 => s_axi_arready,
      I2 => s_axi_arready_0(2),
      I3 => s_axi_arready_0(1),
      I4 => s_axi_arready_0(3),
      I5 => s_axi_arready_0(0),
      O => \^ip2bus_rdack_i_d1_reg\
    );
s_axi_wready_INST_0: unisim.vcomponents.LUT6
    generic map(
      INIT => X"AAAAAAAAAAAEAAAA"
    )
        port map (
      I0 => ip2bus_wrack_i_D1,
      I1 => s_axi_wready,
      I2 => s_axi_arready_0(2),
      I3 => s_axi_arready_0(1),
      I4 => s_axi_arready_0(3),
      I5 => s_axi_arready_0(0),
      O => \^ip2bus_wrack_i_d1_reg\
    );
end STRUCTURE;
library IEEE;
use IEEE.STD_LOGIC_1164.ALL;
library UNISIM;
use UNISIM.VCOMPONENTS.ALL;
entity adc_tech_dac_cal_control_0_slave_attachment is
  port (
    SR : out STD_LOGIC_VECTOR ( 0 to 0 );
    \GEN_BKEND_CE_REGISTERS[3].ce_out_i_reg\ : out STD_LOGIC;
    \GEN_BKEND_CE_REGISTERS[2].ce_out_i_reg\ : out STD_LOGIC;
    \GEN_BKEND_CE_REGISTERS[1].ce_out_i_reg\ : out STD_LOGIC;
    \GEN_BKEND_CE_REGISTERS[0].ce_out_i_reg\ : out STD_LOGIC;
    bus2ip_rnw : out STD_LOGIC;
    Bus_RNW_reg : out STD_LOGIC;
    s_axi_rvalid_i_reg_0 : out STD_LOGIC;
    s_axi_bvalid_i_reg_0 : out STD_LOGIC;
    bus2ip_cs : out STD_LOGIC;
    E : out STD_LOGIC_VECTOR ( 0 to 0 );
    ip2bus_rdack_i_D1_reg : out STD_LOGIC;
    ip2bus_wrack_i_D1_reg : out STD_LOGIC;
    s_axi_rdata : out STD_LOGIC_VECTOR ( 31 downto 0 );
    s_axi_aclk : in STD_LOGIC;
    s_axi_arvalid : in STD_LOGIC;
    s_axi_rready : in STD_LOGIC;
    s_axi_bready : in STD_LOGIC;
    s_axi_aresetn : in STD_LOGIC;
    s_axi_awvalid : in STD_LOGIC;
    s_axi_wvalid : in STD_LOGIC;
    Q : in STD_LOGIC_VECTOR ( 31 downto 0 );
    ip2bus_rdack_i_D1 : in STD_LOGIC;
    ip2bus_wrack_i_D1 : in STD_LOGIC;
    s_axi_araddr : in STD_LOGIC_VECTOR ( 2 downto 0 );
    s_axi_awaddr : in STD_LOGIC_VECTOR ( 2 downto 0 )
  );
end adc_tech_dac_cal_control_0_slave_attachment;

architecture STRUCTURE of adc_tech_dac_cal_control_0_slave_attachment is
  signal \FSM_onehot_state[0]_i_1_n_0\ : STD_LOGIC;
  signal \FSM_onehot_state[1]_i_1_n_0\ : STD_LOGIC;
  signal \FSM_onehot_state[2]_i_1_n_0\ : STD_LOGIC;
  signal \FSM_onehot_state[3]_i_1_n_0\ : STD_LOGIC;
  signal \FSM_onehot_state_reg_n_0_[0]\ : STD_LOGIC;
  signal \FSM_onehot_state_reg_n_0_[3]\ : STD_LOGIC;
  signal \INCLUDE_DPHASE_TIMER.dpto_cnt_reg\ : STD_LOGIC_VECTOR ( 3 downto 0 );
  signal \^sr\ : STD_LOGIC_VECTOR ( 0 to 0 );
  signal bus2ip_addr : STD_LOGIC_VECTOR ( 0 to 6 );
  signal \bus2ip_addr_i[8]_i_1_n_0\ : STD_LOGIC;
  signal \^bus2ip_rnw\ : STD_LOGIC;
  signal clear : STD_LOGIC;
  signal \^ip2bus_rdack_i_d1_reg\ : STD_LOGIC;
  signal \^ip2bus_wrack_i_d1_reg\ : STD_LOGIC;
  signal is_read : STD_LOGIC;
  signal is_read_i_1_n_0 : STD_LOGIC;
  signal is_read_reg_n_0 : STD_LOGIC;
  signal is_write : STD_LOGIC;
  signal is_write_reg_n_0 : STD_LOGIC;
  signal p_0_in : STD_LOGIC;
  signal p_0_out : STD_LOGIC_VECTOR ( 1 downto 0 );
  signal p_1_in : STD_LOGIC_VECTOR ( 8 downto 2 );
  signal p_5_in : STD_LOGIC;
  signal plusOp : STD_LOGIC_VECTOR ( 3 downto 0 );
  signal s_axi_bresp_i : STD_LOGIC;
  signal s_axi_bvalid_i_i_1_n_0 : STD_LOGIC;
  signal \^s_axi_bvalid_i_reg_0\ : STD_LOGIC;
  signal s_axi_rresp_i : STD_LOGIC;
  signal s_axi_rvalid_i_i_1_n_0 : STD_LOGIC;
  signal \^s_axi_rvalid_i_reg_0\ : STD_LOGIC;
  signal start2 : STD_LOGIC;
  signal start2_i_1_n_0 : STD_LOGIC;
  signal state : STD_LOGIC_VECTOR ( 1 downto 0 );
  signal \state1__2\ : STD_LOGIC;
  attribute FSM_ENCODED_STATES : string;
  attribute FSM_ENCODED_STATES of \FSM_onehot_state_reg[0]\ : label is "iSTATE:0010,iSTATE0:0100,iSTATE1:1000,iSTATE2:0001";
  attribute FSM_ENCODED_STATES of \FSM_onehot_state_reg[1]\ : label is "iSTATE:0010,iSTATE0:0100,iSTATE1:1000,iSTATE2:0001";
  attribute FSM_ENCODED_STATES of \FSM_onehot_state_reg[2]\ : label is "iSTATE:0010,iSTATE0:0100,iSTATE1:1000,iSTATE2:0001";
  attribute FSM_ENCODED_STATES of \FSM_onehot_state_reg[3]\ : label is "iSTATE:0010,iSTATE0:0100,iSTATE1:1000,iSTATE2:0001";
  attribute SOFT_HLUTNM : string;
  attribute SOFT_HLUTNM of \INCLUDE_DPHASE_TIMER.dpto_cnt[0]_i_1\ : label is "soft_lutpair5";
  attribute SOFT_HLUTNM of \INCLUDE_DPHASE_TIMER.dpto_cnt[1]_i_1\ : label is "soft_lutpair5";
  attribute SOFT_HLUTNM of \INCLUDE_DPHASE_TIMER.dpto_cnt[2]_i_1\ : label is "soft_lutpair3";
  attribute SOFT_HLUTNM of \INCLUDE_DPHASE_TIMER.dpto_cnt[3]_i_2\ : label is "soft_lutpair3";
  attribute SOFT_HLUTNM of \bus2ip_addr_i[3]_i_1\ : label is "soft_lutpair4";
  attribute SOFT_HLUTNM of \bus2ip_addr_i[8]_i_2\ : label is "soft_lutpair4";
  attribute SOFT_HLUTNM of is_read_i_2 : label is "soft_lutpair2";
  attribute SOFT_HLUTNM of is_write_i_1 : label is "soft_lutpair2";
  attribute SOFT_HLUTNM of start2_i_1 : label is "soft_lutpair1";
  attribute SOFT_HLUTNM of \state[1]_i_2\ : label is "soft_lutpair1";
begin
  SR(0) <= \^sr\(0);
  bus2ip_rnw <= \^bus2ip_rnw\;
  ip2bus_rdack_i_D1_reg <= \^ip2bus_rdack_i_d1_reg\;
  ip2bus_wrack_i_D1_reg <= \^ip2bus_wrack_i_d1_reg\;
  s_axi_bvalid_i_reg_0 <= \^s_axi_bvalid_i_reg_0\;
  s_axi_rvalid_i_reg_0 <= \^s_axi_rvalid_i_reg_0\;
\FSM_onehot_state[0]_i_1\: unisim.vcomponents.LUT6
    generic map(
      INIT => X"FFFF150015001500"
    )
        port map (
      I0 => s_axi_arvalid,
      I1 => s_axi_wvalid,
      I2 => s_axi_awvalid,
      I3 => \FSM_onehot_state_reg_n_0_[0]\,
      I4 => \state1__2\,
      I5 => \FSM_onehot_state_reg_n_0_[3]\,
      O => \FSM_onehot_state[0]_i_1_n_0\
    );
\FSM_onehot_state[1]_i_1\: unisim.vcomponents.LUT4
    generic map(
      INIT => X"8F88"
    )
        port map (
      I0 => s_axi_arvalid,
      I1 => \FSM_onehot_state_reg_n_0_[0]\,
      I2 => \^ip2bus_rdack_i_d1_reg\,
      I3 => s_axi_rresp_i,
      O => \FSM_onehot_state[1]_i_1_n_0\
    );
\FSM_onehot_state[2]_i_1\: unisim.vcomponents.LUT6
    generic map(
      INIT => X"0800FFFF08000800"
    )
        port map (
      I0 => s_axi_wvalid,
      I1 => s_axi_awvalid,
      I2 => s_axi_arvalid,
      I3 => \FSM_onehot_state_reg_n_0_[0]\,
      I4 => \^ip2bus_wrack_i_d1_reg\,
      I5 => s_axi_bresp_i,
      O => \FSM_onehot_state[2]_i_1_n_0\
    );
\FSM_onehot_state[3]_i_1\: unisim.vcomponents.LUT6
    generic map(
      INIT => X"F888F888FFFFF888"
    )
        port map (
      I0 => \^ip2bus_wrack_i_d1_reg\,
      I1 => s_axi_bresp_i,
      I2 => s_axi_rresp_i,
      I3 => \^ip2bus_rdack_i_d1_reg\,
      I4 => \FSM_onehot_state_reg_n_0_[3]\,
      I5 => \state1__2\,
      O => \FSM_onehot_state[3]_i_1_n_0\
    );
\FSM_onehot_state[3]_i_2\: unisim.vcomponents.LUT4
    generic map(
      INIT => X"F888"
    )
        port map (
      I0 => s_axi_bready,
      I1 => \^s_axi_bvalid_i_reg_0\,
      I2 => s_axi_rready,
      I3 => \^s_axi_rvalid_i_reg_0\,
      O => \state1__2\
    );
\FSM_onehot_state_reg[0]\: unisim.vcomponents.FDSE
    generic map(
      INIT => '1'
    )
        port map (
      C => s_axi_aclk,
      CE => '1',
      D => \FSM_onehot_state[0]_i_1_n_0\,
      Q => \FSM_onehot_state_reg_n_0_[0]\,
      S => \^sr\(0)
    );
\FSM_onehot_state_reg[1]\: unisim.vcomponents.FDRE
    generic map(
      INIT => '0'
    )
        port map (
      C => s_axi_aclk,
      CE => '1',
      D => \FSM_onehot_state[1]_i_1_n_0\,
      Q => s_axi_rresp_i,
      R => \^sr\(0)
    );
\FSM_onehot_state_reg[2]\: unisim.vcomponents.FDRE
    generic map(
      INIT => '0'
    )
        port map (
      C => s_axi_aclk,
      CE => '1',
      D => \FSM_onehot_state[2]_i_1_n_0\,
      Q => s_axi_bresp_i,
      R => \^sr\(0)
    );
\FSM_onehot_state_reg[3]\: unisim.vcomponents.FDRE
    generic map(
      INIT => '0'
    )
        port map (
      C => s_axi_aclk,
      CE => '1',
      D => \FSM_onehot_state[3]_i_1_n_0\,
      Q => \FSM_onehot_state_reg_n_0_[3]\,
      R => \^sr\(0)
    );
\INCLUDE_DPHASE_TIMER.dpto_cnt[0]_i_1\: unisim.vcomponents.LUT1
    generic map(
      INIT => X"1"
    )
        port map (
      I0 => \INCLUDE_DPHASE_TIMER.dpto_cnt_reg\(0),
      O => plusOp(0)
    );
\INCLUDE_DPHASE_TIMER.dpto_cnt[1]_i_1\: unisim.vcomponents.LUT2
    generic map(
      INIT => X"6"
    )
        port map (
      I0 => \INCLUDE_DPHASE_TIMER.dpto_cnt_reg\(0),
      I1 => \INCLUDE_DPHASE_TIMER.dpto_cnt_reg\(1),
      O => plusOp(1)
    );
\INCLUDE_DPHASE_TIMER.dpto_cnt[2]_i_1\: unisim.vcomponents.LUT3
    generic map(
      INIT => X"78"
    )
        port map (
      I0 => \INCLUDE_DPHASE_TIMER.dpto_cnt_reg\(0),
      I1 => \INCLUDE_DPHASE_TIMER.dpto_cnt_reg\(1),
      I2 => \INCLUDE_DPHASE_TIMER.dpto_cnt_reg\(2),
      O => plusOp(2)
    );
\INCLUDE_DPHASE_TIMER.dpto_cnt[3]_i_1\: unisim.vcomponents.LUT2
    generic map(
      INIT => X"9"
    )
        port map (
      I0 => state(0),
      I1 => state(1),
      O => clear
    );
\INCLUDE_DPHASE_TIMER.dpto_cnt[3]_i_2\: unisim.vcomponents.LUT4
    generic map(
      INIT => X"7F80"
    )
        port map (
      I0 => \INCLUDE_DPHASE_TIMER.dpto_cnt_reg\(1),
      I1 => \INCLUDE_DPHASE_TIMER.dpto_cnt_reg\(0),
      I2 => \INCLUDE_DPHASE_TIMER.dpto_cnt_reg\(2),
      I3 => \INCLUDE_DPHASE_TIMER.dpto_cnt_reg\(3),
      O => plusOp(3)
    );
\INCLUDE_DPHASE_TIMER.dpto_cnt_reg[0]\: unisim.vcomponents.FDRE
     port map (
      C => s_axi_aclk,
      CE => '1',
      D => plusOp(0),
      Q => \INCLUDE_DPHASE_TIMER.dpto_cnt_reg\(0),
      R => clear
    );
\INCLUDE_DPHASE_TIMER.dpto_cnt_reg[1]\: unisim.vcomponents.FDRE
     port map (
      C => s_axi_aclk,
      CE => '1',
      D => plusOp(1),
      Q => \INCLUDE_DPHASE_TIMER.dpto_cnt_reg\(1),
      R => clear
    );
\INCLUDE_DPHASE_TIMER.dpto_cnt_reg[2]\: unisim.vcomponents.FDRE
     port map (
      C => s_axi_aclk,
      CE => '1',
      D => plusOp(2),
      Q => \INCLUDE_DPHASE_TIMER.dpto_cnt_reg\(2),
      R => clear
    );
\INCLUDE_DPHASE_TIMER.dpto_cnt_reg[3]\: unisim.vcomponents.FDRE
     port map (
      C => s_axi_aclk,
      CE => '1',
      D => plusOp(3),
      Q => \INCLUDE_DPHASE_TIMER.dpto_cnt_reg\(3),
      R => clear
    );
I_DECODER: entity work.adc_tech_dac_cal_control_0_address_decoder
     port map (
      Bus_RNW_reg => Bus_RNW_reg,
      E(0) => E(0),
      \GEN_BKEND_CE_REGISTERS[0].ce_out_i_reg\ => \GEN_BKEND_CE_REGISTERS[0].ce_out_i_reg\,
      \GEN_BKEND_CE_REGISTERS[1].ce_out_i_reg\ => \GEN_BKEND_CE_REGISTERS[1].ce_out_i_reg\,
      \GEN_BKEND_CE_REGISTERS[2].ce_out_i_reg\ => \GEN_BKEND_CE_REGISTERS[2].ce_out_i_reg\,
      \GEN_BKEND_CE_REGISTERS[3].ce_out_i_reg\ => \GEN_BKEND_CE_REGISTERS[3].ce_out_i_reg\,
      \Not_Dual.gpio_Data_Out_reg[0]\(2) => bus2ip_addr(0),
      \Not_Dual.gpio_Data_Out_reg[0]\(1) => bus2ip_addr(5),
      \Not_Dual.gpio_Data_Out_reg[0]\(0) => bus2ip_addr(6),
      Q => start2,
      bus2ip_cs => bus2ip_cs,
      bus2ip_rnw => \^bus2ip_rnw\,
      ip2bus_rdack_i_D1 => ip2bus_rdack_i_D1,
      ip2bus_rdack_i_D1_reg => \^ip2bus_rdack_i_d1_reg\,
      ip2bus_wrack_i_D1 => ip2bus_wrack_i_D1,
      ip2bus_wrack_i_D1_reg => \^ip2bus_wrack_i_d1_reg\,
      s_axi_aclk => s_axi_aclk,
      s_axi_aresetn => s_axi_aresetn,
      s_axi_arready => is_read_reg_n_0,
      s_axi_arready_0(3 downto 0) => \INCLUDE_DPHASE_TIMER.dpto_cnt_reg\(3 downto 0),
      s_axi_wready => is_write_reg_n_0
    );
\bus2ip_addr_i[2]_i_1\: unisim.vcomponents.LUT3
    generic map(
      INIT => X"AC"
    )
        port map (
      I0 => s_axi_araddr(0),
      I1 => s_axi_awaddr(0),
      I2 => s_axi_arvalid,
      O => p_1_in(2)
    );
\bus2ip_addr_i[3]_i_1\: unisim.vcomponents.LUT3
    generic map(
      INIT => X"AC"
    )
        port map (
      I0 => s_axi_araddr(1),
      I1 => s_axi_awaddr(1),
      I2 => s_axi_arvalid,
      O => p_1_in(3)
    );
\bus2ip_addr_i[8]_i_1\: unisim.vcomponents.LUT5
    generic map(
      INIT => X"000000EA"
    )
        port map (
      I0 => s_axi_arvalid,
      I1 => s_axi_awvalid,
      I2 => s_axi_wvalid,
      I3 => state(1),
      I4 => state(0),
      O => \bus2ip_addr_i[8]_i_1_n_0\
    );
\bus2ip_addr_i[8]_i_2\: unisim.vcomponents.LUT3
    generic map(
      INIT => X"AC"
    )
        port map (
      I0 => s_axi_araddr(2),
      I1 => s_axi_awaddr(2),
      I2 => s_axi_arvalid,
      O => p_1_in(8)
    );
\bus2ip_addr_i_reg[2]\: unisim.vcomponents.FDRE
     port map (
      C => s_axi_aclk,
      CE => \bus2ip_addr_i[8]_i_1_n_0\,
      D => p_1_in(2),
      Q => bus2ip_addr(6),
      R => \^sr\(0)
    );
\bus2ip_addr_i_reg[3]\: unisim.vcomponents.FDRE
     port map (
      C => s_axi_aclk,
      CE => \bus2ip_addr_i[8]_i_1_n_0\,
      D => p_1_in(3),
      Q => bus2ip_addr(5),
      R => \^sr\(0)
    );
\bus2ip_addr_i_reg[8]\: unisim.vcomponents.FDRE
     port map (
      C => s_axi_aclk,
      CE => \bus2ip_addr_i[8]_i_1_n_0\,
      D => p_1_in(8),
      Q => bus2ip_addr(0),
      R => \^sr\(0)
    );
bus2ip_rnw_i_reg: unisim.vcomponents.FDRE
     port map (
      C => s_axi_aclk,
      CE => \bus2ip_addr_i[8]_i_1_n_0\,
      D => s_axi_arvalid,
      Q => \^bus2ip_rnw\,
      R => \^sr\(0)
    );
is_read_i_1: unisim.vcomponents.LUT6
    generic map(
      INIT => X"FFEAEAEAAAAAAAAA"
    )
        port map (
      I0 => \FSM_onehot_state_reg_n_0_[0]\,
      I1 => s_axi_bready,
      I2 => \^s_axi_bvalid_i_reg_0\,
      I3 => s_axi_rready,
      I4 => \^s_axi_rvalid_i_reg_0\,
      I5 => \FSM_onehot_state_reg_n_0_[3]\,
      O => is_read_i_1_n_0
    );
is_read_i_2: unisim.vcomponents.LUT2
    generic map(
      INIT => X"8"
    )
        port map (
      I0 => \FSM_onehot_state_reg_n_0_[0]\,
      I1 => s_axi_arvalid,
      O => is_read
    );
is_read_reg: unisim.vcomponents.FDRE
     port map (
      C => s_axi_aclk,
      CE => is_read_i_1_n_0,
      D => is_read,
      Q => is_read_reg_n_0,
      R => \^sr\(0)
    );
is_write_i_1: unisim.vcomponents.LUT4
    generic map(
      INIT => X"2000"
    )
        port map (
      I0 => \FSM_onehot_state_reg_n_0_[0]\,
      I1 => s_axi_arvalid,
      I2 => s_axi_awvalid,
      I3 => s_axi_wvalid,
      O => is_write
    );
is_write_reg: unisim.vcomponents.FDRE
     port map (
      C => s_axi_aclk,
      CE => is_read_i_1_n_0,
      D => is_write,
      Q => is_write_reg_n_0,
      R => \^sr\(0)
    );
rst_i_1: unisim.vcomponents.LUT1
    generic map(
      INIT => X"1"
    )
        port map (
      I0 => s_axi_aresetn,
      O => p_0_in
    );
rst_reg: unisim.vcomponents.FDRE
     port map (
      C => s_axi_aclk,
      CE => '1',
      D => p_0_in,
      Q => \^sr\(0),
      R => '0'
    );
s_axi_bvalid_i_i_1: unisim.vcomponents.LUT5
    generic map(
      INIT => X"08FF0808"
    )
        port map (
      I0 => \^ip2bus_wrack_i_d1_reg\,
      I1 => state(1),
      I2 => state(0),
      I3 => s_axi_bready,
      I4 => \^s_axi_bvalid_i_reg_0\,
      O => s_axi_bvalid_i_i_1_n_0
    );
s_axi_bvalid_i_reg: unisim.vcomponents.FDRE
    generic map(
      INIT => '0'
    )
        port map (
      C => s_axi_aclk,
      CE => '1',
      D => s_axi_bvalid_i_i_1_n_0,
      Q => \^s_axi_bvalid_i_reg_0\,
      R => \^sr\(0)
    );
\s_axi_rdata_i_reg[0]\: unisim.vcomponents.FDRE
    generic map(
      INIT => '0'
    )
        port map (
      C => s_axi_aclk,
      CE => s_axi_rresp_i,
      D => Q(0),
      Q => s_axi_rdata(0),
      R => \^sr\(0)
    );
\s_axi_rdata_i_reg[10]\: unisim.vcomponents.FDRE
    generic map(
      INIT => '0'
    )
        port map (
      C => s_axi_aclk,
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
      I1 => state(0),
      I2 => state(1),
      I3 => s_axi_rready,
      I4 => \^s_axi_rvalid_i_reg_0\,
      O => s_axi_rvalid_i_i_1_n_0
    );
s_axi_rvalid_i_reg: unisim.vcomponents.FDRE
    generic map(
      INIT => '0'
    )
        port map (
      C => s_axi_aclk,
      CE => '1',
      D => s_axi_rvalid_i_i_1_n_0,
      Q => \^s_axi_rvalid_i_reg_0\,
      R => \^sr\(0)
    );
start2_i_1: unisim.vcomponents.LUT5
    generic map(
      INIT => X"000000F8"
    )
        port map (
      I0 => s_axi_awvalid,
      I1 => s_axi_wvalid,
      I2 => s_axi_arvalid,
      I3 => state(1),
      I4 => state(0),
      O => start2_i_1_n_0
    );
start2_reg: unisim.vcomponents.FDRE
     port map (
      C => s_axi_aclk,
      CE => '1',
      D => start2_i_1_n_0,
      Q => start2,
      R => \^sr\(0)
    );
\state[0]_i_1\: unisim.vcomponents.LUT5
    generic map(
      INIT => X"77FC44FC"
    )
        port map (
      I0 => \state1__2\,
      I1 => state(0),
      I2 => s_axi_arvalid,
      I3 => state(1),
      I4 => \^ip2bus_wrack_i_d1_reg\,
      O => p_0_out(0)
    );
\state[1]_i_1\: unisim.vcomponents.LUT6
    generic map(
      INIT => X"55FFFF0C5500FF0C"
    )
        port map (
      I0 => \state1__2\,
      I1 => p_5_in,
      I2 => s_axi_arvalid,
      I3 => state(1),
      I4 => state(0),
      I5 => \^ip2bus_rdack_i_d1_reg\,
      O => p_0_out(1)
    );
\state[1]_i_2\: unisim.vcomponents.LUT2
    generic map(
      INIT => X"8"
    )
        port map (
      I0 => s_axi_awvalid,
      I1 => s_axi_wvalid,
      O => p_5_in
    );
\state_reg[0]\: unisim.vcomponents.FDRE
     port map (
      C => s_axi_aclk,
      CE => '1',
      D => p_0_out(0),
      Q => state(0),
      R => \^sr\(0)
    );
\state_reg[1]\: unisim.vcomponents.FDRE
     port map (
      C => s_axi_aclk,
      CE => '1',
      D => p_0_out(1),
      Q => state(1),
      R => \^sr\(0)
    );
end STRUCTURE;
library IEEE;
use IEEE.STD_LOGIC_1164.ALL;
library UNISIM;
use UNISIM.VCOMPONENTS.ALL;
entity adc_tech_dac_cal_control_0_axi_lite_ipif is
  port (
    bus2ip_reset : out STD_LOGIC;
    \GEN_BKEND_CE_REGISTERS[3].ce_out_i_reg\ : out STD_LOGIC;
    \GEN_BKEND_CE_REGISTERS[2].ce_out_i_reg\ : out STD_LOGIC;
    \GEN_BKEND_CE_REGISTERS[1].ce_out_i_reg\ : out STD_LOGIC;
    \GEN_BKEND_CE_REGISTERS[0].ce_out_i_reg\ : out STD_LOGIC;
    bus2ip_rnw : out STD_LOGIC;
    Bus_RNW_reg : out STD_LOGIC;
    s_axi_rvalid_i_reg : out STD_LOGIC;
    s_axi_bvalid_i_reg : out STD_LOGIC;
    bus2ip_cs : out STD_LOGIC;
    E : out STD_LOGIC_VECTOR ( 0 to 0 );
    ip2bus_rdack_i_D1_reg : out STD_LOGIC;
    ip2bus_wrack_i_D1_reg : out STD_LOGIC;
    s_axi_rdata : out STD_LOGIC_VECTOR ( 31 downto 0 );
    s_axi_aclk : in STD_LOGIC;
    s_axi_arvalid : in STD_LOGIC;
    s_axi_rready : in STD_LOGIC;
    s_axi_bready : in STD_LOGIC;
    s_axi_aresetn : in STD_LOGIC;
    s_axi_awvalid : in STD_LOGIC;
    s_axi_wvalid : in STD_LOGIC;
    Q : in STD_LOGIC_VECTOR ( 31 downto 0 );
    ip2bus_rdack_i_D1 : in STD_LOGIC;
    ip2bus_wrack_i_D1 : in STD_LOGIC;
    s_axi_araddr : in STD_LOGIC_VECTOR ( 2 downto 0 );
    s_axi_awaddr : in STD_LOGIC_VECTOR ( 2 downto 0 )
  );
end adc_tech_dac_cal_control_0_axi_lite_ipif;

architecture STRUCTURE of adc_tech_dac_cal_control_0_axi_lite_ipif is
begin
I_SLAVE_ATTACHMENT: entity work.adc_tech_dac_cal_control_0_slave_attachment
     port map (
      Bus_RNW_reg => Bus_RNW_reg,
      E(0) => E(0),
      \GEN_BKEND_CE_REGISTERS[0].ce_out_i_reg\ => \GEN_BKEND_CE_REGISTERS[0].ce_out_i_reg\,
      \GEN_BKEND_CE_REGISTERS[1].ce_out_i_reg\ => \GEN_BKEND_CE_REGISTERS[1].ce_out_i_reg\,
      \GEN_BKEND_CE_REGISTERS[2].ce_out_i_reg\ => \GEN_BKEND_CE_REGISTERS[2].ce_out_i_reg\,
      \GEN_BKEND_CE_REGISTERS[3].ce_out_i_reg\ => \GEN_BKEND_CE_REGISTERS[3].ce_out_i_reg\,
      Q(31 downto 0) => Q(31 downto 0),
      SR(0) => bus2ip_reset,
      bus2ip_cs => bus2ip_cs,
      bus2ip_rnw => bus2ip_rnw,
      ip2bus_rdack_i_D1 => ip2bus_rdack_i_D1,
      ip2bus_rdack_i_D1_reg => ip2bus_rdack_i_D1_reg,
      ip2bus_wrack_i_D1 => ip2bus_wrack_i_D1,
      ip2bus_wrack_i_D1_reg => ip2bus_wrack_i_D1_reg,
      s_axi_aclk => s_axi_aclk,
      s_axi_araddr(2 downto 0) => s_axi_araddr(2 downto 0),
      s_axi_aresetn => s_axi_aresetn,
      s_axi_arvalid => s_axi_arvalid,
      s_axi_awaddr(2 downto 0) => s_axi_awaddr(2 downto 0),
      s_axi_awvalid => s_axi_awvalid,
      s_axi_bready => s_axi_bready,
      s_axi_bvalid_i_reg_0 => s_axi_bvalid_i_reg,
      s_axi_rdata(31 downto 0) => s_axi_rdata(31 downto 0),
      s_axi_rready => s_axi_rready,
      s_axi_rvalid_i_reg_0 => s_axi_rvalid_i_reg,
      s_axi_wvalid => s_axi_wvalid
    );
end STRUCTURE;
library IEEE;
use IEEE.STD_LOGIC_1164.ALL;
library UNISIM;
use UNISIM.VCOMPONENTS.ALL;
entity adc_tech_dac_cal_control_0_axi_gpio is
  port (
    s_axi_aclk : in STD_LOGIC;
    s_axi_aresetn : in STD_LOGIC;
    s_axi_awaddr : in STD_LOGIC_VECTOR ( 8 downto 0 );
    s_axi_awvalid : in STD_LOGIC;
    s_axi_awready : out STD_LOGIC;
    s_axi_wdata : in STD_LOGIC_VECTOR ( 31 downto 0 );
    s_axi_wstrb : in STD_LOGIC_VECTOR ( 3 downto 0 );
    s_axi_wvalid : in STD_LOGIC;
    s_axi_wready : out STD_LOGIC;
    s_axi_bresp : out STD_LOGIC_VECTOR ( 1 downto 0 );
    s_axi_bvalid : out STD_LOGIC;
    s_axi_bready : in STD_LOGIC;
    s_axi_araddr : in STD_LOGIC_VECTOR ( 8 downto 0 );
    s_axi_arvalid : in STD_LOGIC;
    s_axi_arready : out STD_LOGIC;
    s_axi_rdata : out STD_LOGIC_VECTOR ( 31 downto 0 );
    s_axi_rresp : out STD_LOGIC_VECTOR ( 1 downto 0 );
    s_axi_rvalid : out STD_LOGIC;
    s_axi_rready : in STD_LOGIC;
    ip2intc_irpt : out STD_LOGIC;
    gpio_io_i : in STD_LOGIC_VECTOR ( 31 downto 0 );
    gpio_io_o : out STD_LOGIC_VECTOR ( 31 downto 0 );
    gpio_io_t : out STD_LOGIC_VECTOR ( 31 downto 0 );
    gpio2_io_i : in STD_LOGIC_VECTOR ( 31 downto 0 );
    gpio2_io_o : out STD_LOGIC_VECTOR ( 31 downto 0 );
    gpio2_io_t : out STD_LOGIC_VECTOR ( 31 downto 0 )
  );
  attribute C_ALL_INPUTS : integer;
  attribute C_ALL_INPUTS of adc_tech_dac_cal_control_0_axi_gpio : entity is 0;
  attribute C_ALL_INPUTS_2 : integer;
  attribute C_ALL_INPUTS_2 of adc_tech_dac_cal_control_0_axi_gpio : entity is 0;
  attribute C_ALL_OUTPUTS : integer;
  attribute C_ALL_OUTPUTS of adc_tech_dac_cal_control_0_axi_gpio : entity is 1;
  attribute C_ALL_OUTPUTS_2 : integer;
  attribute C_ALL_OUTPUTS_2 of adc_tech_dac_cal_control_0_axi_gpio : entity is 0;
  attribute C_DOUT_DEFAULT : integer;
  attribute C_DOUT_DEFAULT of adc_tech_dac_cal_control_0_axi_gpio : entity is 0;
  attribute C_DOUT_DEFAULT_2 : integer;
  attribute C_DOUT_DEFAULT_2 of adc_tech_dac_cal_control_0_axi_gpio : entity is 0;
  attribute C_FAMILY : string;
  attribute C_FAMILY of adc_tech_dac_cal_control_0_axi_gpio : entity is "zynquplus";
  attribute C_GPIO2_WIDTH : integer;
  attribute C_GPIO2_WIDTH of adc_tech_dac_cal_control_0_axi_gpio : entity is 32;
  attribute C_GPIO_WIDTH : integer;
  attribute C_GPIO_WIDTH of adc_tech_dac_cal_control_0_axi_gpio : entity is 32;
  attribute C_INTERRUPT_PRESENT : integer;
  attribute C_INTERRUPT_PRESENT of adc_tech_dac_cal_control_0_axi_gpio : entity is 0;
  attribute C_IS_DUAL : integer;
  attribute C_IS_DUAL of adc_tech_dac_cal_control_0_axi_gpio : entity is 0;
  attribute C_S_AXI_ADDR_WIDTH : integer;
  attribute C_S_AXI_ADDR_WIDTH of adc_tech_dac_cal_control_0_axi_gpio : entity is 9;
  attribute C_S_AXI_DATA_WIDTH : integer;
  attribute C_S_AXI_DATA_WIDTH of adc_tech_dac_cal_control_0_axi_gpio : entity is 32;
  attribute C_TRI_DEFAULT : integer;
  attribute C_TRI_DEFAULT of adc_tech_dac_cal_control_0_axi_gpio : entity is -1;
  attribute C_TRI_DEFAULT_2 : integer;
  attribute C_TRI_DEFAULT_2 of adc_tech_dac_cal_control_0_axi_gpio : entity is -1;
  attribute downgradeipidentifiedwarnings : string;
  attribute downgradeipidentifiedwarnings of adc_tech_dac_cal_control_0_axi_gpio : entity is "yes";
  attribute ip_group : string;
  attribute ip_group of adc_tech_dac_cal_control_0_axi_gpio : entity is "LOGICORE";
end adc_tech_dac_cal_control_0_axi_gpio;
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
