AdriaanSadie/MVT_ADC_TECH/(commit log)

2024-12-05 Can toggle LEDs on expander card with tcl commands. Added I2C core - have to modify for the AD5669
2024-12-05 Changed io pins so leds goes to J1 on expander
2024-12-10 Some small changes. Have to finish i2c block
2024-12-10 I2C driver working in simulation. Have to test with scope now
2024-12-10 small change to i2c.vhd looks like it should work now. Tested on scope
2024-12-14 Have to debug i2c comms to DACs
2024-12-17 Figured out i2c protocol is wrong. Have to update driver
    [Pin_planning.xlsx]
2024-12-19 Works now. My custom i2c driver works
    [Pin_planning.xlsx]
2025-10-02 Got the BRAM working. Managed to get data from bit 0 over full voltage range 0.1 - 1.7. Data looks very good. Have to test falling edge now
    [Pin_planning.xlsx]
2025-10-21 DAC I2C did NOT work previously. NOW it does. Reliably and for all channels. Have to finally start calibration
    [adc_tech_auto_pc_1_sim_netlist.v, adc_tech_auto_pc_1_sim_netlist.vhdl, adc_tech_auto_pc_2_sim_netlist.v, adc_tech_auto_pc_2_sim_netlist.vhdl, adc_tech_auto_pc_3_sim_netlist.v, adc_tech_auto_pc_3_sim_netlist.vhdl, adc_tech_axi_bram_ctrl_0_0_sim_netlist.v]
2025-10-22 Added ADC acquisition firmware blocks. To be tested. Simulation looks fine
2025-10-23 My ADC Acquisition core works now. Might have to add some debouncing somehow, but the principle is shown well
2025-10-24 Project basically done. Have to write up. Also included all other project files in repo now
    [MVT_Budget.xlsx, Pin_planning.xlsx, dac_calculations.xlsx, dac_calibration_measurements.xlsx, dac_calibration_official.xlsx, tek0001.csv]
2025-10-27 Final measurements added. Have to write final report now
    [tek0002.csv]
